AshitakaLax/SmartHome/Website/SmartHome/design.html

Documents Team info Course Website (http://www.eng.utah.edu/~cs4710)

- Home
- Meetings
- Design
- Contact

# Last Updated:

11/7/2012, 5:50pm

# Shortcuts

- Design
- Project Proposal
- Project Presentations
- Project Sections
- Schematics
- Board Layouts
- Bill of Materials

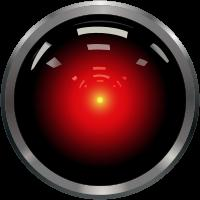
[picture p5: Website/SmartHome/images/Hal.JPG]
Hal Smart Home Name
 Hal the name of the Home computer. To get the Smart Home's attention you say "Hal."

# Design

The Smart Home Project is designed to provide automation to outlets, temperature, sprinklers and garage. As well as monitoring outlet power consumption, temperature, and room occupancy. These controls are to be accessable from a secure website, a secure mobile website, texting, or from voice recognition within the home. The implemenation of these features will provide greater home energy efficency and greater comfort.

Here is a PDF with everything(Schematics, layouts and BOM). Everything

# Project Proposal

Note: The current Project Proposal was created with only a portion of the above features in mind.

- Project Description
- Preliminary Project Proposal
- Final Project Proposal
- Final Project Document

# Project Presentations

- Initial Presentation
- Preliminary Presentation
- Final Project Proposal

# Project Sections

- Wi-Fi & Sprinkler System Design

# Schematics

- Schematics 28-Aug-2012

# Board Layout

- Layouts

# Bill of Materials

- All Boards by Value
- All Boards by Design Reference

Template design by Six Shooter Media (http://www.sixshootermedia.com)
Thank you for provide great resources to others
