AshitakaLax/SmartHome/Website/SmartHome/WifiDesign/Wifidesign.html

Documents Team info Course Website (http://www.eng.utah.edu/~cs4710)

- Home
- Meetings
- Design
- Contact

Wi-Fi Communication Design Details

# Last Updated:

11/04/2012, 10:48pm

# Shortcuts

- Design
- Project Proposal
- Project Presentations
- Schematics
- Board Layouts
- Bill of Materials

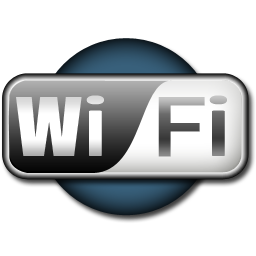
[picture p6: Website/SmartHome/images/wifi.png]
Hal Smart Home Name
 Wi-Fi communication between diferent portions of the project is described in more detail here. Main purpose is to meke possible communication between sensors and outlets/lights possible witout running a wire.

# Design

The Smart Home Project is designed to provide automation to outlets, temperature, sprinklers and garage. As well as monitoring outlet power consumption, temperature, and room occupancy. These controls are to be accessable from a secure website, a secure mobile website, texting, or from voice recognition within the home. The implemenation of these features will provide greater home energy efficency and greater comfort.

Main aspects of controling different automations throughout the house will be done via Wi-Fi. A authorized user will be able to remotely connect to a web page that is hosting all of the information about the house. The user will be able to request some information about specific room and have that information displayed on the webpage. It will also be possible to have a specific command issued to the server which will over Wi-Fi communication send the necessary instructions to controle some part of the house, that being opening the garage doors or turning on the lights. This feature limits the number of wires that have to be run throught the house and enables a centralized unit to store all of this information in one place.

Here is a PDF with everything(Schematics, layouts and BOM) for the Wi-Fi including Automated Sprinkler System. Everything

# Project Proposal

Note: The current Project Proposal was created with only a portion of the above features in mind.

- Project Description
- Preliminary Project Proposal
- Final Project Proposal

# Project Presentations

- Initial Presentation
- Preliminary Presentation
- Final Project Proposal

# Schematics

- Schematics 28-Aug-2012

# Board Layout

- Layouts

# Bill of Materials

- Wi-Fi & Sprikler System

Template design by Six Shooter Media (http://www.sixshootermedia.com)
Thank you for provide great resources to others
