AshitakaLax/SmartHome/EpicCube/hardware/Epic Cube Design/OldControllerBoxInfo/MotorController3.PcbDoc.htm

Altium Reporting Options

# File in Previous Format

Date | : | 5/30/2012
Time | : | 9:07:47 PM
Filename | : | X:\public_html\SmartHome\documents\Controller box\MotorController3.PcbDoc

Version | Warning

This file was generated by an earlier version of the software
