AshitakaLax/SmartHome/EpicCube/hardware/Epic Cube Design/TemplateAndImages/The_University_of_Utah_Th_461a8826e43fc.gif

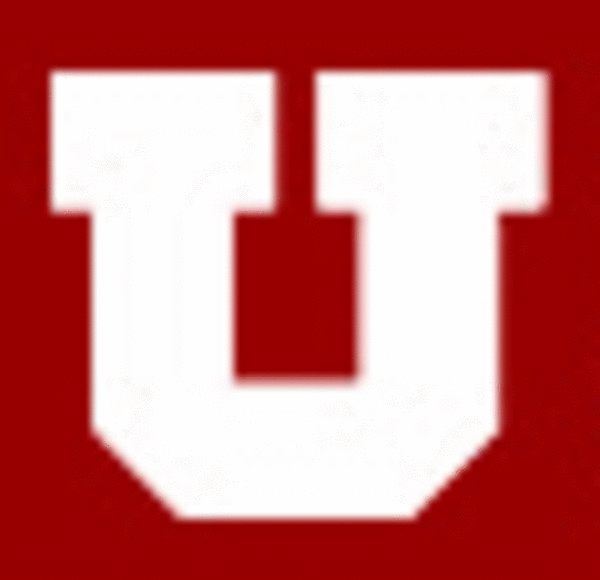
EpicCube/hardware/Epic Cube Design/TemplateAndImages/The_University_of_Utah_Th_461a8826e43fc.gif
