AshitakaLax/SmartHome/Powerstrip/powerstrip.bmp

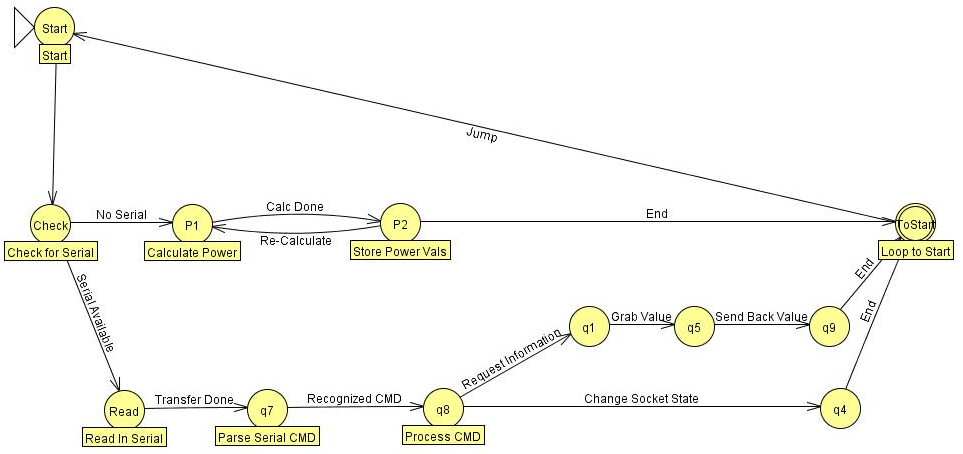
Powerstrip/powerstrip.bmp
