AshitakaLax/SmartHome/Website/SmartHome/images/Hal.png

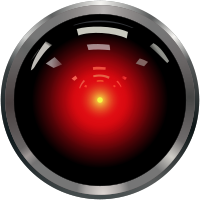
Website/SmartHome/images/Hal.png
