AshitakaLax/SmartHome/Website/SmartHome/images/onlineBio.jpg

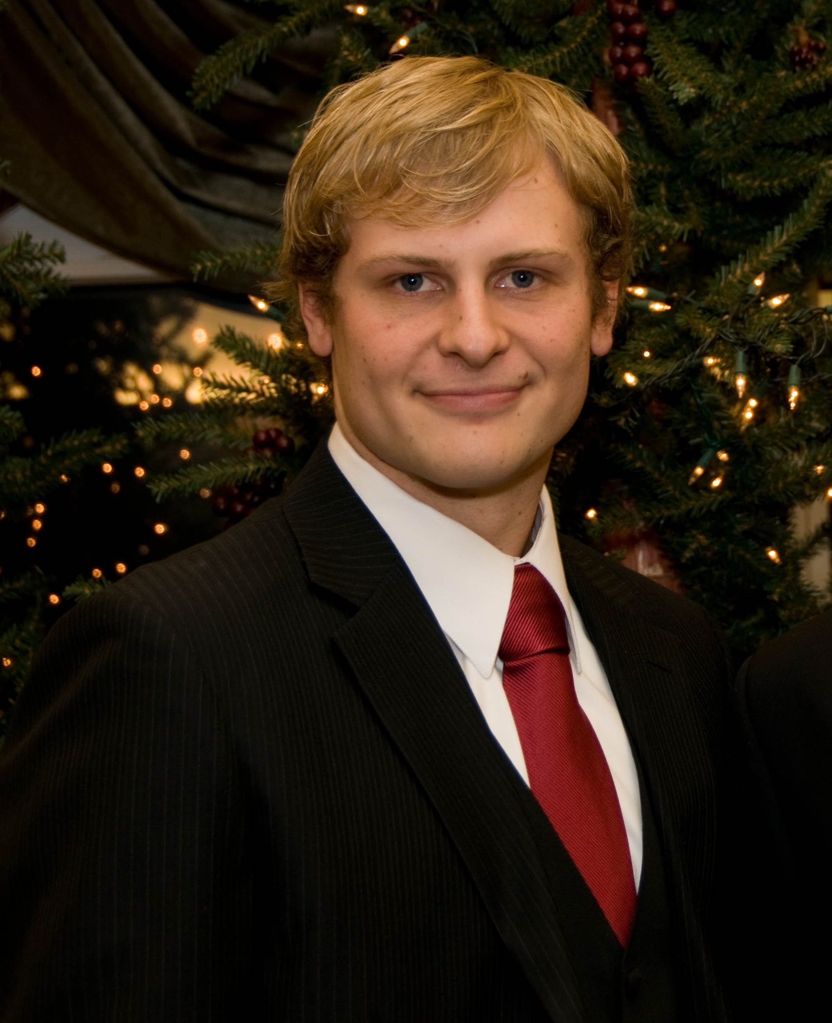
Website/SmartHome/images/onlineBio.jpg
