AshitakaLax/SmartHome/Website/SmartHome/documents/BOM/DesignBOM.PDF

Bill of Materials | Main Controller
Source Data From: | MainController.SchDoc
Project: | | PrintingProjectAllDocs.PrjPCB
Organization: | U of U Computer Engineering
Creation Date: 8/28/2012 | 1:56:56 PM
Print Date: | 28-Aug-12 | 1:57:05 PM
Footprint | Comment | LibRef | Designator | Description | Vendor | Quantity | Price | total Price
| | | C7, C8, C9 | | | 9 | 0.03 | $0.27
| | | D1, D2, D3, D4, D5, D6, D7 | | | 7 | 0.01 | $0.07
| | | | | | 5 | 0.48 | $2.40
| | | | | | 1 | 0.04 | $0.04
| | | P17, P18, P19 | | | 8 | 0.05 | $0.40
| | | | | | 3 | 0.02 | $0.06
| | | | | | 1 | 0.06 | $0.06
| | | | | | 1 | 0.07 | $0.07
| | | | | | 1 | 0.00 | $0.00
| | | | | | 1 | 0.06 | $0.06
| | | | | | 1 | 0.03 | $0.03
| | | | | | 2 | 0.09 | $0.18
| | | | | | 5 | 0.01 | $0.05
| | | | | | 5 | 0.01 | $0.05
| | | | | | 3 | 0.18 | $0.54
RAD-0.3 | Cap | Cap | C1, C2, C3, C4, C5, C6, | Capacitor | Taydaelectr
| | | | | onics
DO-41 | 1N4001 | 1N4001, Diode
| | 1N4001 | | 1.0 Ampere General Purpose
| | | | Rectifier, 1 Amp General
| | | | Purpose Rectifier | Taydaelectr
| | | | | onics
DSUB1.385- 2H9 | D Connector 9 | D Connector 9 | J1, J2, J3, J4, J5 | Receptacle Assembly, 9
| | | | Position, Right Angle | Taydaelectr
| | | | | onics
MainPowerC onnector | Header 4 | Header 4 | P1 | Header, 4-Pin | Taydaelectr
| | | | | onics
HDR1X5 | Header 5 | Header 5 | P2, P5, P8, P14, P16, | Header, 5-Pin | Taydaelectr
| | | | | onics
HDR1X2 | Header 2 | Header 2 | P3, P9, P12 | Header, 2-Pin | Taydaelectr
| | | | | onics
HDR1X6 | Header 6 | Header 6 | P4 | Header, 6-Pin | Taydaelectr
| | | | | onics
HDR1X7 | Header 7 | Header 7 | P6 | Header, 7-Pin | Taydaelectr
| | | | | onics
PIN1 | Spare | Plug | P7 | Plug | Taydaelectr
| | | | | onics
HDR1X6 | Garage_HVAC | Header 6 | P10 | Header, 6-Pin | Taydaelectr
| | | | | onics
HDR1X3 | Header 3 | Header 3 | P11 | Header, 3-Pin | Taydaelectr
| | | | | onics
HDR1X9 | TempSenseBoar
| d1 | Header 9 | P13, P15 | Header, 9-Pin | Taydaelectr
| | | | | onics
2N3904 | 2N3904 | 2N3904 | Q1, Q2, Q3, Q4, Q5 | NPN General Purpose
| | | | Amplifier | Taydaelectr
| | | | | onics
AXIAL-0.3 | Res1 | Res1 | R1, R2, R3, R4, R5 | Resistor | Taydaelectr
| | | | | onics
N014 | SN7416N | SN7416N | U1, U2, U5 | Hex Inverter Buffer / Driver
| | | | with High-Voltage Outputs | Taydaelectr
| | | | | onics
NT024D | SN74HC154NT | SN74HC154NT | U3 | 4-Line to 16-Line Decoder /
| | | | Demultiplexer
Digi-Key | 1 | 3.70 | $3.70
Teensy2.0++ | Teensy2.0++ | Teensy2.0++ | U4 | The teensy 2.0 from
| | | | www.PJRC.com | Taydaelectr
| | | | | onics
1 | 24.0 | $24.00
1 | 0.24 | $0.24
1 | 0.24 | $0.24
Approved Notes | 57 | | $32.46

ISOWATT220
AB
L7812CP | L7805CP | VR1 | Positive Voltage Regulator | Taydaelectr onics

ISOWATT220
AB
L7805CP | L7805CP | VR2 | Positive Voltage Regulator | Taydaelectr onics

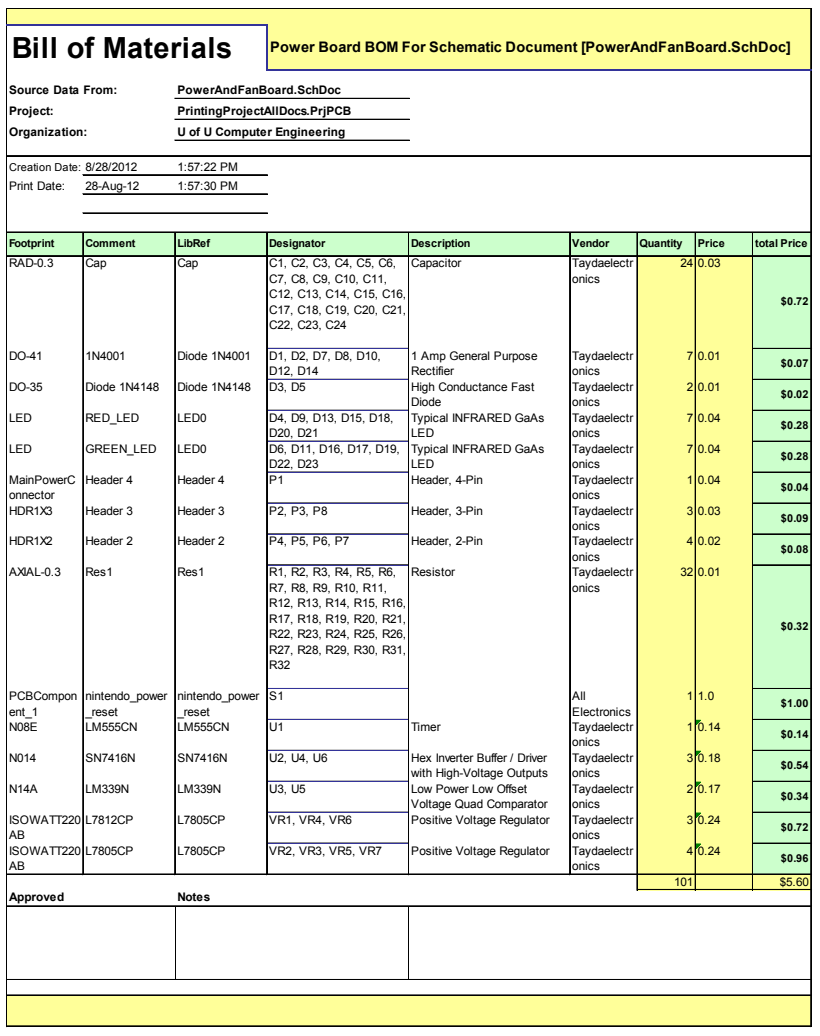
[picture p93: page 2]

Footprint | Comment | LibRef | Designator | Description | Vendor | Quantity | Price | total Price

with High-Voltage Outputs

Approved Notes | | | | | | 101 | | $5.60

Bill of Materials | HVAC & Garage Control
Source Data From: | HeatingAC_Garage.SchDoc
Project: | | PrintingProjectAllDocs.PrjPCB
Organization: | U of U Computer Engineering
Creation Date: 8/28/2012 | 1:57:51 PM
Print Date: | 28-Aug-12 | 1:58:01 PM
Footprint | Comment | LibRef | Designator | Description | Vendor | Quantity | Price | total Price
| | | | | | 2 | 0.03 | $0.06
| | | | | | 4 | 0.04 | $0.16
| | | D11 | | | 7 | 0.01 | $0.07
| | | | | | 1 | 0.48 | $0.48
| | | K7 | | | 7 | 0.64 | $4.48
| | | | | | 1 | 0.02 | $0.02
| | | | | | 1 | 0.03 | $0.03
| | | | | | 1 | 0.07 | $0.07
| | | Q7 | | | 7 | 0.01 | $0.07
| | | R7, R8, R9, R10, R11, R12, R13, R14, R15, R16, R17, R18, R19, R20, R21, R22, R23 | | | 23 | 0.01 | $0.23
| | | | | | 3 | 0.3 | $0.90
| | | | | | 1 | 0.18 | $0.18
Approved Notes | | | | | | 58 | | $6.75
RAD-0.3 | Cap | Cap | C1, C2 | Capacitor | Taydaelectr
| | | | | onics
LED-0 | LED_White | LED0 | D1, D2, D3, D4 | Typical INFRARED GaAs
| | | | LED | Taydaelectr
| | | | | onics
DO-41 | 1N4001 | 1N4001 | D5, D6, D7, D8, D9, D10, | 1.0 Ampere General Purpose
| | | | Rectifier | Taydaelectr
| | | | | onics
DSUB1.385- 2H9 | D Connector 9 | D Connector 9 | J1 | Receptacle Assembly, 9
| | | | Position, Right Angle | Taydaelectr
| | | | | onics
Relay SPDT | SPDT | SPDT | K1, K2, K3, K4, K5, K6, | | Taydaelectr
| | | | | onics
HDR1X2 | Header 2 | Header 2 | P1 | Header, 2-Pin | Taydaelectr
| | | | | onics
HDR1X3 | Header 3 | Header 3 | P2 | Header, 3-Pin | Taydaelectr
| | | | | onics
HDR1X7 | Header 7 | Header 7 | P3 | Header, 7-Pin | Taydaelectr
| | | | | onics
2N3904 | 2N3904 | 2N3904 | Q1, Q2, Q3, Q4, Q5, Q6, | NPN General Purpose
| | | | Amplifier | Taydaelectr
| | | | | onics
AXIAL-0.3 | Res1 | Res1 | R1, R2, R3, R4, R5, R6, | Resistor | Taydaelectr
| | | | | onics
DIP4 | OptoCoupler | OptoCoupler | U1, U3, U4 | Taydaelectr
| | | | onics
N014 | SN7416N | SN7416N | U2 | Hex Inverter Buffer / Driver
| | | | with High-Voltage Outputs Taydaelectr
| | | | onics

Bill of Materials | Bi-Polar Motor driver BOM For Schematic Document [MotorController.SchDoc]
Source Data From: | MotorController.SchDoc
Project: | | PrintingProjectAllDocs.PrjPCB
Organization: | U of U Computer Engineering
Creation Date: 8/28/2012 | 1:58:31 PM
Print Date: | 28-Aug-12 | 1:58:42 PM
Footprint | Comment | LibRef | Designator | Description | Vendor | Quantity | Price | total Price
| | | | | | 2 | 0.03 | $0.06
| | | D7, D8 | | | 8 | 0.03 | $0.24
| | | | | | 1 | 0.04 | $0.04
| | | | | | 1 | 0.01 | $0.01
| | | | | | 1 | 0.06 | $0.06
| | | | | | 1 | 0.04 | $0.04
| | | Q7, Q8, Q9, Q10 | | | 10 | 0.01 | $0.10
| | | R7, R8, R9, R10, R11, R12, R13, R14, R15, R16, R17, R18, R19, R20, R21, R22 | | | 22 | 0.01 | $0.22
| | | | | | 4 | 0.35 | $1.40
| | | | | | 4 | 0.26 | $1.04
| | | | | | 1 | 0.14 | $0.14
RAD-0.3 | Cap | Cap | C1, C2 | Capacitor | Taydaelectr
| | | | | onics
DO-201AD | Diode 1N5408 | Diode 1N5408 | D1, D2, D3, D4, D5, D6, | 3 Amp Medium Power Silicon
| | | | Rectifier Diode | Taydaelectr
| | | | | onics
LED-0 | LED0 | LED0 | D9 | Typical INFRARED GaAs
| | | | LED | Taydaelectr
| | | | | onics
DO-35 | Diode 1N4148 | Diode 1N4148 | D10 | High Conductance Fast
| | | | Diode | Taydaelectr
| | | | | onics
HDR1X6 | Header 6 | Header 6 | P1 | Header, 6-Pin | Taydaelectr
| | | | | onics
HDR1X4 | Header 4 | Header 4 | P2 | Header, 4-Pin | Taydaelectr
| | | | | onics
2N3904 | 2N3904 | 2N3904 | Q1, Q2, Q3, Q4, Q5, Q6, | NPN General Purpose
| | | | Amplifier | Taydaelectr
| | | | | onics
AXIAL-0.3 | Res1 | Res1 | R1, R2, R3, R4, R5, R6, | Resistor | Taydaelectr
| | | | | onics
TO-220 | TIP126 | TIP126 | U1, U2, U3, U4 | TIP126 -PNP | Taydaelectr
| | | | | onics
TO-220 | TIP120 | TIP120 | U5, U6, U7, U8 | NPN 60V -5A TO-220 | Taydaelectr
| | | | | onics
N08E | LM555CN | LM555CN | U9 | Timer | Taydaelectr
| | | | | onics
648-06 | MC74HC194N | MC74HC194N | U10 | 4-Bit Bidirectional Universal
| | | | Shift Register | Digi-Key | 1 | 0.68 | $0.68
NE016 | SN754410NE | SN754410NE | U11 | Quadruple Half-H Driver | U of U | 1 | 0.00 | $0.00
| | | | | | 57 | | $4.03
Approved | | Notes

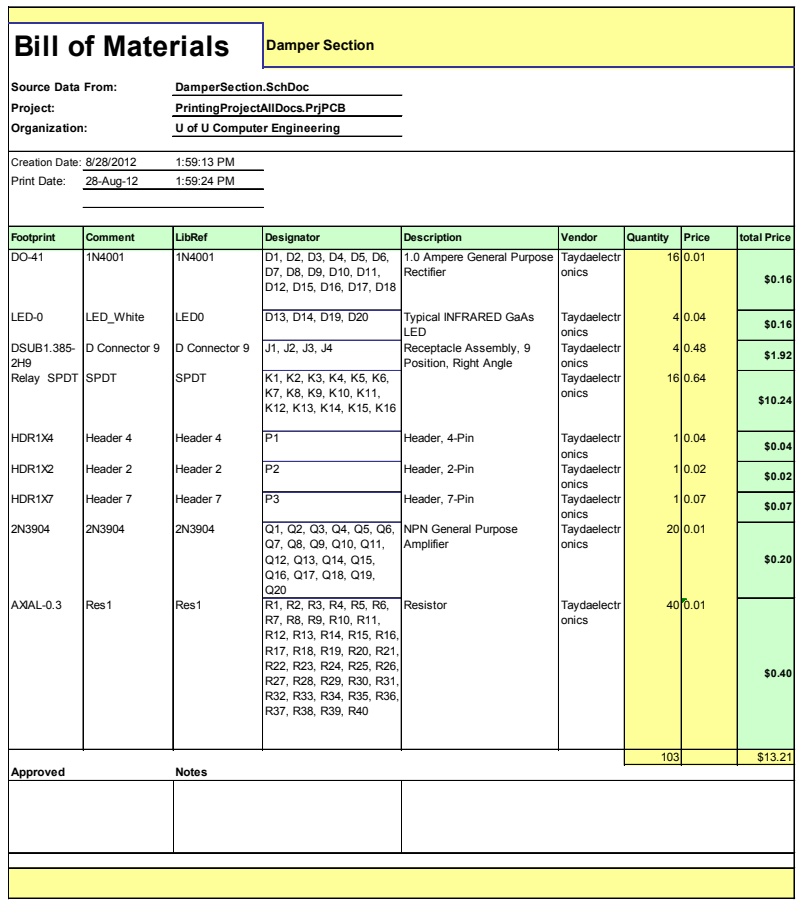
[picture p94: page 5]

Footprint | Comment | LibRef | Designator | Description | Vendor | Quantity | Price | total Price

Approved Notes | | | | | | 103 | | $13.21

Bill of Materials | Sprinkler Control BOM For Schematic Document [SprinklerBoard.SchDoc]
Source Data From: | SprinklerBoard.SchDoc
Project: | | PrintingProjectAllDocs.PrjPCB
Organization: | U of U Computer Engineering
Creation Date: 8/28/2012 | 2:00:07 PM
Print Date: | 28-Aug-12 | 2:00:17 PM
Footprint | Comment | LibRef | Designator | Description | Vendor | Quantity | Price | total Price
| | | | | | 6 | 0.01 | $0.06
| | | D12 | | | 6 | 0.04 | $0.24
| | | | | | 1 | 0.48 | $0.48
| | | | | | 6 | 0.64 | $3.84
| | | | | | 1 | 0.07 | $0.07
| | | | | | 6 | 0.01 | $0.06
| | | R7, R8, R9, R10, R11, R12, R13, R14 | | | 14 | 0.01 | $0.14
| | | | | | 1 | 0.18 | $0.18
| | | | | | 1 | 0.25 | $0.25
Approved Notes | | | | | | 42 | | $5.32
DO-41 | 1N4001 | 1N4001 | D1, D2, D3, D4, D5, D6 | 1.0 Ampere General Purpose
| | | | Rectifier | Taydaelectr
| | | | | onics
LED-0 | LED_White | LED0 | D7, D8, D9, D10, D11, | Typical INFRARED GaAs
| | | | LED | Taydaelectr
| | | | | onics
DSUB1.385- 2H9 | D Connector 9 | D Connector 9 | J1 | Receptacle Assembly, 9
| | | | Position, Right Angle | Taydaelectr
| | | | | onics
Relay SPDT | SPDT | SPDT | K1, K2, K3, K4, K5, K6 | | Taydaelectr
| | | | | onics
HDR1X7 | Header 7 | Header 7 | P1 | Header, 7-Pin | Taydaelectr
| | | | | onics
2N3904 | 2N3904 | 2N3904 | Q1, Q2, Q3, Q4, Q5, Q6 | NPN General Purpose
| | | | Amplifier | Taydaelectr
| | | | | onics
AXIAL-0.3 | Res1 | Res1 | R1, R2, R3, R4, R5, R6, | Resistor | Taydaelectr
| | | | | onics
N014 | SN7416N | SN7416N | U1 | Hex Inverter Buffer / Driver
| | | | with High-Voltage Outputs | Taydaelectr
| | | | | onics
DIP16 | 74AC138B | 74AC138B | U2 | 3-to-8 Line Decoder Inverting | Taydaelectr
| | | | | onics

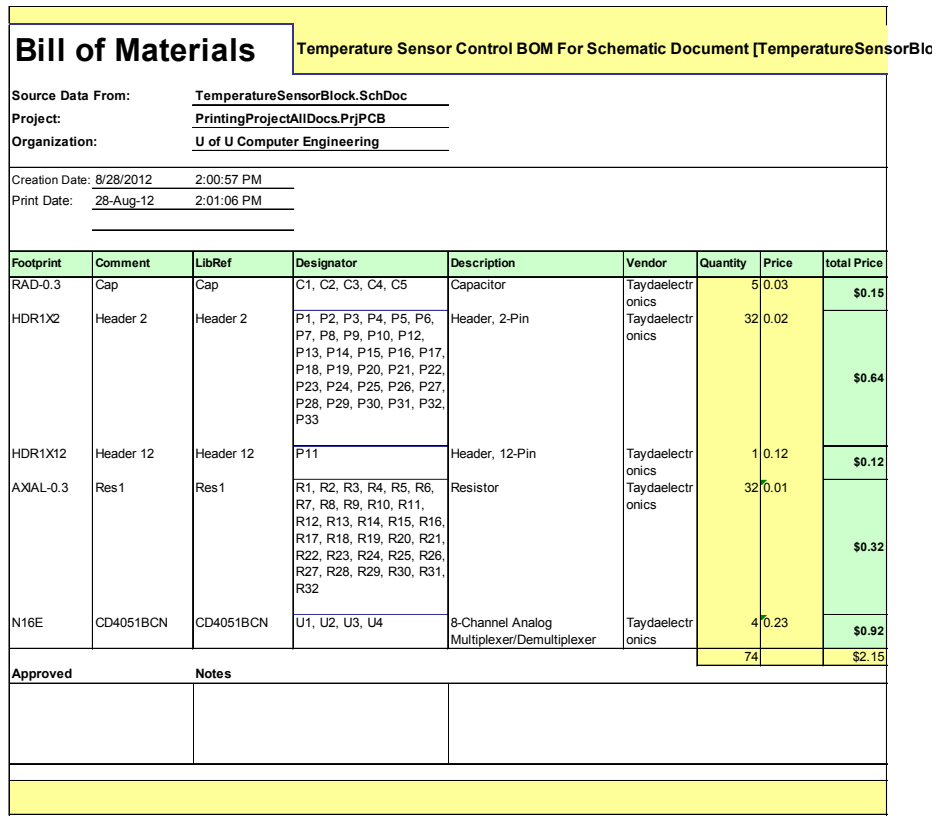
[picture p95: page 7]

Footprint | Comment | LibRef | Designator | Description | Vendor | Quantity | Price | total Price

Approved Notes | | | | | | 74 | | $2.15

Bill of Materials | Wireless Communication Controller BOM For Schematic Document [WirelessCommunications.SchDoc]
Source Data From: | WirelessCommunications.SchDoc
Project: | | PrintingProjectAllDocs.PrjPCB
Organization: | U of U Computer Engineering
Creation Date: 8/28/2012 | 2:01:47 PM
Print Date: | 28-Aug-12 | 2:02:00 PM
Footprint | Comment | LibRef | Designator | Description | Vendor | Quantity | Price | total Price
| | | | | | 2 | 0.03 | $0.06
| | | | | | 1 | 0.05 | $0.05
| | | | | | 4 | 0.02 | $0.08
| | | | | | 3 | 0.10 | $0.30
| | | | | | 1 | 0.07 | $0.07
| | | | | | 1 | 0.01 | $0.01
RAD-0.3 | Cap | Cap | C1, C2 | Capacitor | Taydaelectr
| | | | | onics
HDR1X5 | Header 5 | Header 5 | P1 | Header, 5-Pin | Taydaelectr
| | | | | onics
HDR1X2 | Header 2 | Header 2 | P2, P7, P8, P9 | Header, 2-Pin | Taydaelectr
| | | | | onics
HDR1X10 | Header 10 | Header 10 | P3, P4, P5 | Header, 10-Pin | Taydaelectr
| | | | | onics
HDR1X7 | Header 7 | Header 7 | P6 | Header, 7-Pin | Taydaelectr
| | | | | onics
AXIAL-0.3 | Res1 | Res1 | R1 | Resistor | Taydaelectr
| | | | | onics
RFM12- transceiver | RFM12
| transceiver | RFM12
| | transceiver | T1 | www.futurlec.com 433 MHZ
| | | | transceiver
futurlec | 1 | 7.90 | $7.90
Teensy2.0 | Teensy | Teensy2.0 | U1 | The teensy 2.0 from
| | | | www.PJRC.com, chang clock
| | | | to 8MHz
PJRC | 1 | 16.00
| | $16.00
Approved Notes | 14 | | $24.47

Bill of Materials | Microphone Mixer
Source Data From: | MicMixer.SchDoc
Project: | | PrintingProjectAllDocs.PrjPCB
Organization: | U of U Computer Engineering
Creation Date: 8/28/2012 | 2:02:45 PM
Print Date: | 28-Aug-12 | 2:02:58 PM
Footprint | Comment | LibRef | Designator | Description | Vendor | Quantity | Price | total Price
| | | C7, C8, C9, C10 | | | 10 | 0.03 | $0.30
| | | MK5, MK6, MK7, MK8, MK9, MK10, MK11, MK12, MK13, MK14, MK15, MK16 | | | 16 | 0.25 | $4.00
| | | | | | 1 | 0.09 | $0.09
| | | P8, P9 | | | 8 | 0.02 | $0.16
| | | | | | 2 | 0.03 | $0.06
| | | | | | 2 | 0.01 | $0.02
| | | | | | 2 | 0.01 | $0.02
| | | R7, R8, R9, R10, R11, R12, R13, R14 | | | 14 | 0.01 | $0.14
| | | | | | 4 | 0.23 | $0.92
Approved Notes | | | | | | 59 | | $5.71
RAD-0.3 | Cap | Cap | C1, C2, C3, C4, C5, C6,
Capacitor | Taydaelectr
onics
PIN2 | Mic1 | Mic1 | MK1, MK2, MK3, MK4,
Microphone | Taydaelectr
onics
HDR1X9 | Header 9 | Header 9 | P1 | Header, 9-Pin | Taydaelectr
| | | | | onics
HDR1X2 | Header 2 | Header 2 | P2, P3, P4, P5, P6, P7, | Header, 2-Pin | Taydaelectr
| | | | | onics
HDR1X3 | Header 3 | Header 3 | P10, P11 | Header, 3-Pin | Taydaelectr
| | | | | onics
2N3904 | BC548B | 2N3904 | Q1, Q2 | NPN General Purpose
| | | | Amplifier | Taydaelectr
| | | | | onics
2N3904 | 2N3904 | 2N3904 | Q3, Q4 | NPN General Purpose
| | | | Amplifier | Taydaelectr
| | | | | onics
AXIAL-0.3 | Res1 | Res1 | R1, R2, R3, R4, R5, R6, | Resistor | Taydaelectr
| | | | | onics
N16E | CD4051BCN | CD4051BCN | U1, U2, U3, U4 | 8-Channel Analog
| | | | Multiplexer/Demultiplexer | Taydaelectr
| | | | | onics

Bill of Materials | Speaker Mixer
Source Data From: | SpeakerMixer.SchDoc
Project: | | PrintingProjectAllDocs.PrjPCB
Organization: | U of U Computer Engineering
Creation Date: 8/28/2012 | 2:03:49 PM
Print Date: | 28-Aug-12 | 2:04:01 PM
Footprint | Comment | LibRef | Designator | Description | Vendor | Quantity | Price | total Price
LED-0 HDR1X8 HDR1X3 2N3904 AXIAL-0.3 N16E | LED_White Header 8 Header 3 2N3904 Res1 CD4051BCN | LED0 Header 8 Header 3 2N3904 Res1 CD4051BCN | D1, D2, D3, D4 | Typical INFRARED GaAs LED Header, 8-Pin Header, 3-Pin NPN General Purpose Amplifier Resistor 8-Channel Analog Multiplexer/Demultiplexer | Taydaelectr onics Taydaelectr onics Taydaelectr onics Taydaelectr onics Taydaelectr onics Taydaelectr onics | 4 | 0.04 | $0.16
| | | P1 | | | 1 | 0.08 | $0.08
| | | P2, P3, P4, P5, P6, P7, P8, P9, P10 | | | 9 | 0.03 | $0.27
| | | Q1, Q2, Q3, Q4 | | | 4 | 0.01 | $0.04
| | | R1, R2, R3, R4, R5, R6, R7, R8 | | | 8 | 0.01 | $0.08
| | | U1, U2 | | | 2 | 0.23 | $0.46
Approved Notes | | | | | | 28 | | $1.09
