AshitakaLax/SmartHome/docs/poster.pdf

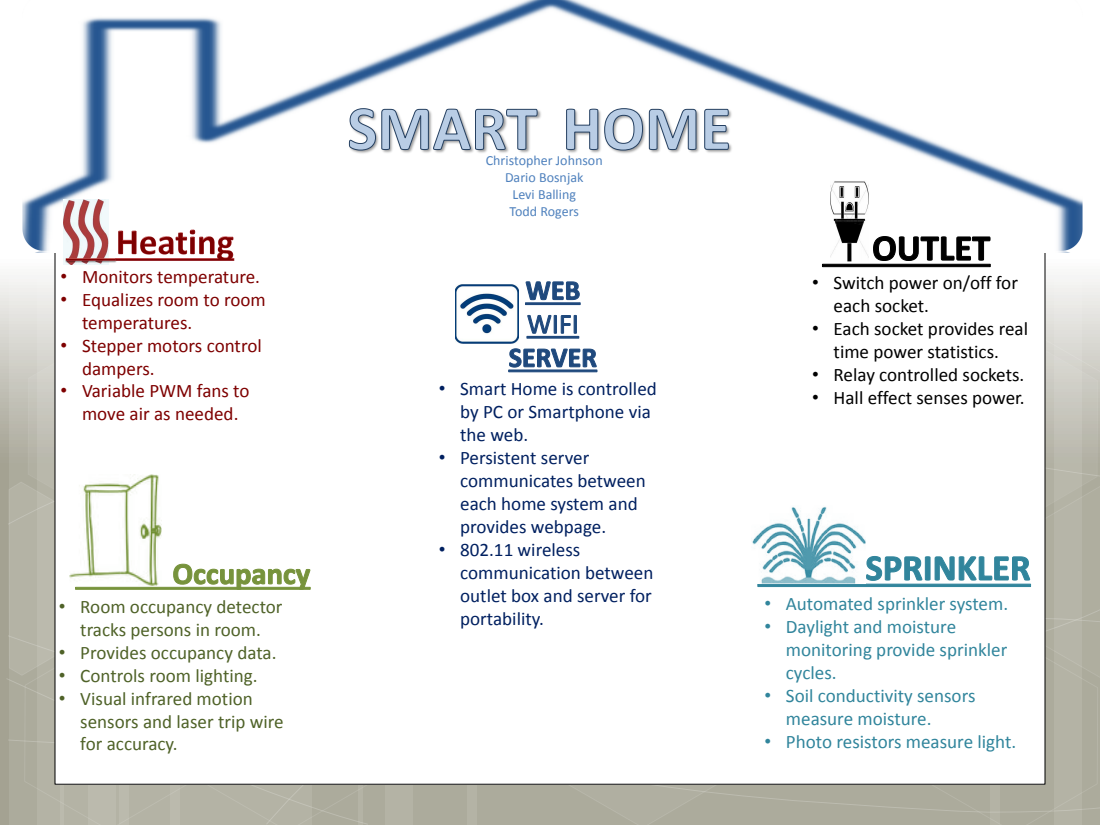
[picture p103: page 1]
Christopher Johnson Dario Bosnjak Levi Balling Todd Rogers

• Monitors temperature. • Equalizes room to room

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

temperatures.
• Stepper motors control
dampers.
• Variable PWM fans to
move air as needed.

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

• Automated sprinkler system. • Daylight and moisture

• Room occupancy detector
tracks persons in room.
• Provides occupancy data. • Controls room lighting. • Visual infrared motion

monitoring provide sprinkler
cycles.
• Soil conductivity sensors
measure moisture.
• Photo resistors measure light.

sensors and laser trip wire
for accuracy.
