AshitakaLax/SmartHome/EpicCube/hardware/Epic Cube Design/Workspace/Printouts/EpicCubeDiagram.pdf

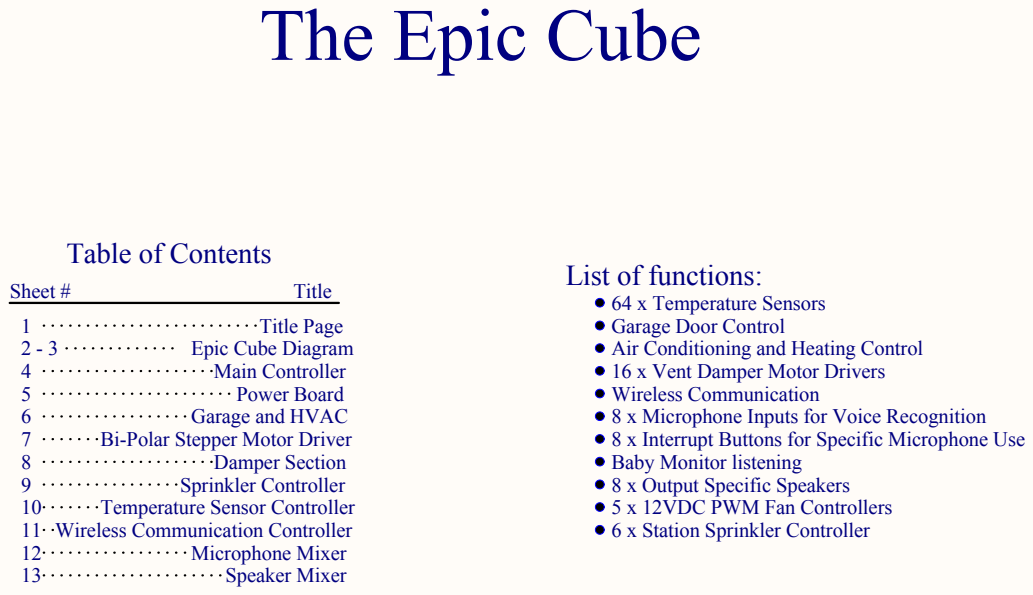
[picture p105: page 1]

List of functions: 64 x Temperature Sensors

Garage Door Control
Air Conditioning and Heating Control
16 x Vent Damper Motor Drivers
Wireless Communication
8 x Microphone Inputs for Voice Recognition
8 x Interrupt Buttons for Specific Microphone Use
Baby Monitor listening
8 x Output Specific Speakers
5 x 12VDC PWM Fan Controllers

Bi-Polar Stepper Motor Driver

U of U Computer Engineering
50 S. Central Campus Dr.
Rm. 3280 MEB
Salt Lake City, UT

Time: 10:41:53 AM | File: TheEpicCube.SchDoc
Sheet of | Website: www.eng.utah.edu/~lballing/SmartHome

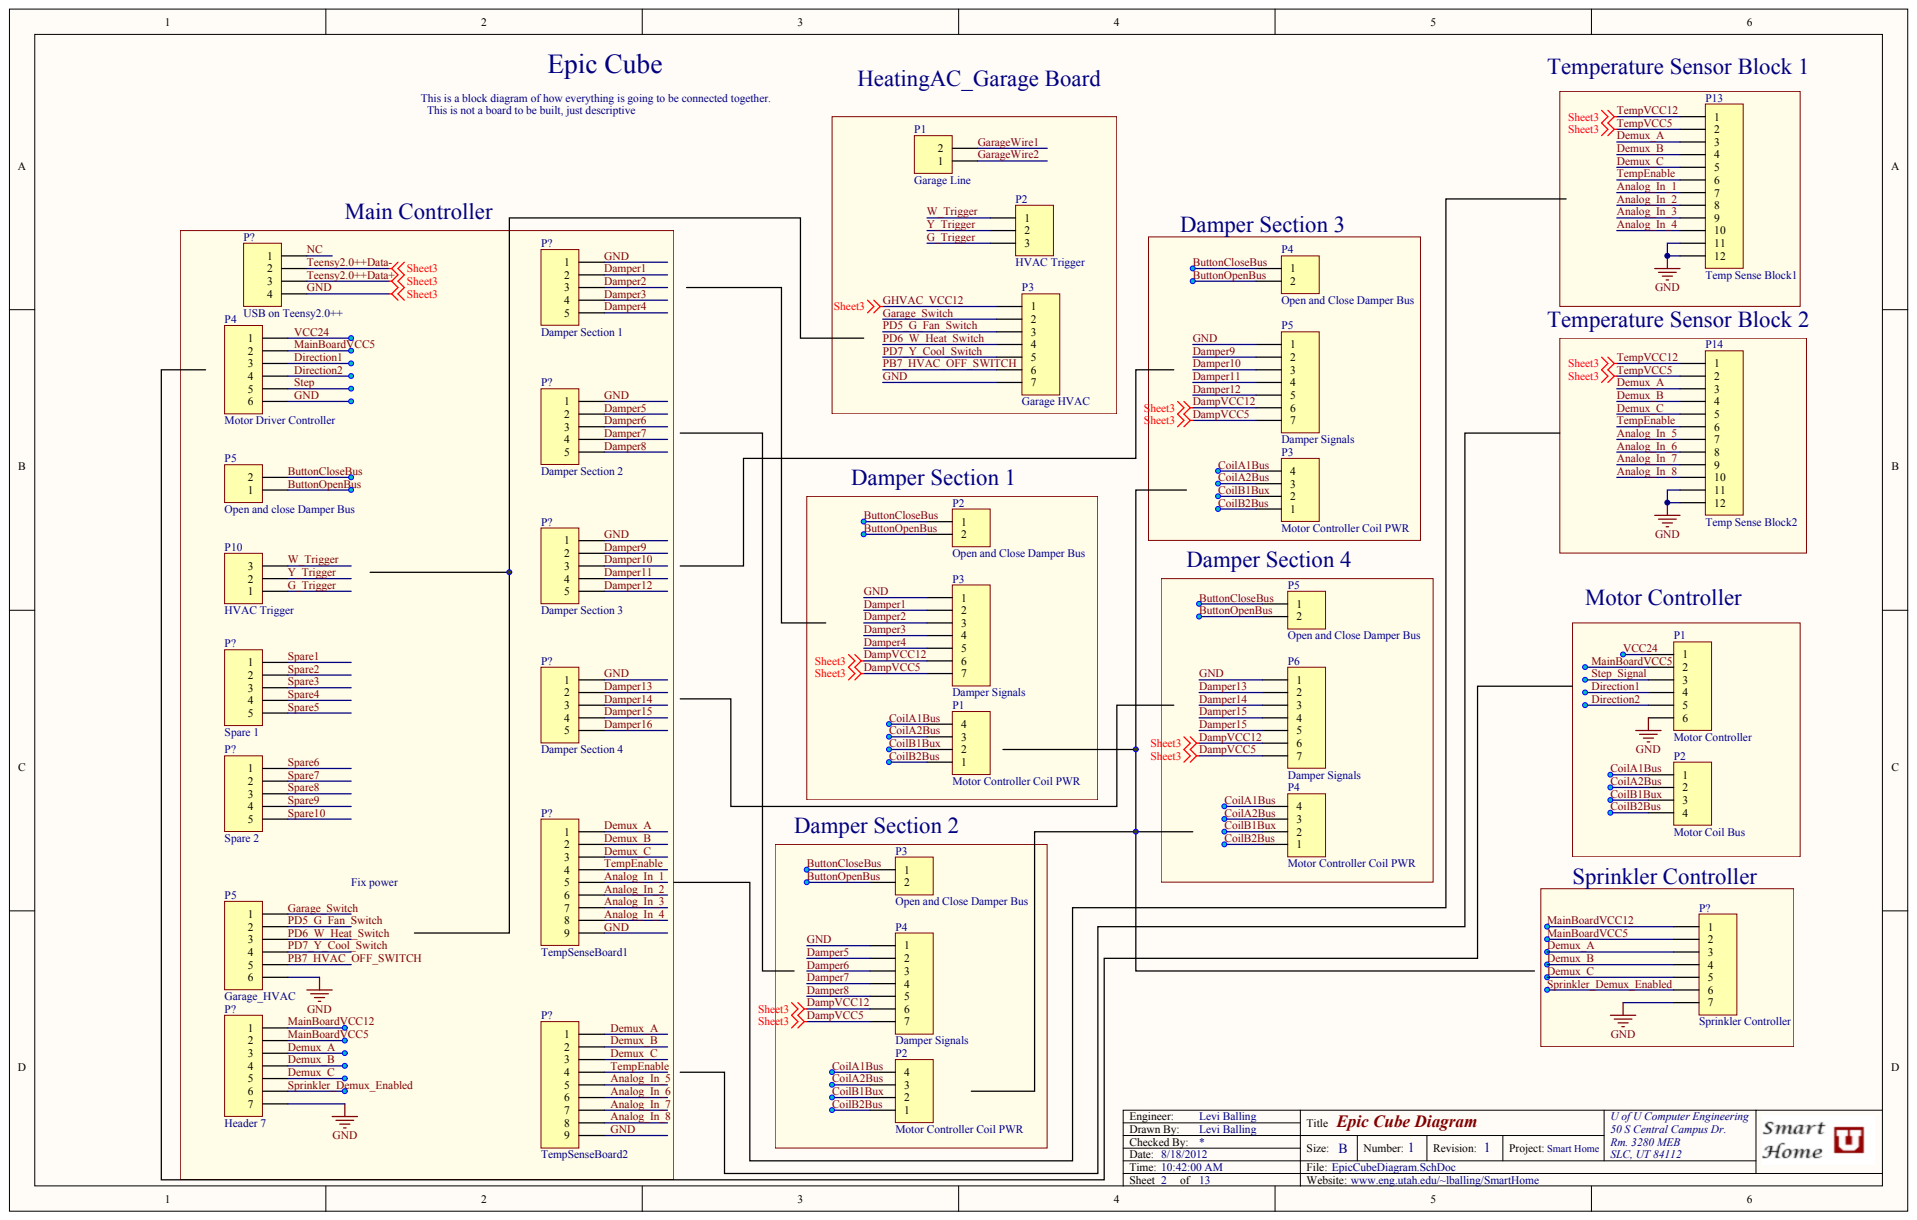
[picture p106: page 2]

This is a block diagram of how everything is going to be connected together.
This is not a board to be built, just descriptive
Damper Section 2 12345

Open and Close Damper Bus

Motor Controller Coil PWR 1234567

Open and close Damper Bus 123

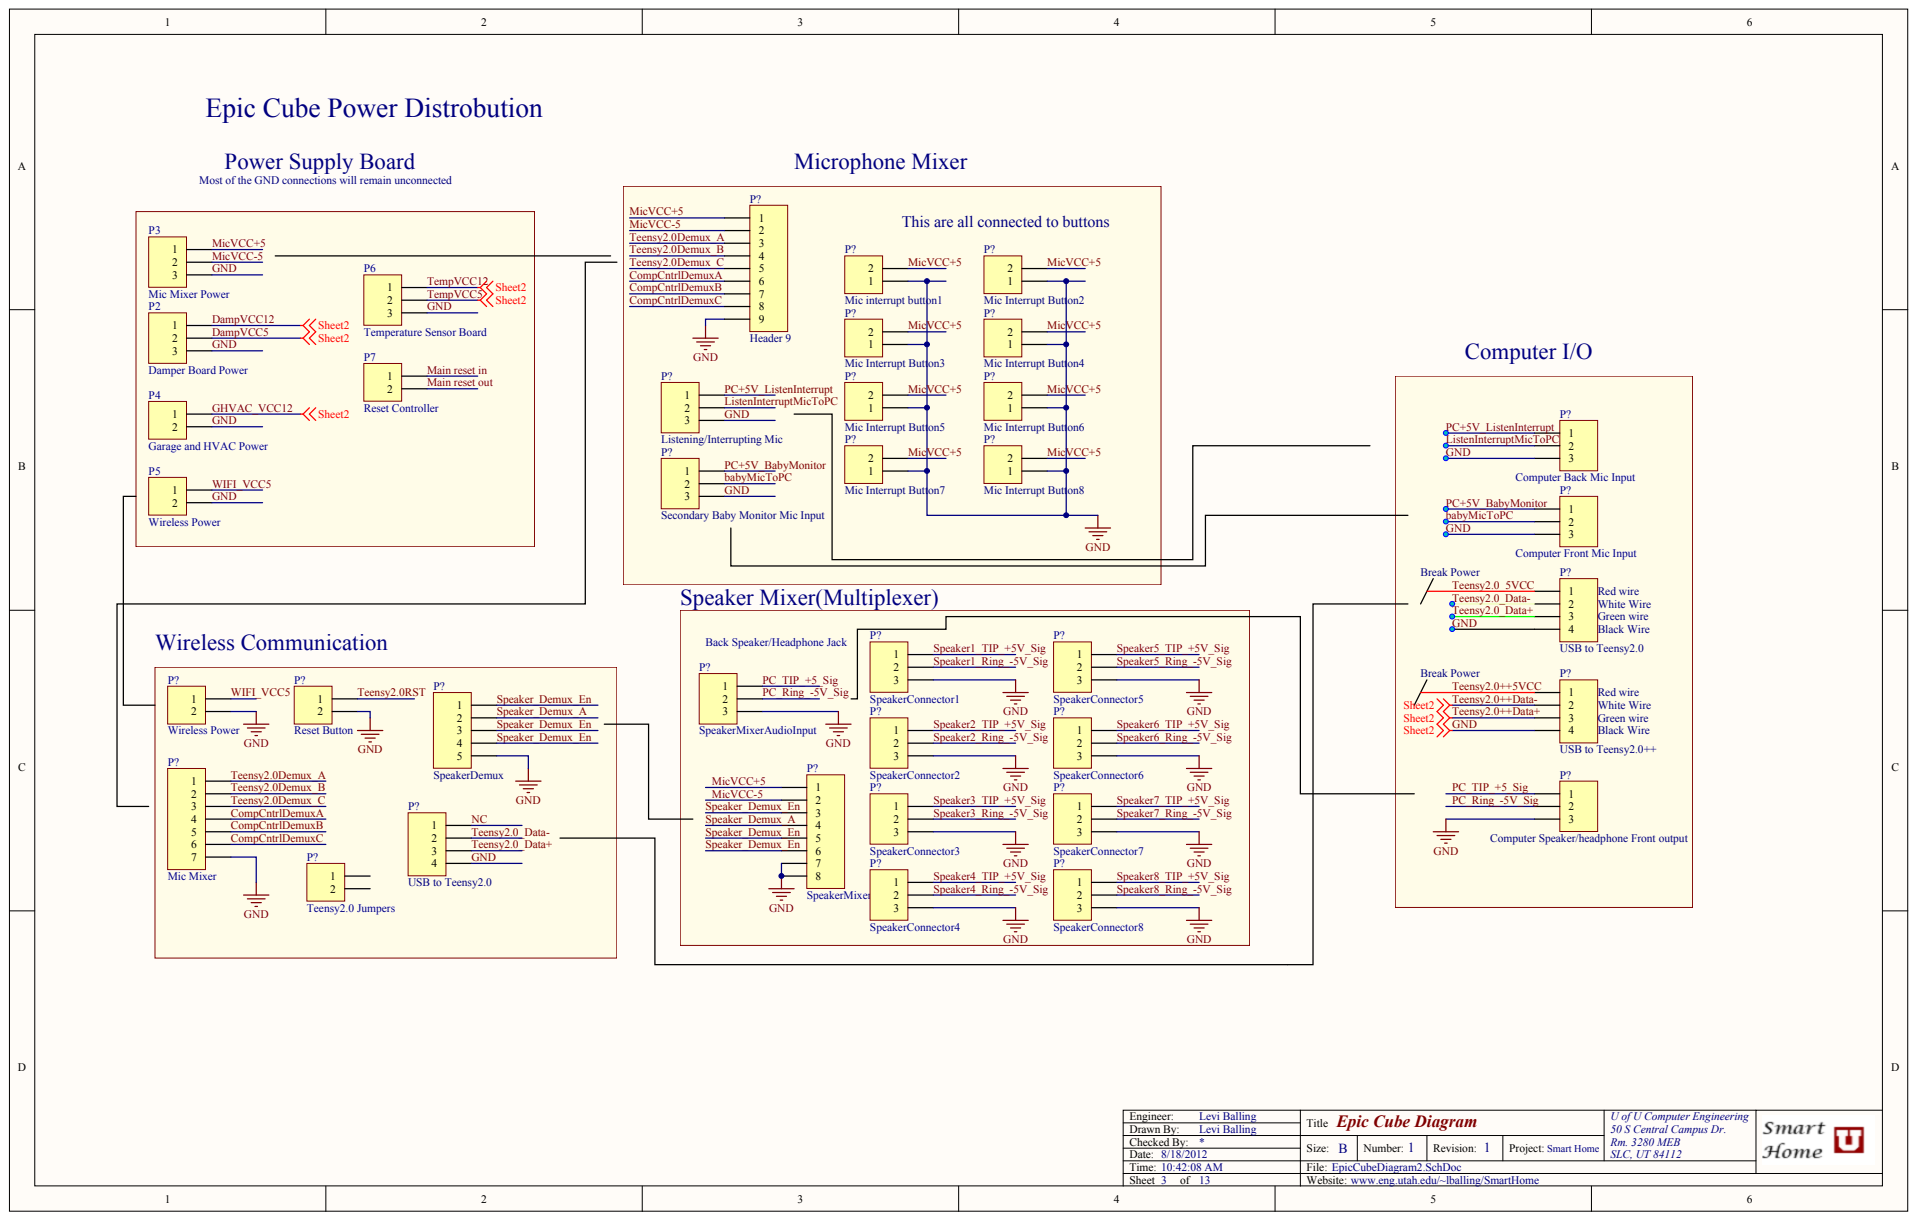
[picture p107: page 3]

Epic Cube Power Distrobution

Power Supply Board Most of the GND connections will remain unconnected

This are all connected to buttons

Computer Front Mic Input 123

Garage and HVAC Power 12

Computer Back Mic Input

Secondary Baby Monitor Mic Input

Back Speaker/Headphone Jack

Computer Speaker/headphone Front output
