AshitakaLax/SmartHome/EpicCube/hardware/Epic Cube Design/Workspace/Printouts/SpeakerMixer.pdf

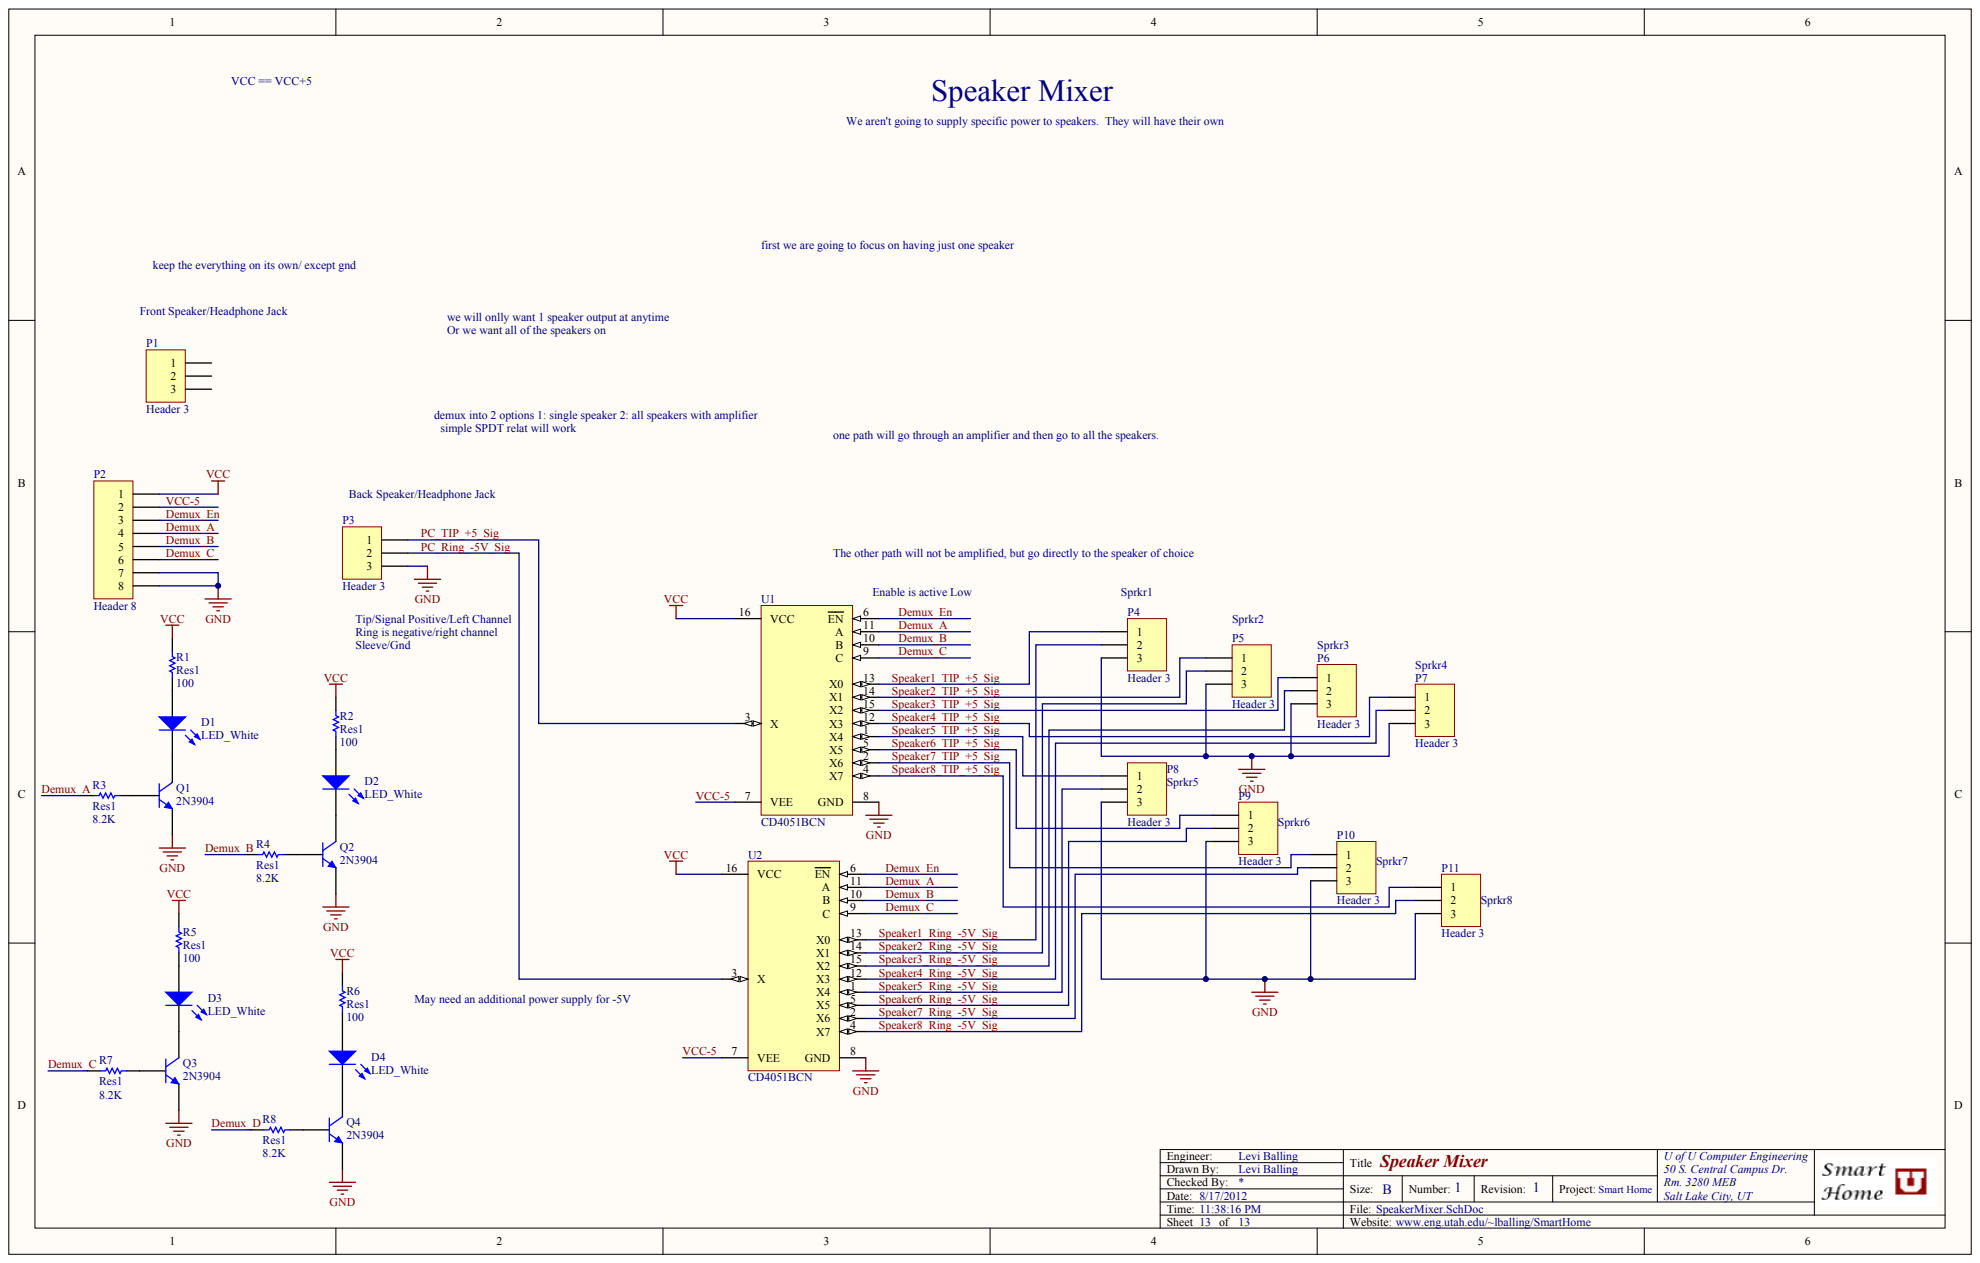
[picture p112: page 1]

We aren't going to supply specific power to speakers. They will have their own

first we are going to focus on having just one speaker

keep the everything on its own/ except gnd

Front Speaker/Headphone Jack

we will onlly want 1 speaker output at anytime
Or we want all of the speakers on

demux into 2 options 1: single speaker 2: all speakers with amplifier

Back Speaker/Headphone Jack

The other path will not be amplified, but go directly to the speaker of choice

Enable is active Low

Tip/Signal Positive/Left Channel
Ring is negative/right channel
Sleeve/Gnd

Speaker1_TIP_+5_Sig | Header 3

Speaker3_TIP_+5_Sig | | Header 3
Speaker4_TIP_+5_Sig | | | Header 3

VCC | U2 | | 1 Speaker5_TIP_+5_Sig

5 | Speaker6_TIP_+5_Sig
2 | Speaker7_TIP_+5_Sig

8 Speaker1_Ring_-5V_Sig

123 | Sprkr6 P10

Speaker3_Ring_-5V_Sig
Speaker4_Ring_-5V_Sig

May need an additional power supply for -5V

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

Time: 11:38:16 PM | File: SpeakerMixer.SchDoc
Sheet 13 of 13 | Website: www.eng.utah.edu/~lballing/SmartHome

Bill of Materials | Speaker Mixer
Source Data From: | SpeakerMixer.PrjPCB
Project: | | SpeakerMixer.PrjPCB
Variant: | | None
Creation Date: 8/17/2012 | 11:38:20 PM
Print Date: | 17-Aug-12 | 11:38:22 PM
Footprint | Comment | LibRef | Designator | Description | Quantity
LED-0 HDR1X3 HDR1X8 2N3904 AXIAL-0.3 N16E | LED_White Header 3 Header 8 2N3904 Res1 CD4051BCN | LED0 Header 3 Header 8 2N3904 Res1 CD4051BCN | D1, D2, D3, D4 | Typical INFRARED GaAs LED Header, 3-Pin Header, 8-Pin NPN General Purpose Amplifier Resistor 8-Channel Analog Multiplexer/Demultiplexer | 4
| | | P1, P3, P4, P5, P6, P7, P8, P9, P10, P11 | | 10
| | | P2 | | 1
| | | Q1, Q2, Q3, Q4 | | 4
| | | R1, R2, R3, R4, R5, R6, R7, R8 | | 8
| | | U1, U2 | | 2
Approved Notes | | | | | 29
