AshitakaLax/SmartHome/EpicCube/hardware/Epic Cube Design/Workspace/Printouts/SprinklerBoard.pdf

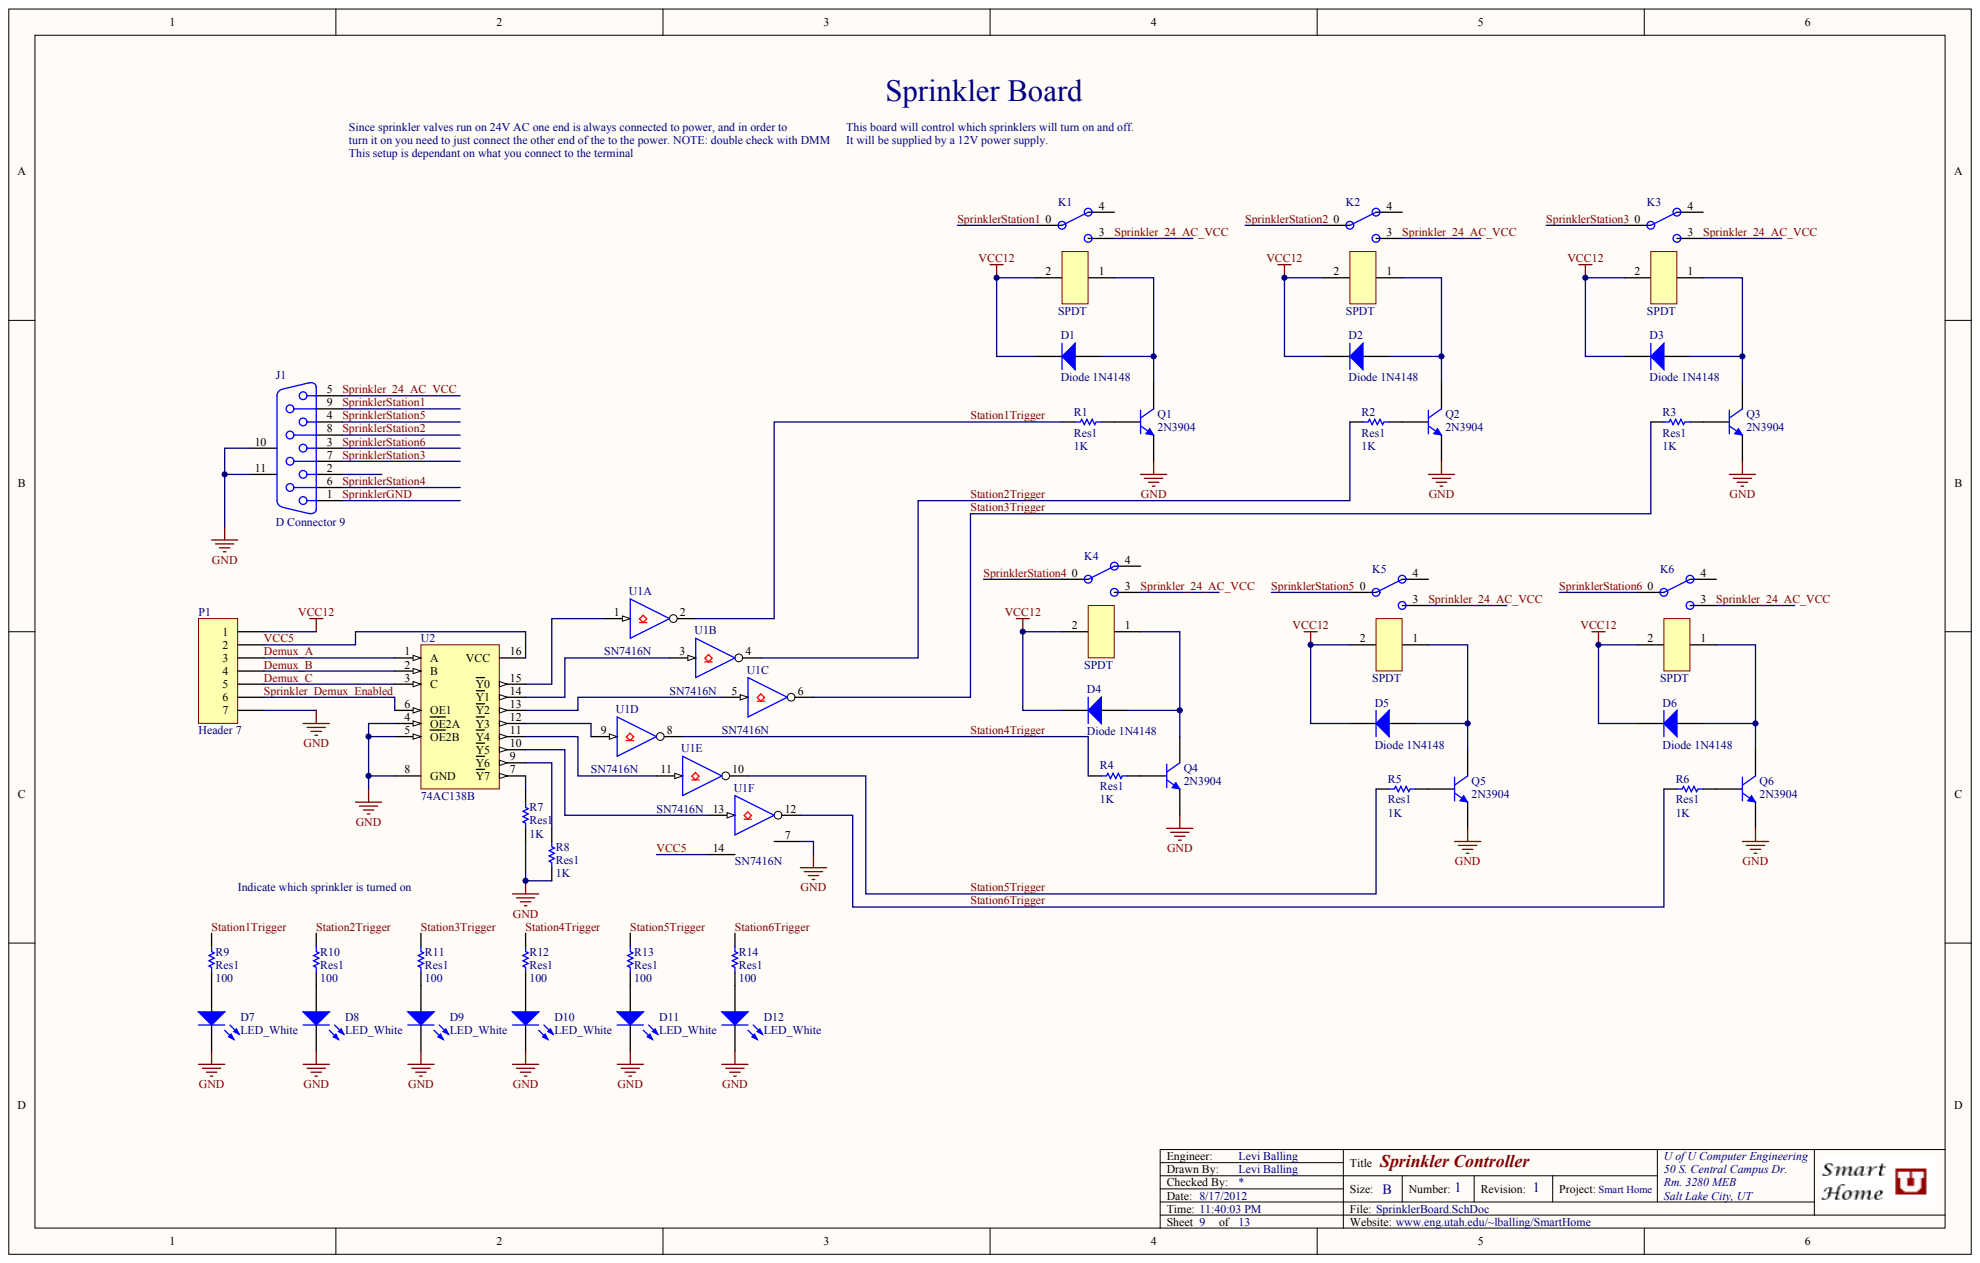
[picture p113: page 1]

Sprinkler Board This board will control which sprinklers will turn on and off.

Since sprinkler valves run on 24V AC one end is always connected to power, and in order to
turn it on you need to just connect the other end of the to the power. NOTE: double check with DMM
This setup is dependant on what you connect to the terminal

It will be supplied by a 12V power supply.

Indicate which sprinkler is turned on

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

Time: 11:40:03 PM | File: SprinklerBoard.SchDoc
Sheet 9 of 13 | Website: www.eng.utah.edu/~lballing/SmartHome

Bill of Materials | Sprinkler Controller
Source Data From: | SprinklerBoard.PrjPCB
Project: | | SprinklerBoard.PrjPCB
Variant: | | None
Creation Date: 8/17/2012 | 11:40:07 PM
Print Date: | 17-Aug-12 | 11:40:10 PM
Footprint | Comment | LibRef | Designator | Description | Quantity
DO-35 LED-0 DSUB1.385-2H9 Relay SPDT HDR1X7 2N3904 AXIAL-0.3 N014 DIP16 | Diode 1N4148 LED_White D Connector 9 SPDT Header 7 2N3904 Res1 SN7416N 74AC138B | Diode 1N4148 LED0 D Connector 9 SPDT Header 7 2N3904 Res1 SN7416N 74AC138B | D1, D2, D3, D4, D5, D6 | High Conductance Fast Diode Typical INFRARED GaAs LED Receptacle Assembly, 9 Position, Right Angle Header, 7-Pin NPN General Purpose Amplifier Resistor Hex Inverter Buffer / Driver with High-Voltage Outputs 3-to-8 Line Decoder Inverting | 6
| | | D7, D8, D9, D10, D11, D12 | | 6
| | | J1 | | 1
| | | K1, K2, K3, K4, K5, K6 | | 6
| | | P1 | | 1
| | | Q1, Q2, Q3, Q4, Q5, Q6 | | 6
| | | R1, R2, R3, R4, R5, R6, R7, R8, R9, R10, R11, R12, R13, R14 | | 14
| | | U1 | | 1
| | | U2 | | 1
Approved Notes | | | | | 42
