AshitakaLax/SmartHome/EpicCube/hardware/Epic Cube Design/Workspace/Printouts/TemperatureSensorBlock.pdf

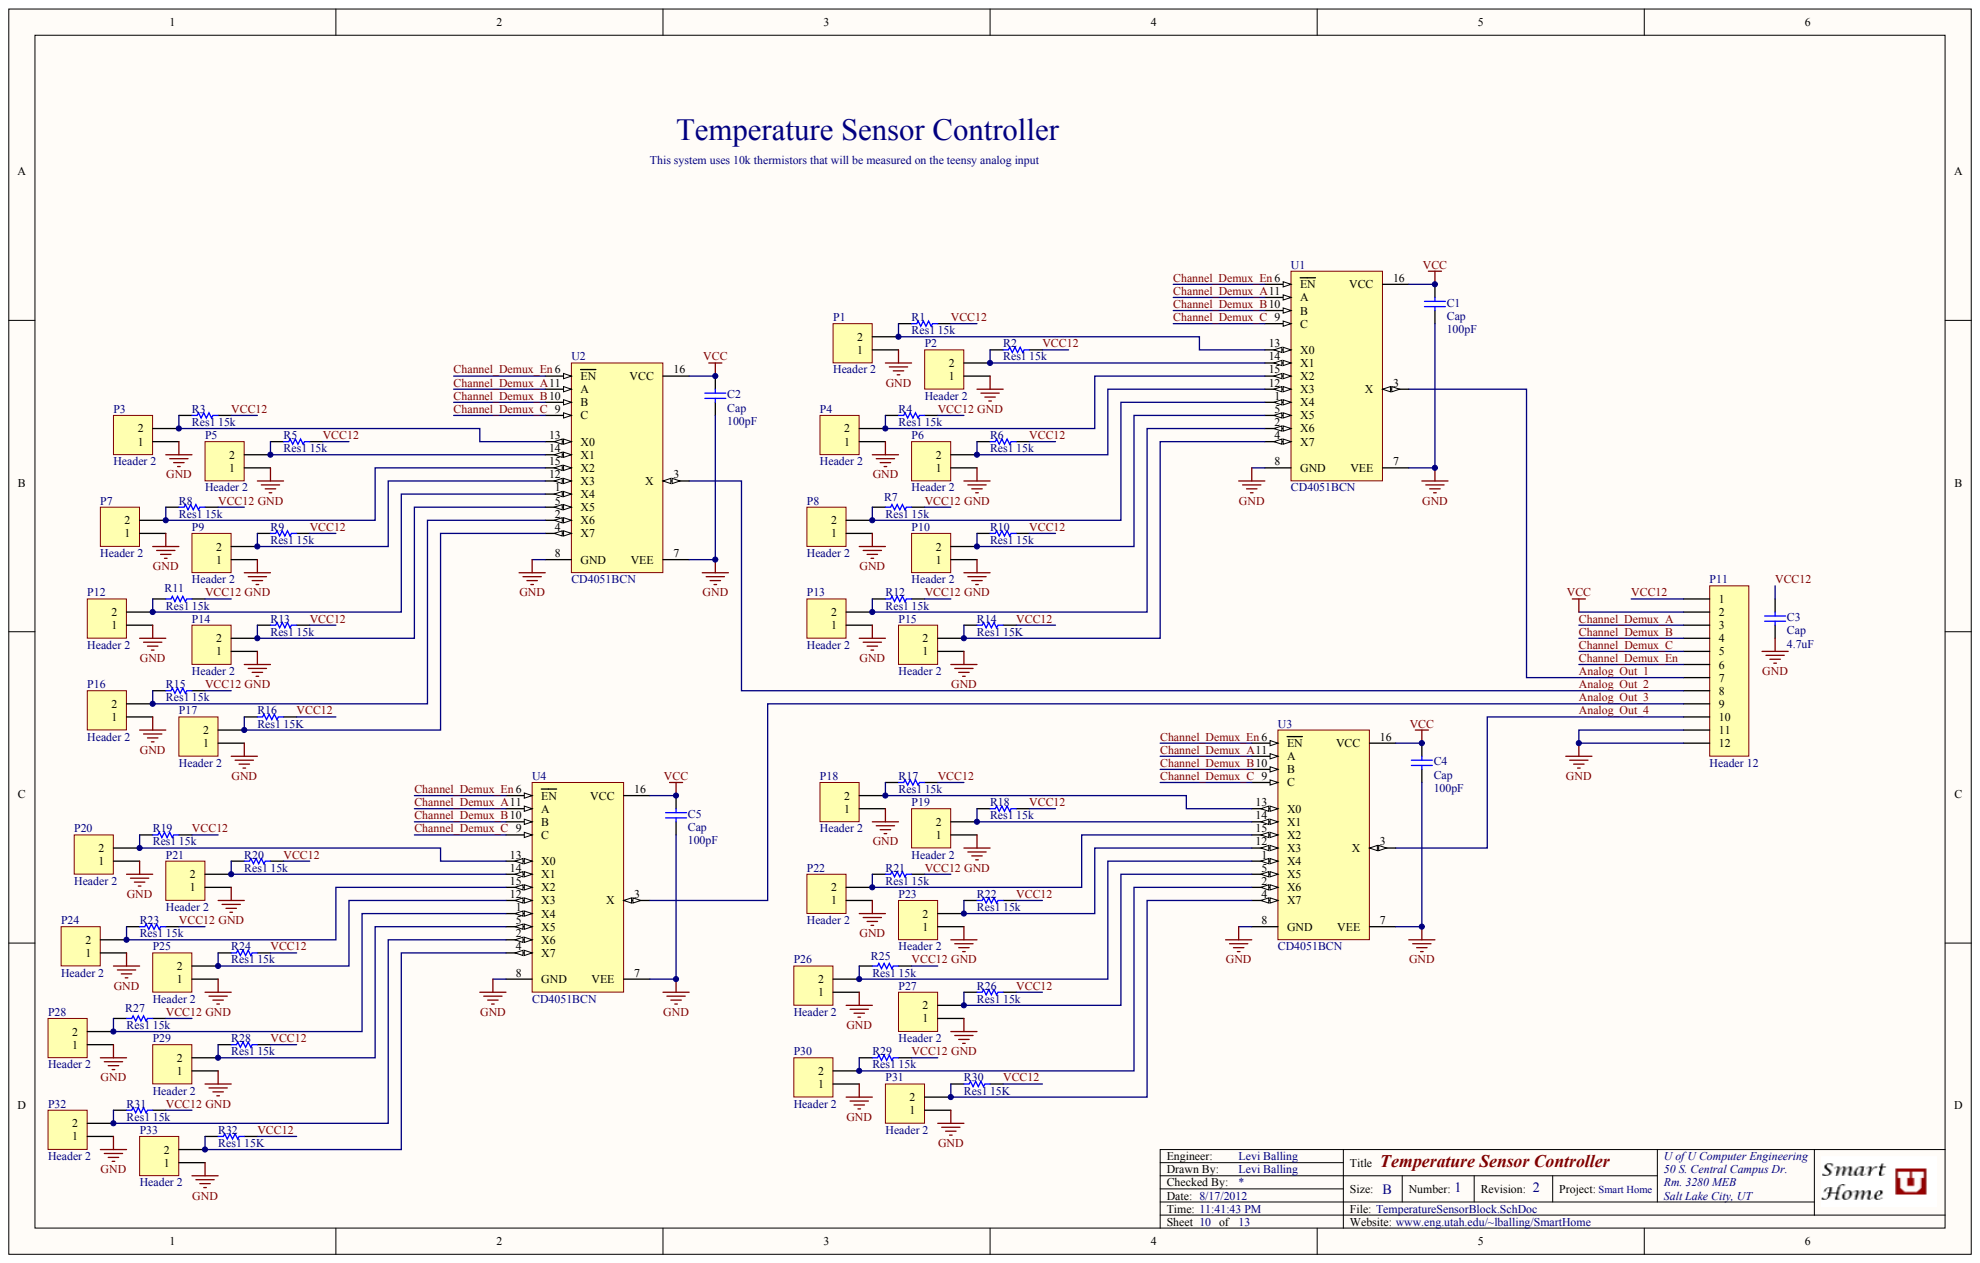
[picture p114: page 1]

Temperature Sensor Controller This system uses 10k thermistors that will be measured on the teensy analog input

P2 R2 VCC12
12 | Res1 15k | X2 15 X1 14

P23 | R22 VCC12 | 4

U of U Computer Engineering
50 S. Central Campus Dr.
Rm. 3280 MEB
Salt Lake City, UT

Time: 11:41:43 PM | File: TemperatureSensorBlock.SchDoc
Sheet 10 of 13 | Website: www.eng.utah.edu/~lballing/SmartHome

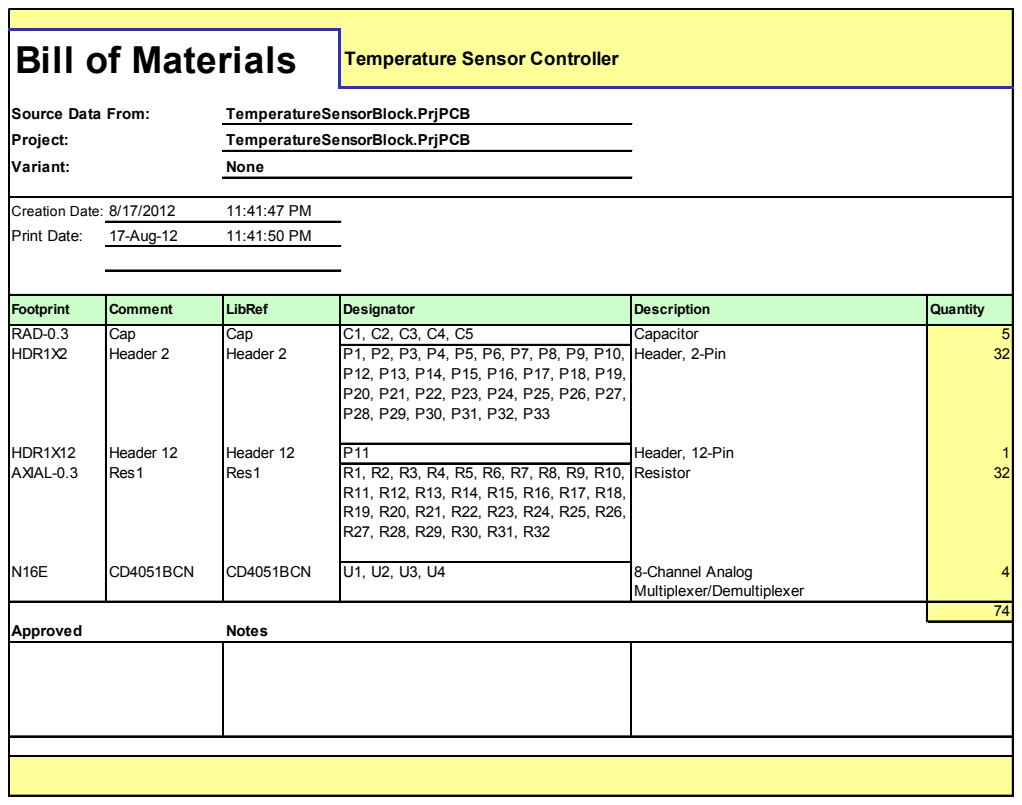
[picture p115: page 2]
