AshitakaLax/SmartHome/EpicCube/hardware/Epic Cube Design/Workspace/Printouts/WirelessCommunications.pdf

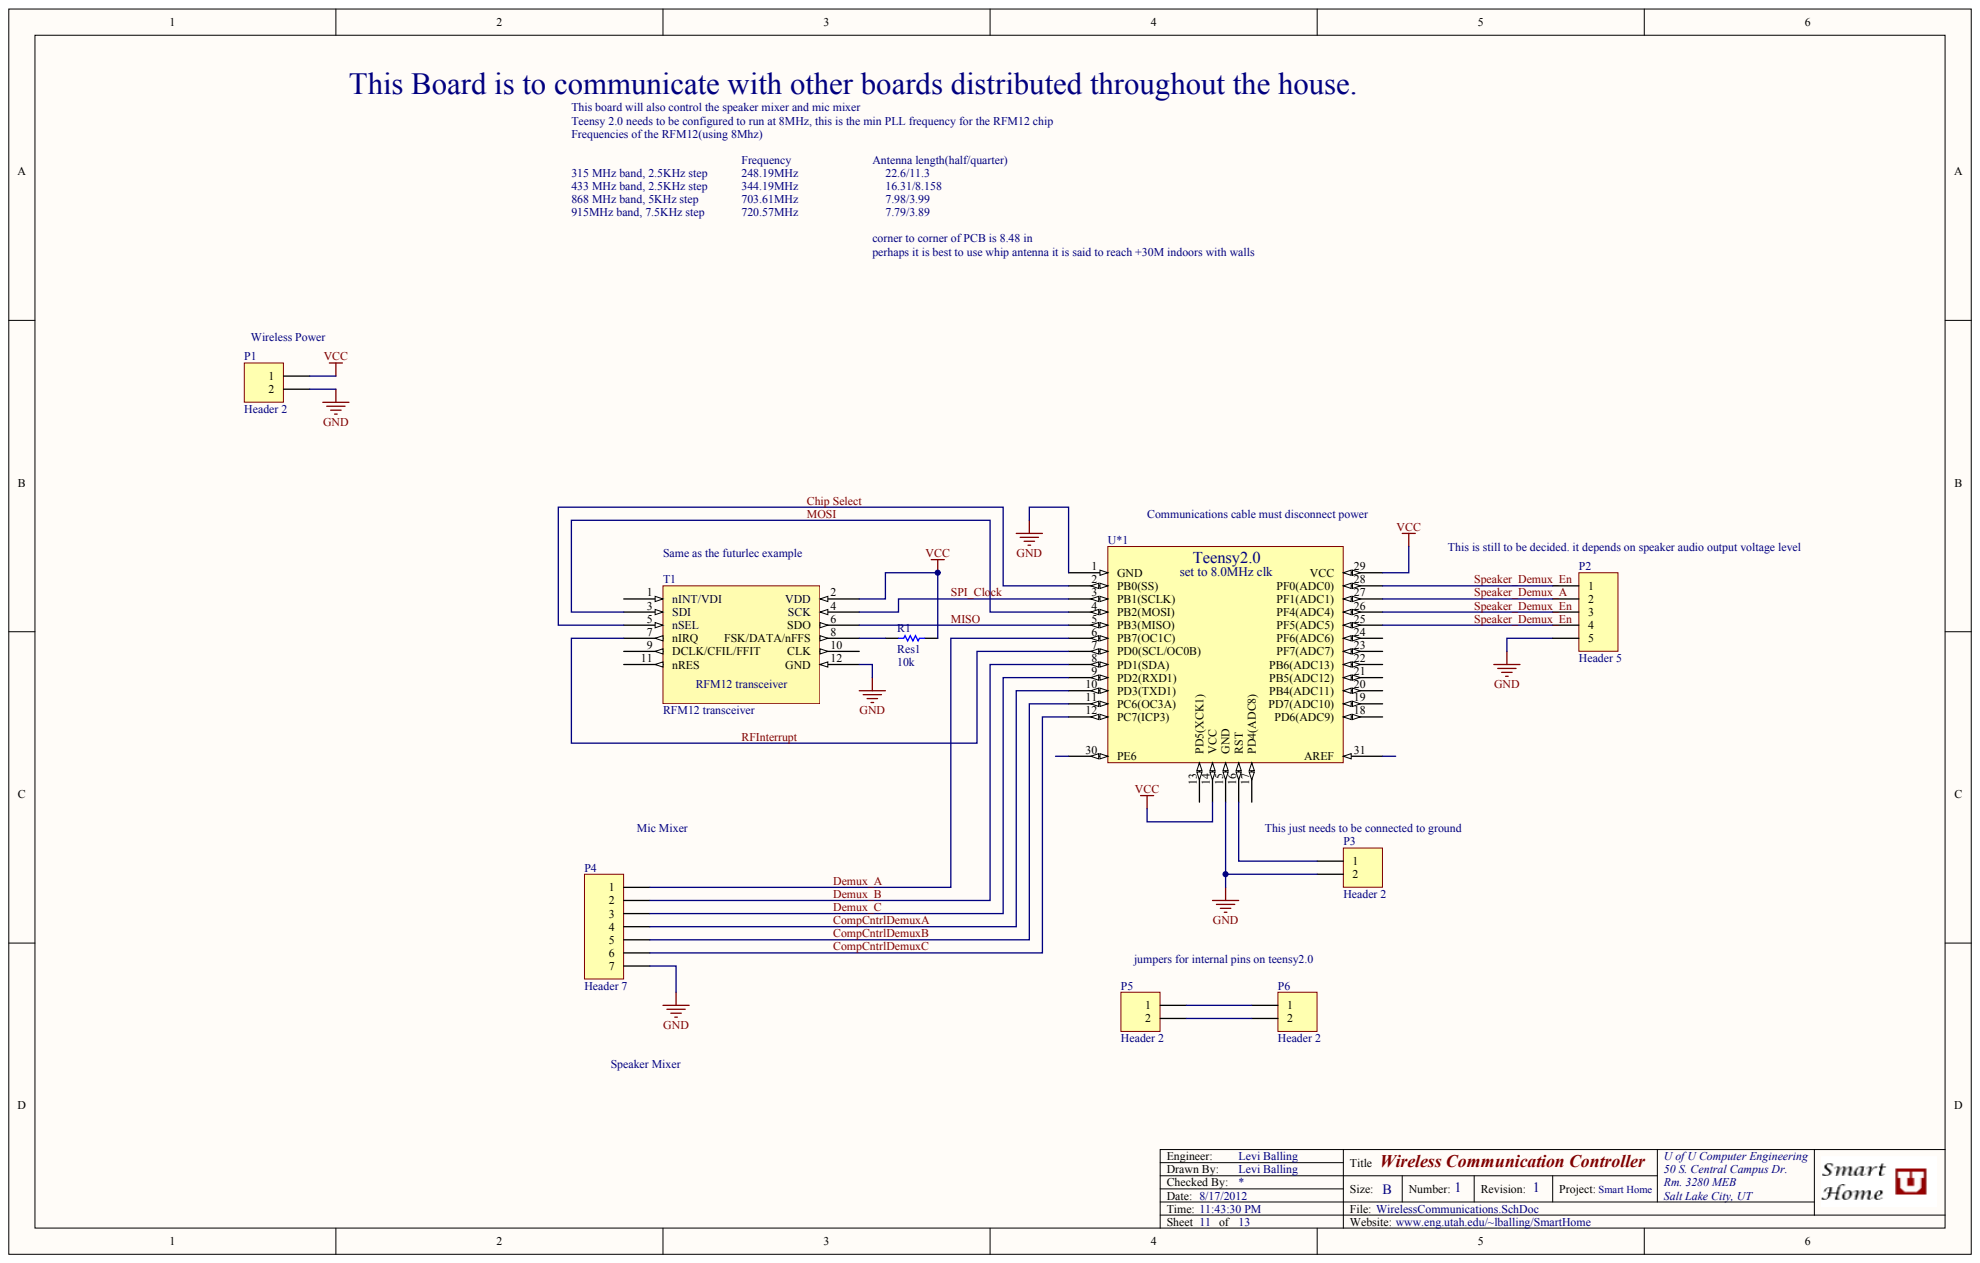
[picture p116: page 1]

This Board is to communicate with other boards distributed throughout the house. Teensy 2.0 needs to be configured to run at 8MHz, this is the min PLL frequency for the RFM12 chip

This board will also control the speaker mixer and mic mixer

Frequencies of the RFM12(using 8Mhz)

corner to corner of PCB is 8.48 in
perhaps it is best to use whip antenna it is said to reach +30M indoors with walls

Communications cable must disconnect power

This is still to be decided. it depends on speaker audio output voltage level

Same as the futurlec example

PD1(SDA) 8
PD2(RXD1) 9

RFM12 transceiver | | PD3(TXD1) 10

RFM12 transceiver GND | | | | PC7(ICP3) 12

This just needs to be connected to ground

Demux_B
Demux_C
CompCntrlDemuxA
CompCntrlDemuxB
CompCntrlDemuxC

jumpers for internal pins on teensy2.0

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

Time: 11:43:30 PM | File: WirelessCommunications.SchDoc
Sheet 11 of 13 | Website: www.eng.utah.edu/~lballing/SmartHome

Bill of Materials | Wireless Communication Controller
Source Data From: | WirelessCommunications.PrjPcb
Project: | | WirelessCommunications.PrjPcb
Variant: | | None
Creation Date: 8/17/2012 | 11:43:33 PM
Print Date: | 17-Aug-12 | 11:43:36 PM
Footprint | Comment | LibRef | Designator | Description | Quantity
HDR1X2 HDR1X5 HDR1X7 AXIAL-0.3 RFM12-transceiver Teensy2.0 | Header 2 Header 5 Header 7 Res1 RFM12 transceiver Teensy | Header 2 Header 5 Header 7 Res1 RFM12 transceiver Teensy2.0 | P1, P3, P5, P6 | Header, 2-Pin Header, 5-Pin Header, 7-Pin Resistor www.futurlec.com 433 MHZ transceiver The teensy 2.0 from www.PJRC.com, chang clock to 8MHz | 4
| | | P2 | | 1
| | | P4 | | 1
| | | R1 | | 1
| | | T1 | | 1
| | | U*1 | | 1
Approved Notes | | | | | 9
