AshitakaLax/SmartHome/Website/SmartHome/documents/EpicCubeSchem.PDF

List of functions: 64 x Temperature Sensors

Garage Door Control
Air Conditioning and Heating Control
16 x Vent Damper Motor Drivers
Wireless Communication
8 x Microphone Inputs for Voice Recognition
8 x Interrupt Buttons for Specific Microphone Use
Baby Monitor listening
8 x Output Specific Speakers
5 x 12VDC PWM Fan Controllers

Bi-Polar Stepper Motor Driver

U of U Computer Engineering
50 S. Central Campus Dr.
Rm. 3280 MEB
Salt Lake City, UT

Time: 1:38:47 PM | File: TheEpicCube.SchDoc
Sheet of | Website: www.eng.utah.edu/~lballing/SmartHome

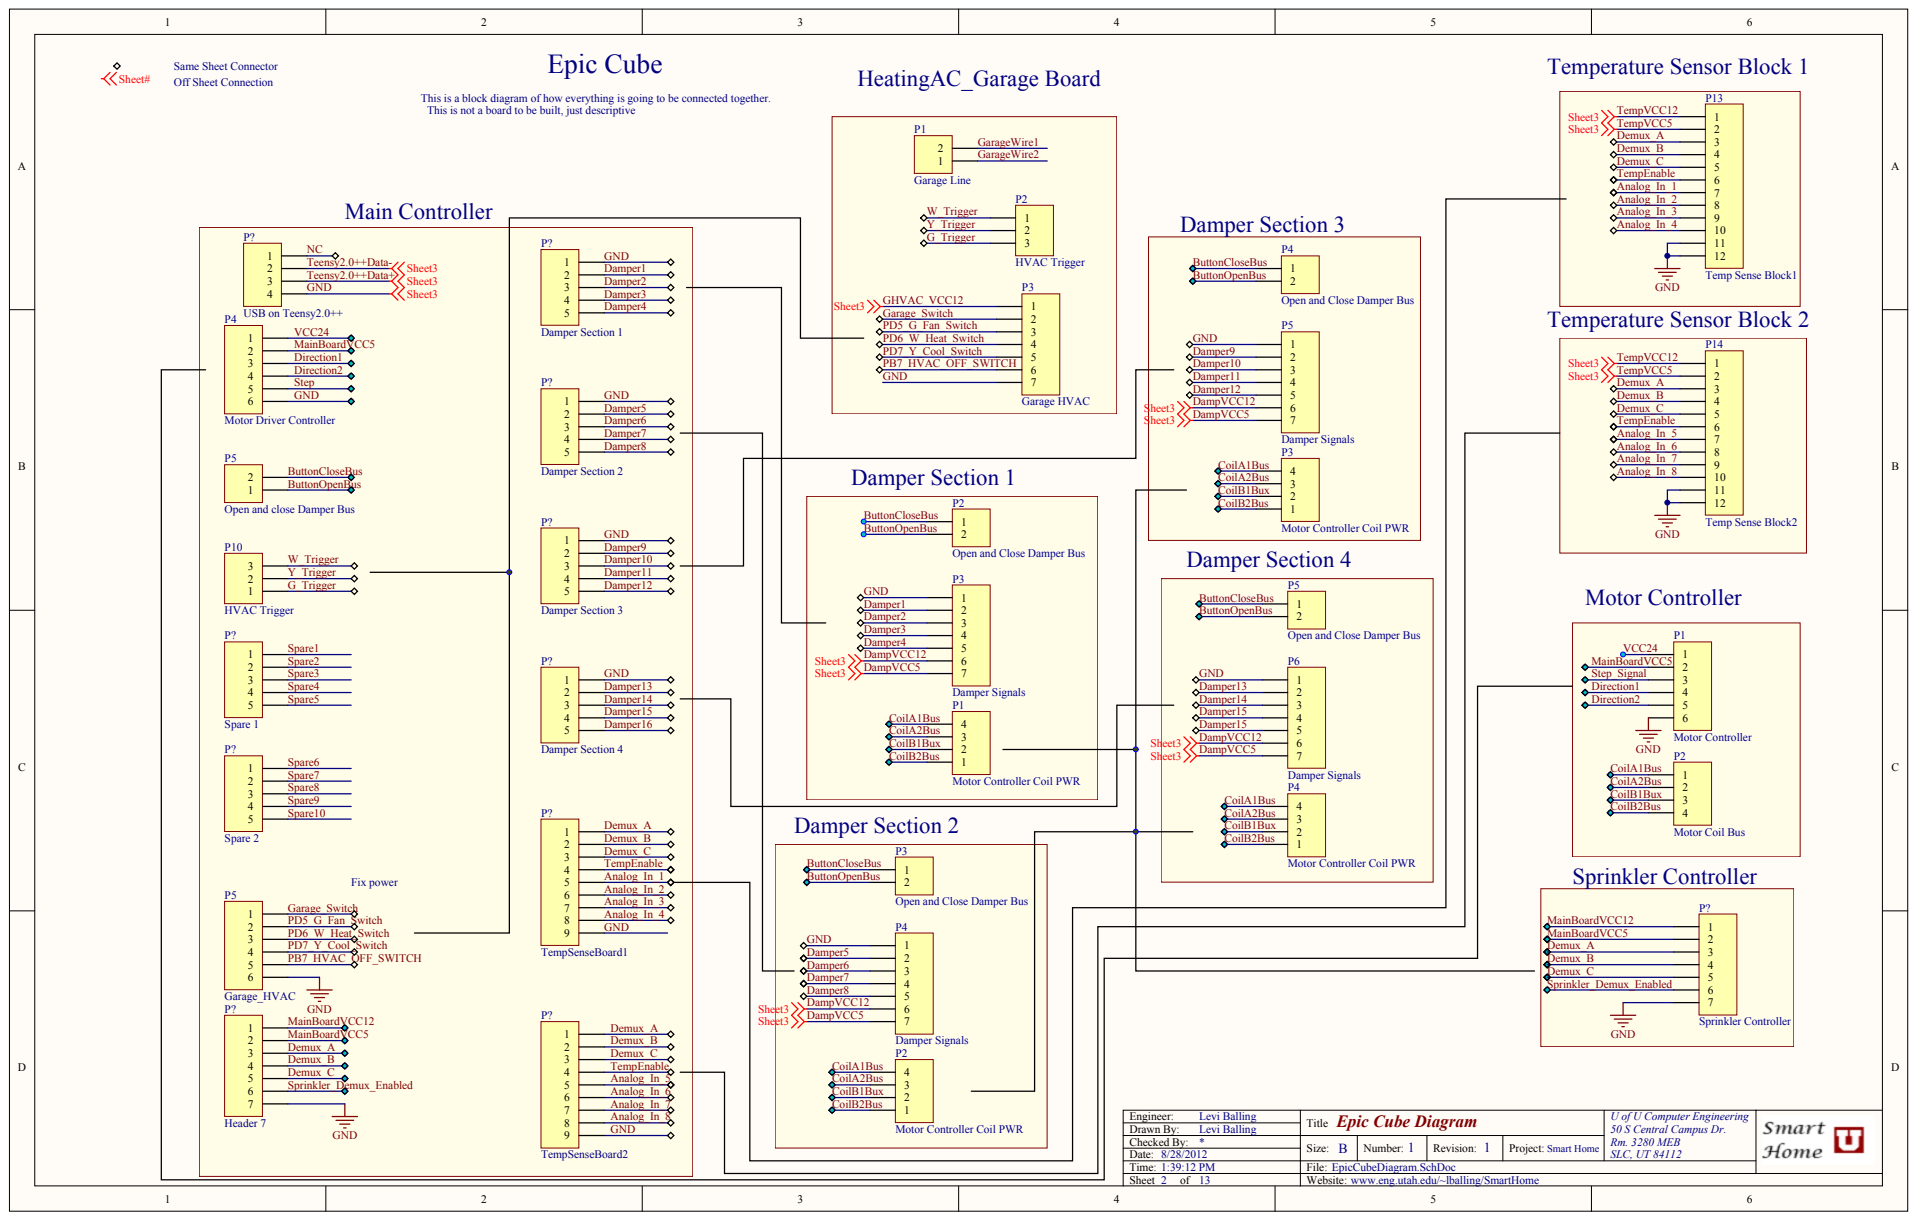
[picture p117: page 2]

This is a block diagram of how everything is going to be connected together.
This is not a board to be built, just descriptive
Damper Section 2 12345

Open and Close Damper Bus

Motor Controller Coil PWR 1234567

Open and close Damper Bus 123

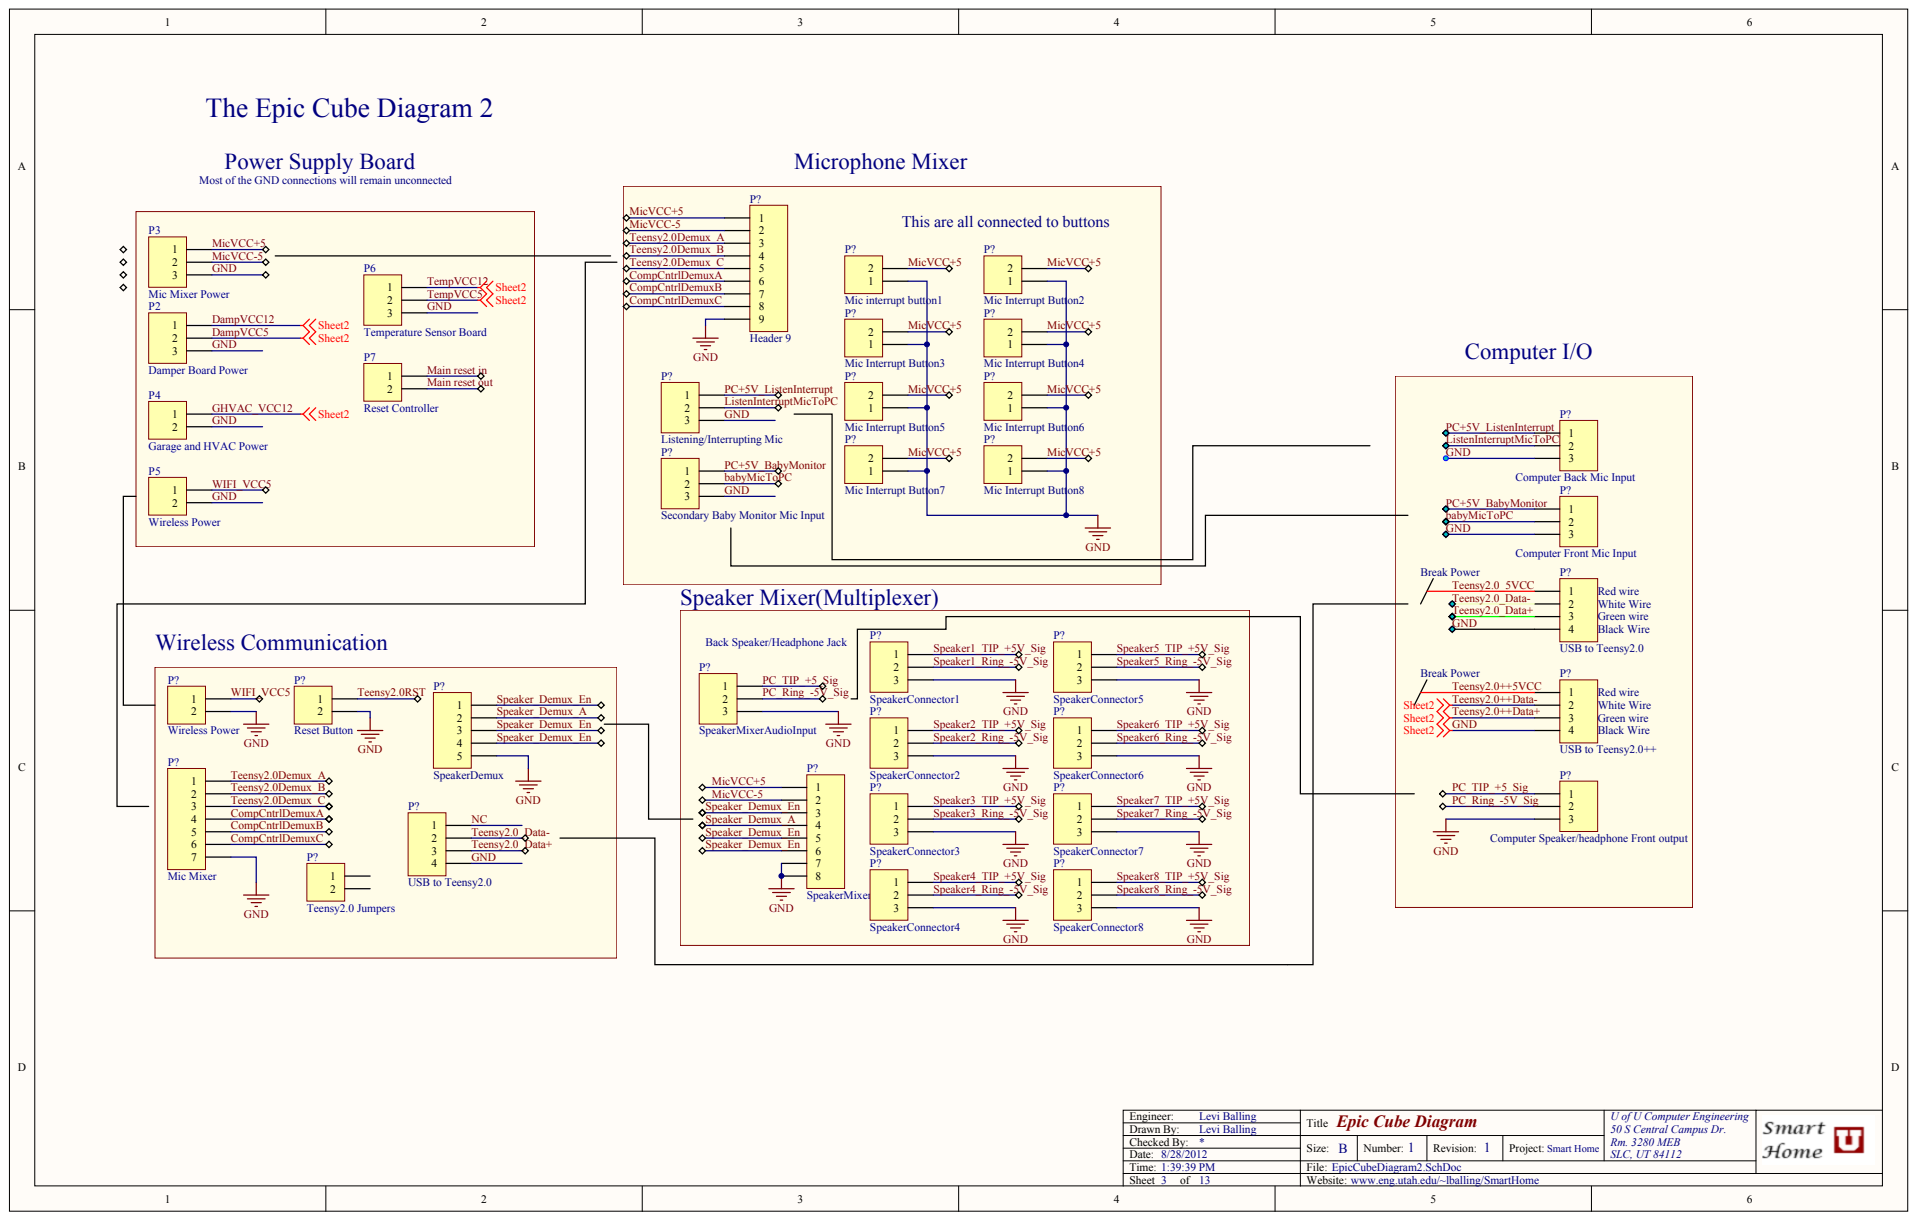
[picture p118: page 3]

The Epic Cube Diagram 2

Power Supply Board Most of the GND connections will remain unconnected

This are all connected to buttons

Computer Front Mic Input 123

Garage and HVAC Power 12

Computer Back Mic Input

Secondary Baby Monitor Mic Input

Back Speaker/Headphone Jack

Computer Speaker/headphone Front output

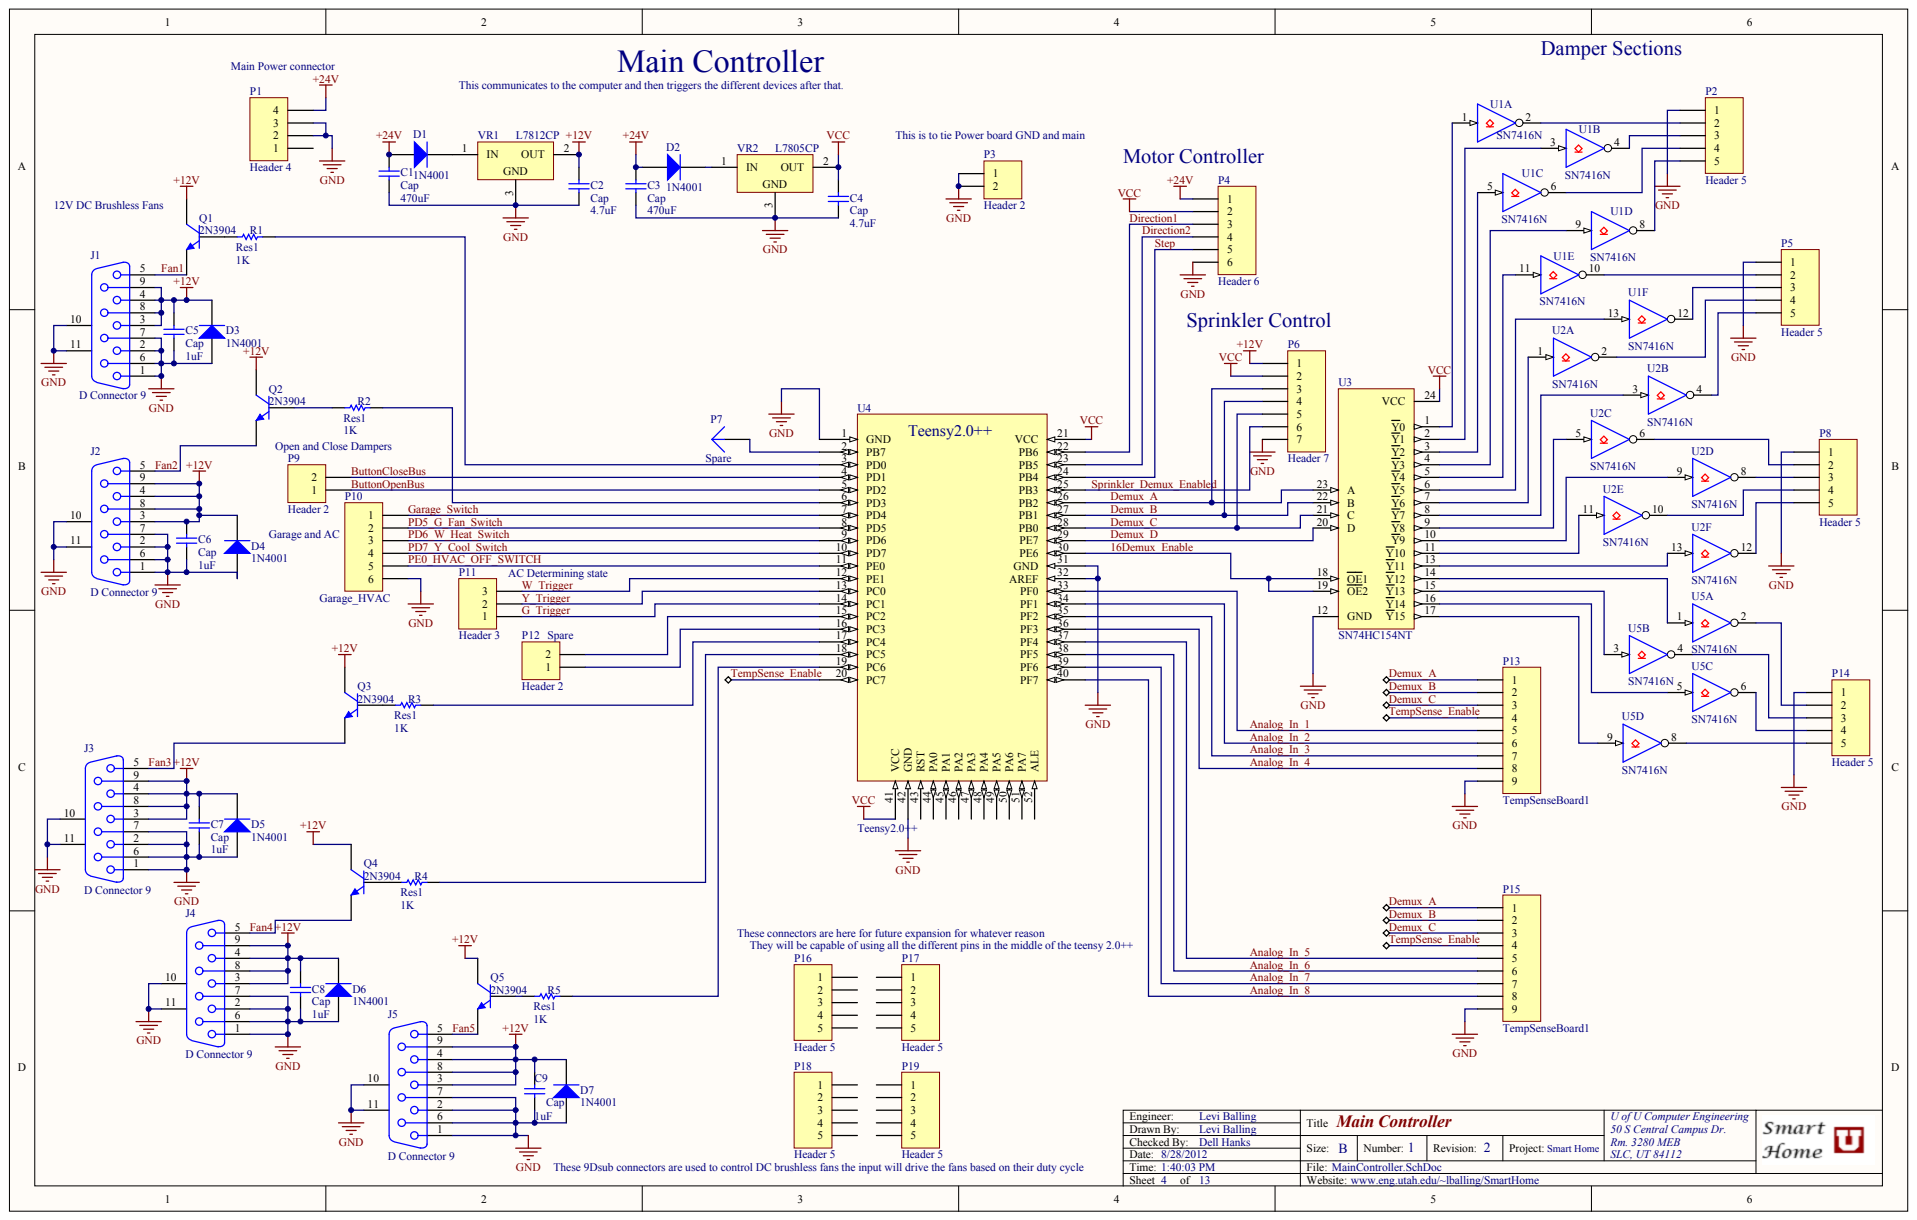
[picture p119: page 4]

Main Controller This communicates to the computer and then triggers the different devices after that.

This is to tie Power board GND and main

GND

Direction2

These connectors are here for future expansion for whatever reason
They will be capable of using all the different pins in the middle of the teensy 2.0++

These 9Dsub connectors are used to control DC brushless fans the input will drive the fans based on their duty cycle

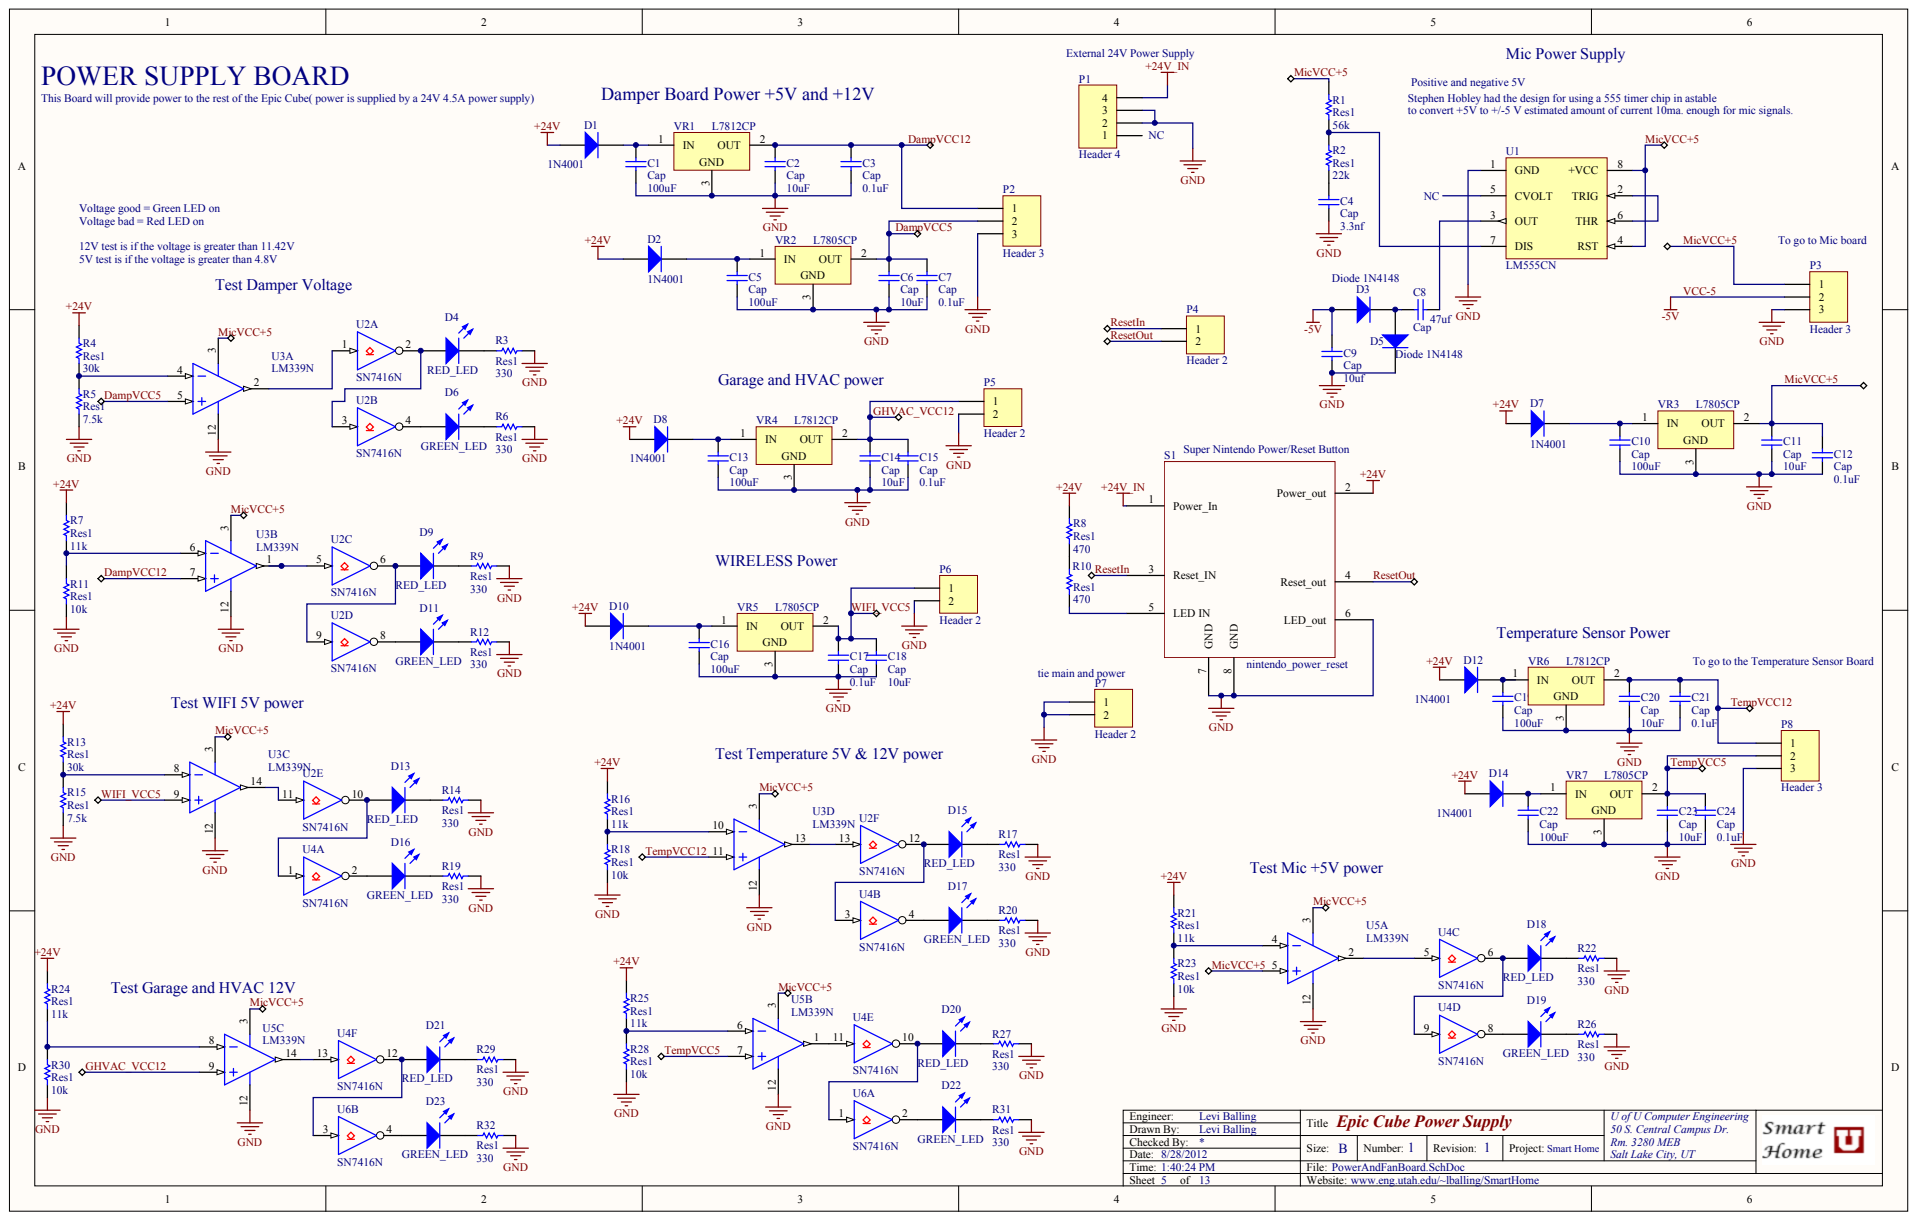
[picture p120: page 5]

Positive and negative 5V
Stephen Hobley had the design for using a 555 timer chip in astable
to convert +5V to +/-5 V estimated amount of current 10ma. enough for mic signals.

This Board will provide power to the rest of the Epic Cube( power is supplied by a 24V 4.5A power supply)

Damper Board Power +5V and +12V

Voltage good = Green LED on
Voltage bad = Red LED on

12V test is if the voltage is greater than 11.42V
5V test is if the voltage is greater than 4.8V

To go to Mic board

Garage and HVAC power

Super Nintendo Power/Reset Button

tie main and power

To go to the Temperature Sensor Board

Test Garage and HVAC 12V

Epic Cube Power Supply
Title

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

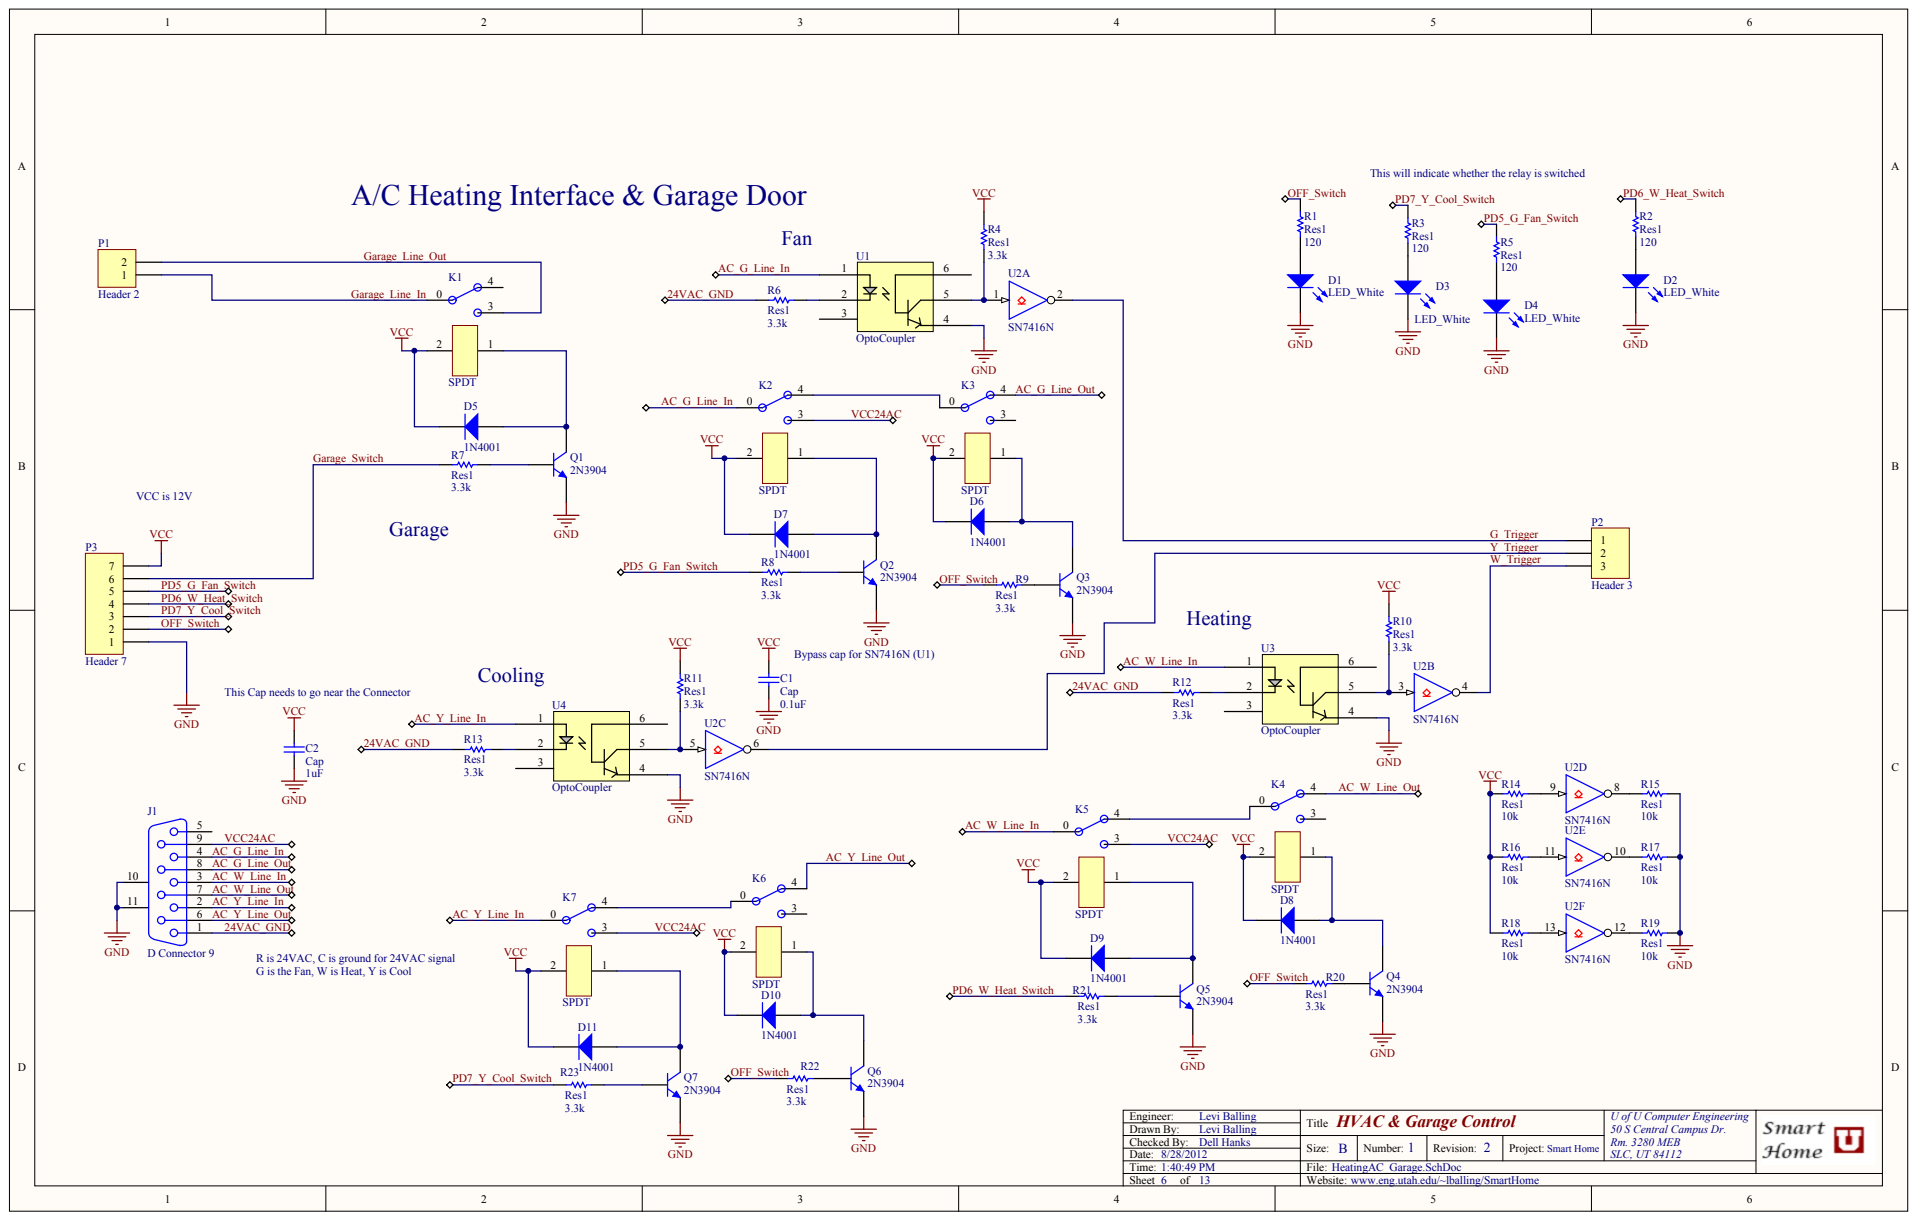
[picture p121: page 6]

A/C Heating Interface & Garage Door

This will indicate whether the relay is switched

This Cap needs to go near the Connector

R is 24VAC, C is ground for 24VAC signal
G is the Fan, W is Heat, Y is Cool

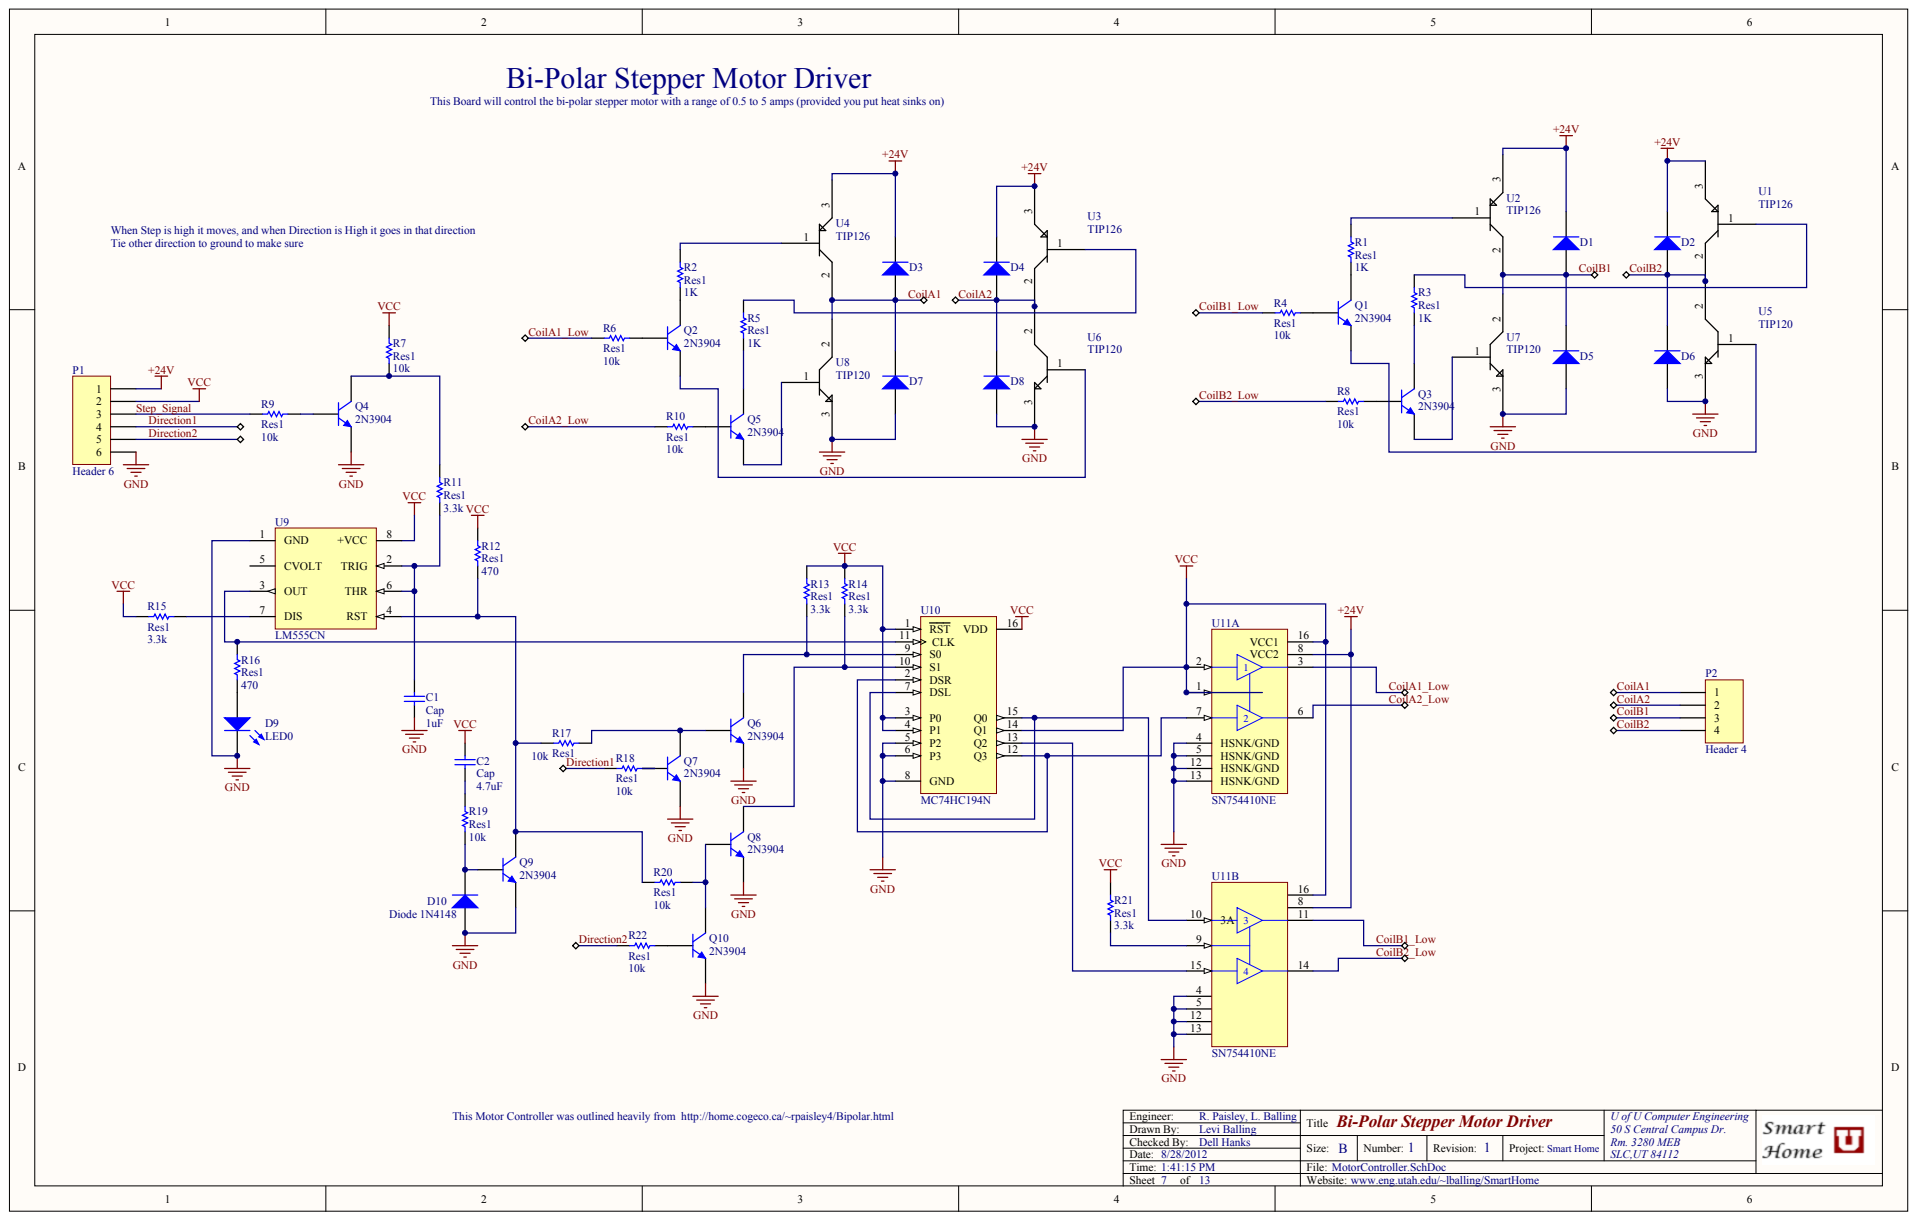
[picture p122: page 7]

Bi-Polar Stepper Motor Driver This Board will control the bi-polar stepper motor with a range of 0.5 to 5 amps (provided you put heat sinks on)

When Step is high it moves, and when Direction is High it goes in that direction
Tie other direction to ground to make sure

HSNK/GND 12

This Motor Controller was outlined heavily from http://home.cogeco.ca/~rpaisley4/Bipolar.html

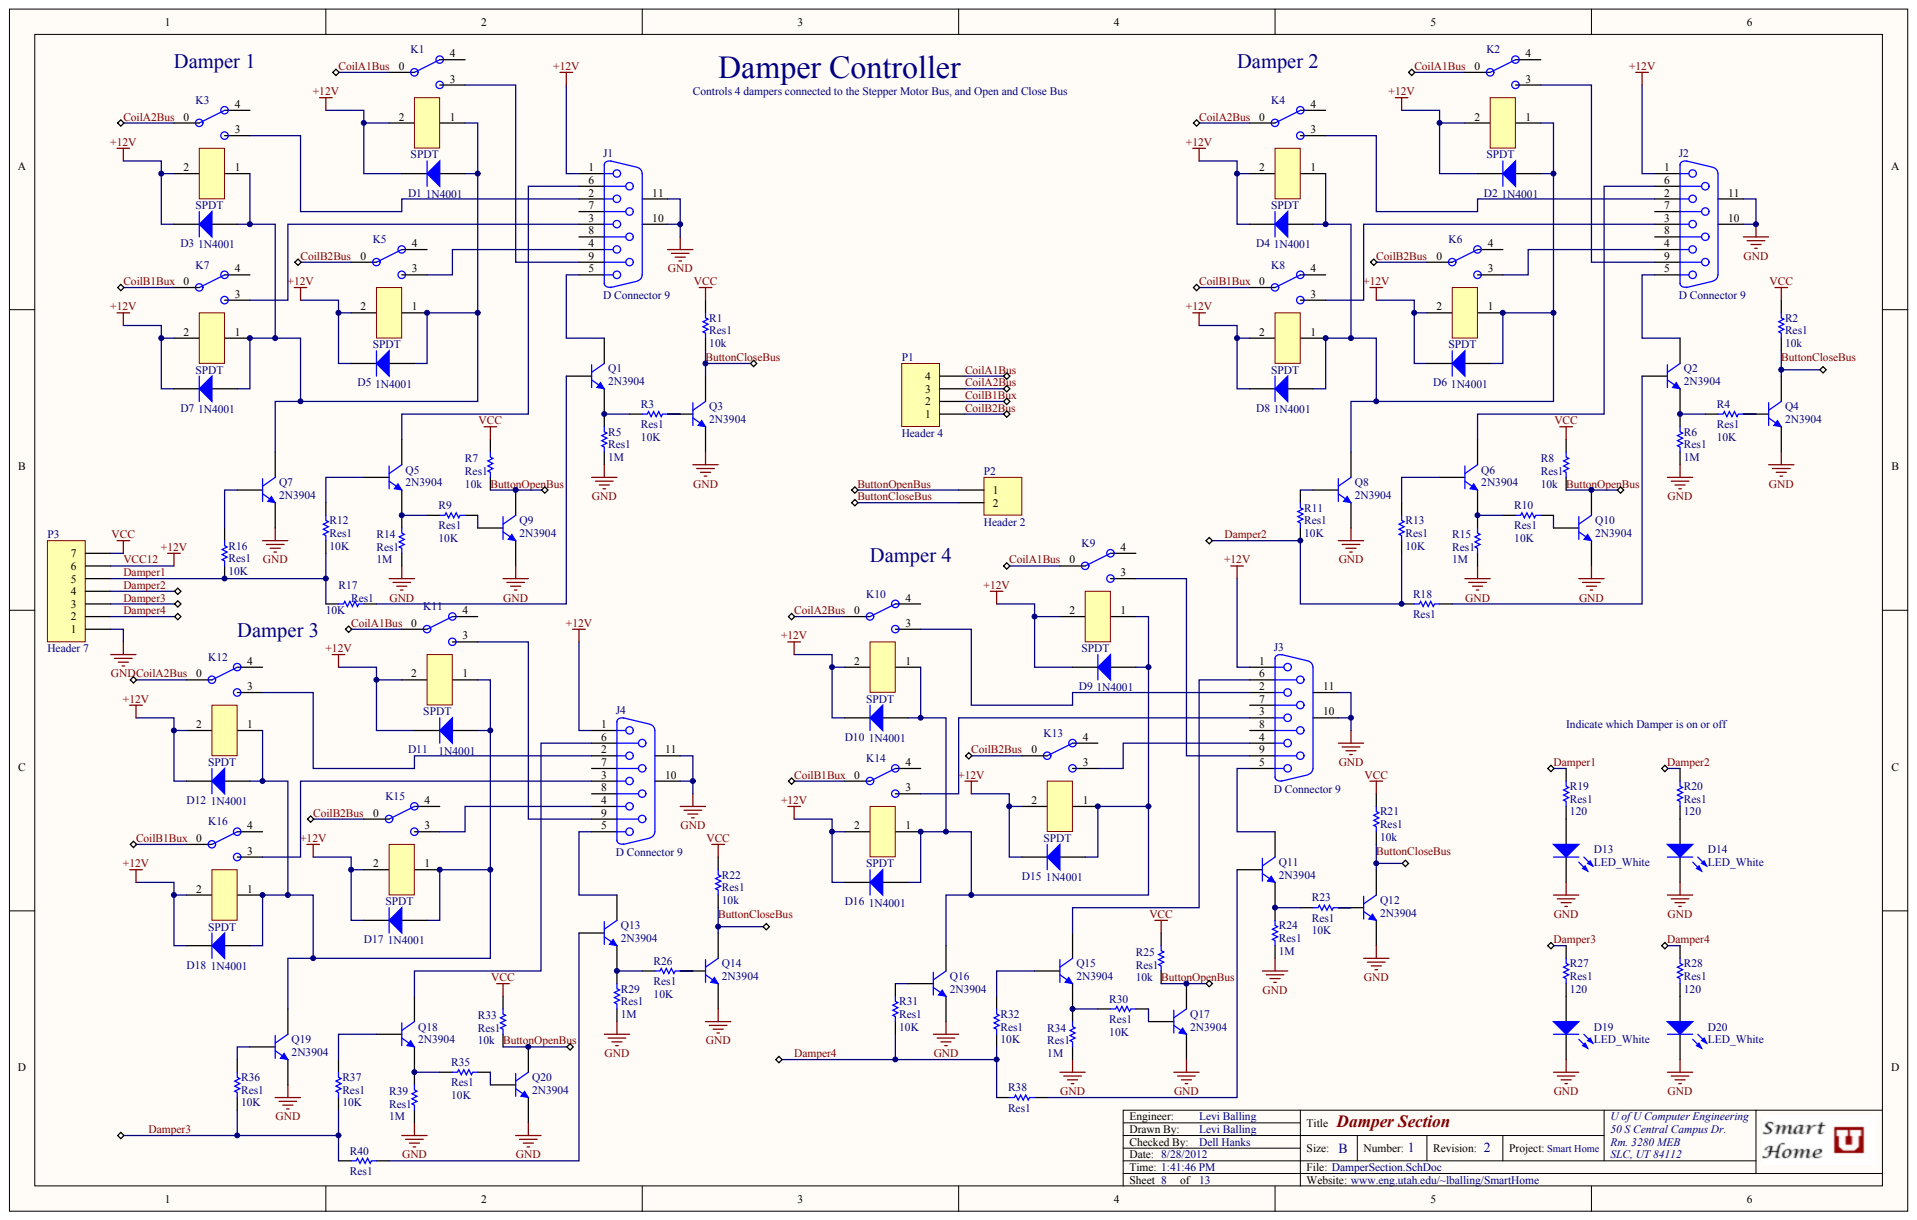
[picture p123: page 8]

Damper Controller Controls 4 dampers connected to the Stepper Motor Bus, and Open and Close Bus

Indicate which Damper is on or off

VCC

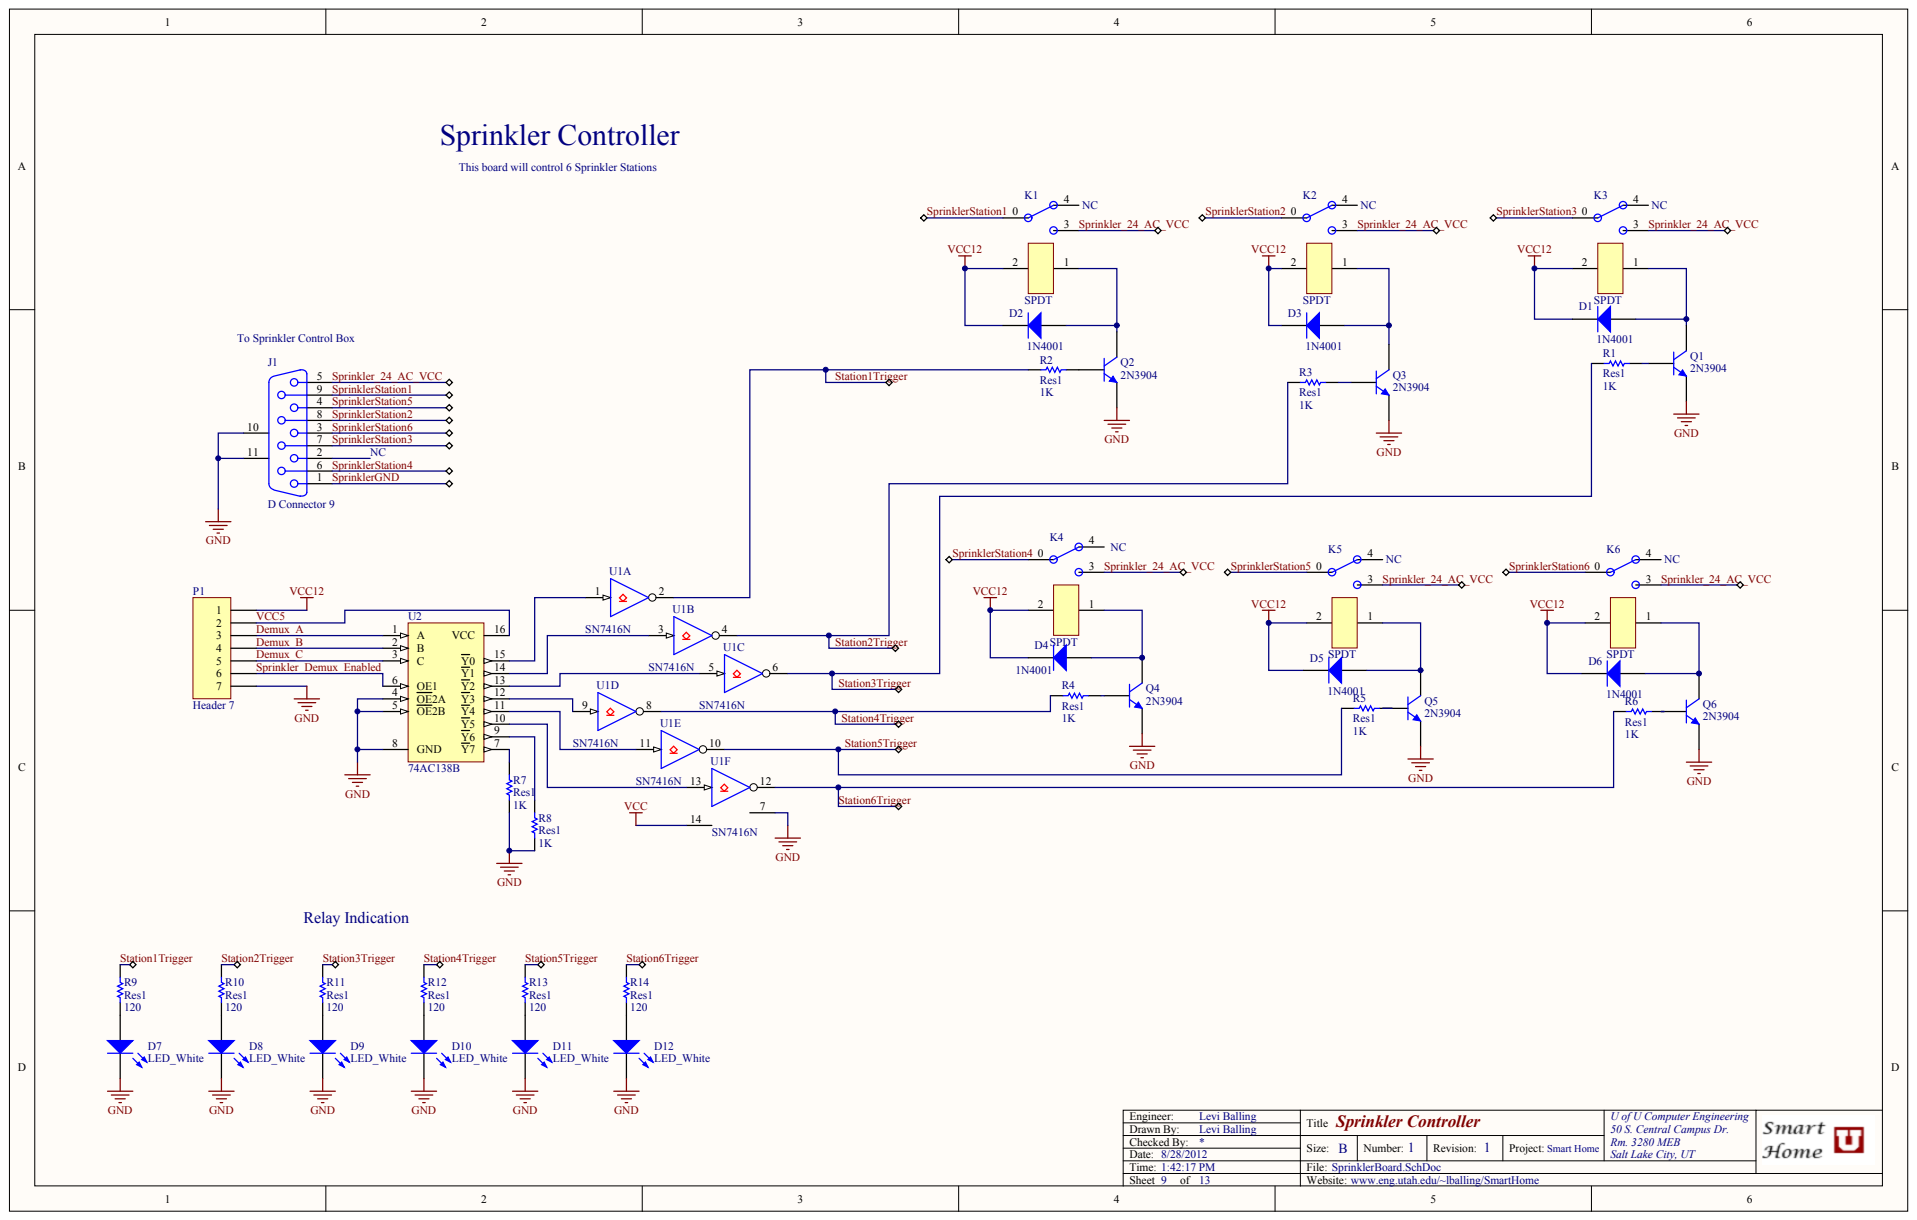
[picture p124: page 9]

This board will control 6 Sprinkler Stations

To Sprinkler Control Box

Station1Trigger | | Res1 | 2N3904

SprinklerStation4 | K4 4 0 | K5 4

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

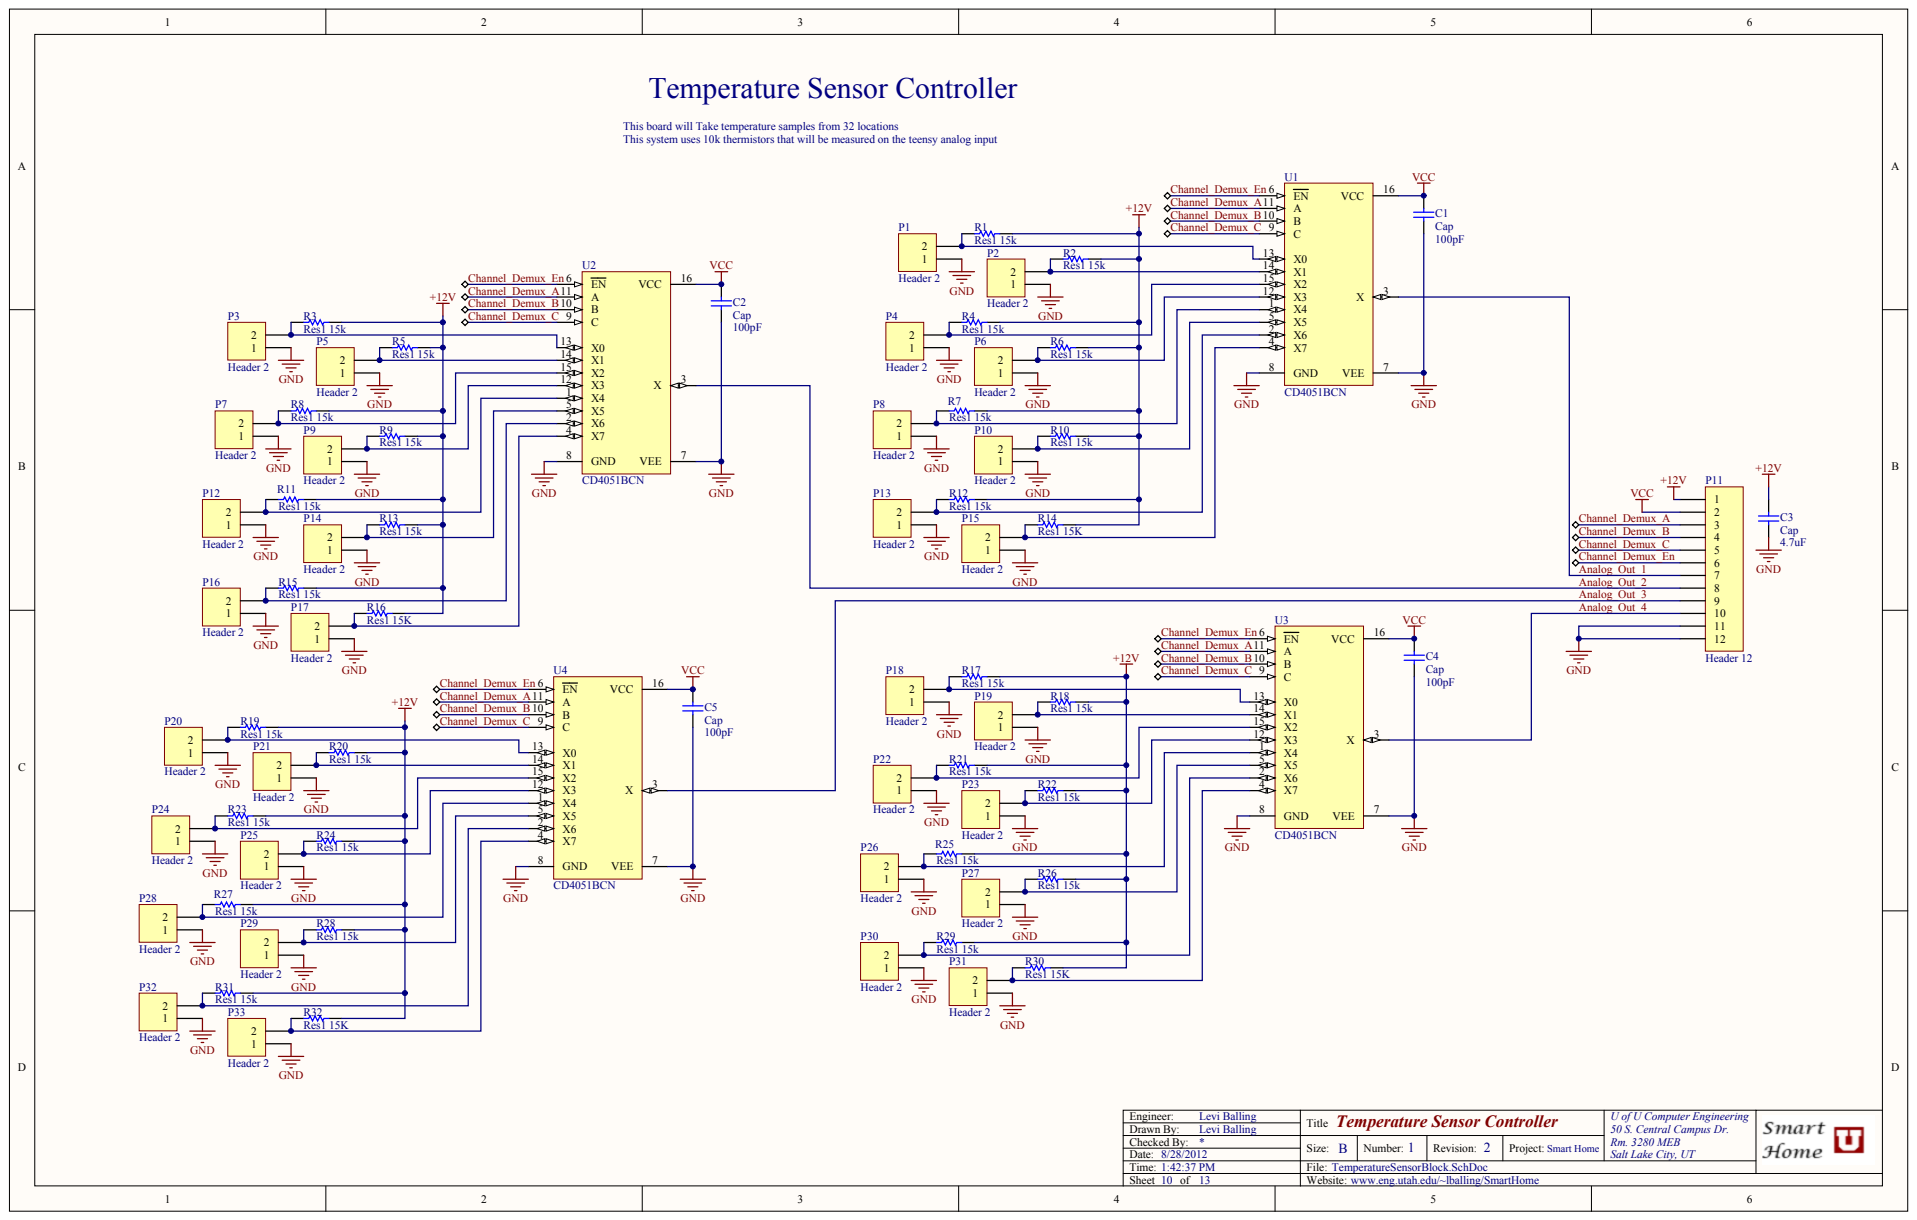
[picture p125: page 10]

This board will Take temperature samples from 32 locations
This system uses 10k thermistors that will be measured on the teensy analog input

P2 R2
12 | Res1 15k

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

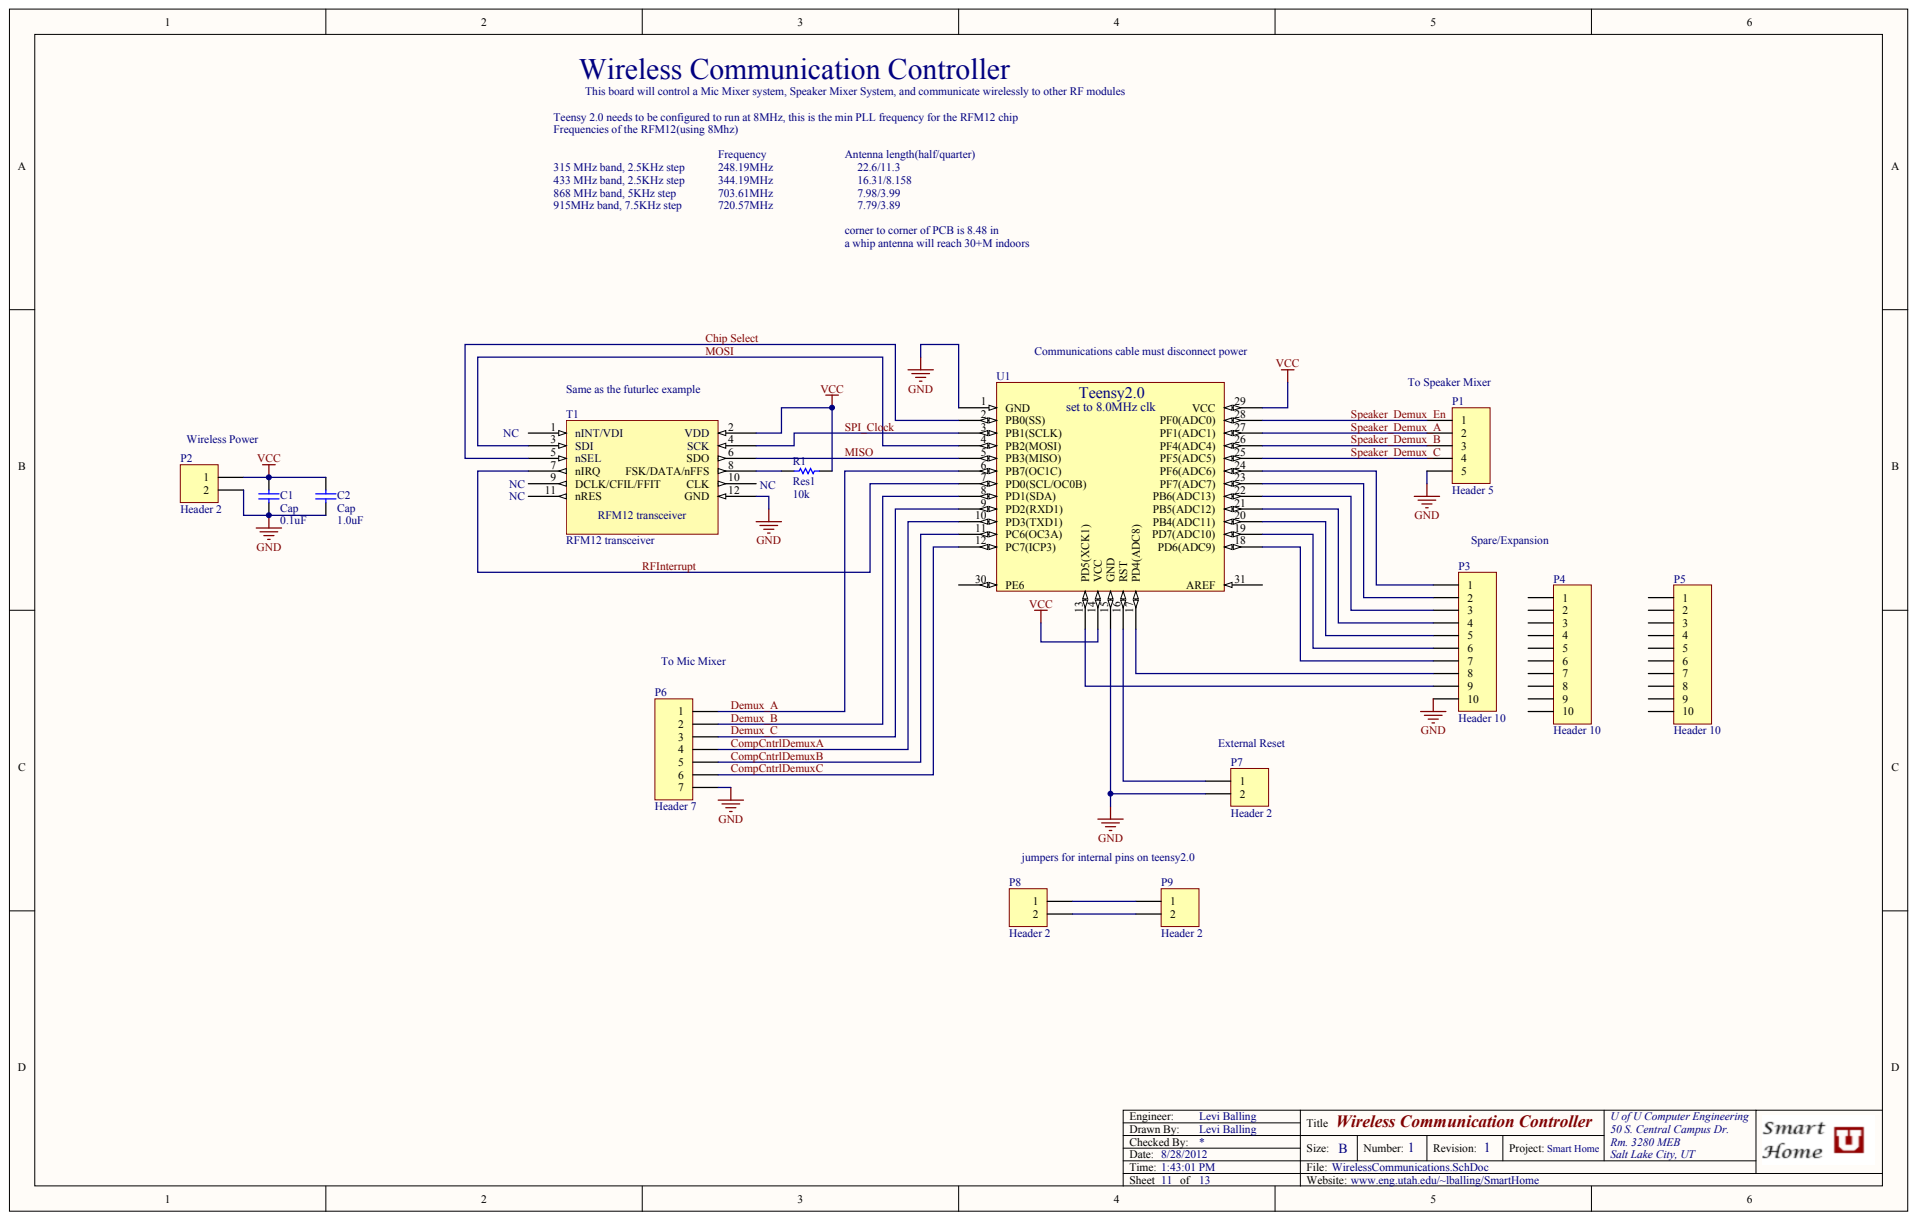
[picture p126: page 11]

This board will control a Mic Mixer system, Speaker Mixer System, and communicate wirelessly to other RF modules

Teensy 2.0 needs to be configured to run at 8MHz, this is the min PLL frequency for the RFM12 chip
Frequencies of the RFM12(using 8Mhz)

corner to corner of PCB is 8.48 in
a whip antenna will reach 30+M indoors

Communications cable must disconnect power

Same as the futurlec example

4 | | 4 | Speaker_Demux_B
6 | MISO 5 | | Speaker_Demux_C

PD3(TXD1) 10

Demux_B
Demux_C
CompCntrlDemuxA
CompCntrlDemuxB

jumpers for internal pins on teensy2.0

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

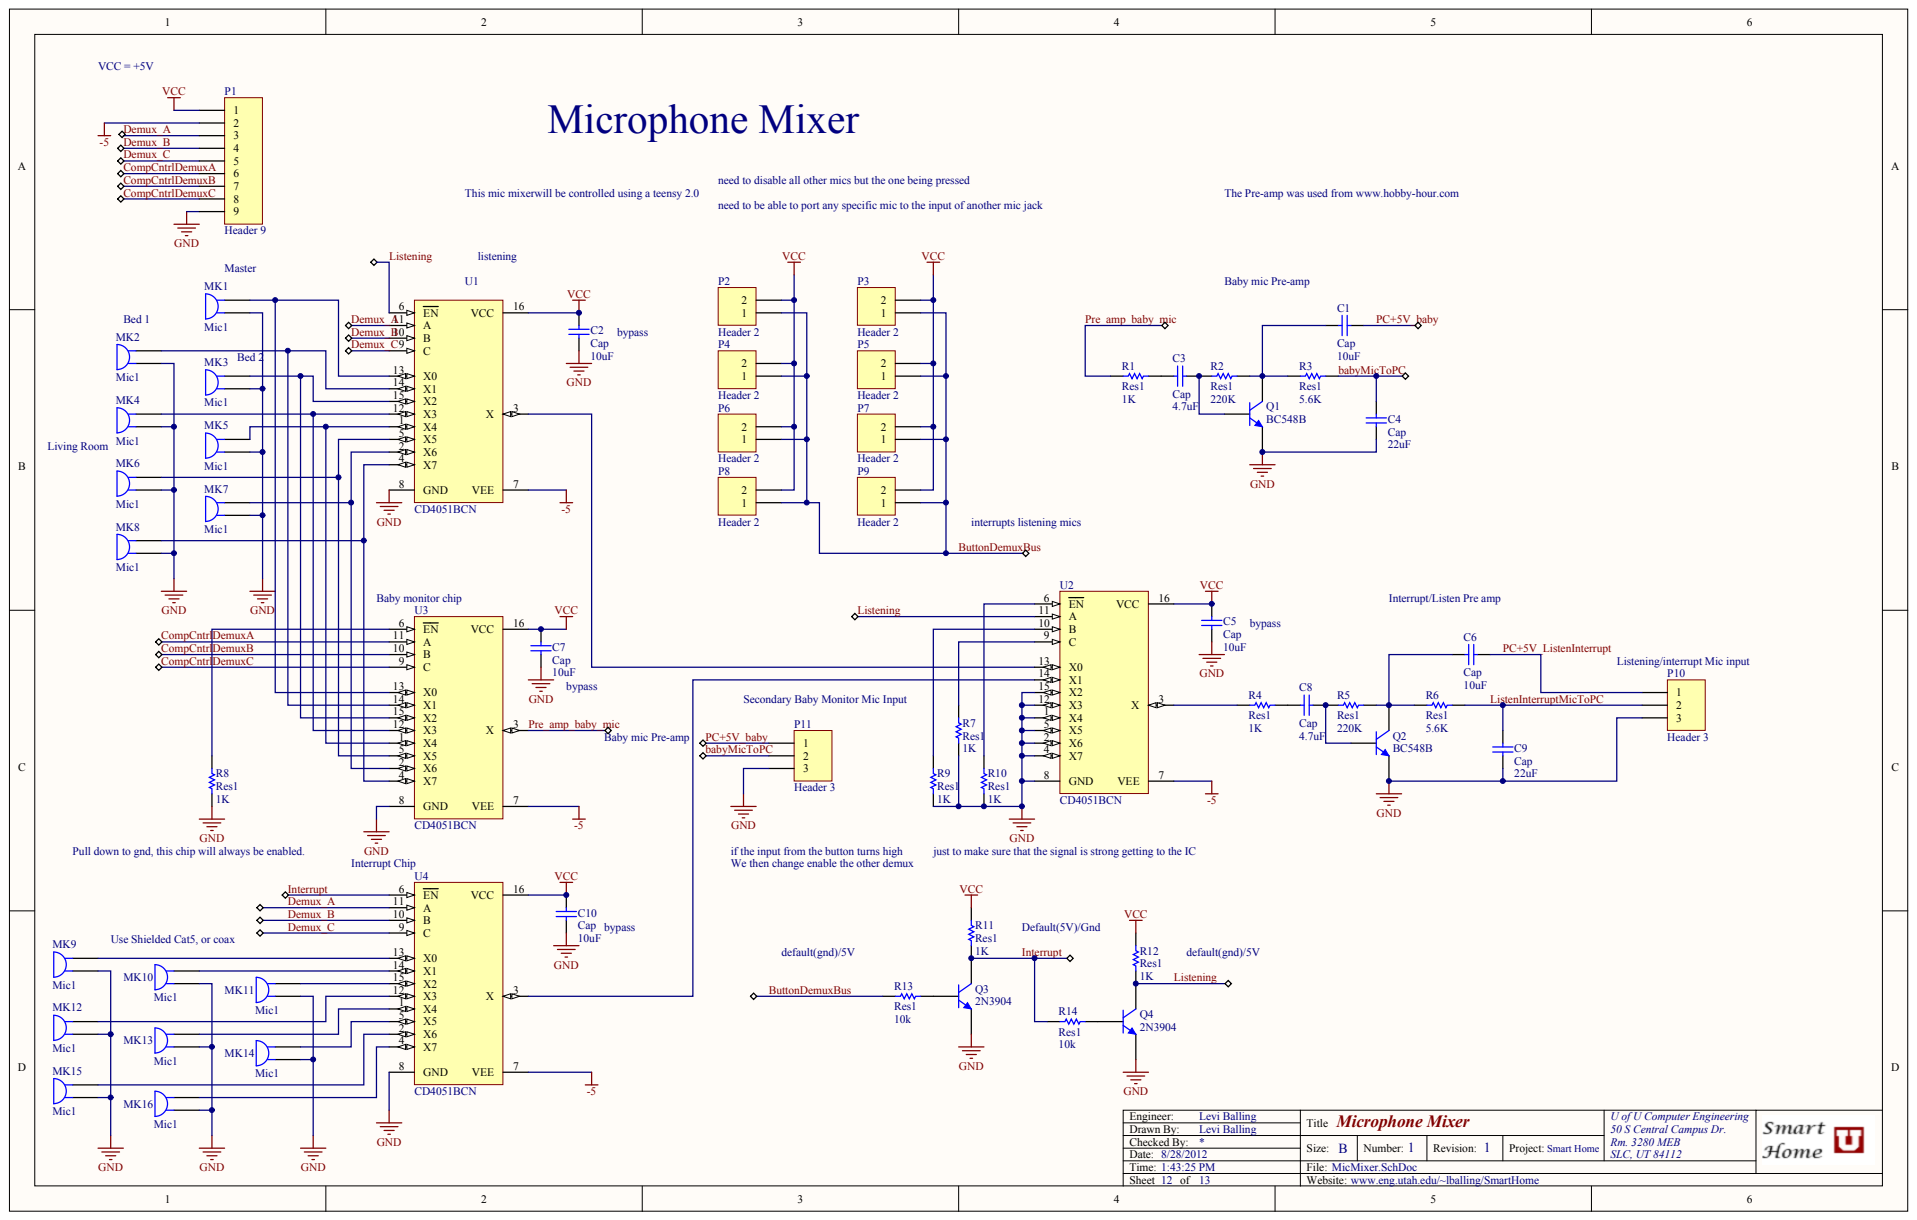
[picture p127: page 12]

This mic mixerwill be controlled using a teensy 2.0

need to disable all other mics but the one being pressed

The Pre-amp was used from www.hobby-hour.com

need to be able to port any specific mic to the input of another mic jack

Baby mic Pre-amp

X7 4 | | Header 2 P8 | | Header 2 P9

Interrupt/Listen Pre amp

Listening/interrupt Mic input

Secondary Baby Monitor Mic Input

Pull down to gnd, this chip will always be enabled.

if the input from the button turns high
We then change enable the other demux

just to make sure that the signal is strong getting to the IC

Use Shielded Cat5, or coax

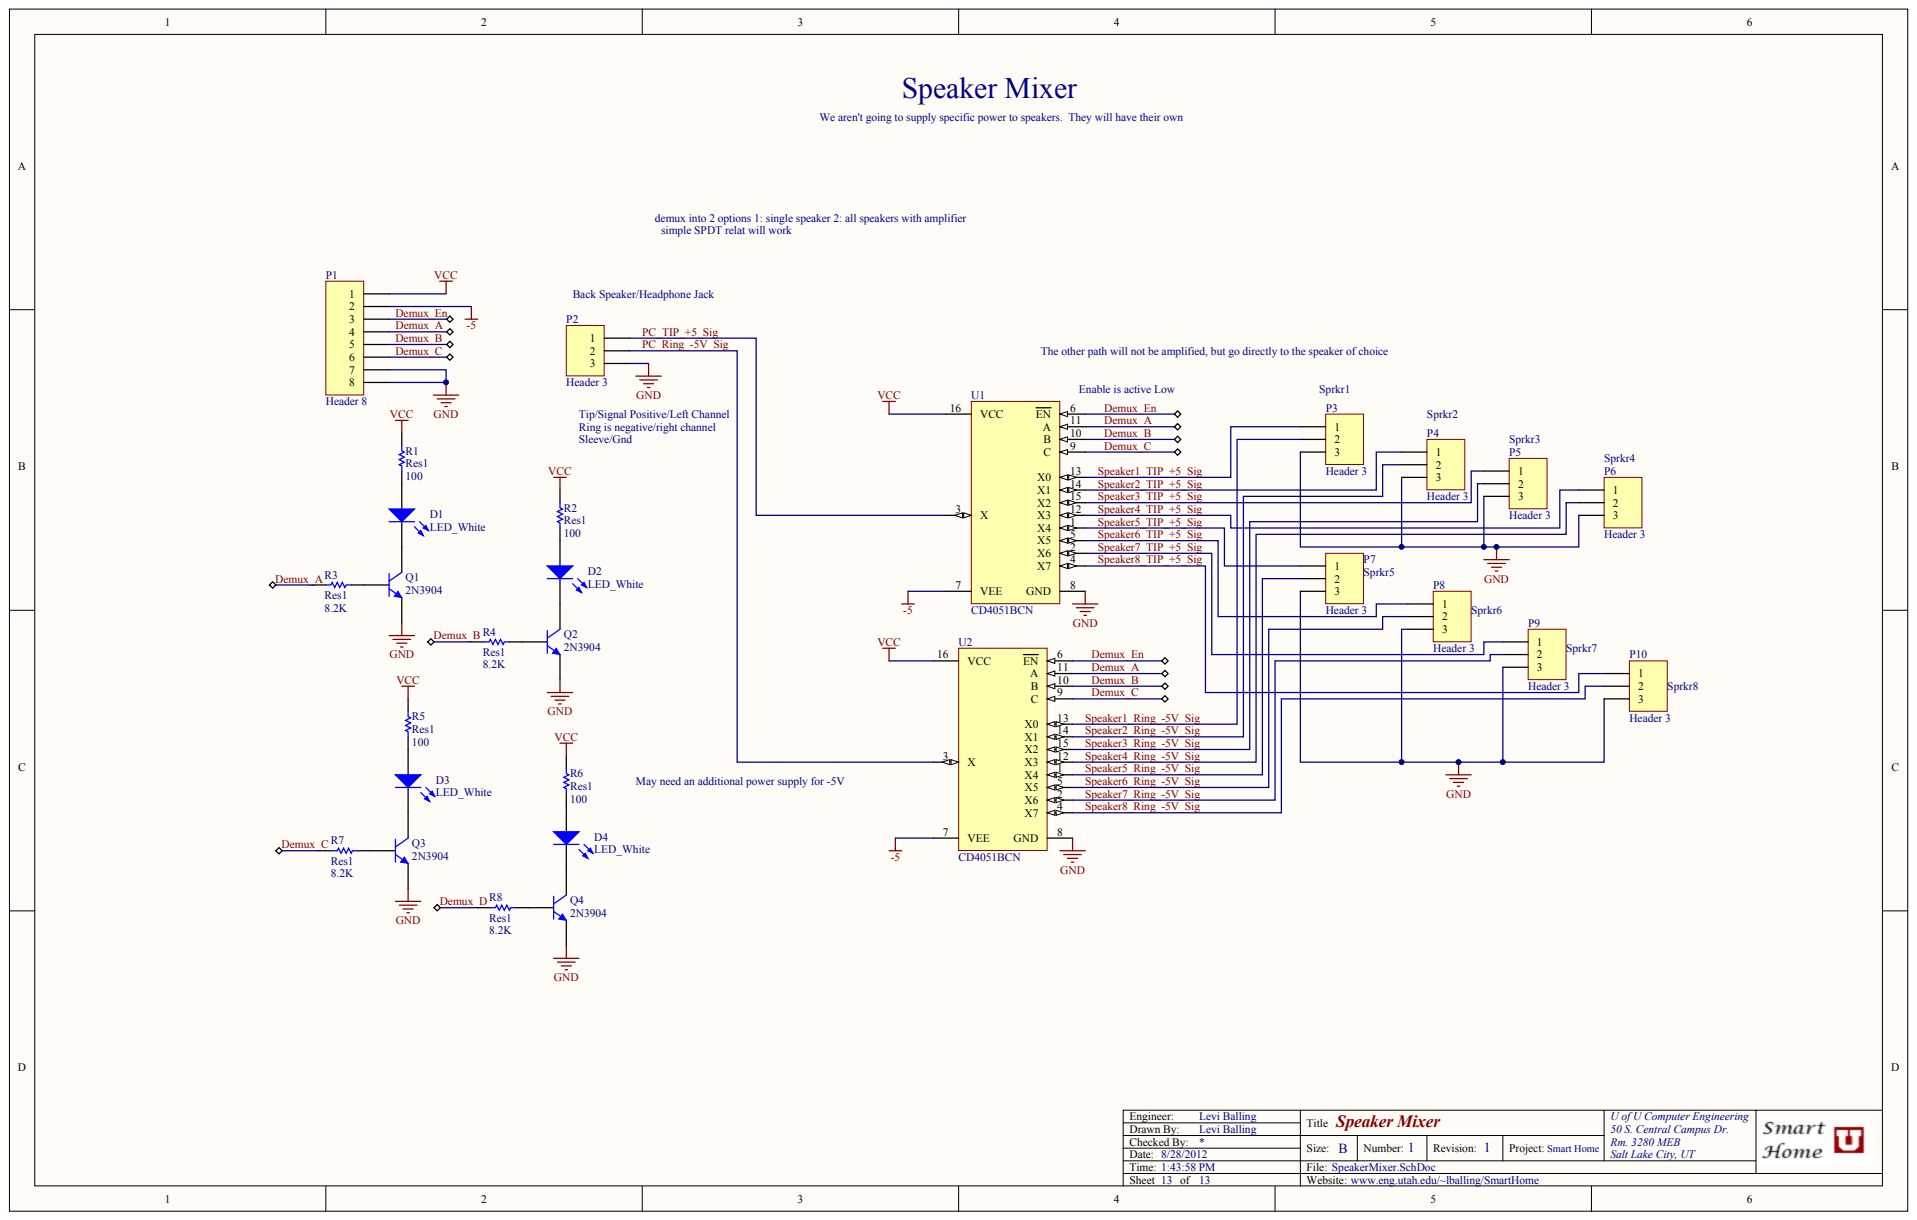
[picture p128: page 13]

We aren't going to supply specific power to speakers. They will have their own

demux into 2 options 1: single speaker 2: all speakers with amplifier
simple SPDT relat will work

Back Speaker/Headphone Jack

Demux_A Demux_B | 123 | PC_Ring_-5V_Sig

Demux_C | VCC

The other path will not be amplified, but go directly to the speaker of choice

Enable is active Low

Tip/Signal Positive/Left Channel
Ring is negative/right channel
Sleeve/Gnd

Speaker3_TIP_+5_Sig | Header 3
Speaker4_TIP_+5_Sig | | Header 3

VCC | | 1 Speaker5_TIP_+5_Sig

5 Speaker6_TIP_+5_Sig
2 Speaker7_TIP_+5_Sig

May need an additional power supply for -5V

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
