AshitakaLax/SmartHome/Website/SmartHome/documents/Holes/PrintingProject.PDF

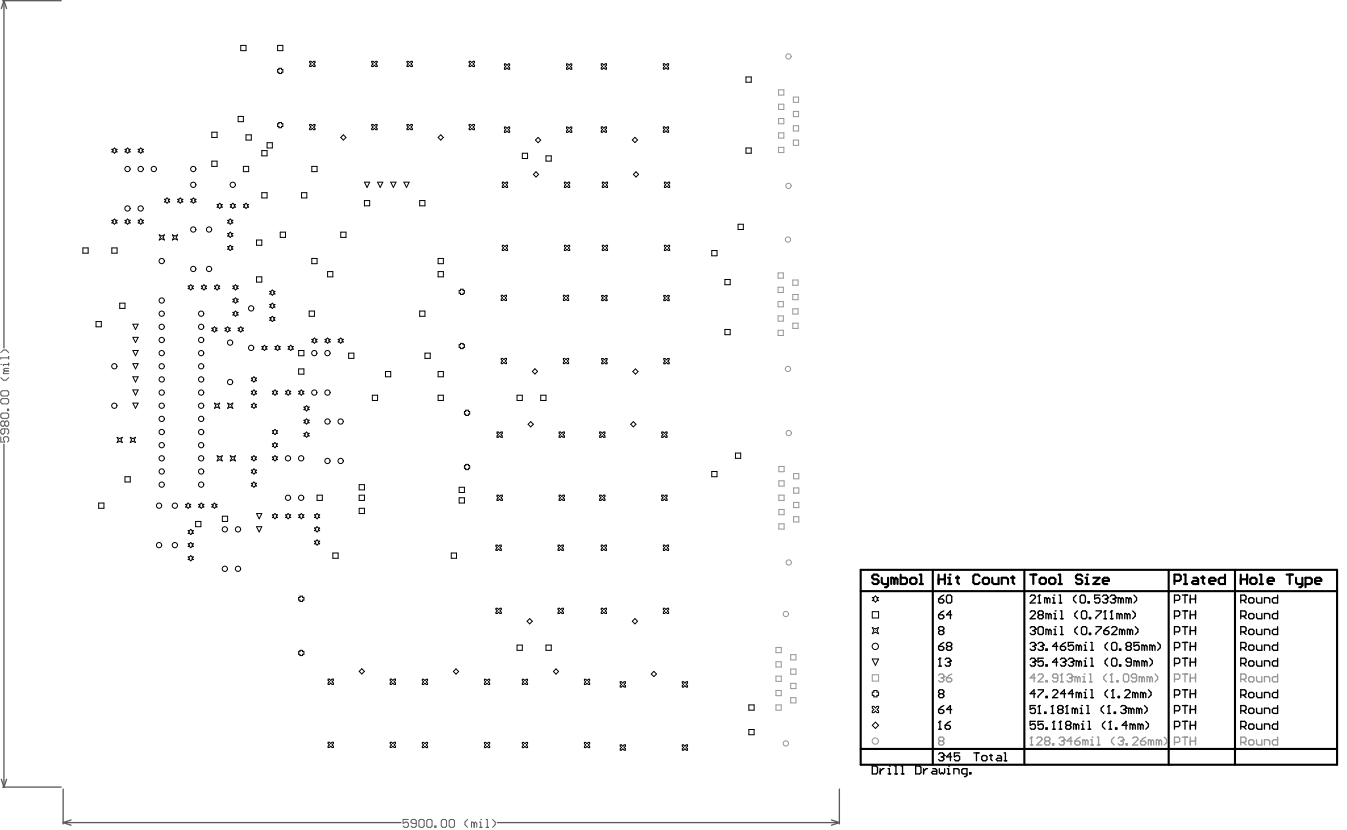
[picture p129: page 1]

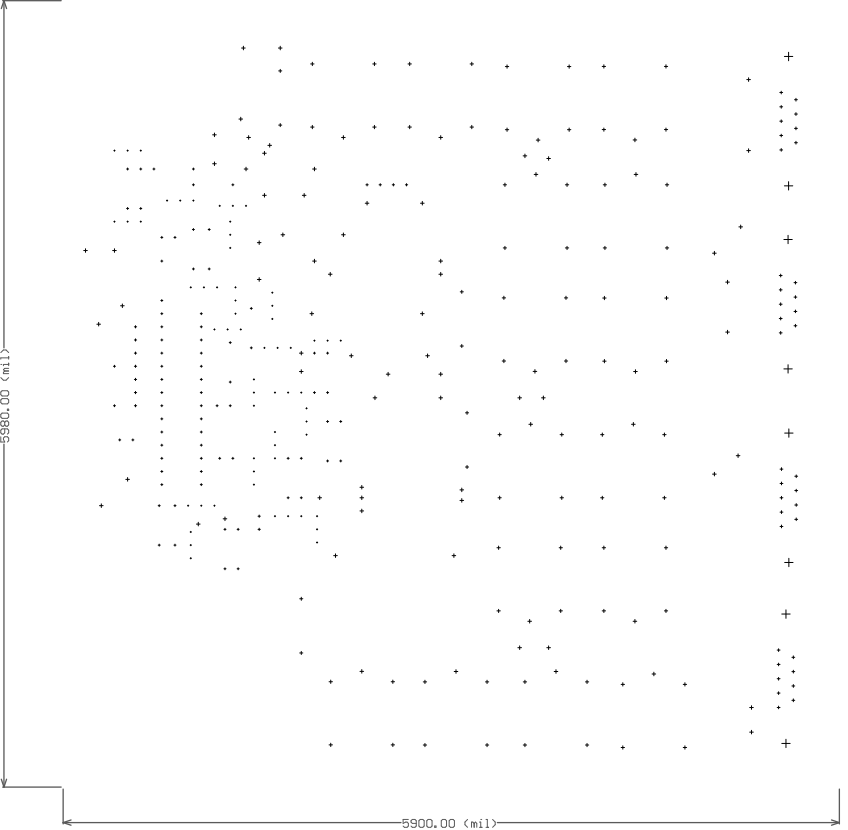
[picture p130: page 2]

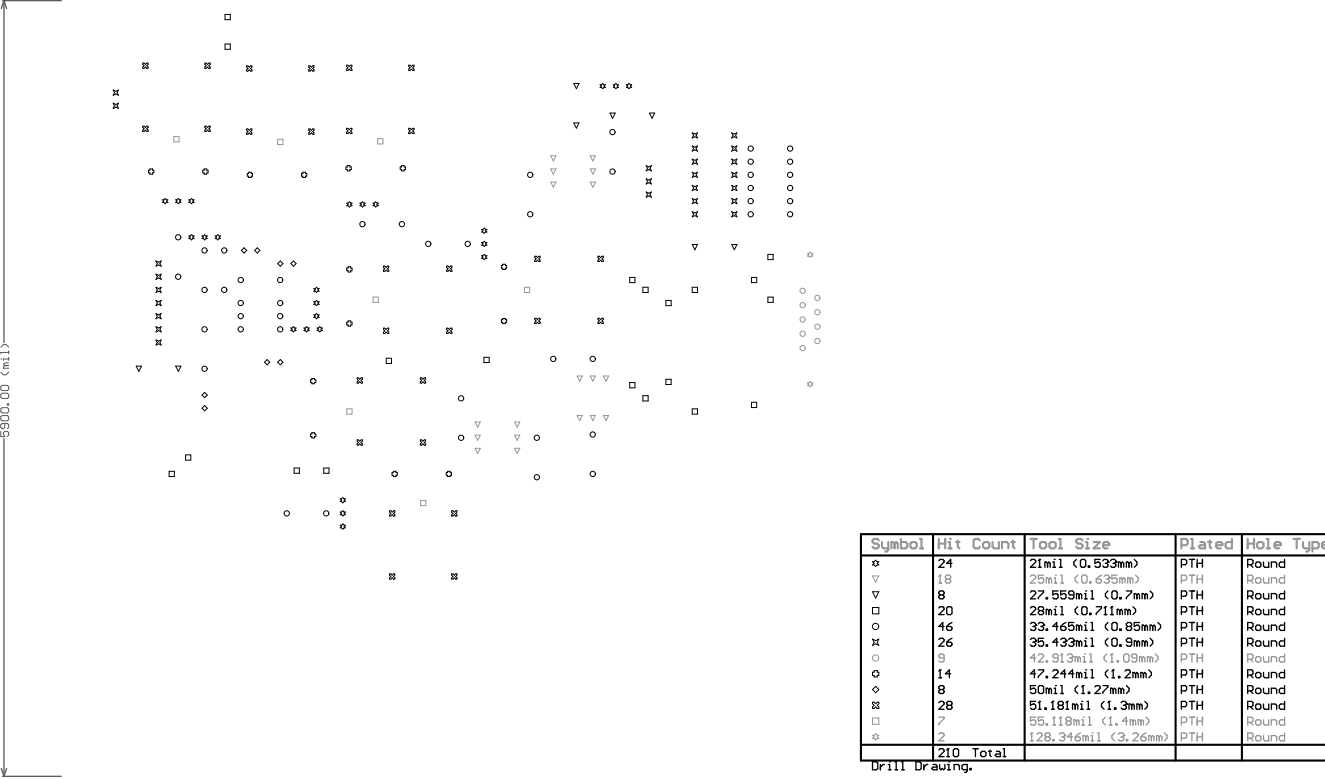
[picture p131: page 3]

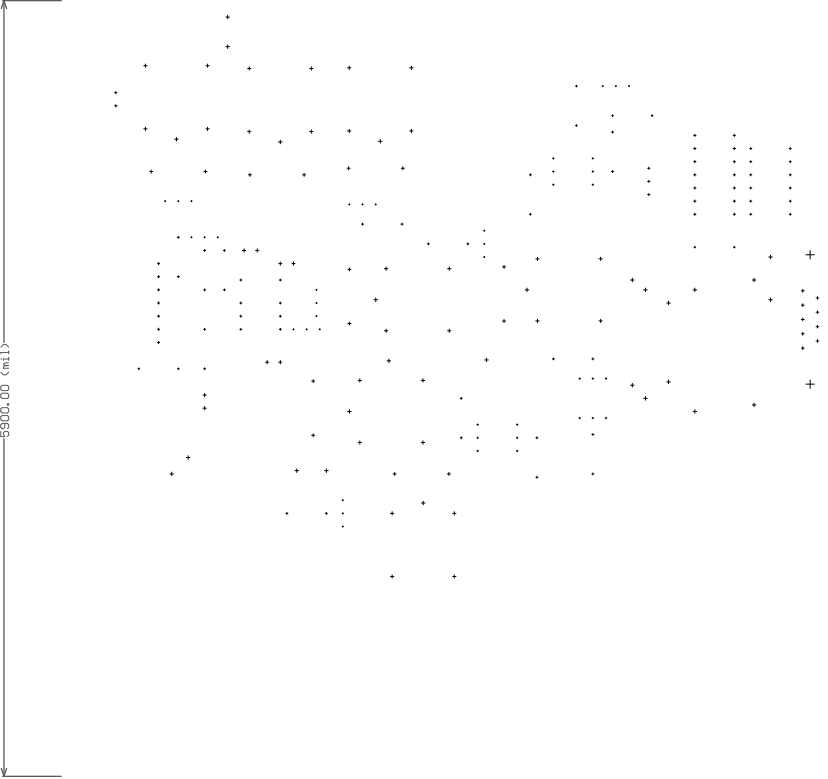
[picture p132: page 4]

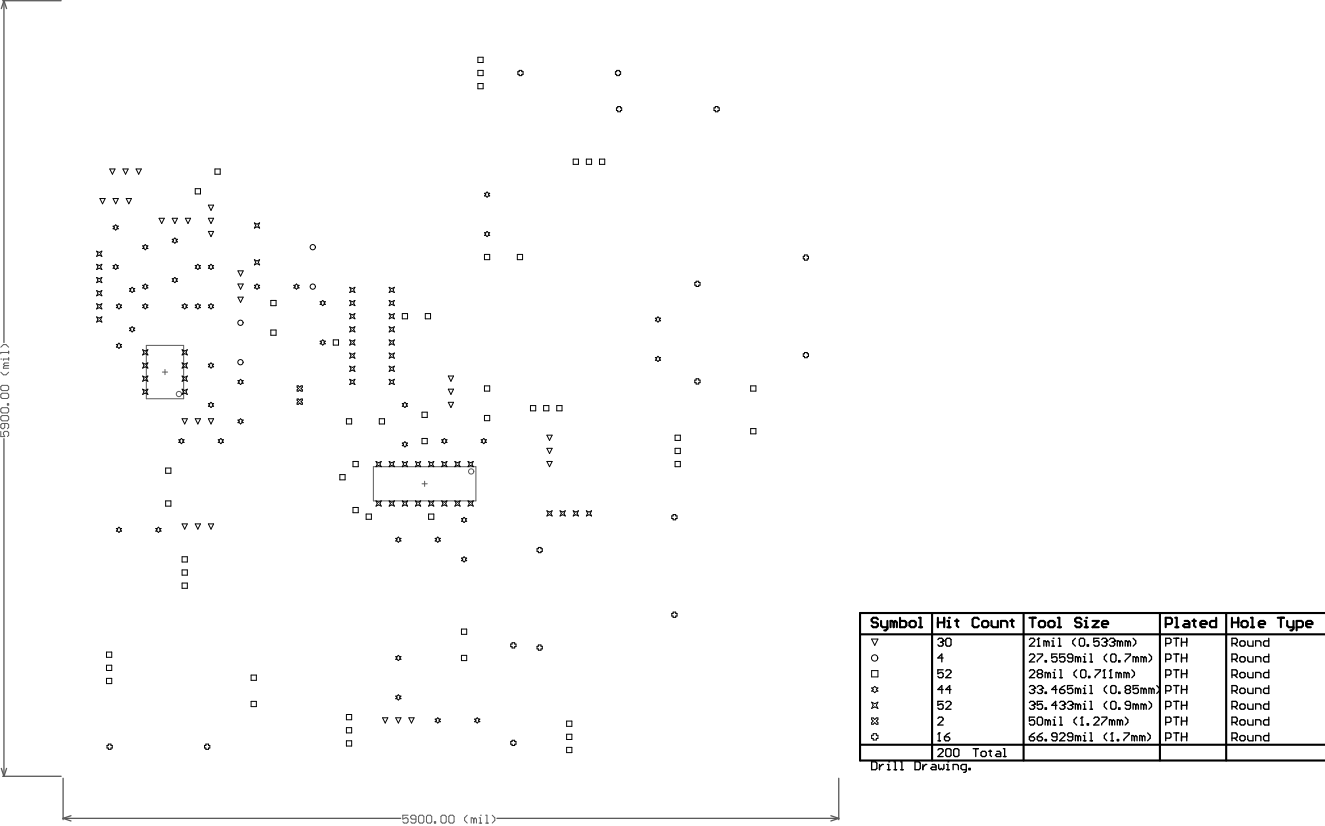
[picture p133: page 5]

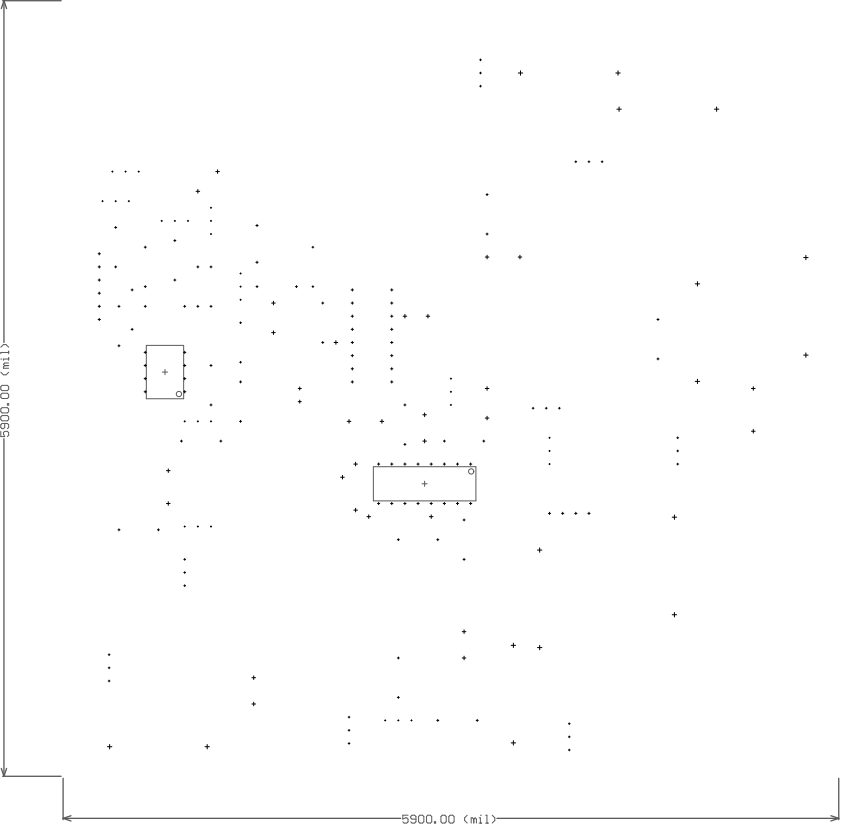
[picture p134: page 6]

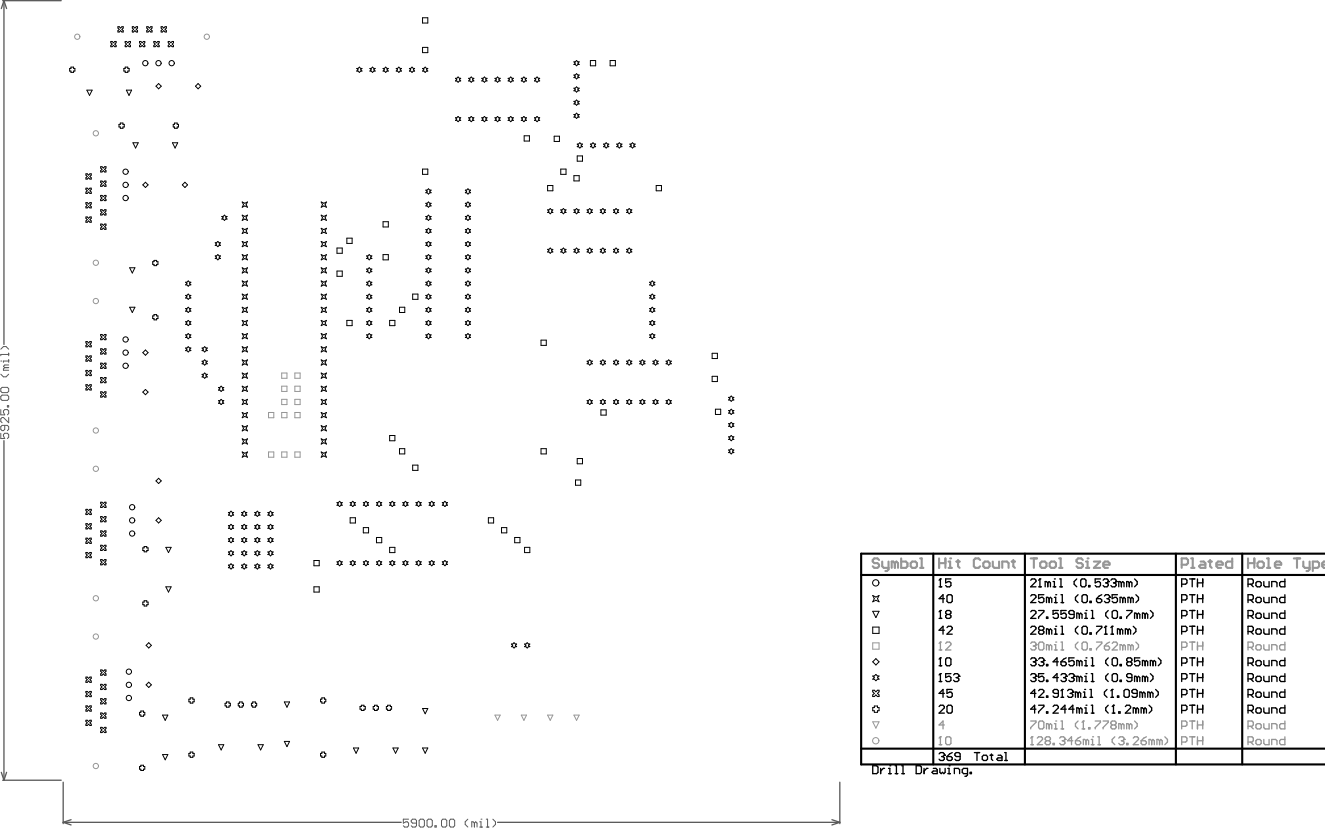
[picture p135: page 7]

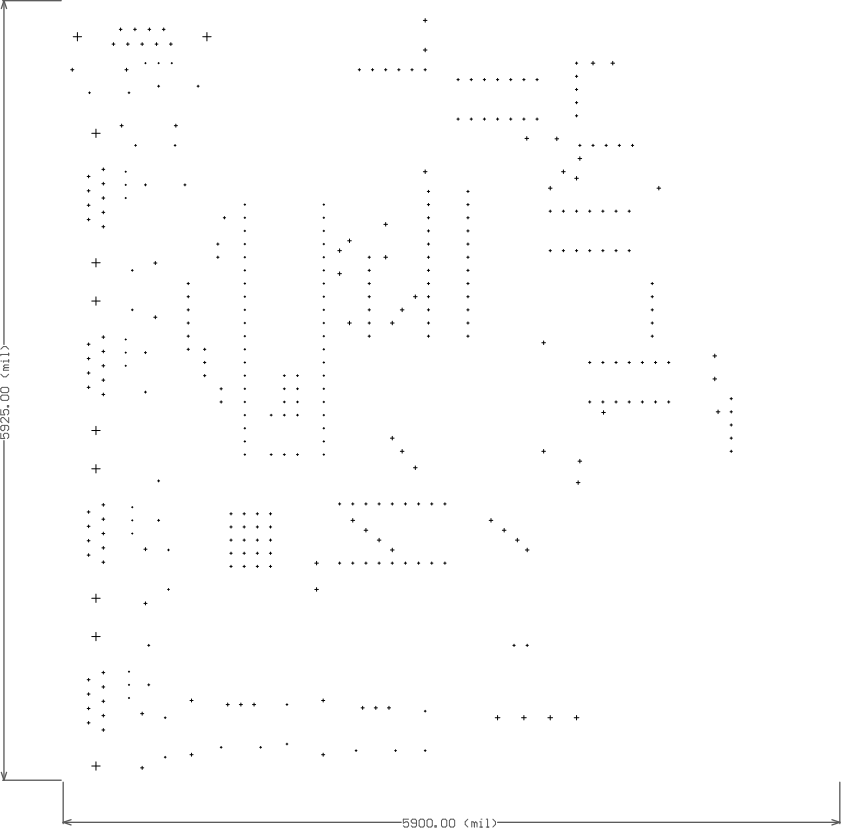
[picture p136: page 8]

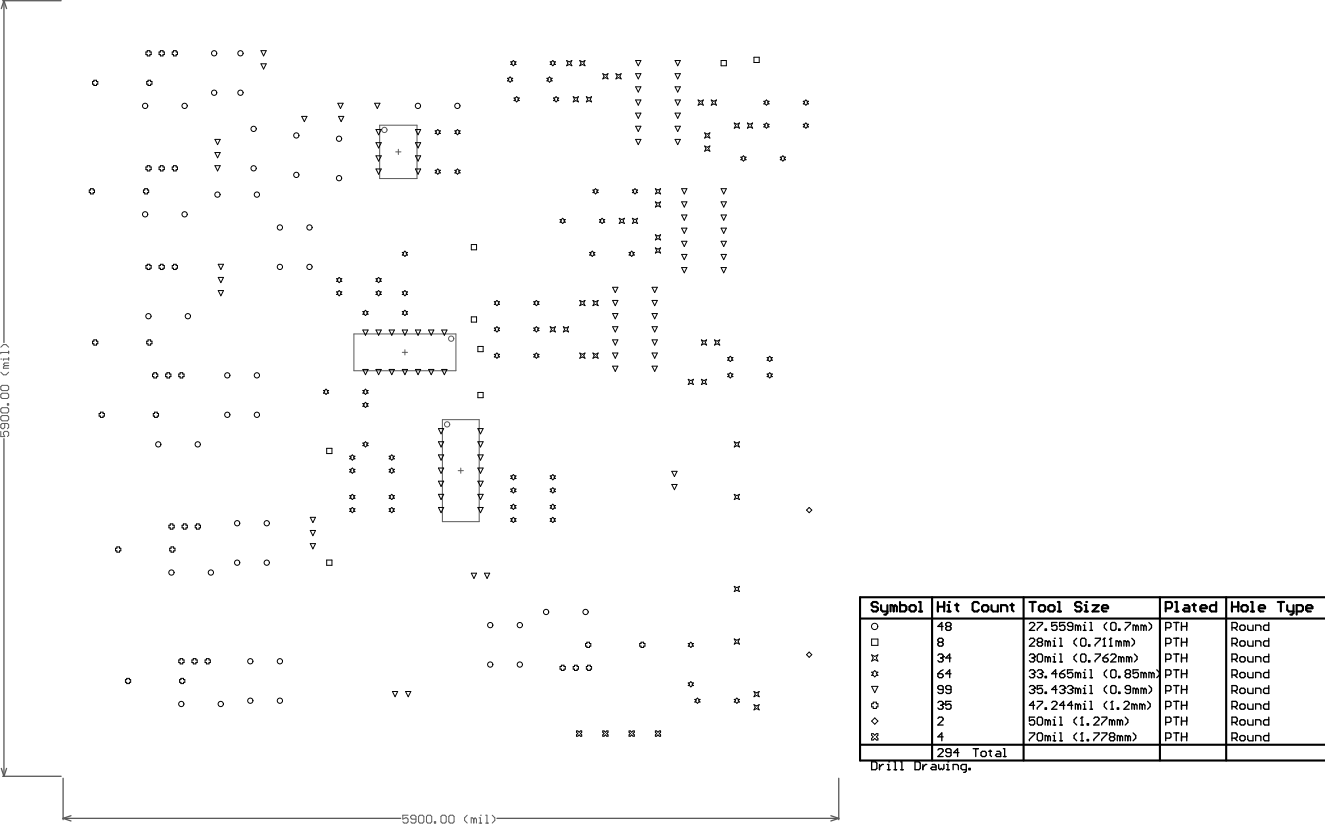
[picture p137: page 9]

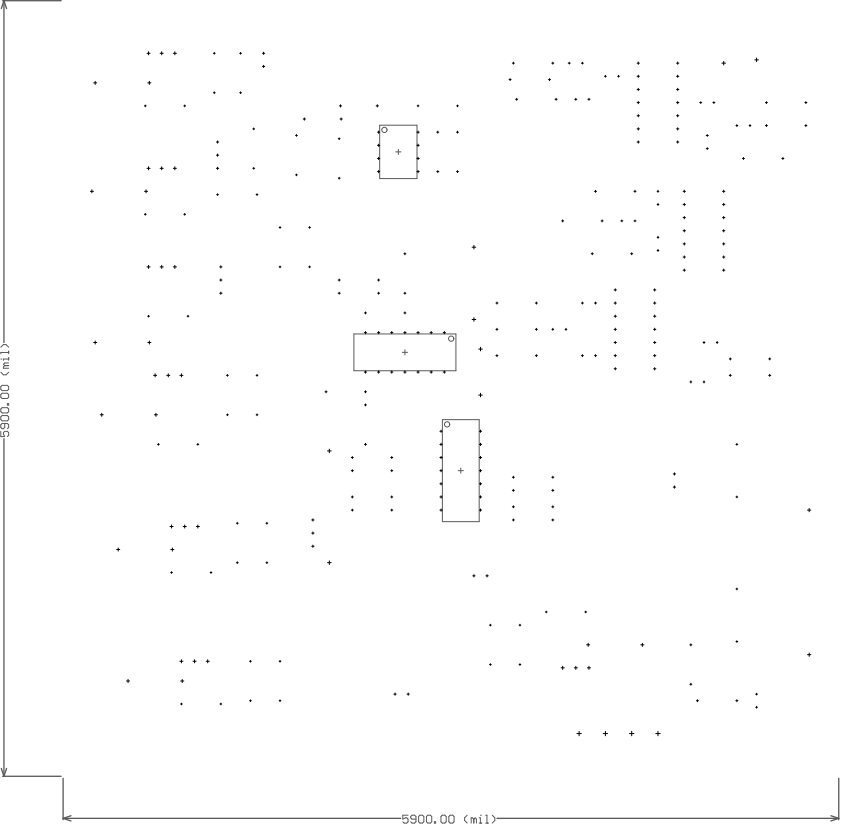
[picture p138: page 10]

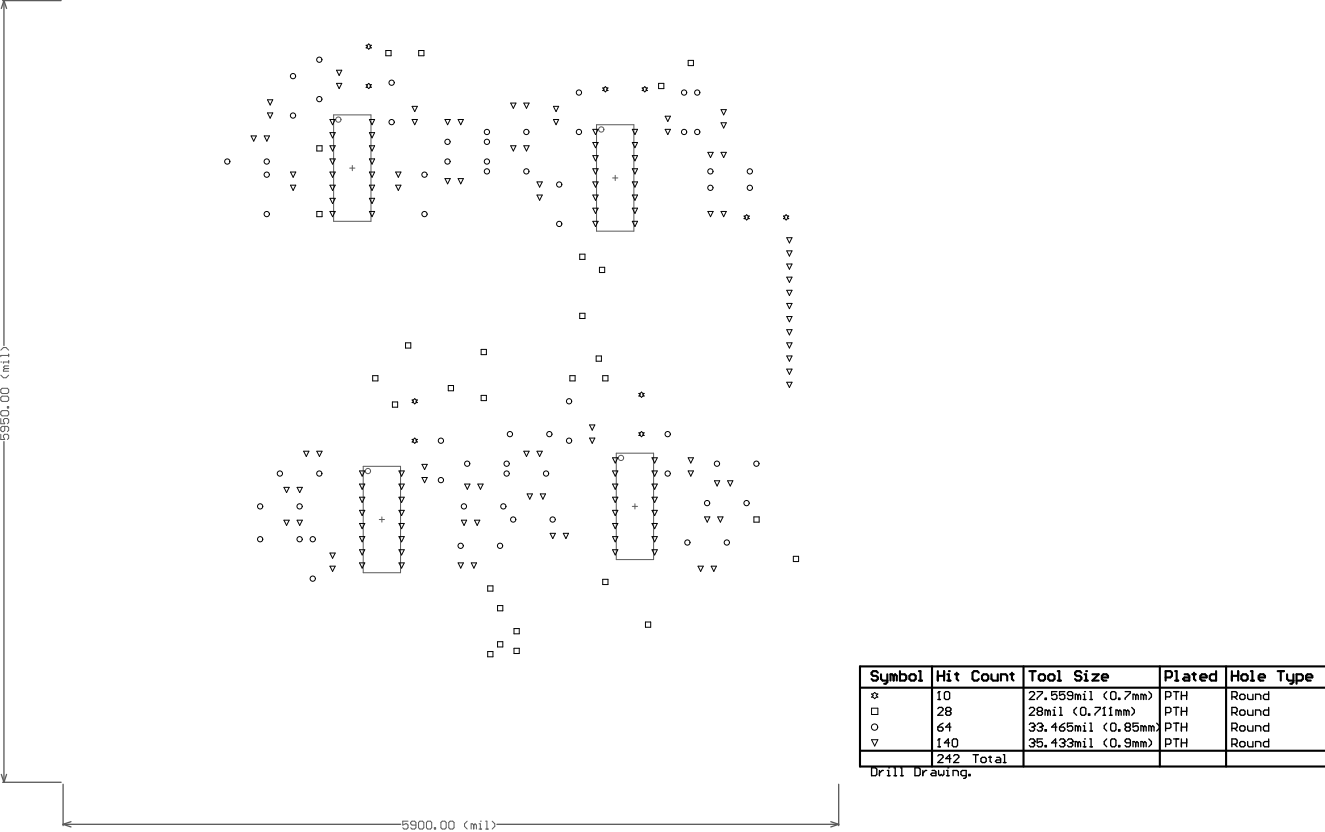
[picture p139: page 11]

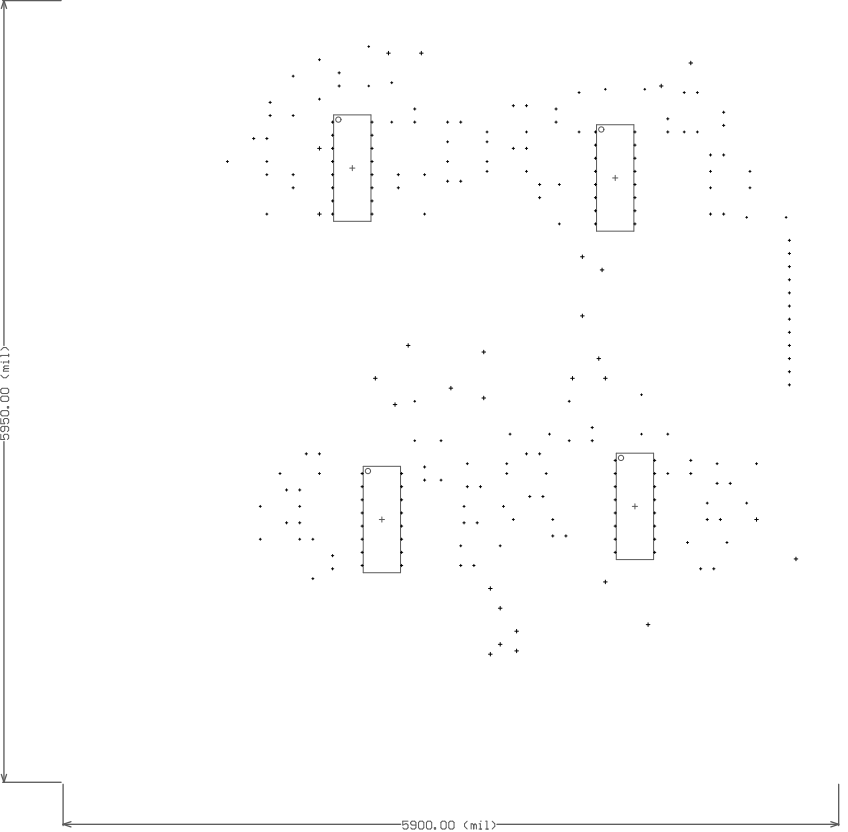
[picture p140: page 12]

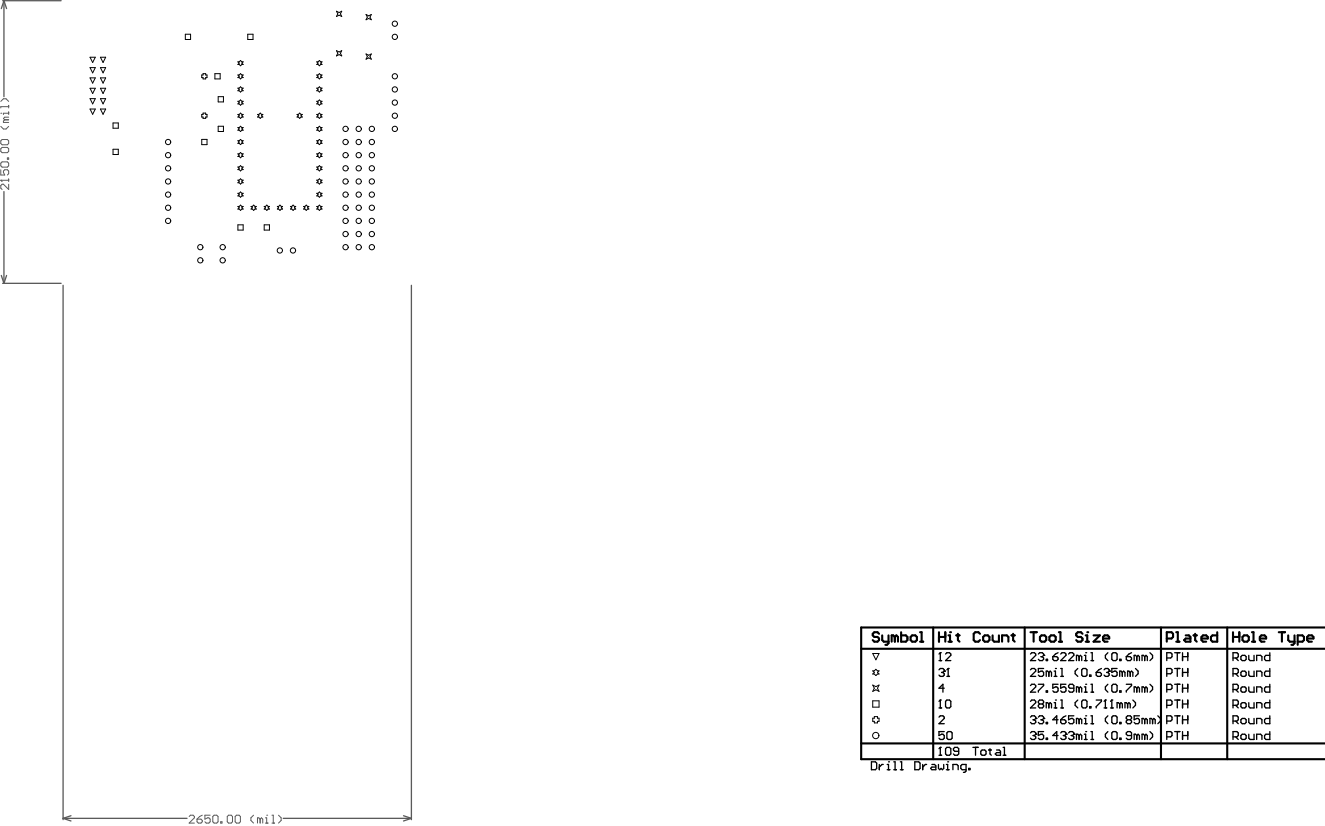
[picture p141: page 13]

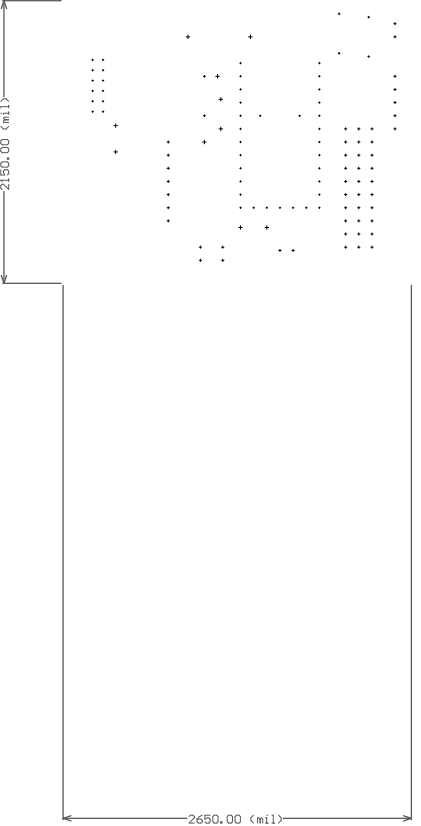
[picture p142: page 14]

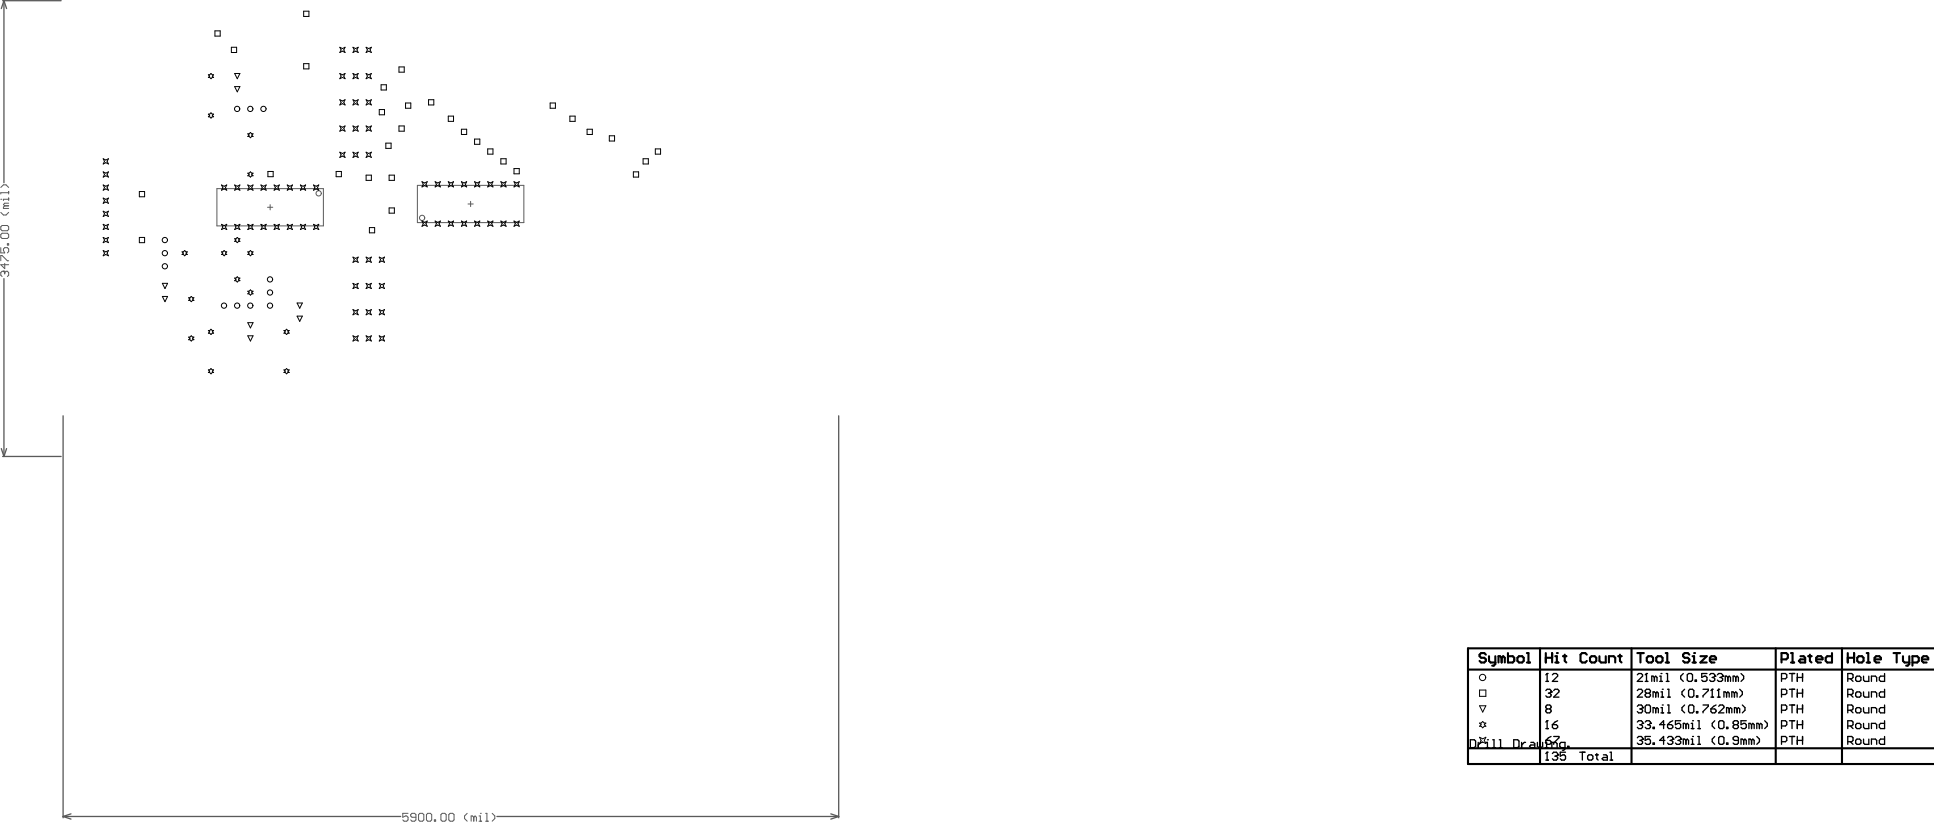
[picture p143: page 15]

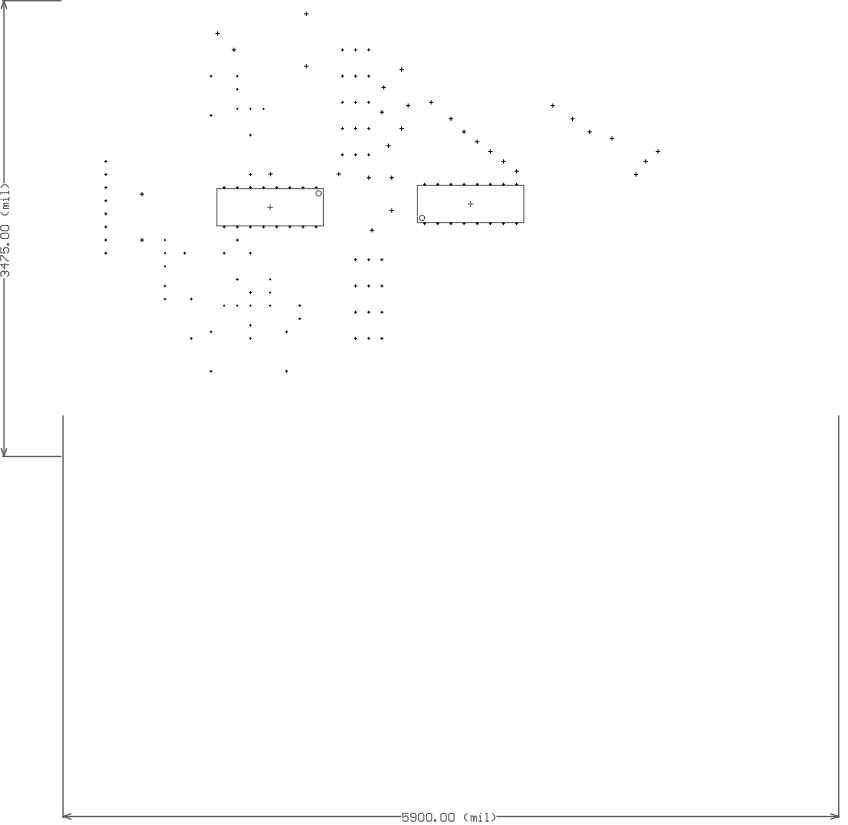
[picture p144: page 16]

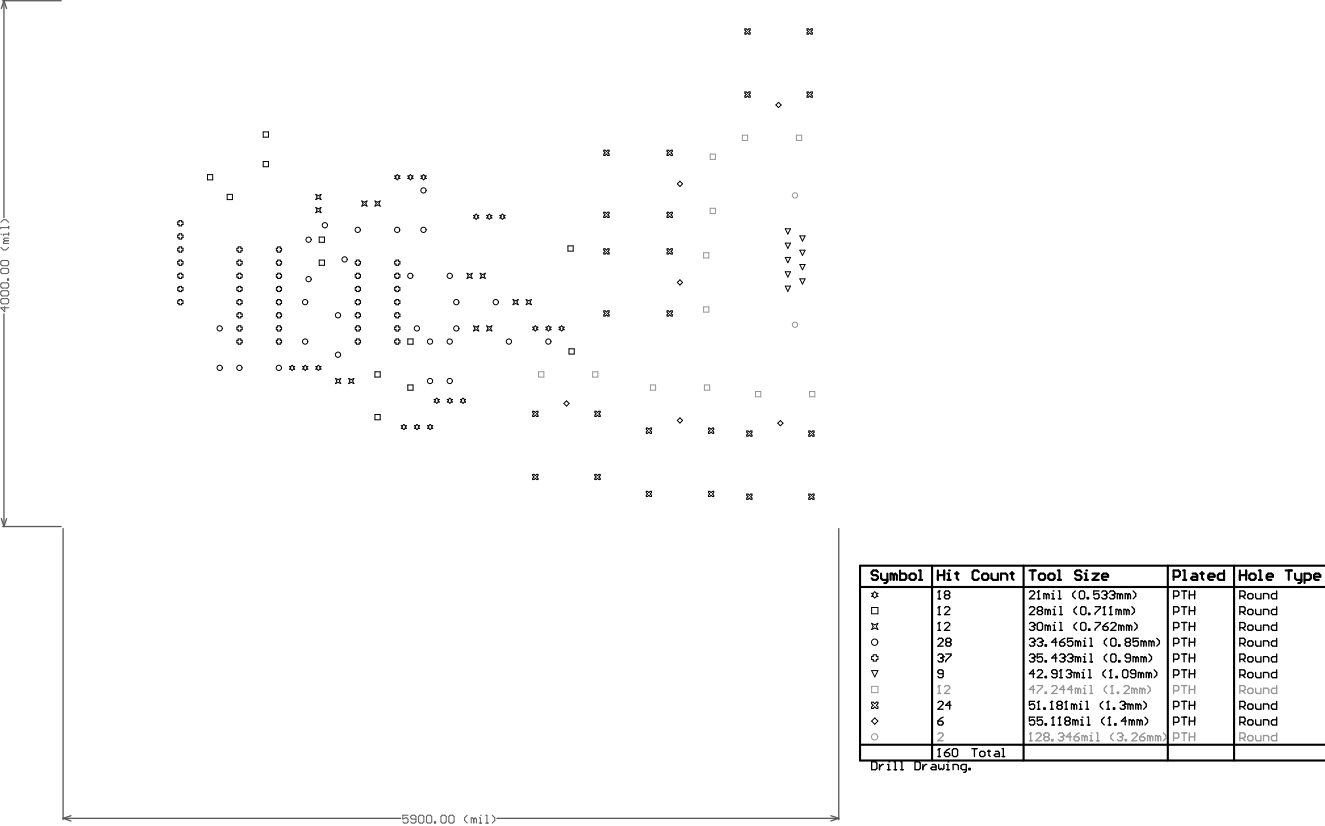
[picture p145: page 17]

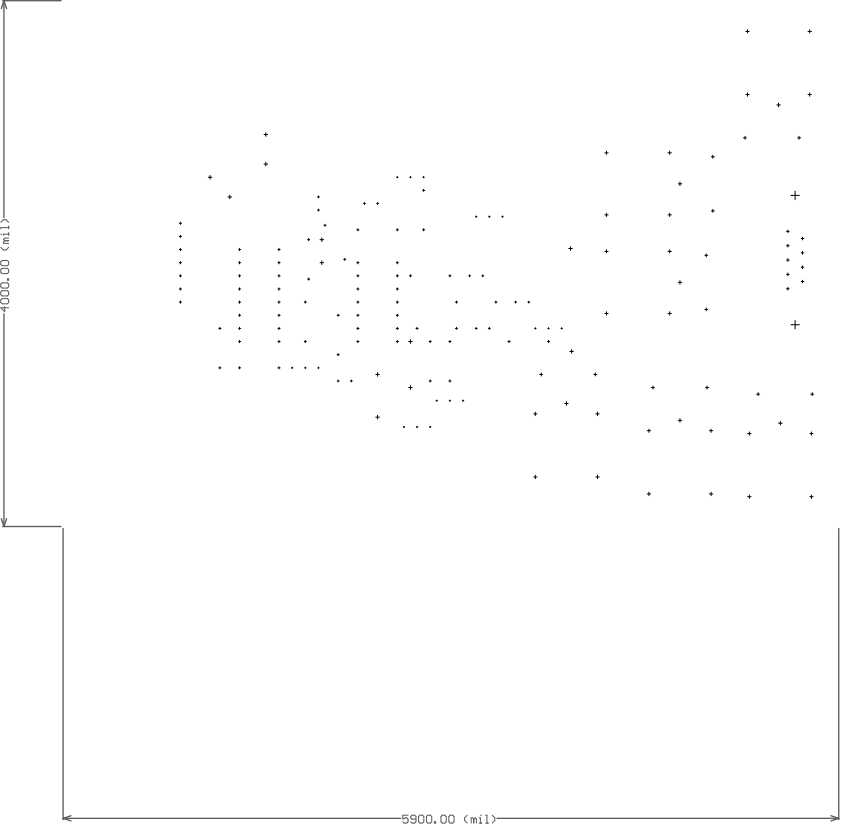
[picture p146: page 18]
