AshitakaLax/SmartHome/EpicCube/hardware/Epic Cube Design/Workspace/PCBs/PowerBoard.pdf

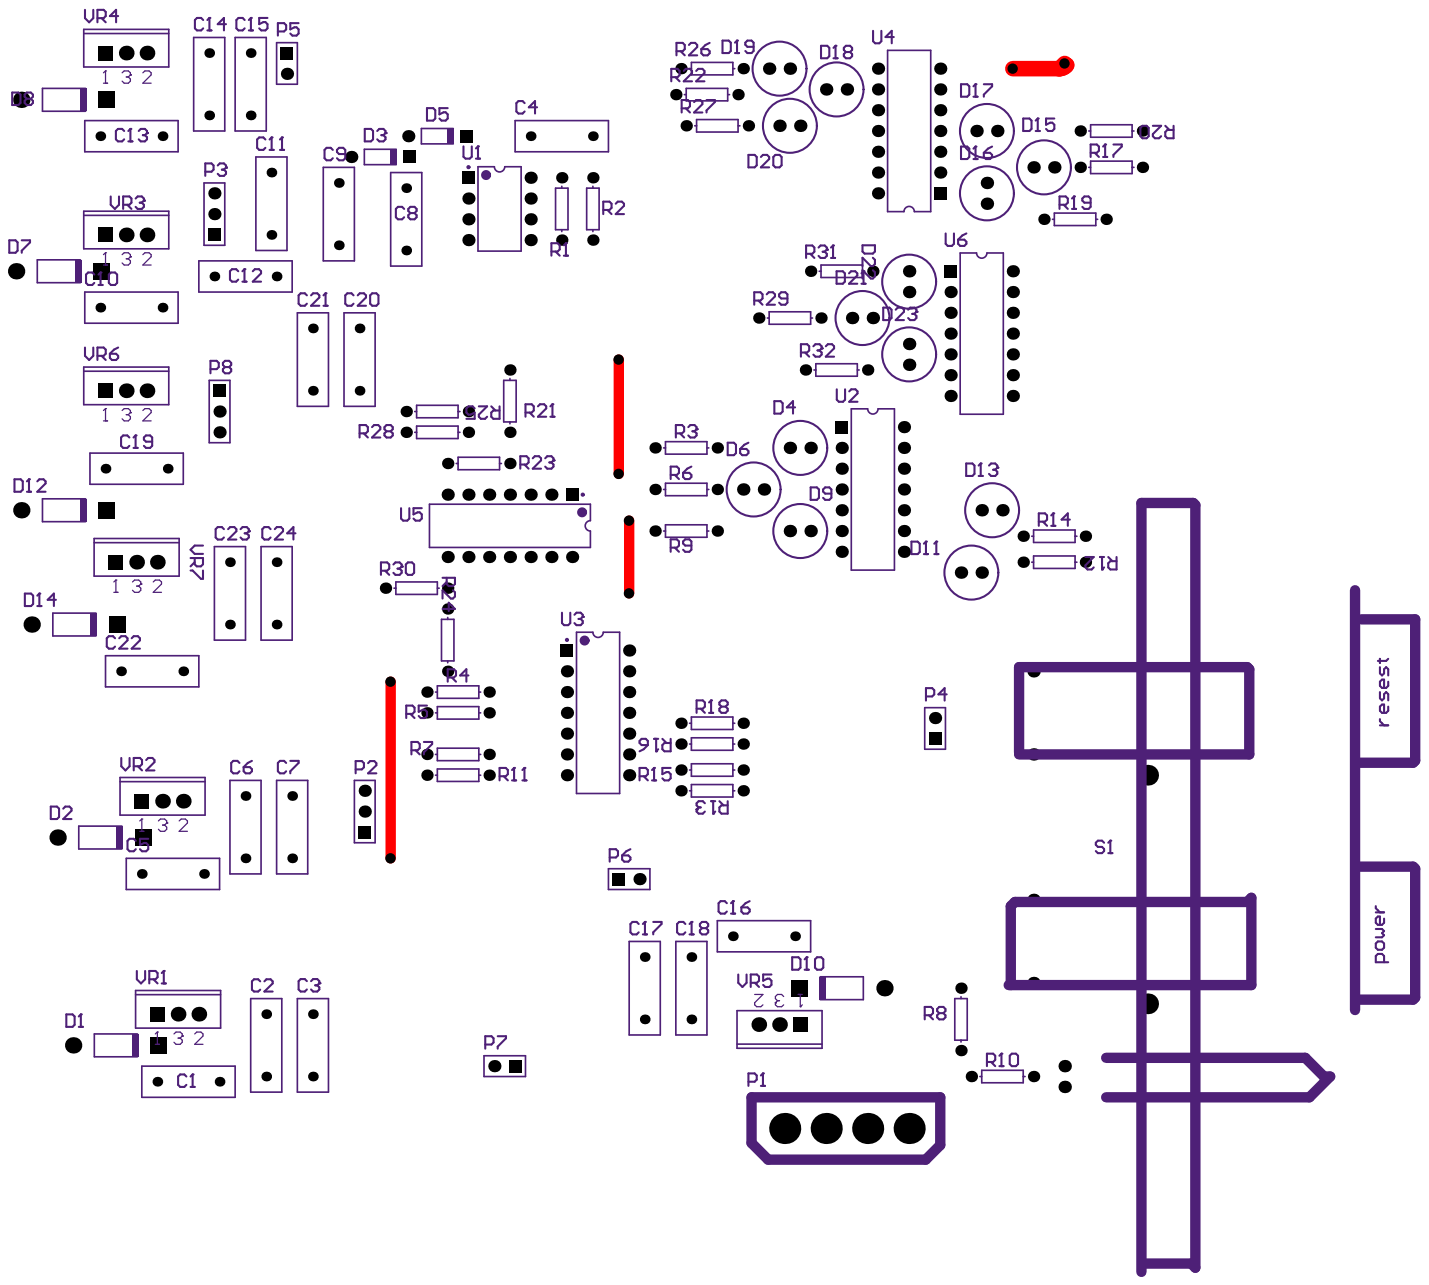
[picture p147: page 1]
