AshitakaLax/SmartHome/EpicCube/hardware/Epic Cube Design/OldControllerBoxInfo/DamperSection.pdf

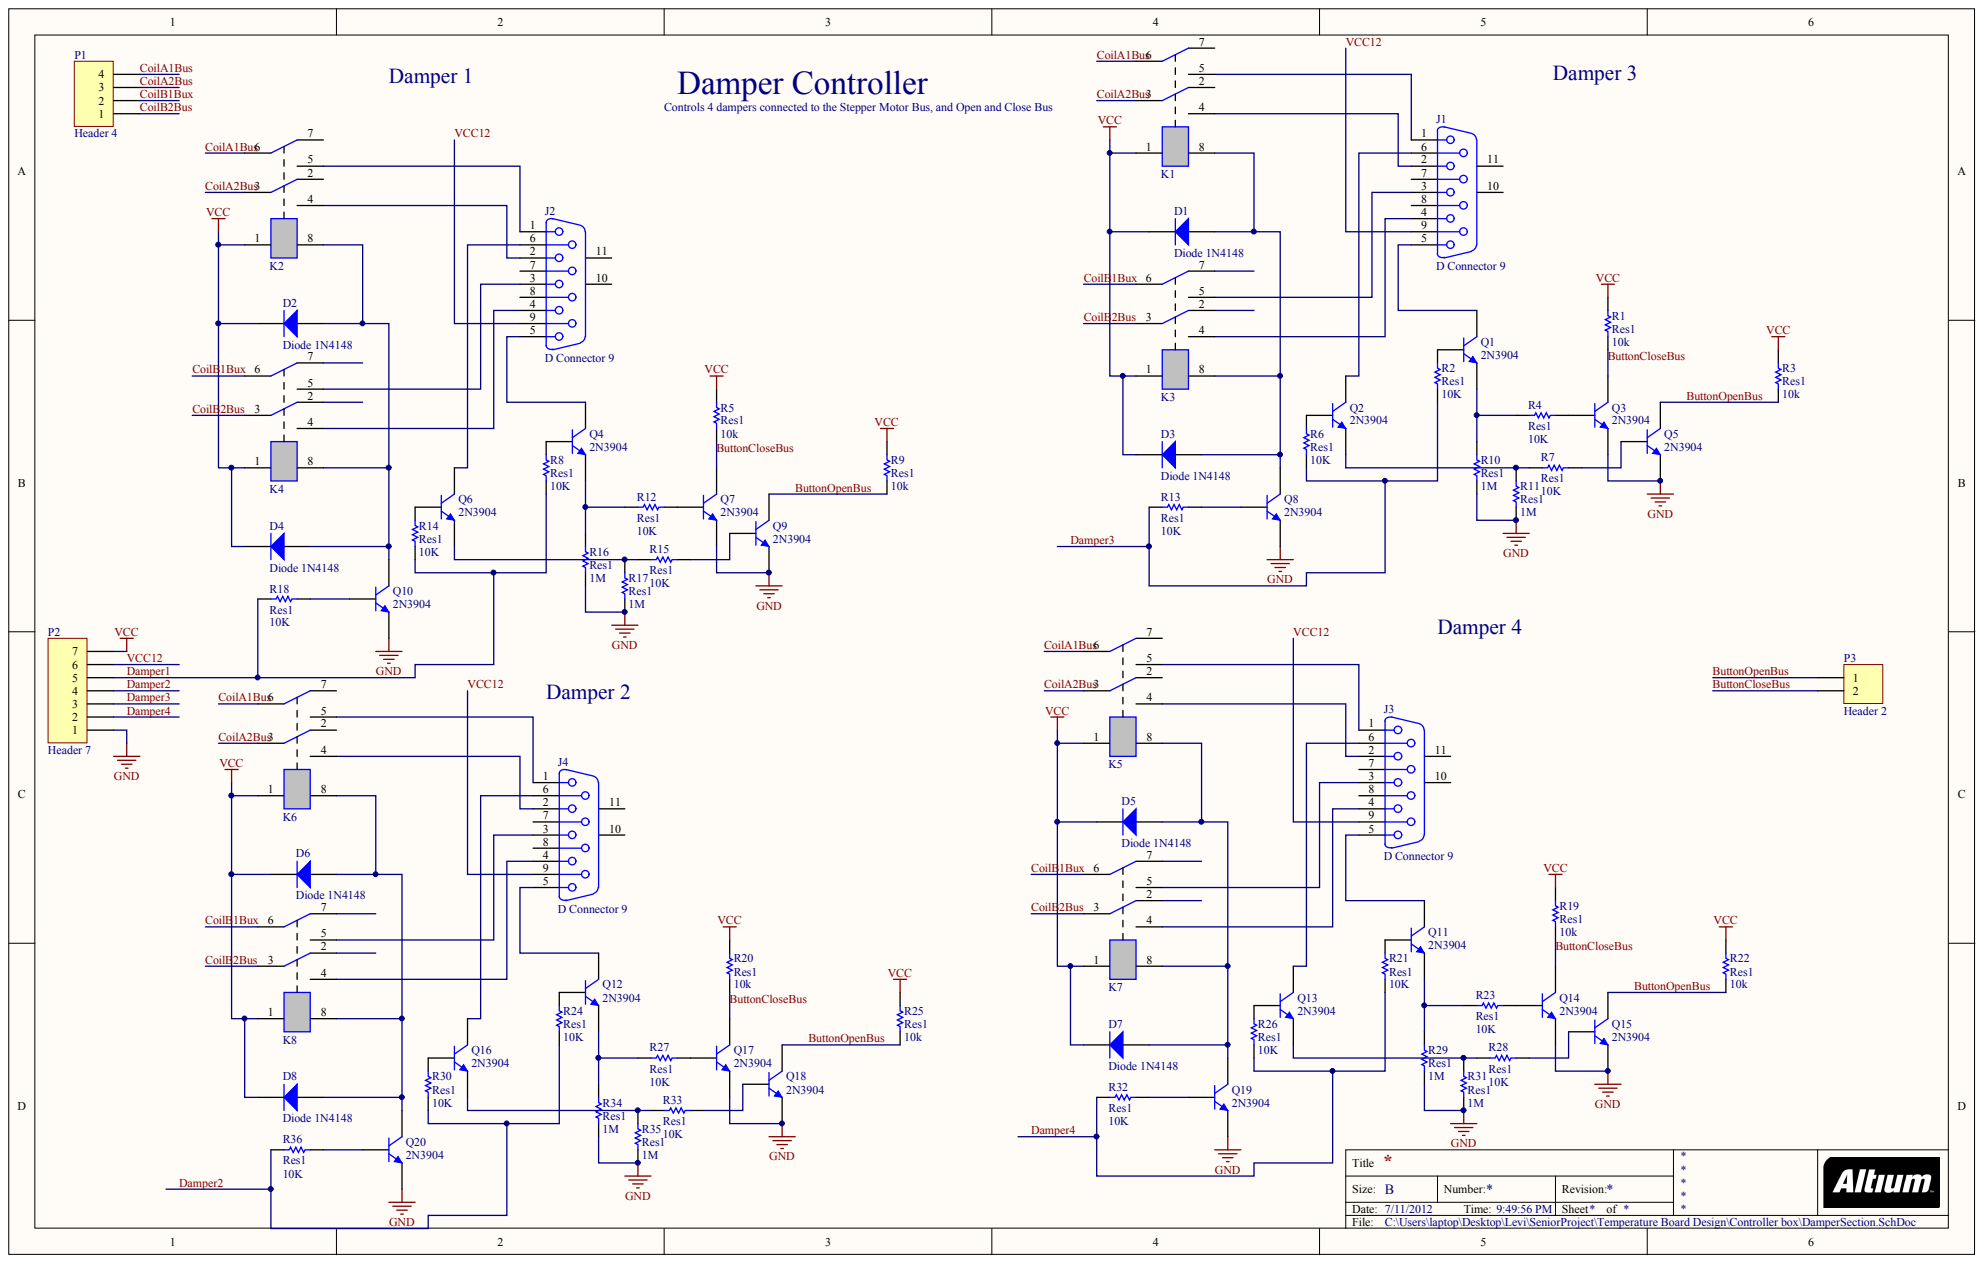
[picture p148: page 1]

Damper Controller Controls 4 dampers connected to the Stepper Motor Bus, and Open and Close Bus

* Title | * * * * *

Size: B | Number: * | Revision: *

Date: 7/11/2012 Time: 9:49:56 PM | | Sheet * of *
File: C:\Users\laptop\Desktop\Levi\SeniorProject\Temperature Board Design\Controller box\DamperSection.SchDoc
