AshitakaLax/SmartHome/EpicCube/hardware/Epic Cube Design/OldControllerBoxInfo/MainController.pdf

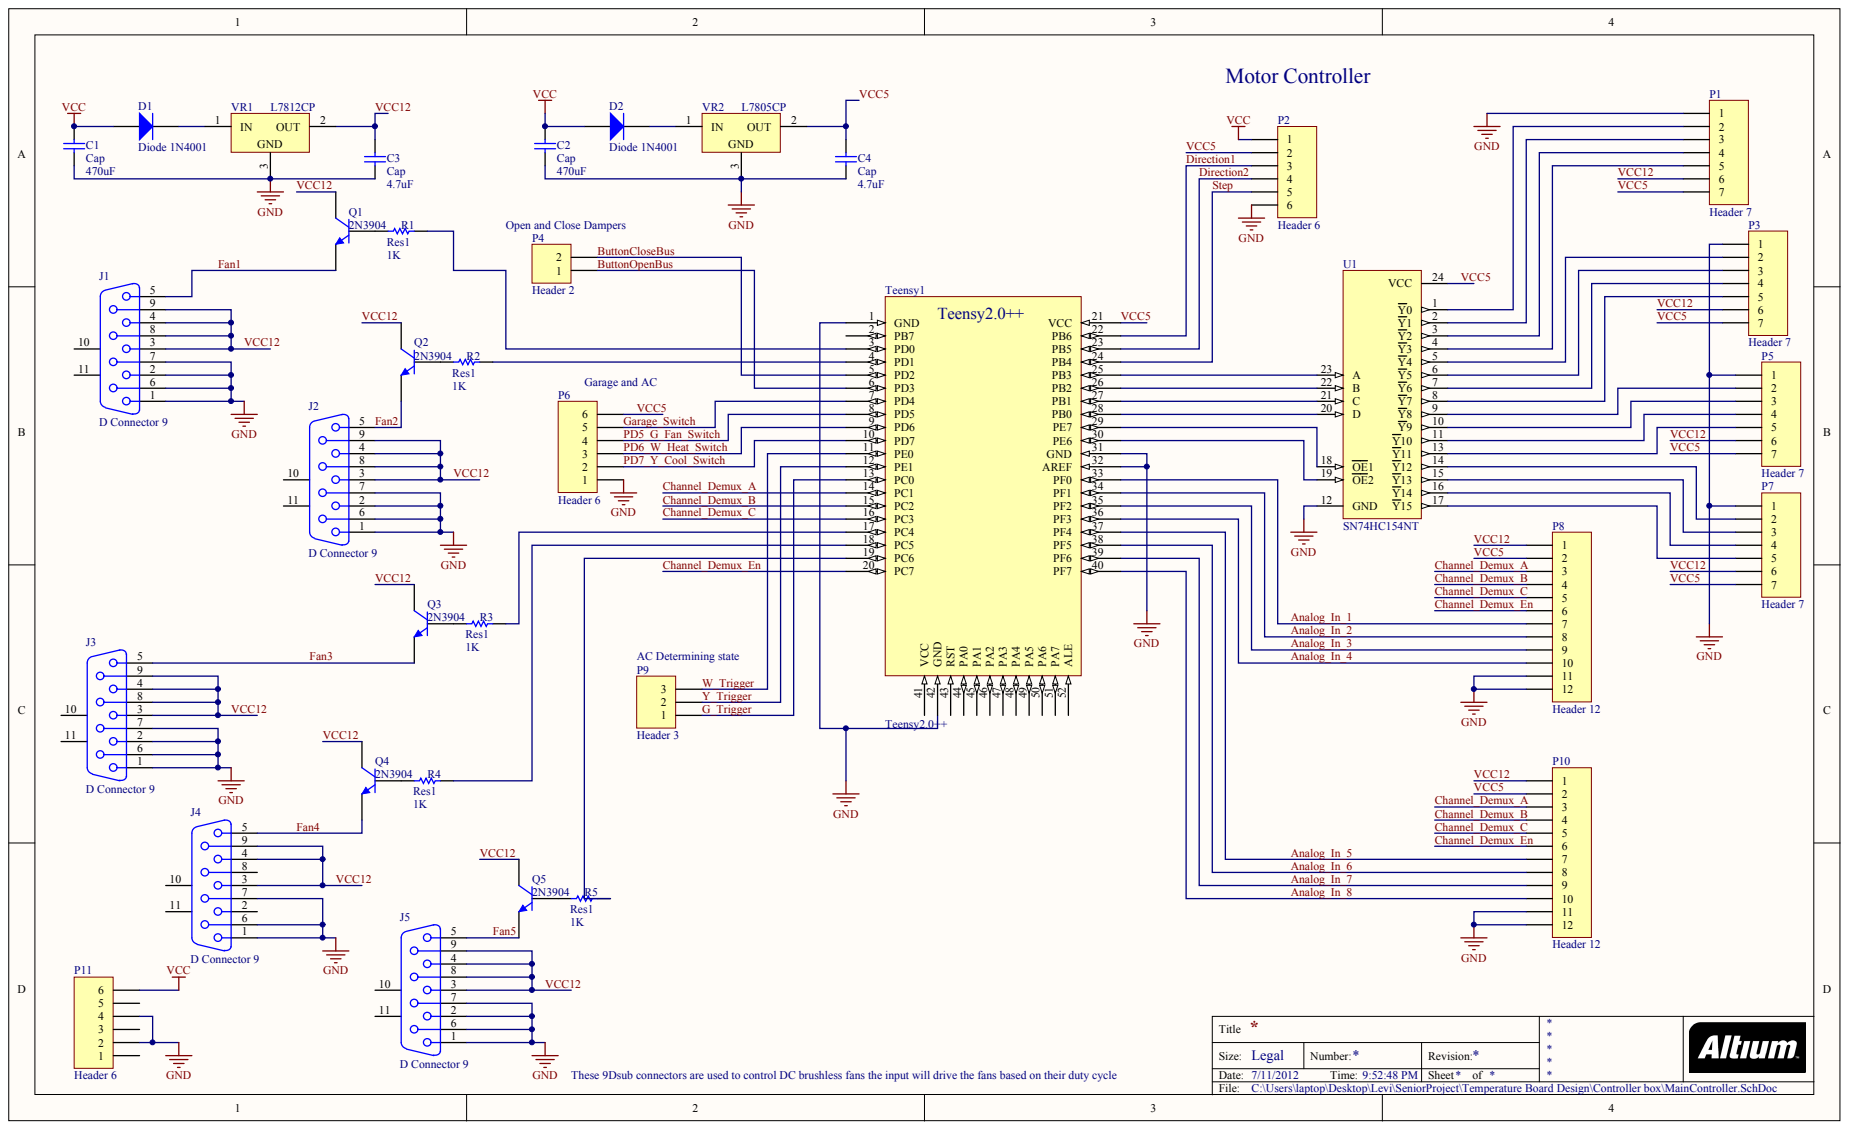
[picture p149: page 1]

Channel_Demux_B Channel_Demux_C Channel_Demux_E Analog_In_1 | n

GND Analog_In_3

Analog_In_2

Analog_In_4

Analog_In_6
Analog_In_7

Title * | **** *

Size: Legal | Number: * | Revision: *

These 9Dsub connectors are used to control DC brushles

s fans the input will drive the fans based on their duty cycle

Date:
C:\Users\laptop\Desktop\Levi\SeniorProject\Temperature Board Design\Controller box\MainController.SchDoc
File:
