AshitakaLax/SmartHome/EpicCube/hardware/Epic Cube Design/OldControllerBoxInfo/MotorController.pdf

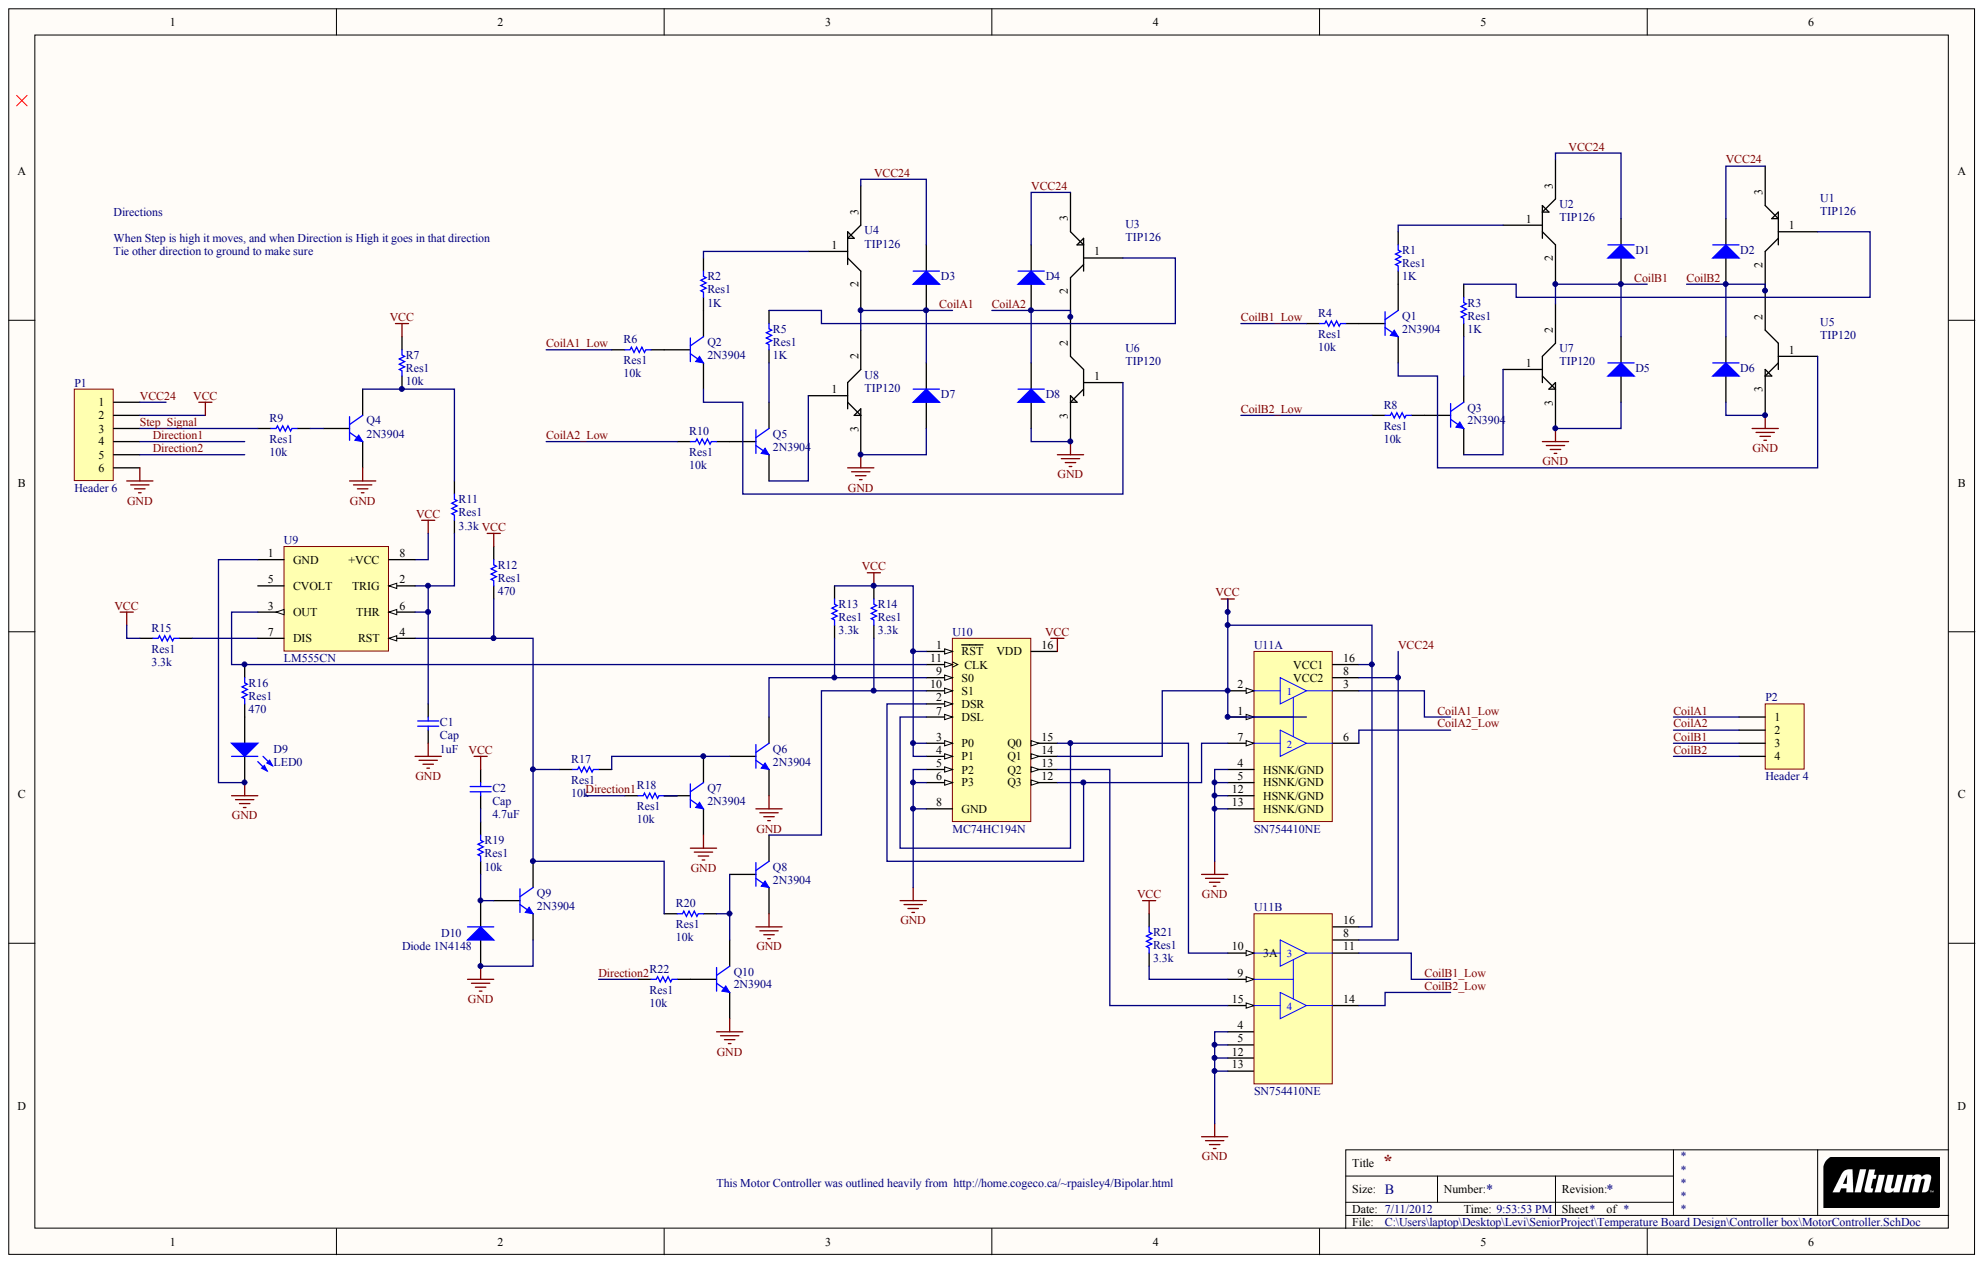
[picture p150: page 1]

8 | VCC GN R21 Res1

HSN K/ HSN K/ HSN K/ | Coi

Coi

B This Motor Controller was outlined heavily from http://home.cogeco.ca/~rpaisley4/Bipolar.html

Size: | Number: * | Revision: *

Date: 7/11/2012 Ti me: 9:53:53 PM | | Sheet * of *
Fi le: C: \Users\ laptop\ Desktop\Levi \SeniorProject\Temperature Board Design\Control ler box\MotorControl | ler.SchDoc
