AshitakaLax/SmartHome/EpicCube/hardware/Epic Cube Design/OldControllerBoxInfo/MotorControllerBox.pdf

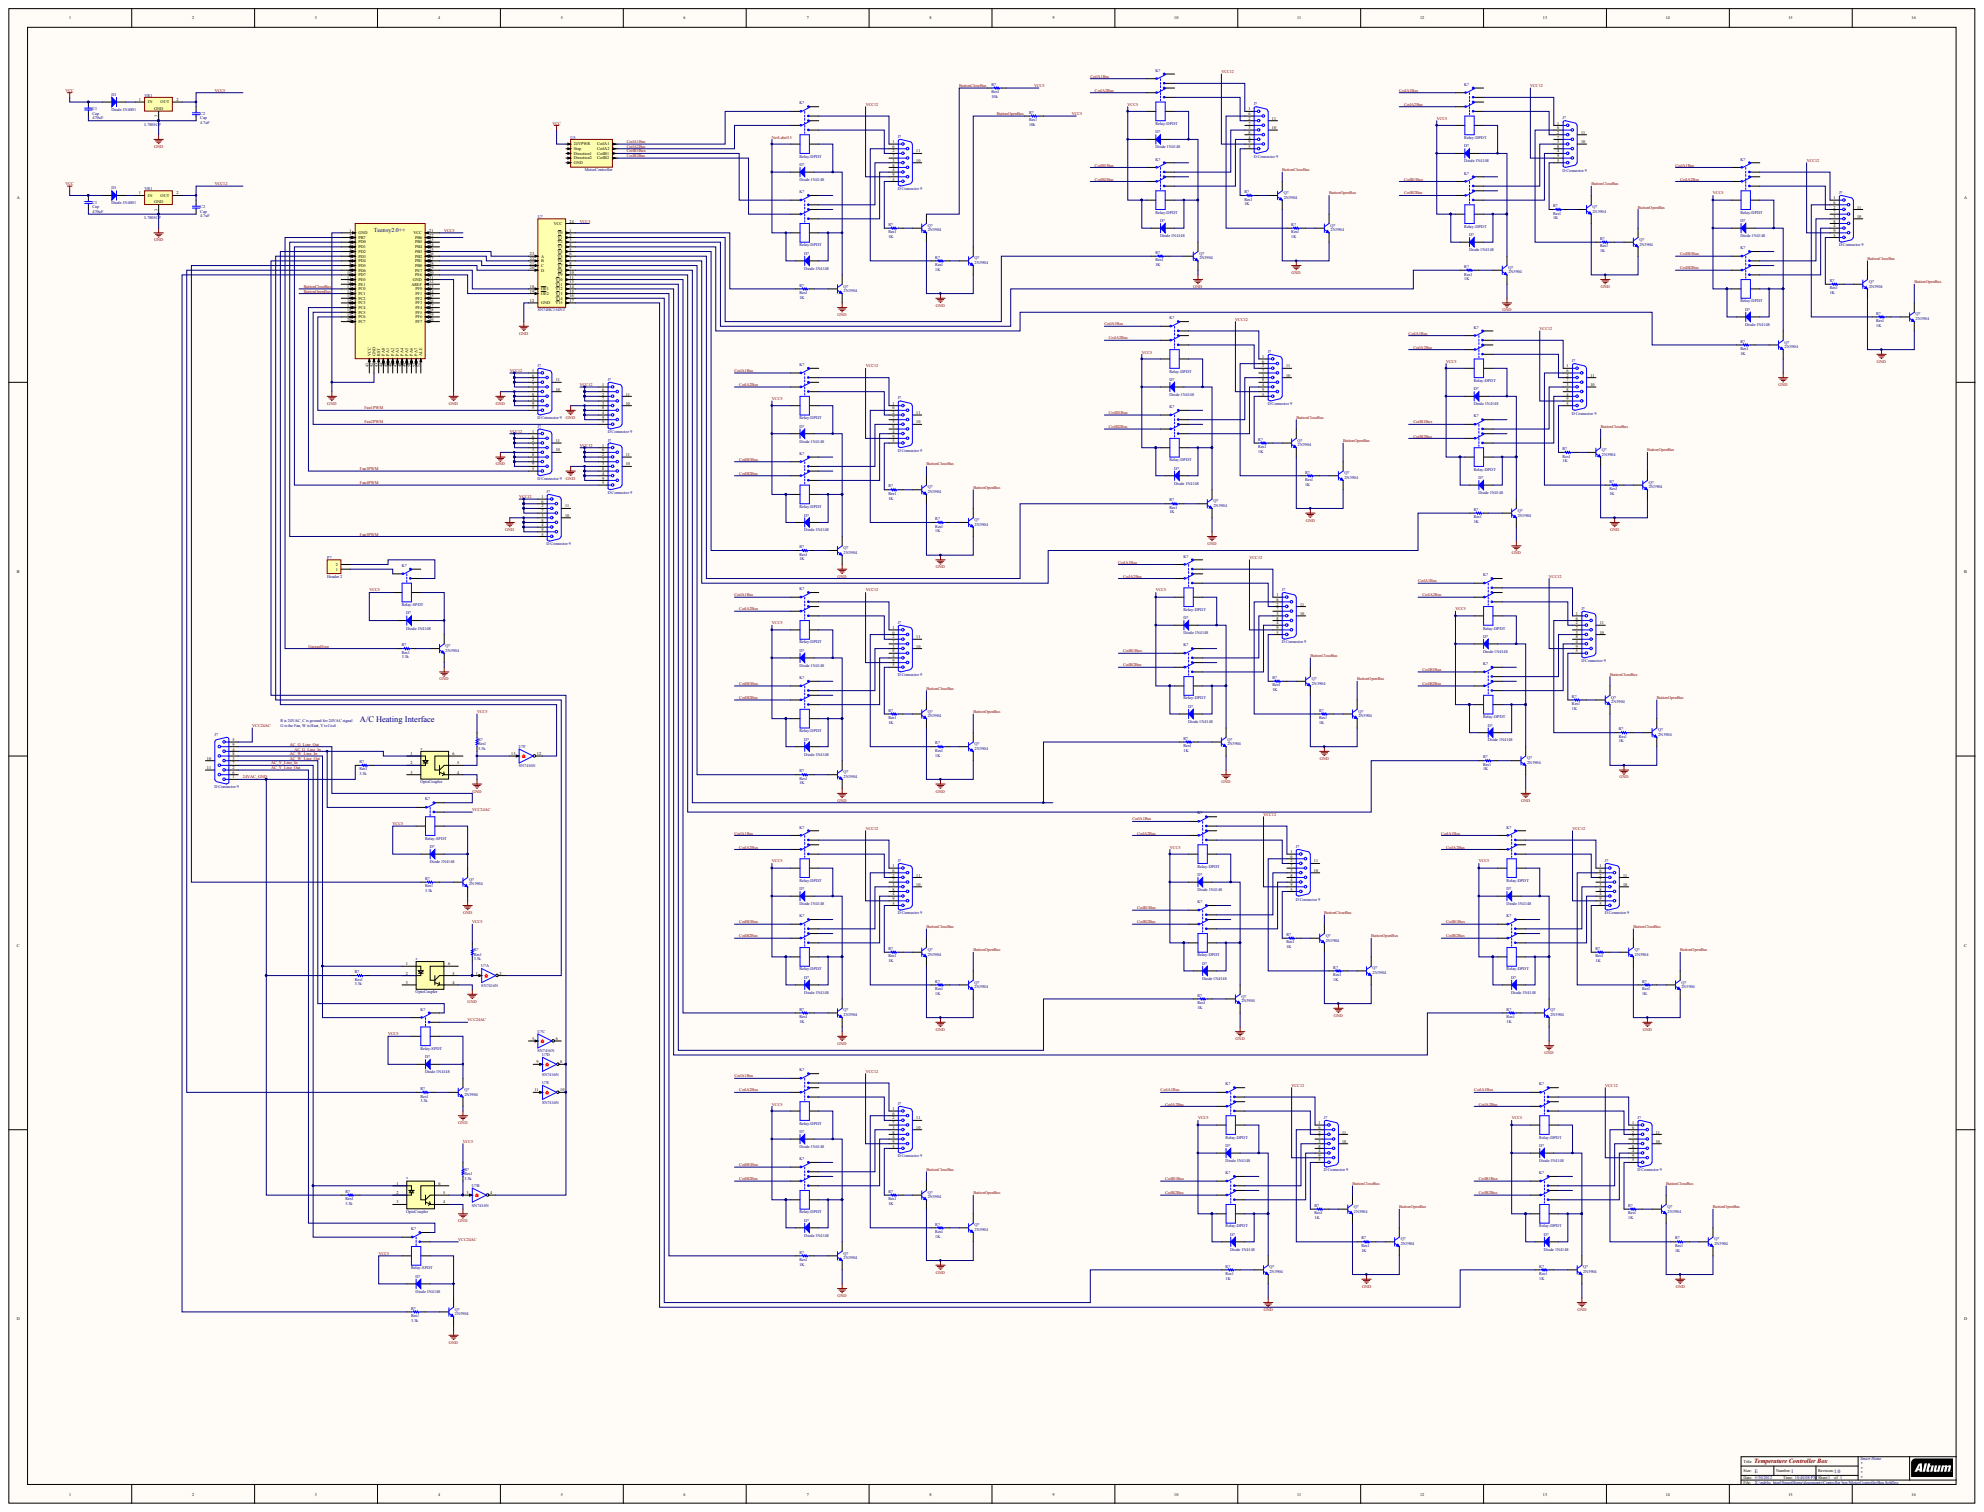
[picture p151: page 1]

Res1 | Q?

D Connector 9 K?

Title Temperature Controller Box | Smart Home * * * *

Size: E Number: 1 | Revision: 1.0

File: Date: X:\public_html\SmartHome\documents\Controller box\MotorControllerBox.SchDoc 5/30/2012 Time: 10:40:08 PM | Sheet 1 of 1
