AshitakaLax/SmartHome/EpicCube/hardware/Epic Cube Design/OldControllerBoxInfo/overallViewSchDoc.pdf

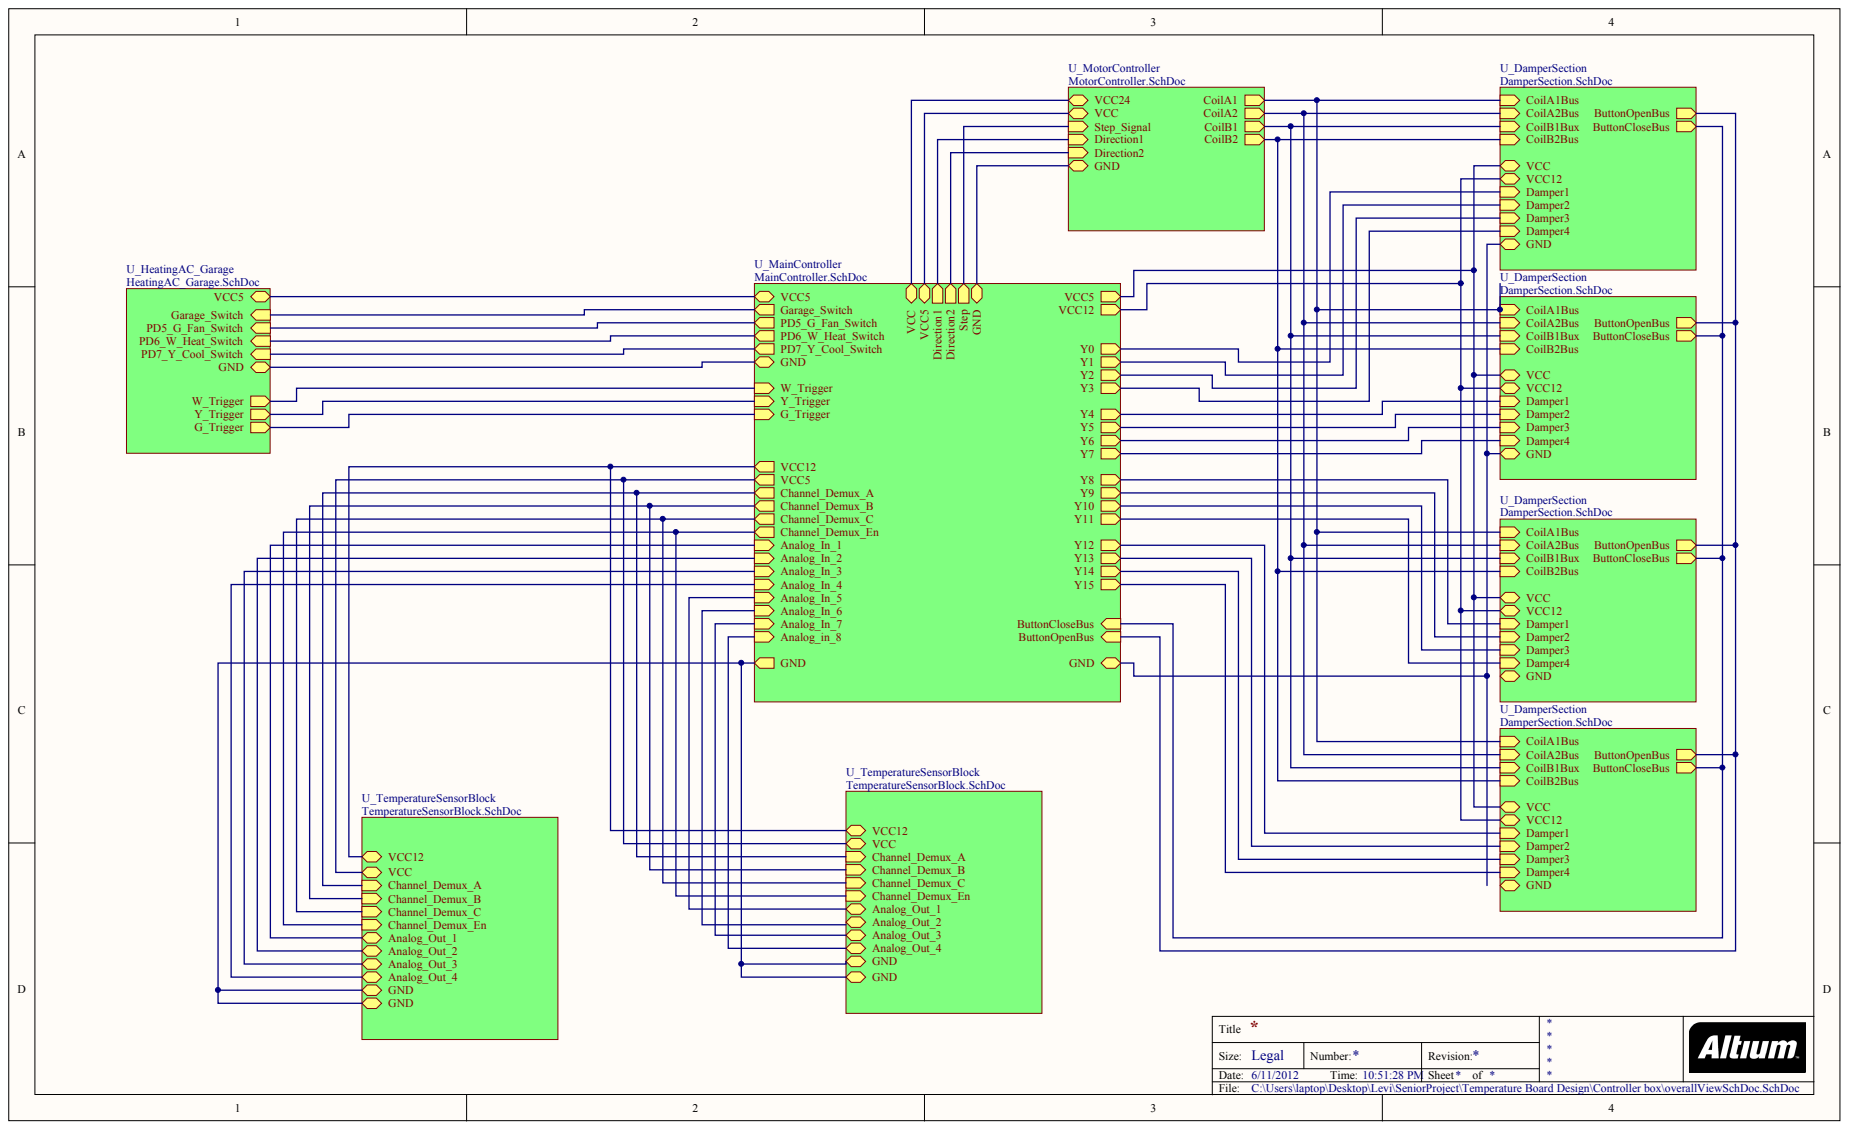
[picture p152: page 1]

VCC5
Channel_Demux_A Channel_Demux_B

U_DamperSection DamperSection.SchDoc

Channel_Demux_C
Channel_Demux_En Analog_In_1 Analog_In_2 Analog_In_3 Analog_In_4

CoilA1Bus CoilA2Bus ButtonOpenBus CoilB1Bux ButtonCloseBus CoilB2Bus VCC VCC12 Damper1

Analog_In_5 Analog_In_6

Analog_In_7

Analog_Out_1 Analog_Out_2

Analog_Out_3
Analog_Out_4 GND

Title * | * * * * *

Size: Legal | Number: * | Revision: *
Date: 6/11/2012 Time: 10:51:28 PM | | Sheet * of *
File: C:\Users\laptop\Desktop\Levi\SeniorProject\Temperature Board Design\Controller box\overallViewSchDoc.SchDoc
