AshitakaLax/SmartHome/EpicCube/hardware/Epic Cube Design/OldControllerBoxInfo/TemperatureSensorBlock.pdf

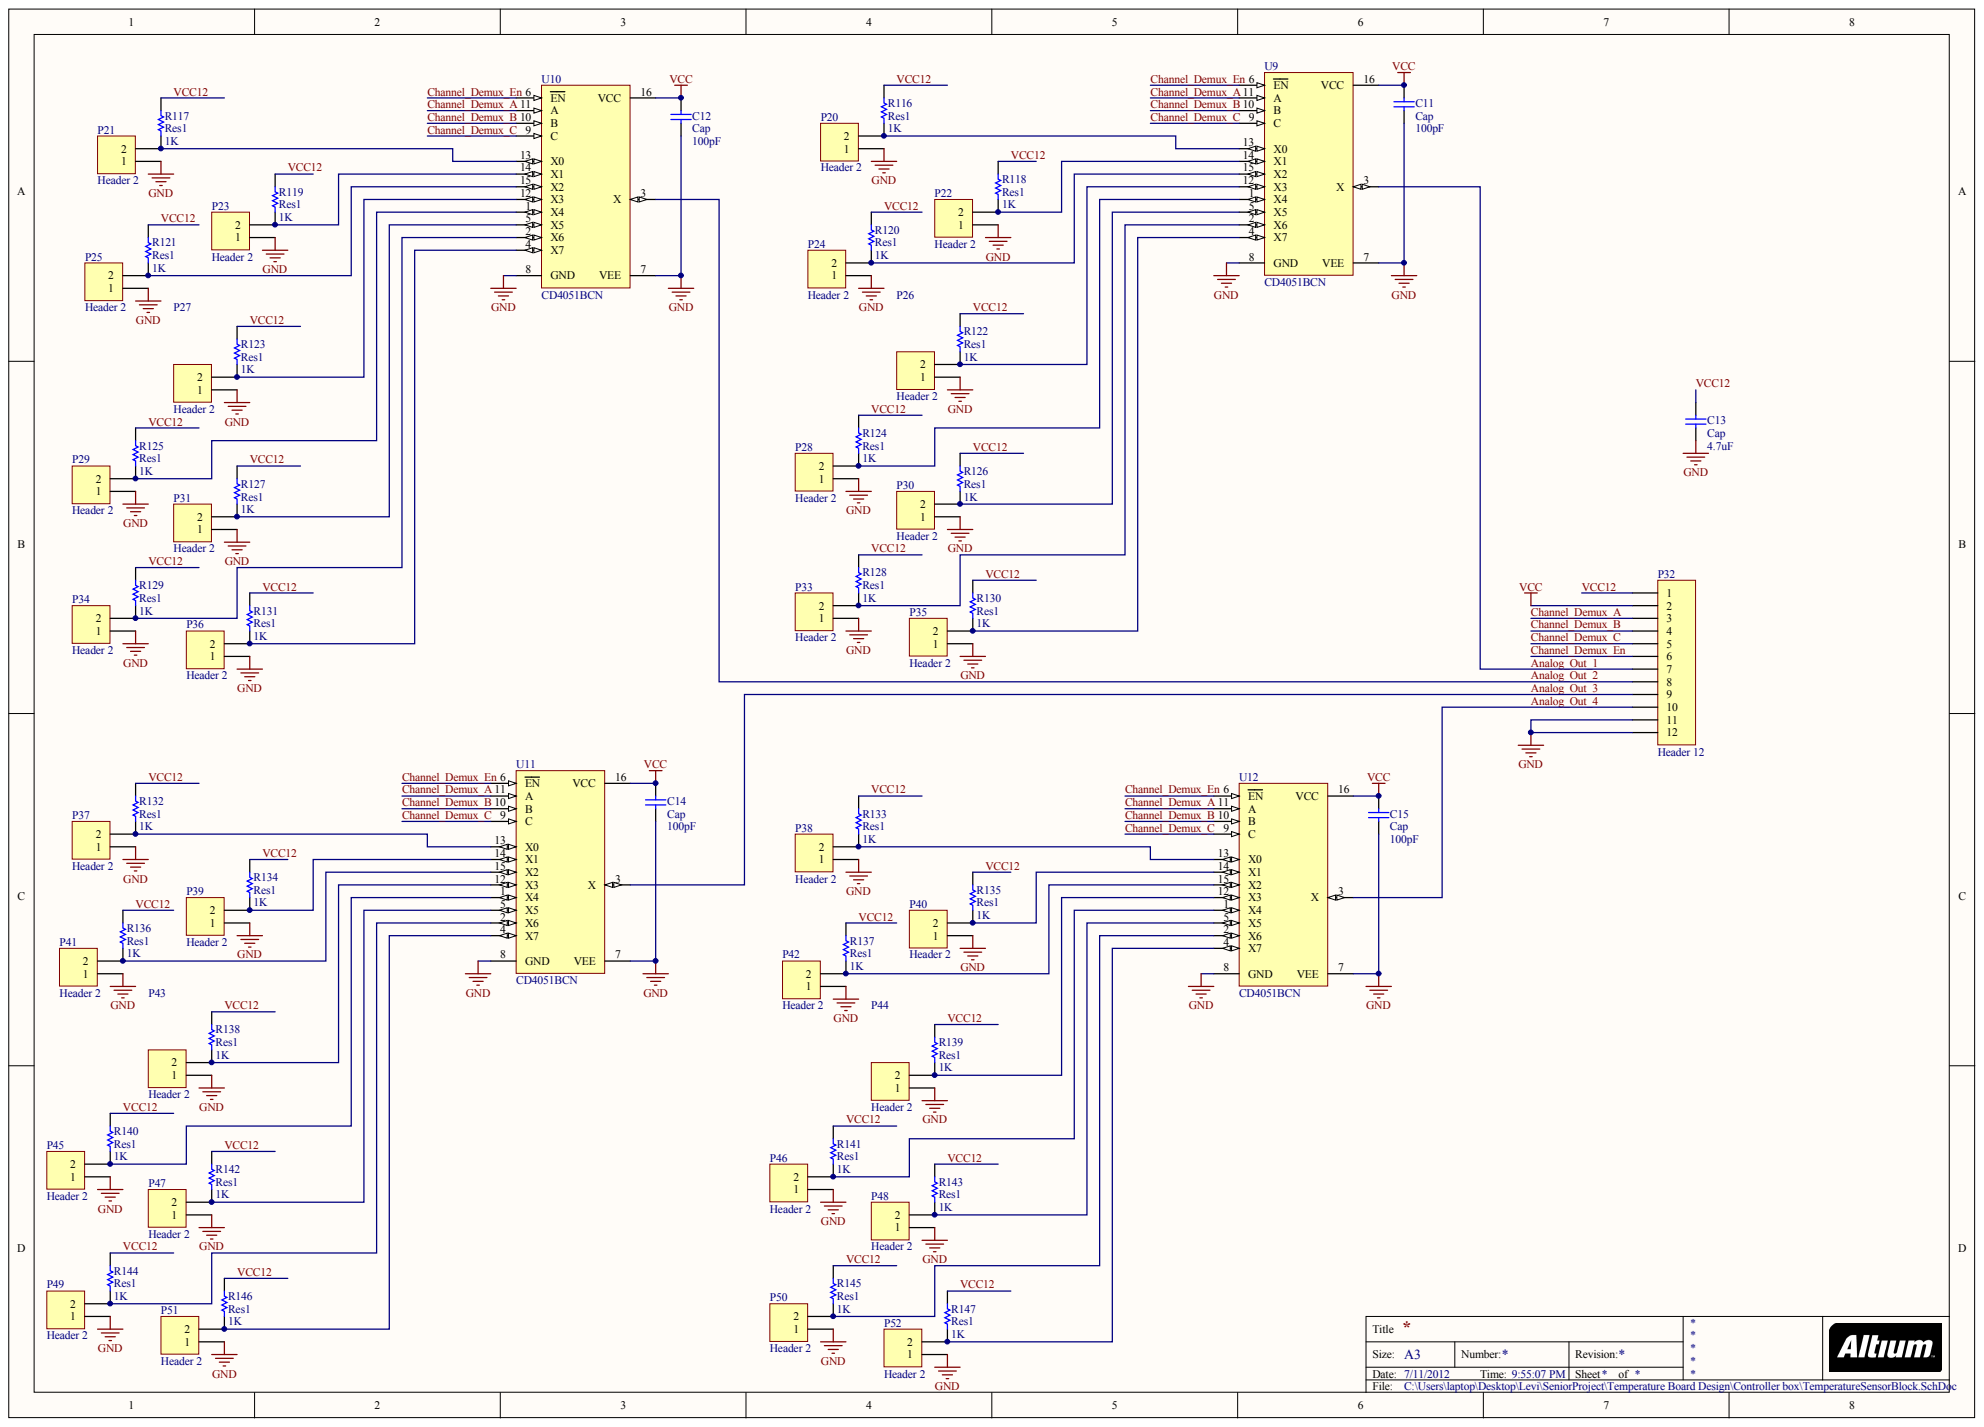
[picture p153: page 1]

Analog_Out_4

VCC C15

C:\Users\laptop\Desktop\Levi\SeniorProject\Temperature Board Design\Controller box\TemperatureSensorBlock.SchDoc
