AshitakaLax/SmartHome/EpicCube/hardware/Epic Cube Design/OldControllerBoxInfo/DamperSectionPCB.pdf

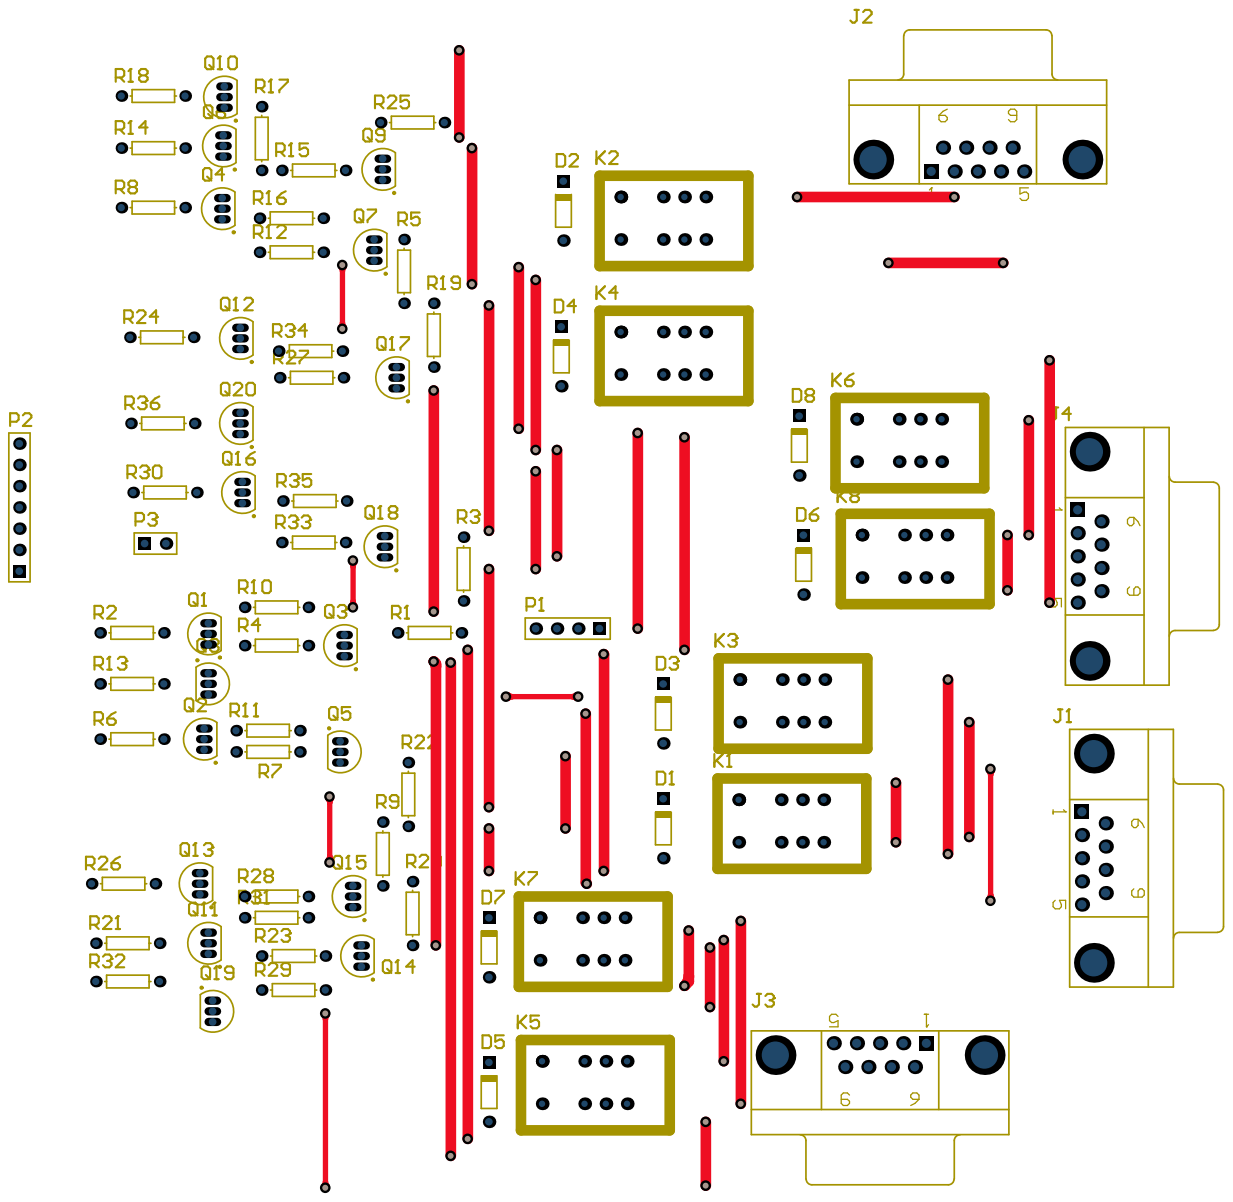
[picture p154: page 1]

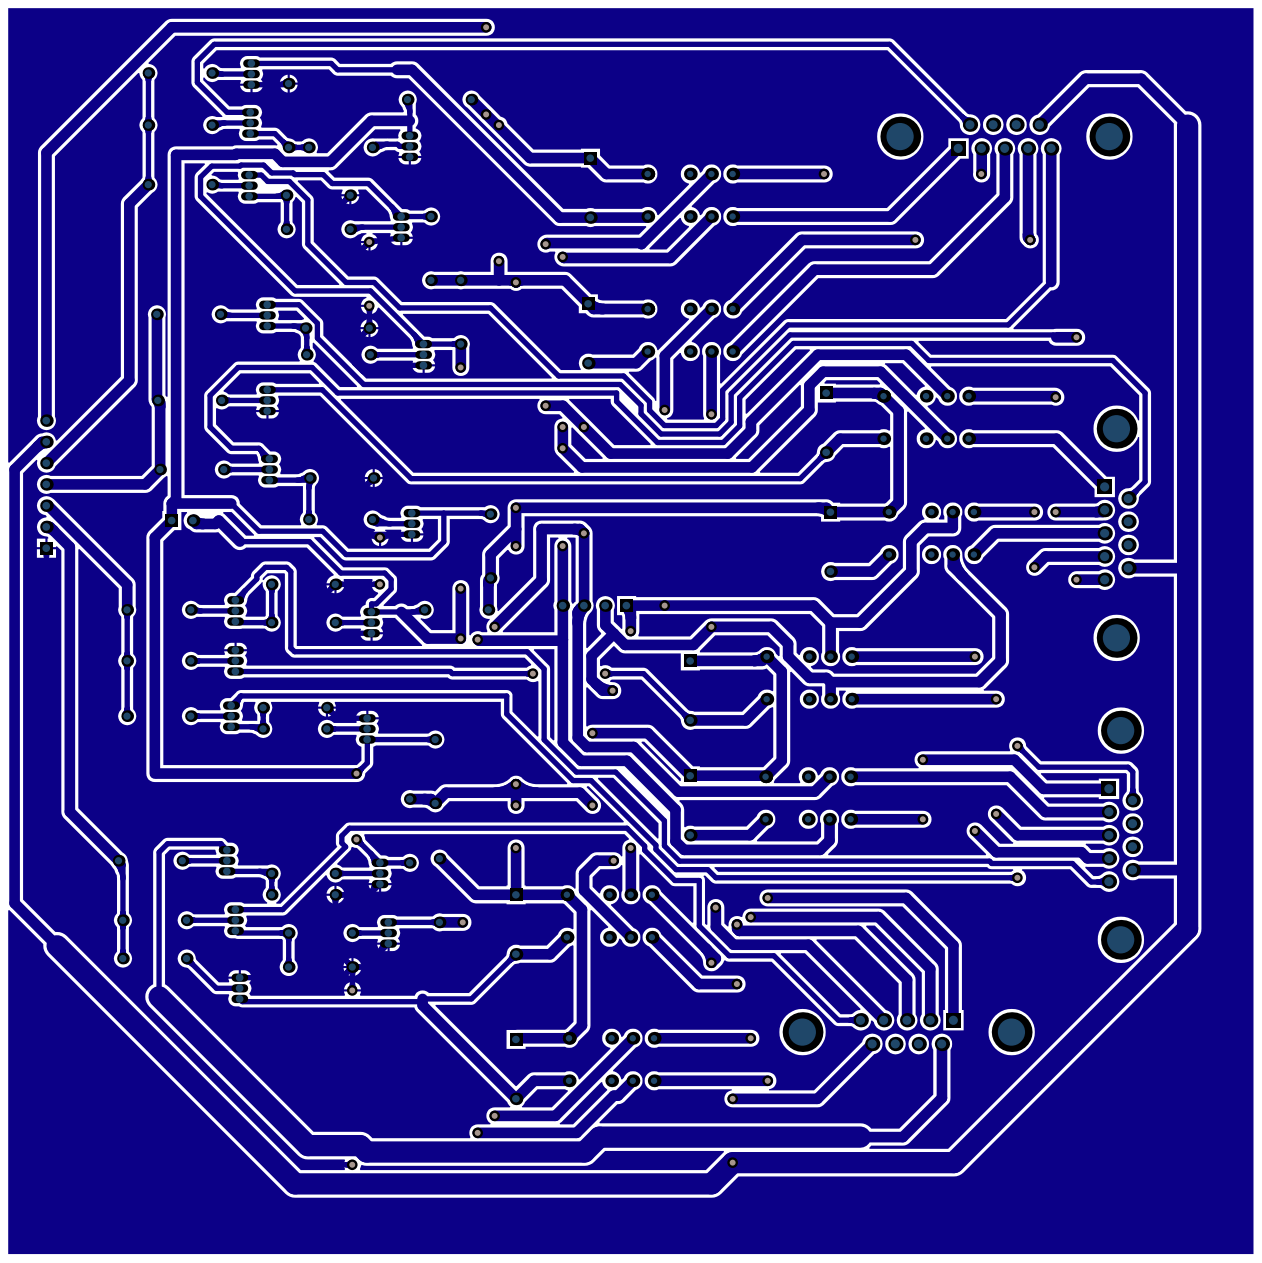
[picture p155: page 2]
