AshitakaLax/SmartHome/EpicCube/hardware/Epic Cube Design/OldControllerBoxInfo/DamperSectionProject.pdf

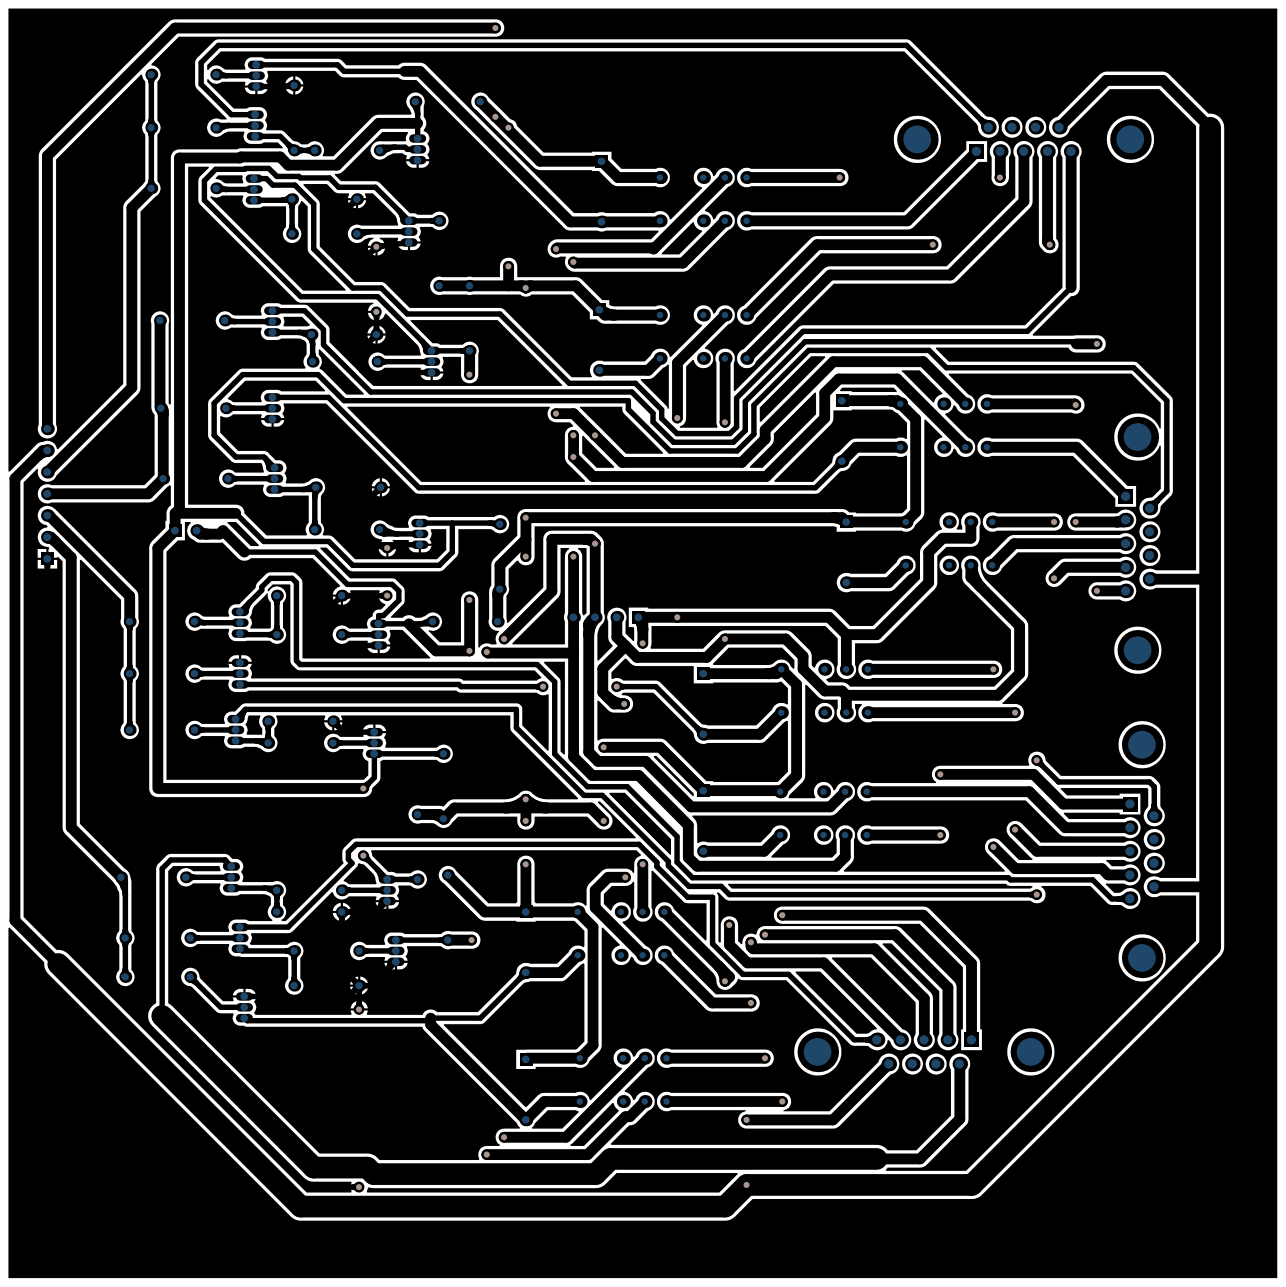
[picture p156: page 1]
