AshitakaLax/SmartHome/EpicCube/hardware/Epic Cube Design/OldControllerBoxInfo/HeatingAC_Garage.pdf

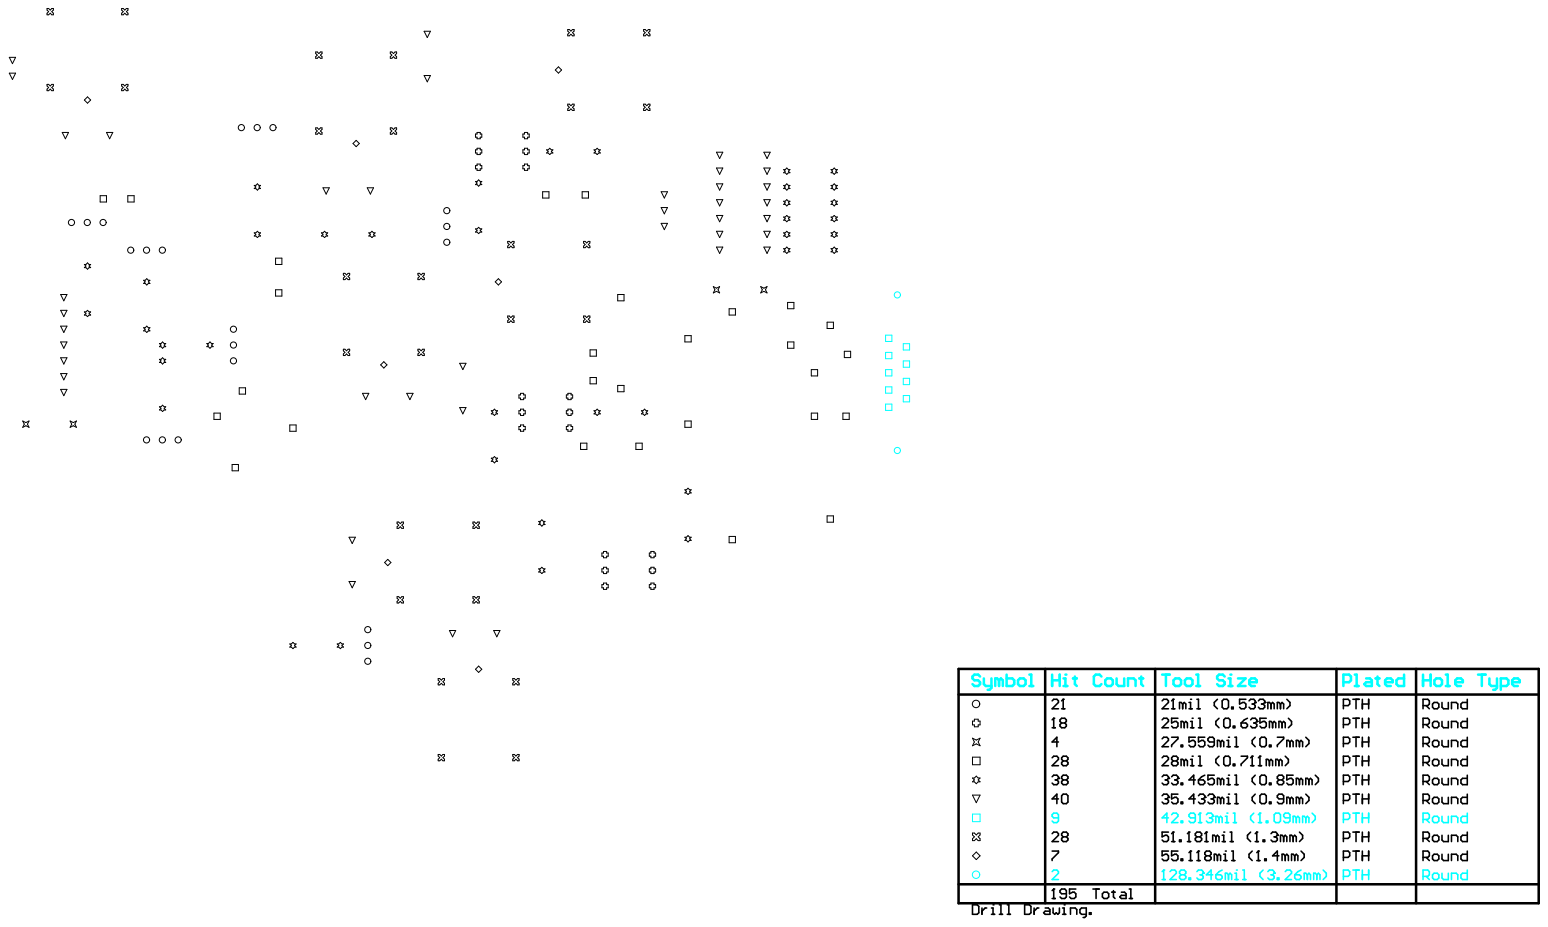
[picture p157: page 1]

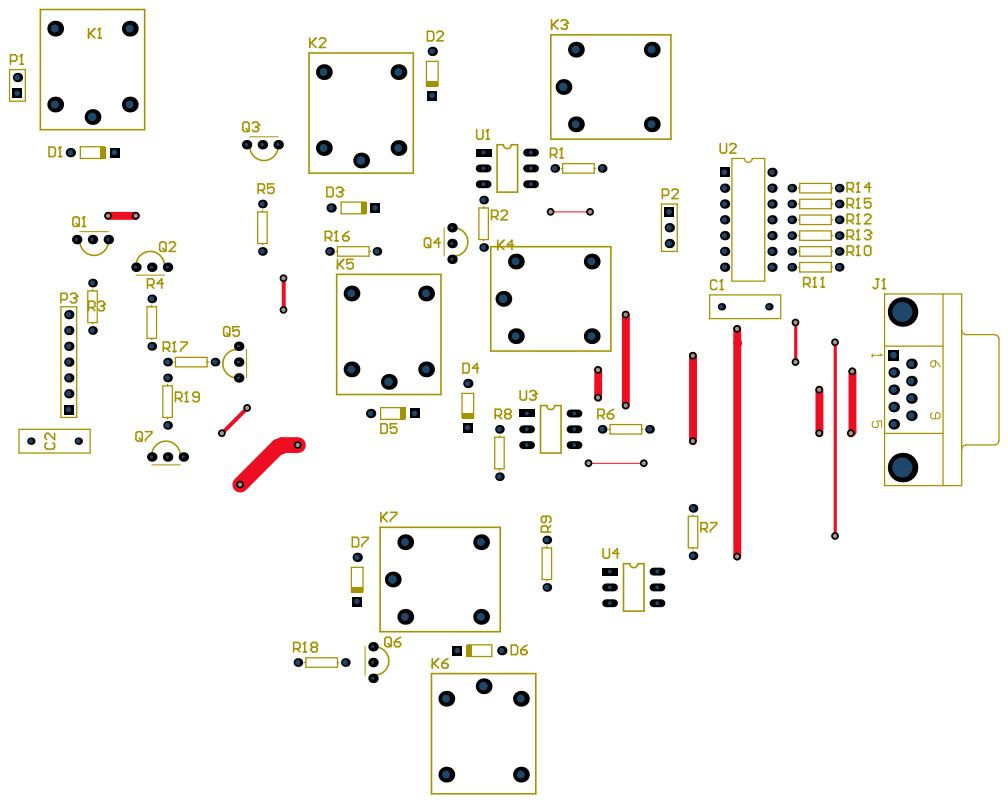
[picture p158: page 2]

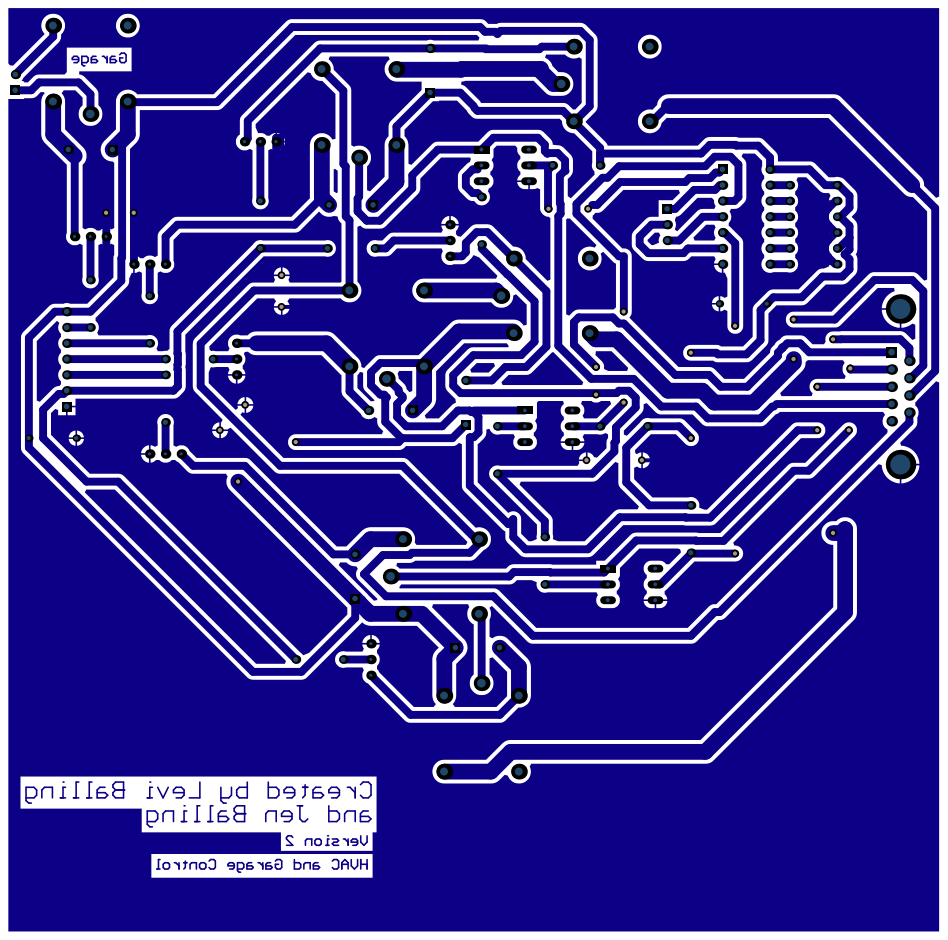
[picture p159: page 3]
