AshitakaLax/SmartHome/EpicCube/hardware/Epic Cube Design/OldControllerBoxInfo/HeatingAC_GarageParts&holes.pdf

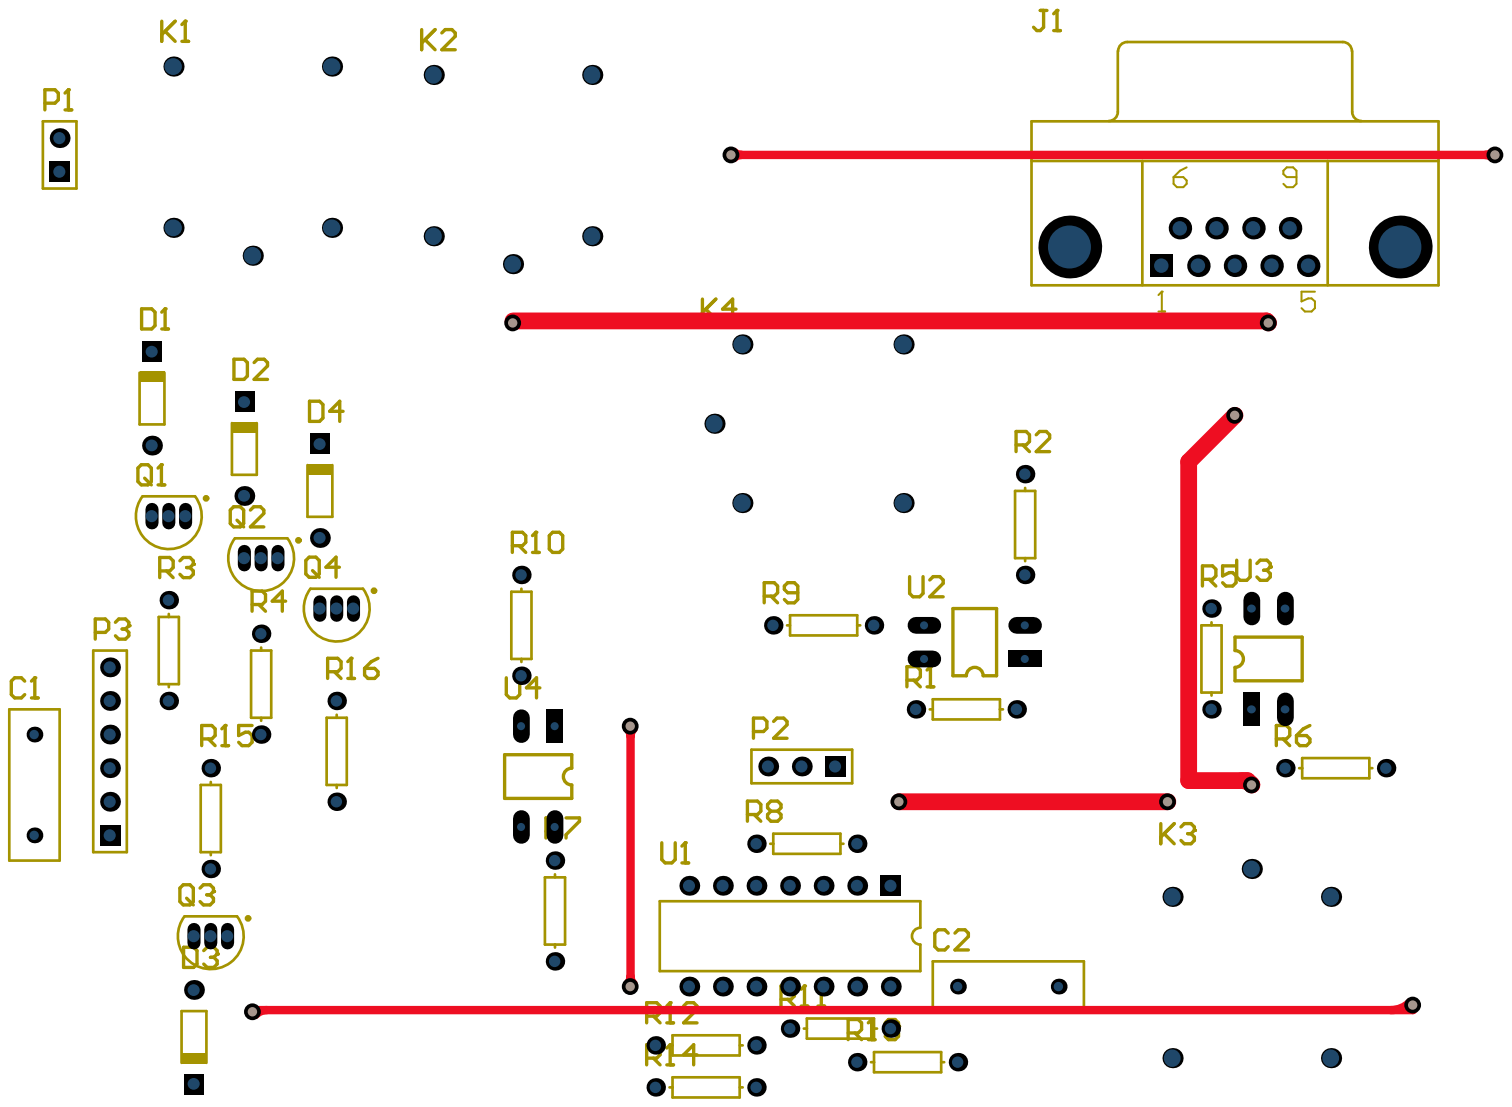
[picture p160: page 1]

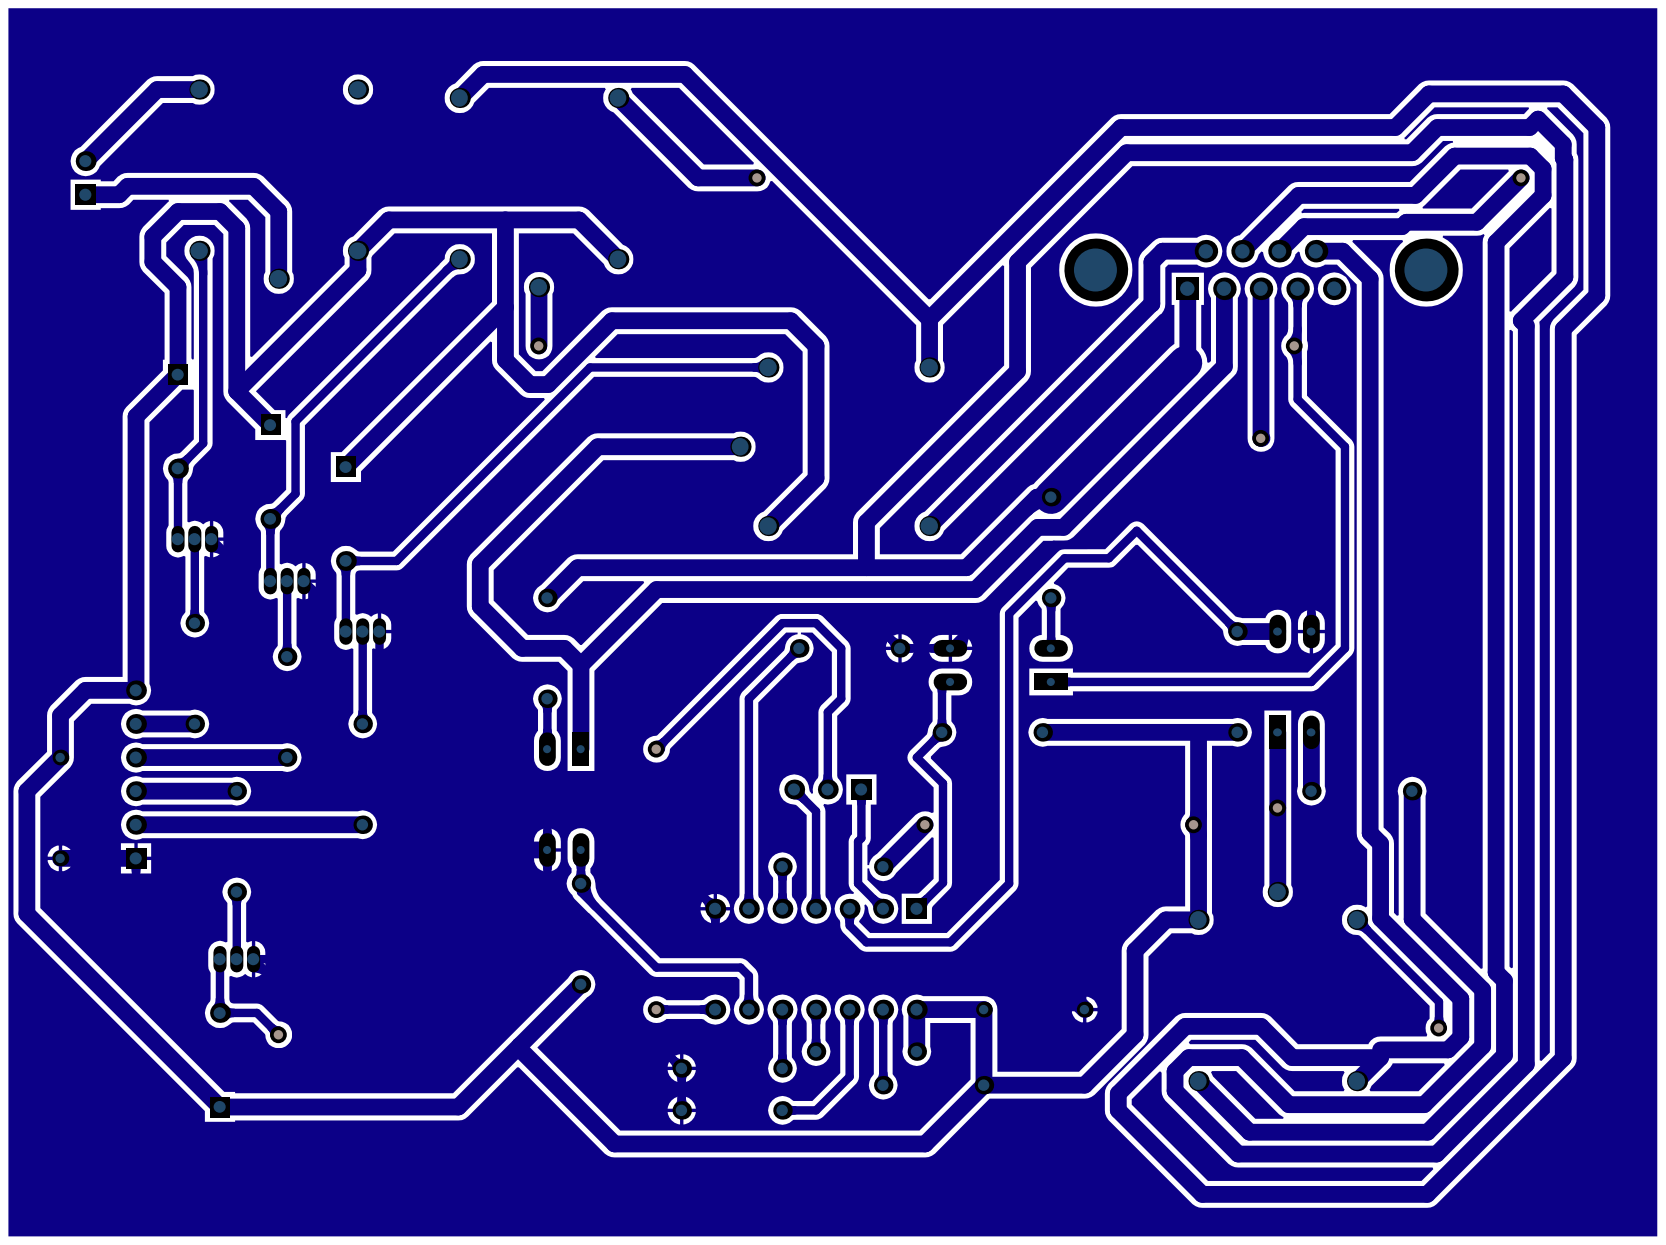
[picture p161: page 2]
