AshitakaLax/SmartHome/EpicCube/hardware/Epic Cube Design/OldControllerBoxInfo/HeatingAC_GarageProject.pdf

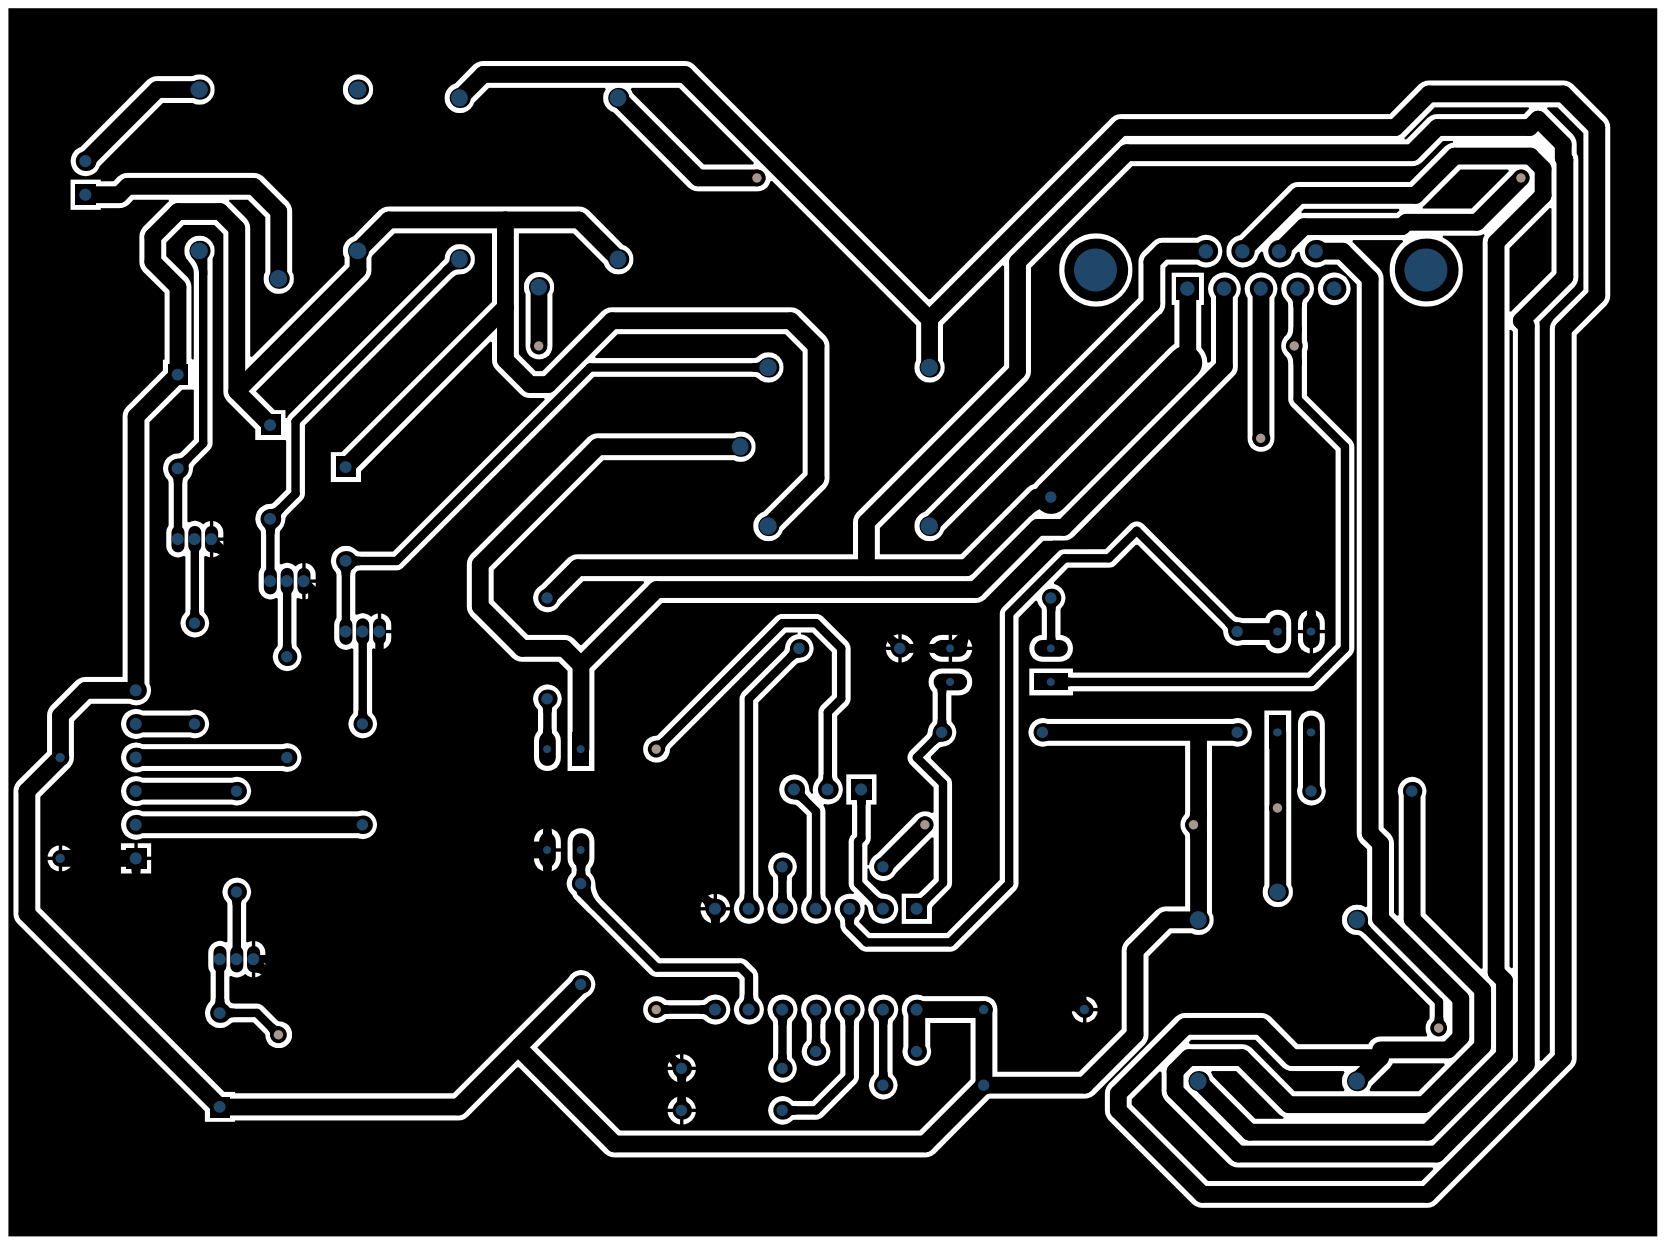
[picture p162: page 1]
