AshitakaLax/SmartHome/EpicCube/hardware/Epic Cube Design/OldControllerBoxInfo/HighPowerMotorController.pdf

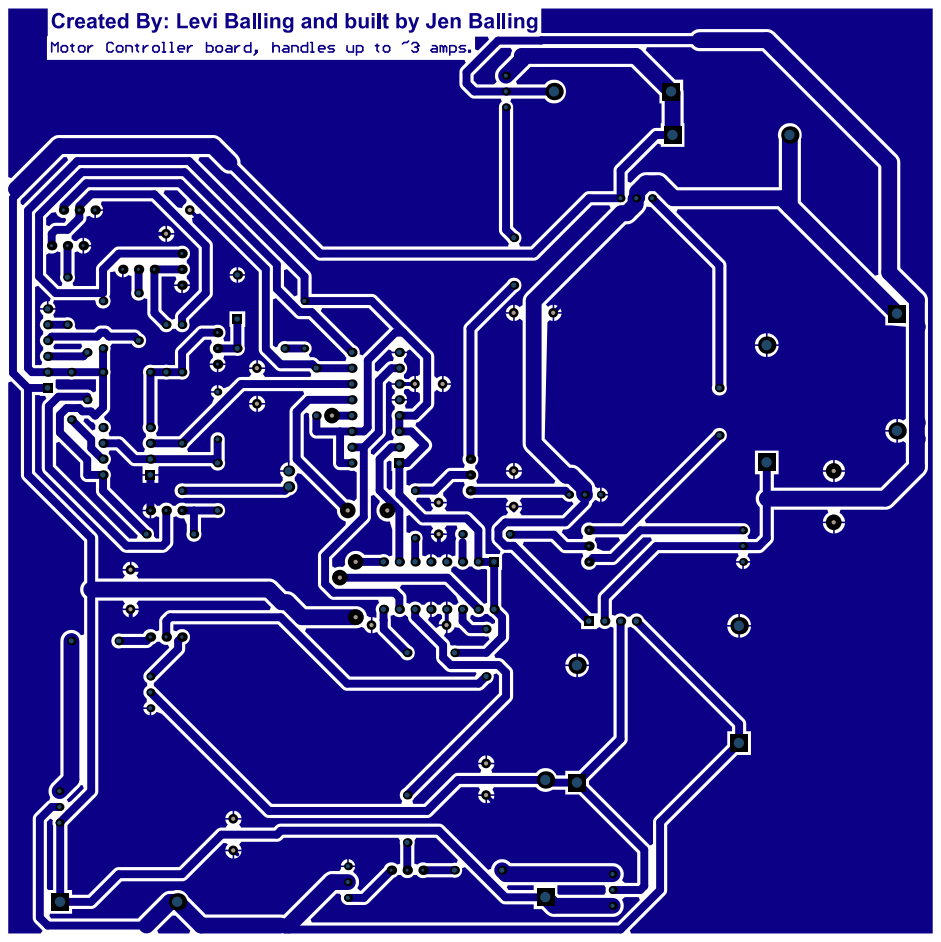
[picture p163: page 1]

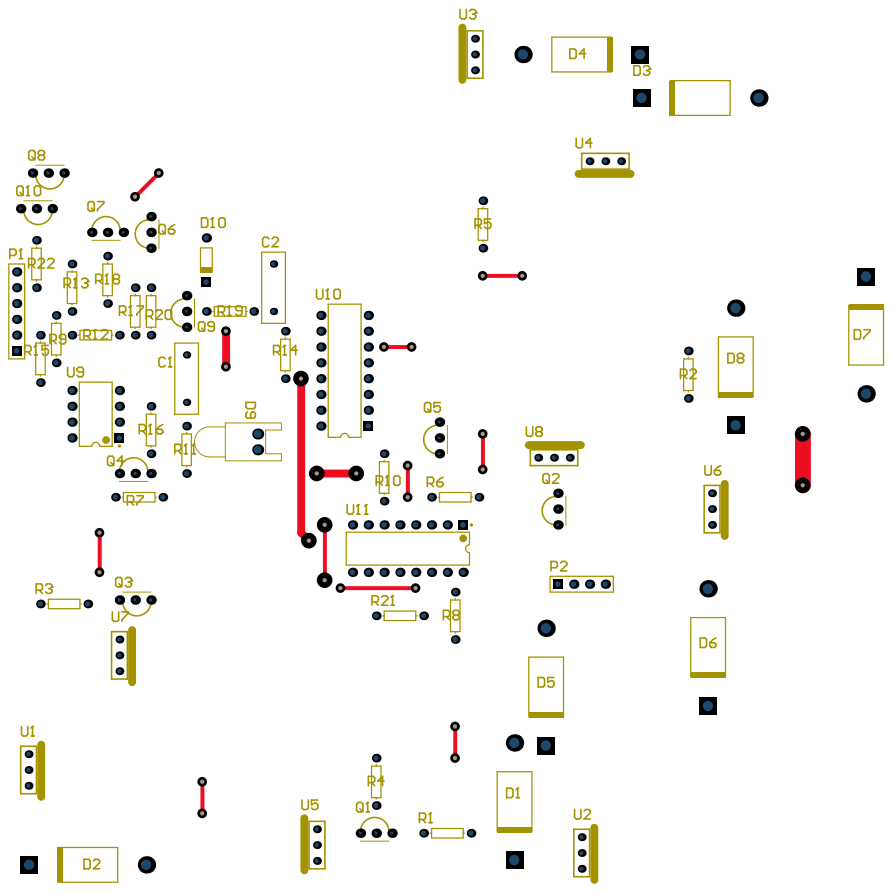
[picture p164: page 2]

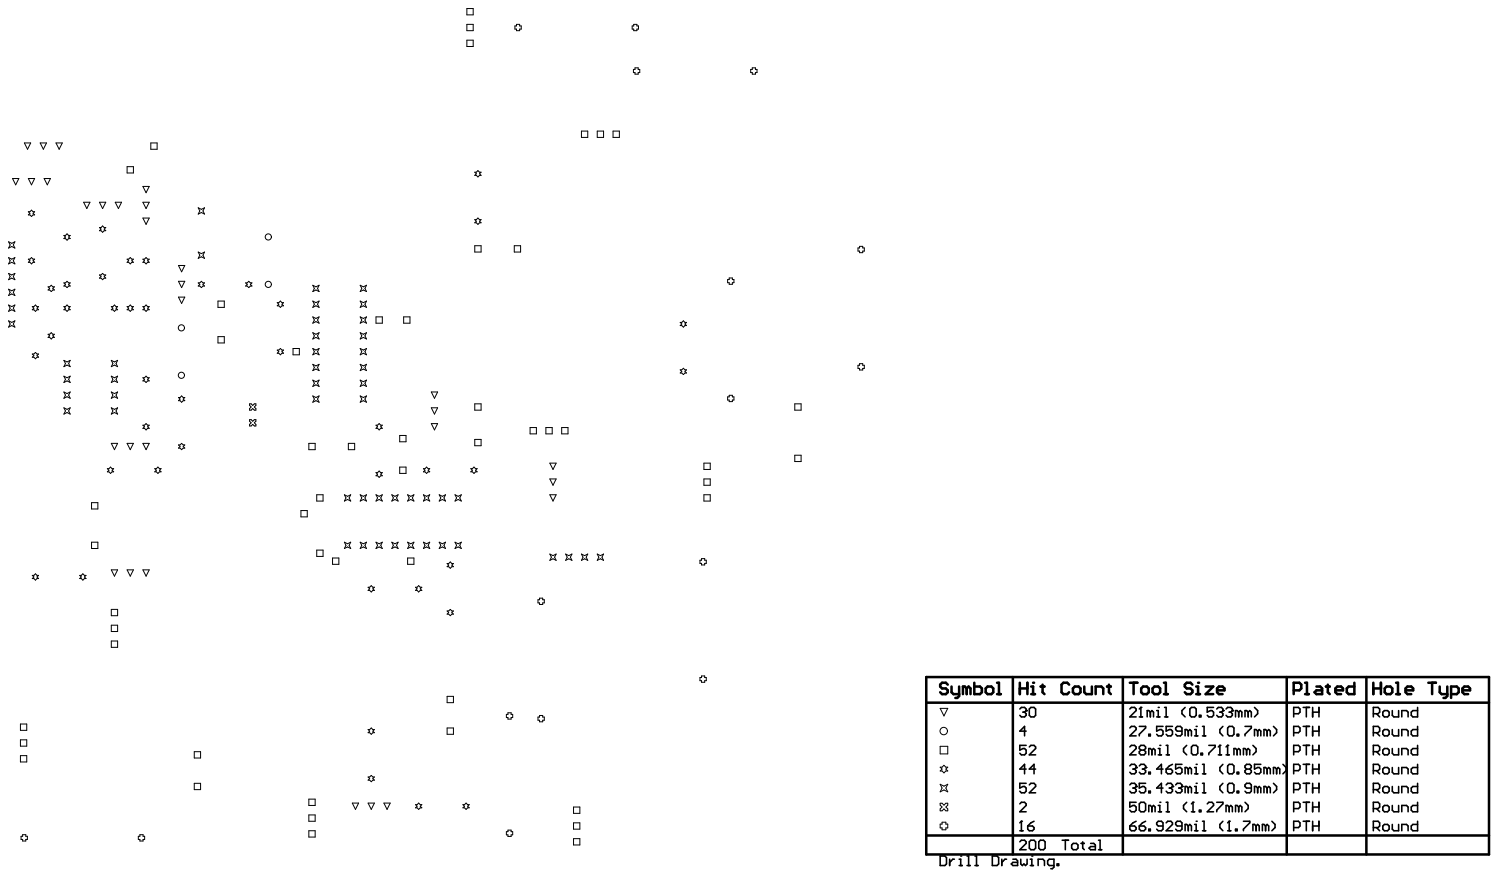
[picture p165: page 3]

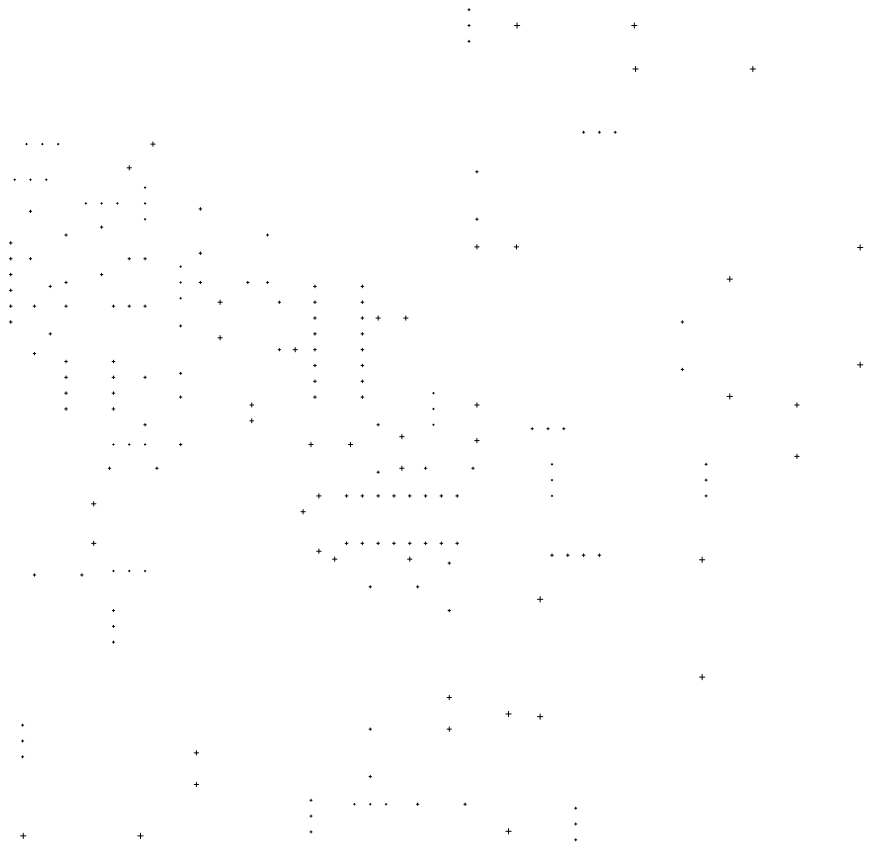
[picture p166: page 4]
