AshitakaLax/SmartHome/EpicCube/hardware/Epic Cube Design/OldControllerBoxInfo/HighPowerMotorControllerHoles&Parts.pdf

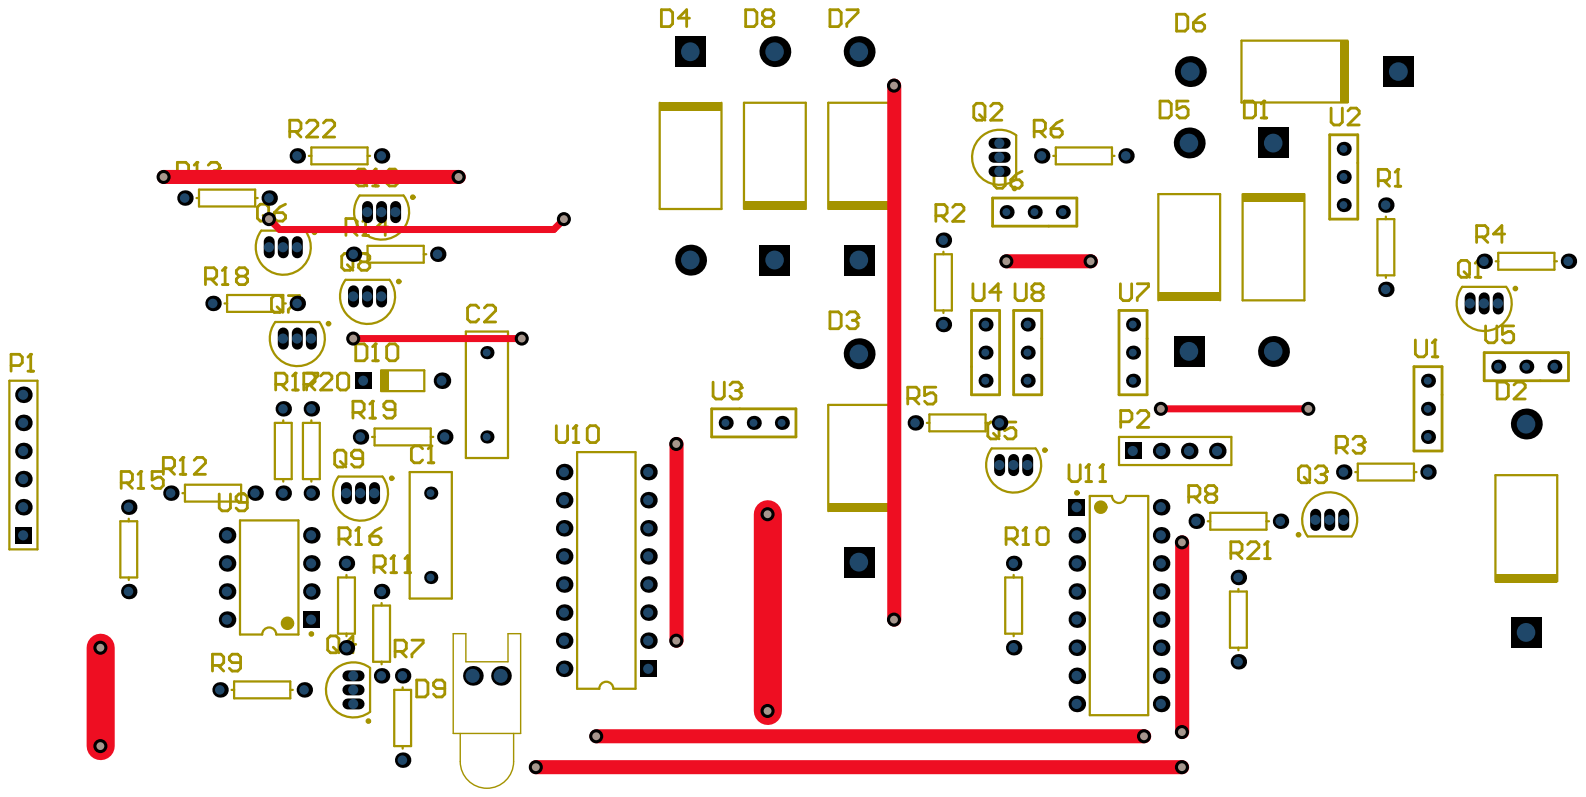
[picture p167: page 1]

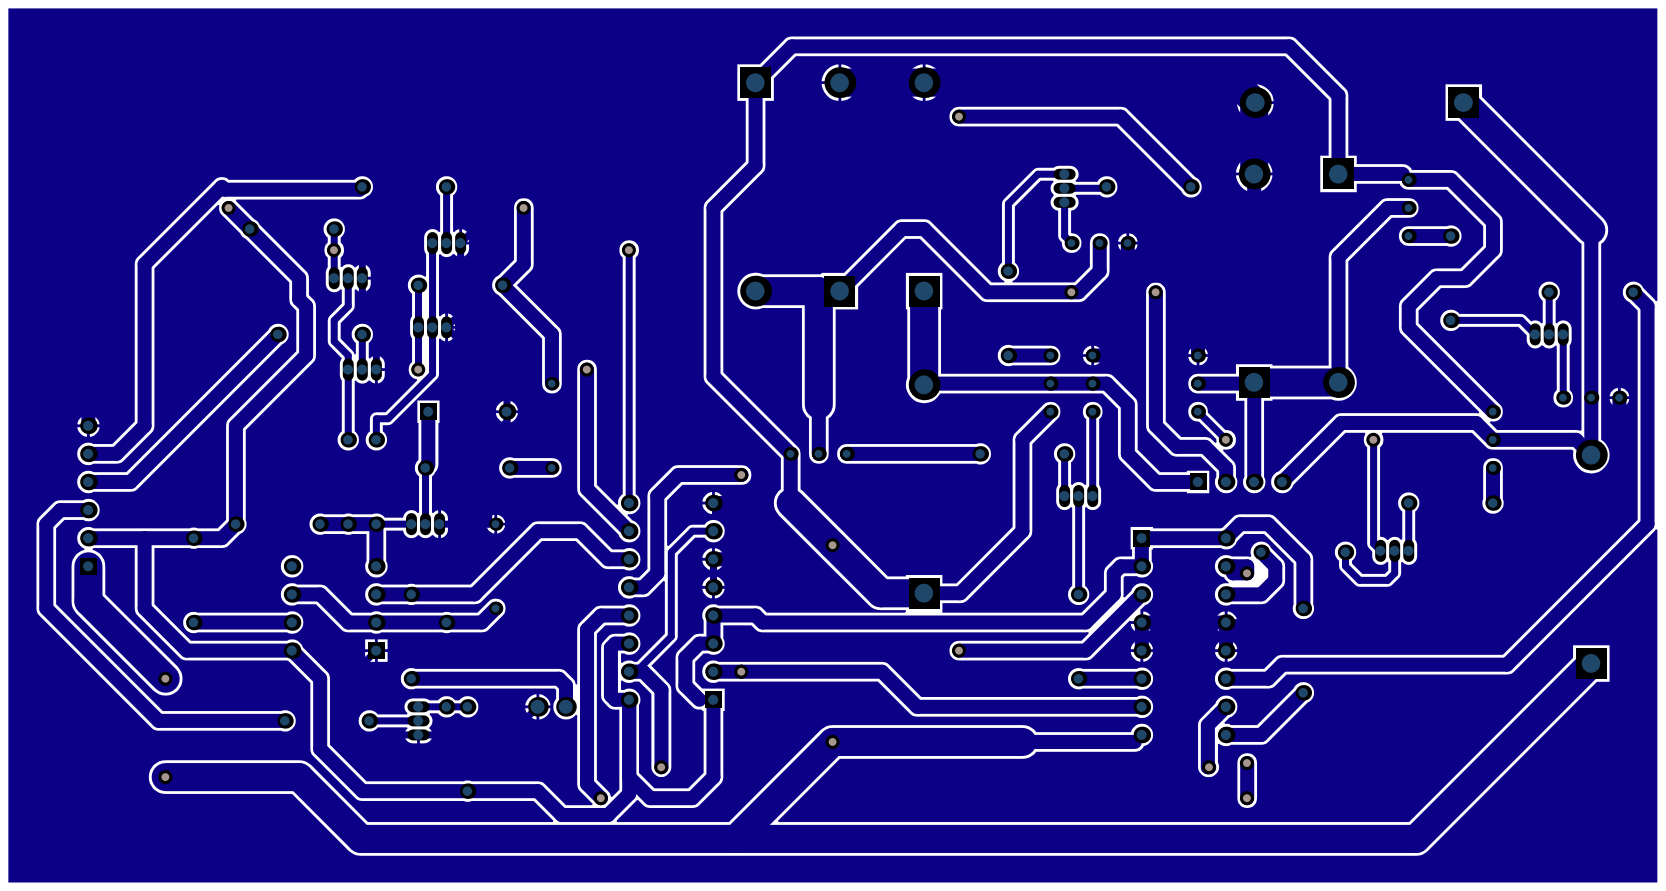
[picture p168: page 2]
