AshitakaLax/SmartHome/EpicCube/hardware/Epic Cube Design/OldControllerBoxInfo/MainControllerPCBHoles&Pars.pdf

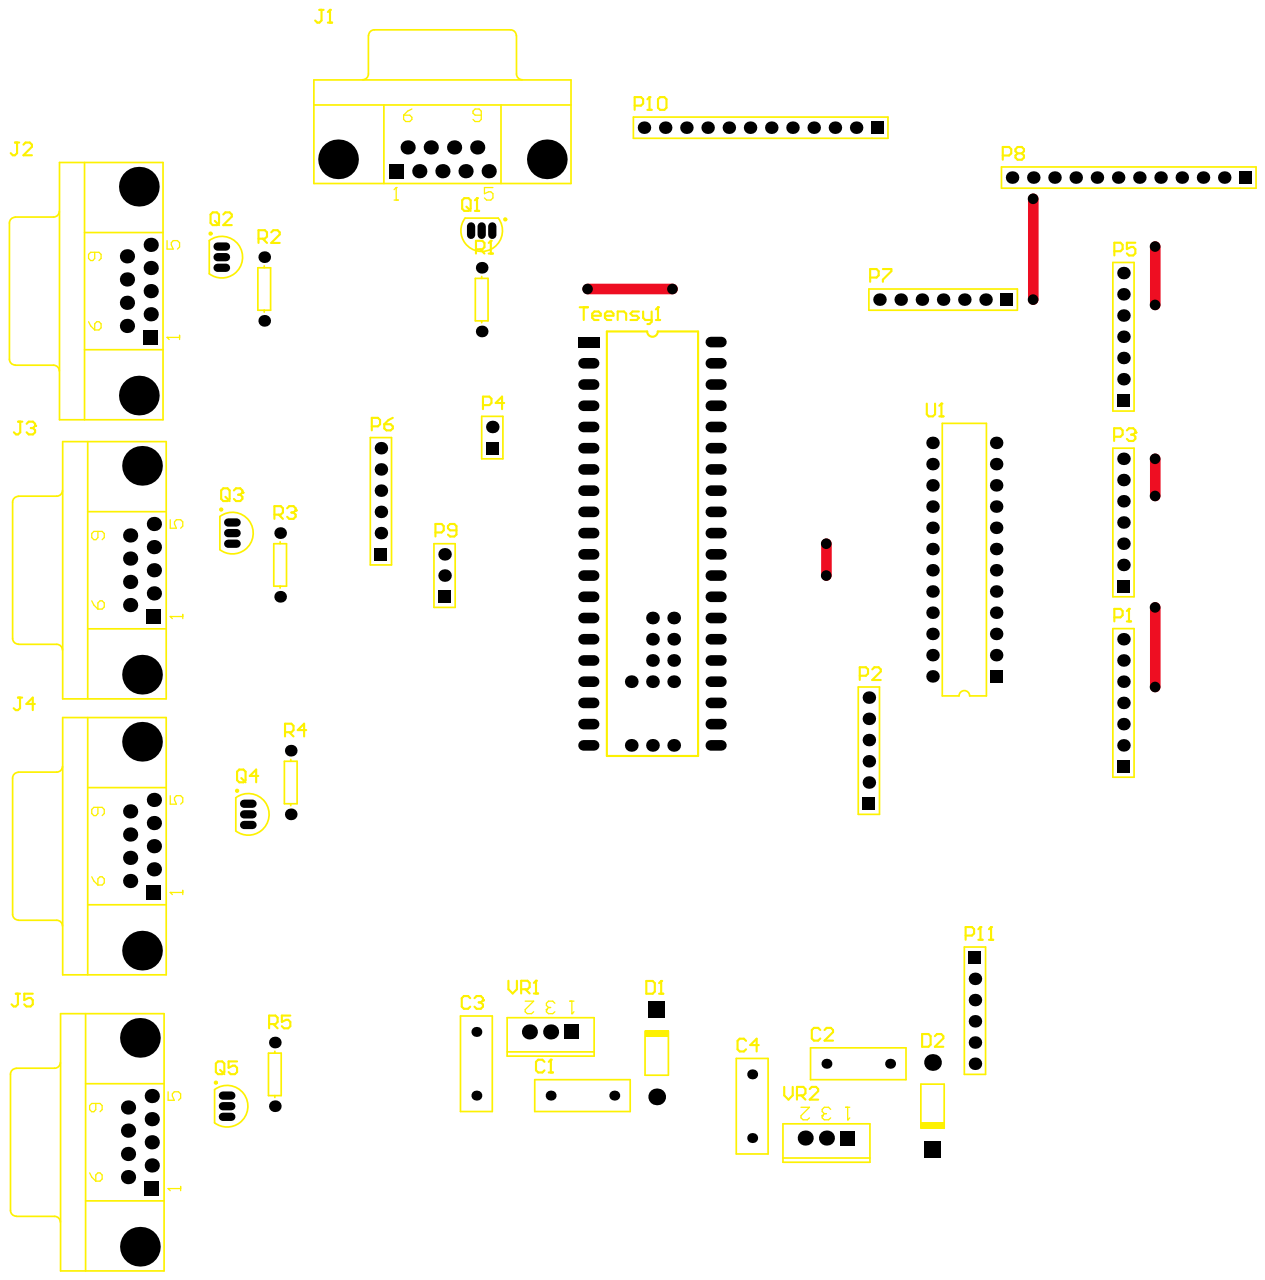
[picture p169: page 1]

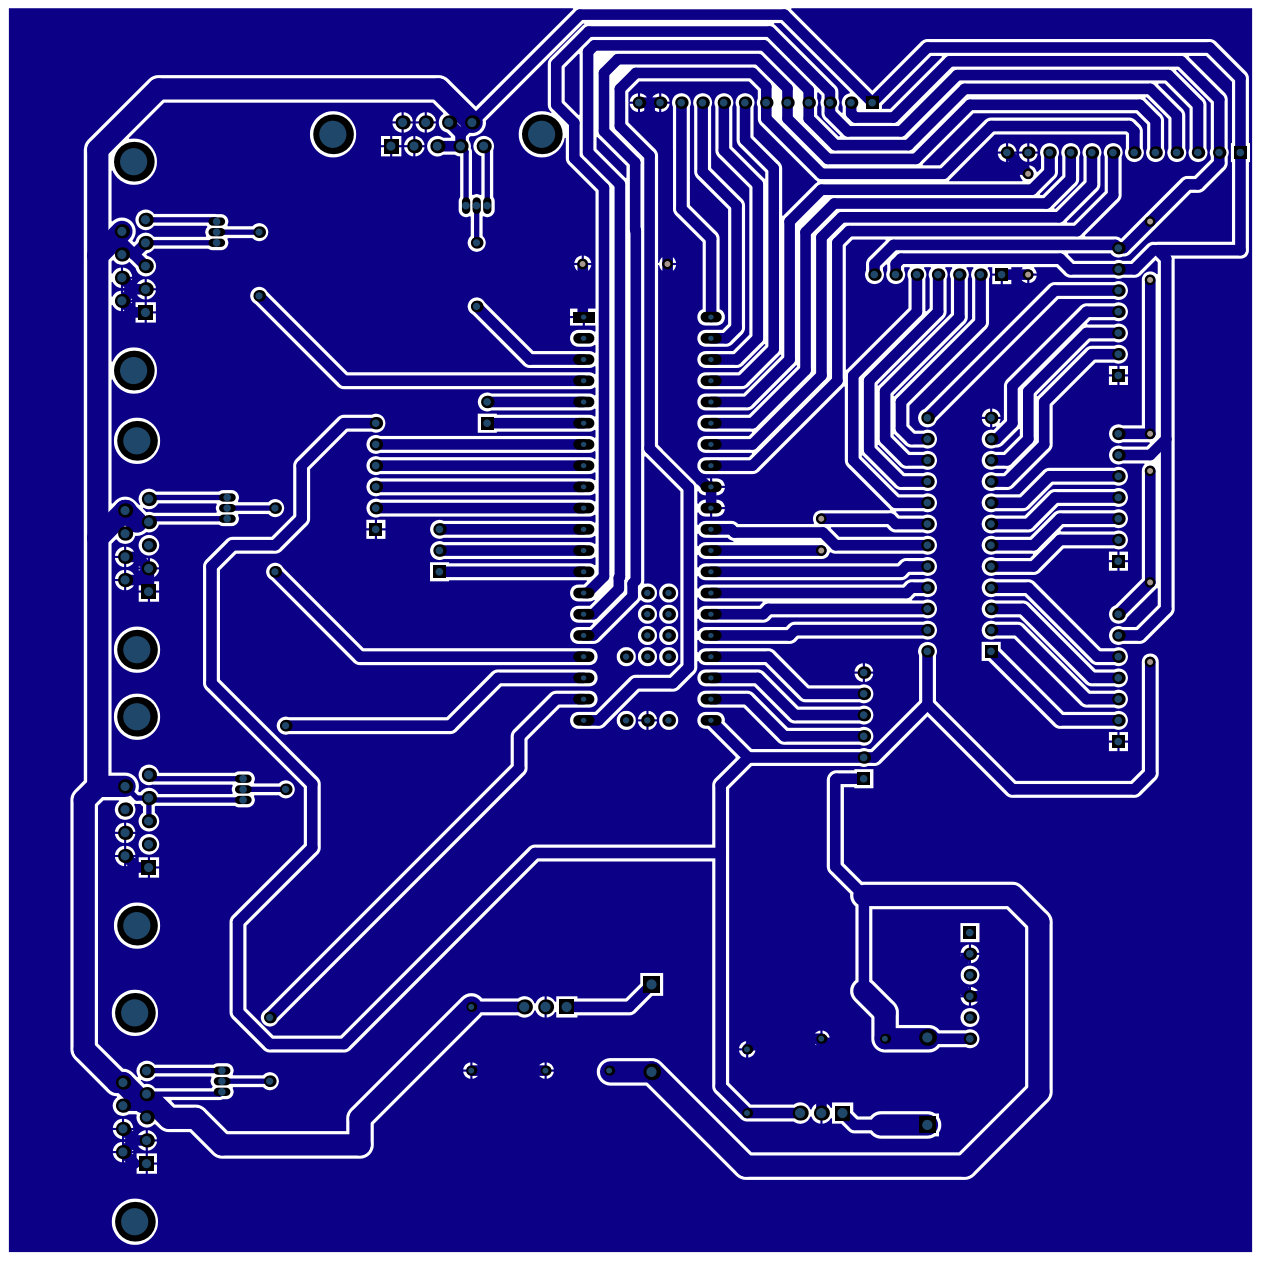
[picture p170: page 2]
