AshitakaLax/SmartHome/EpicCube/hardware/Epic Cube Design/OldControllerBoxInfo/MainControllerProject.pdf

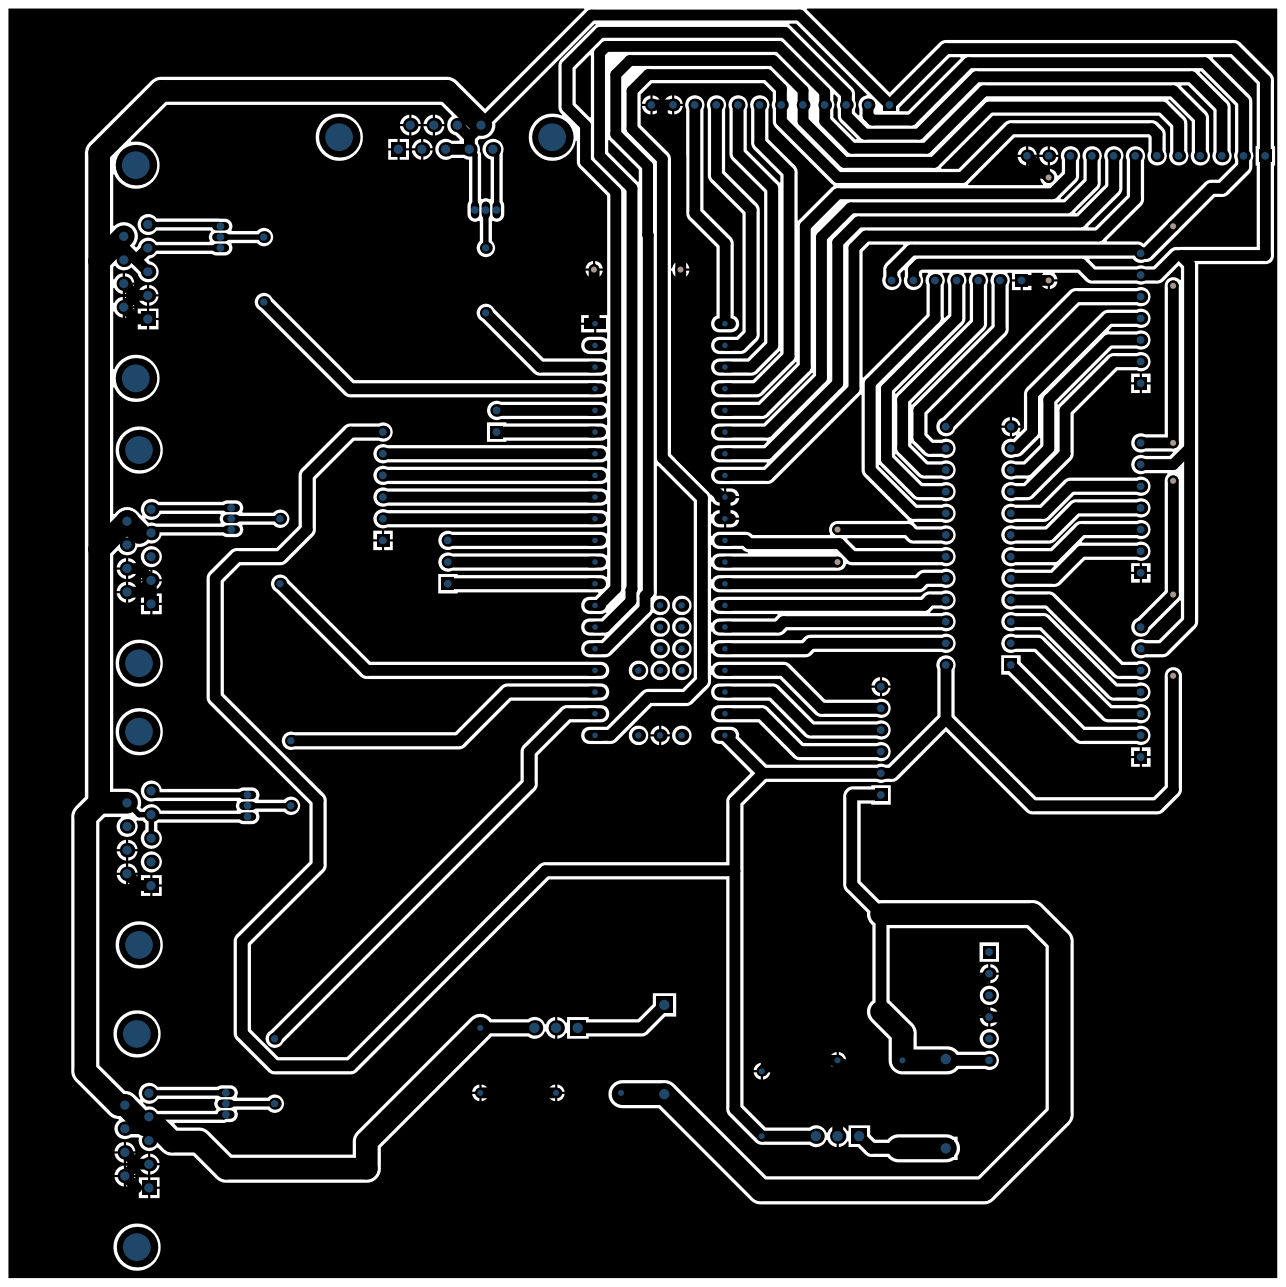
[picture p171: page 1]
