AshitakaLax/SmartHome/EpicCube/hardware/Epic Cube Design/OldControllerBoxInfo/MotorController3.pdf

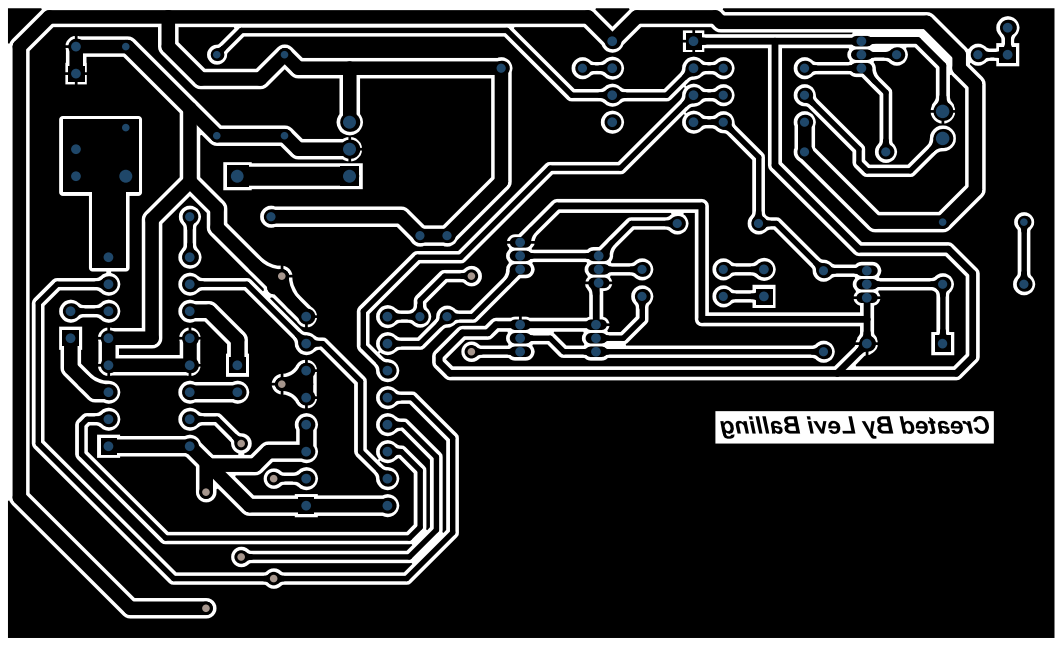
[picture p172: page 1]

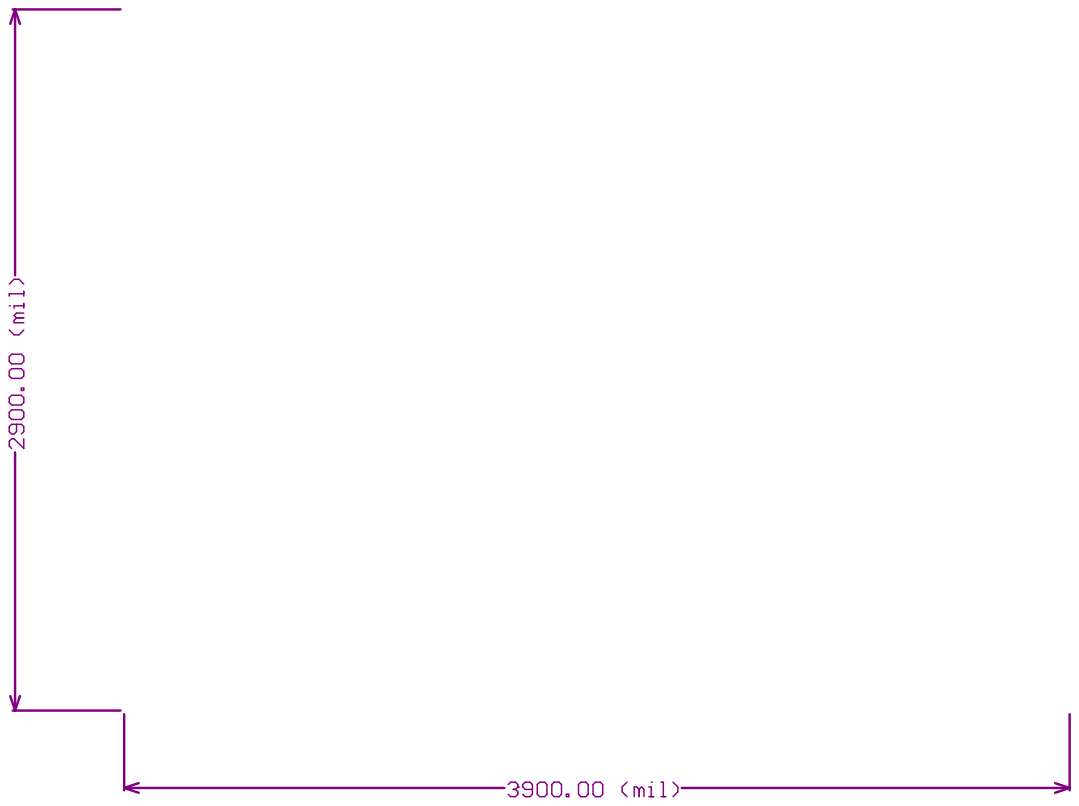
[picture p173: page 2]

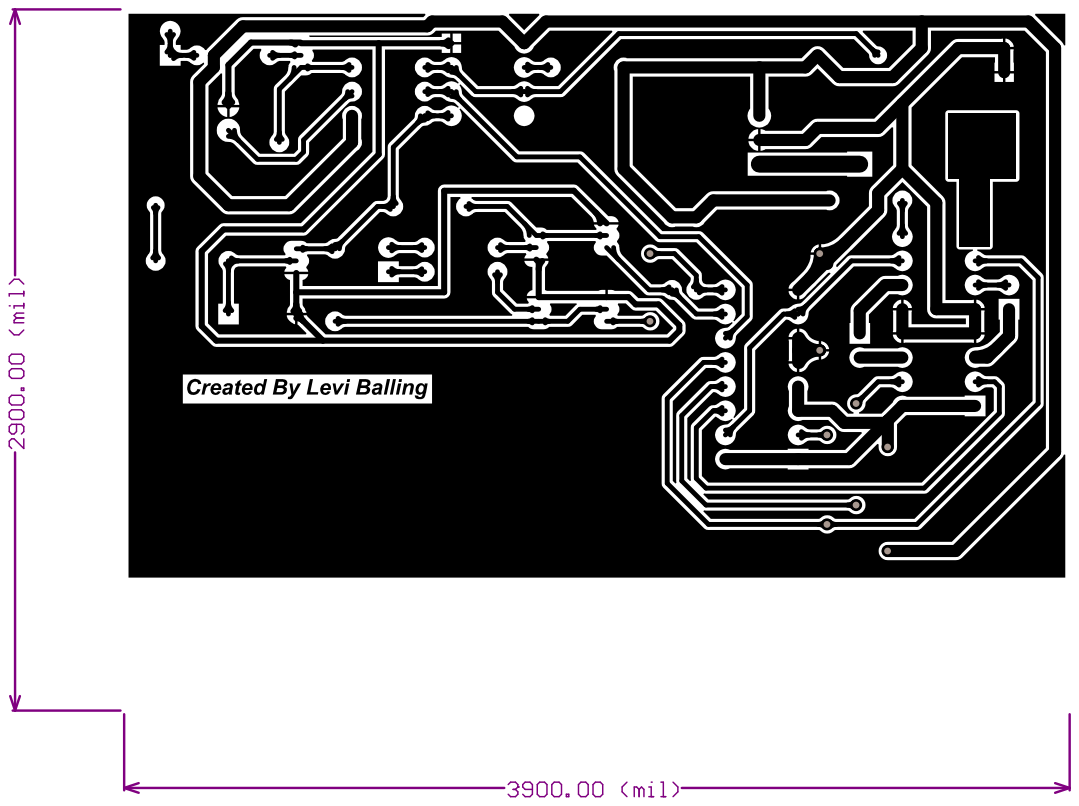
[picture p174: page 3]

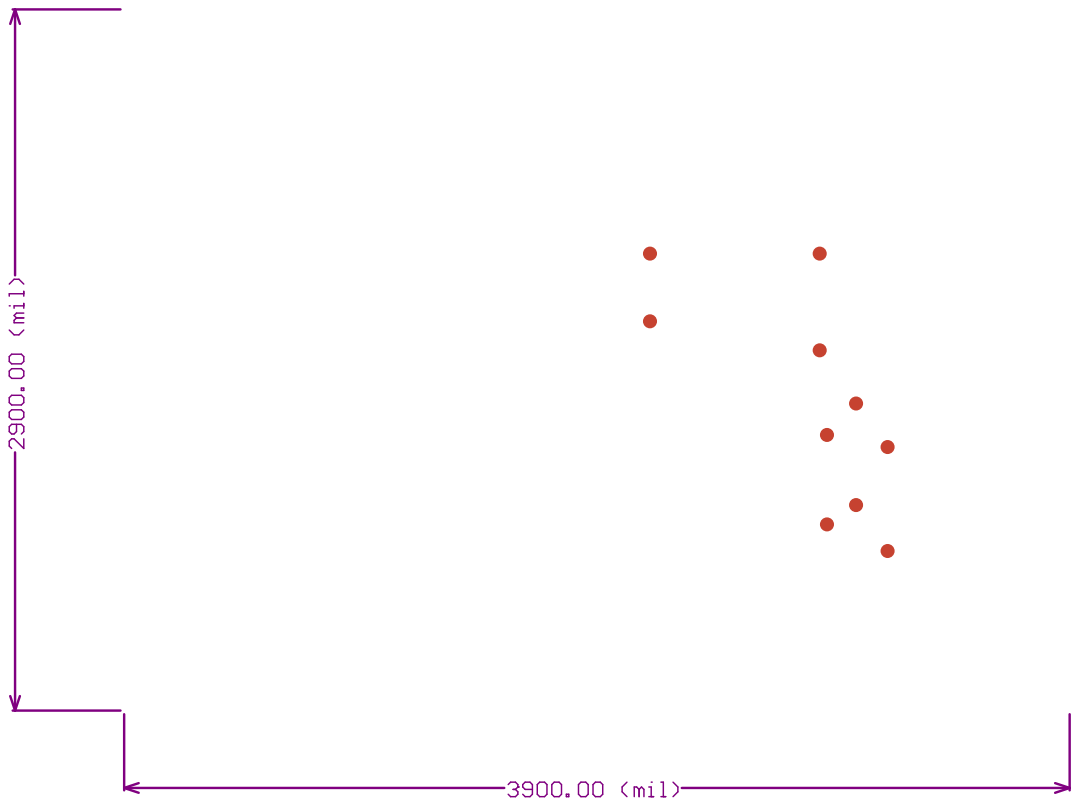
[picture p175: page 6]

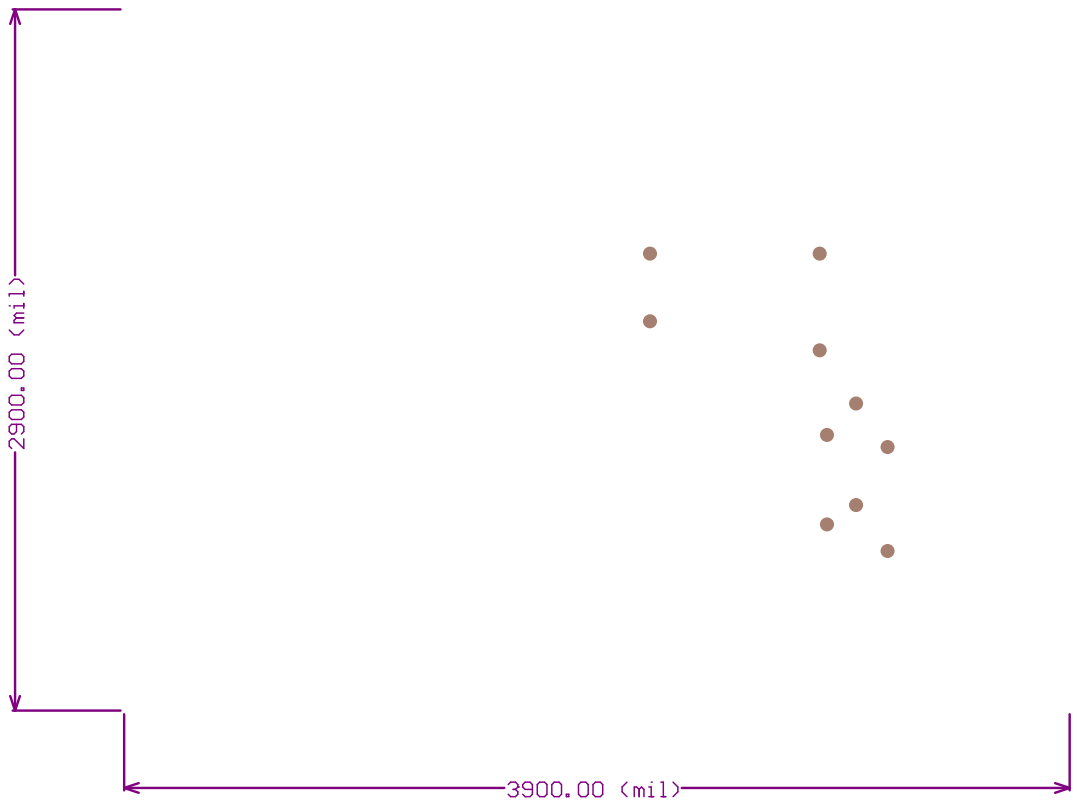
[picture p176: page 7]

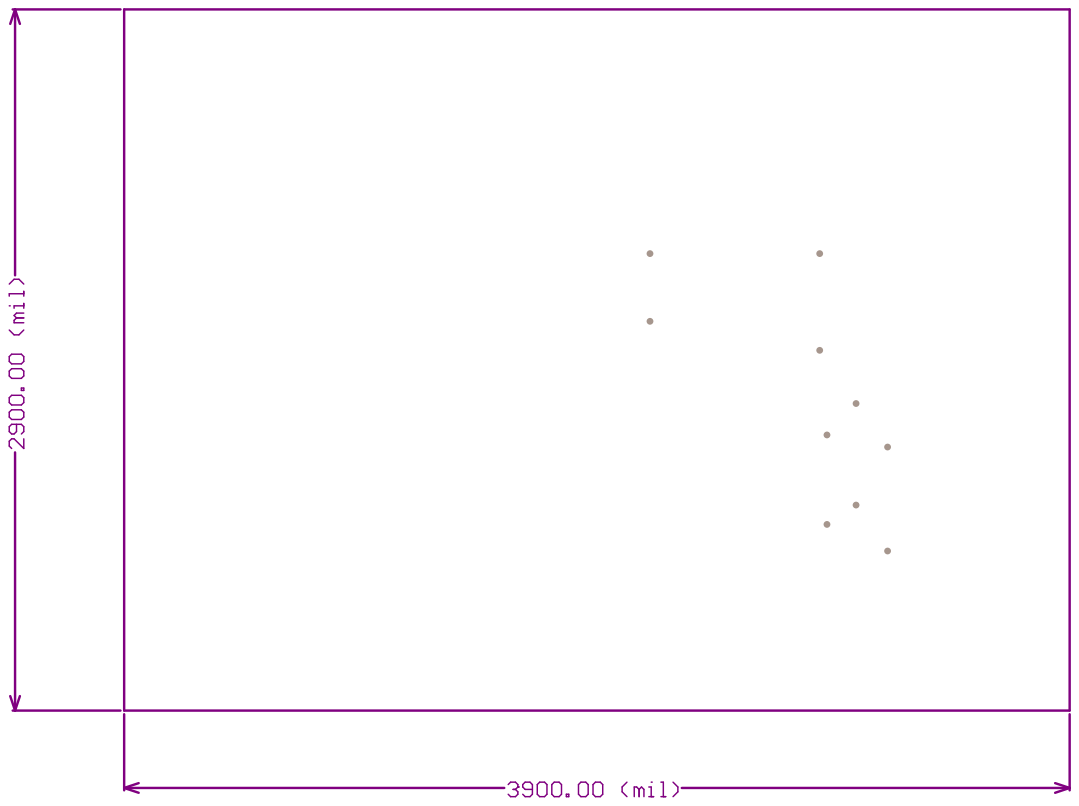
[picture p177: page 13]

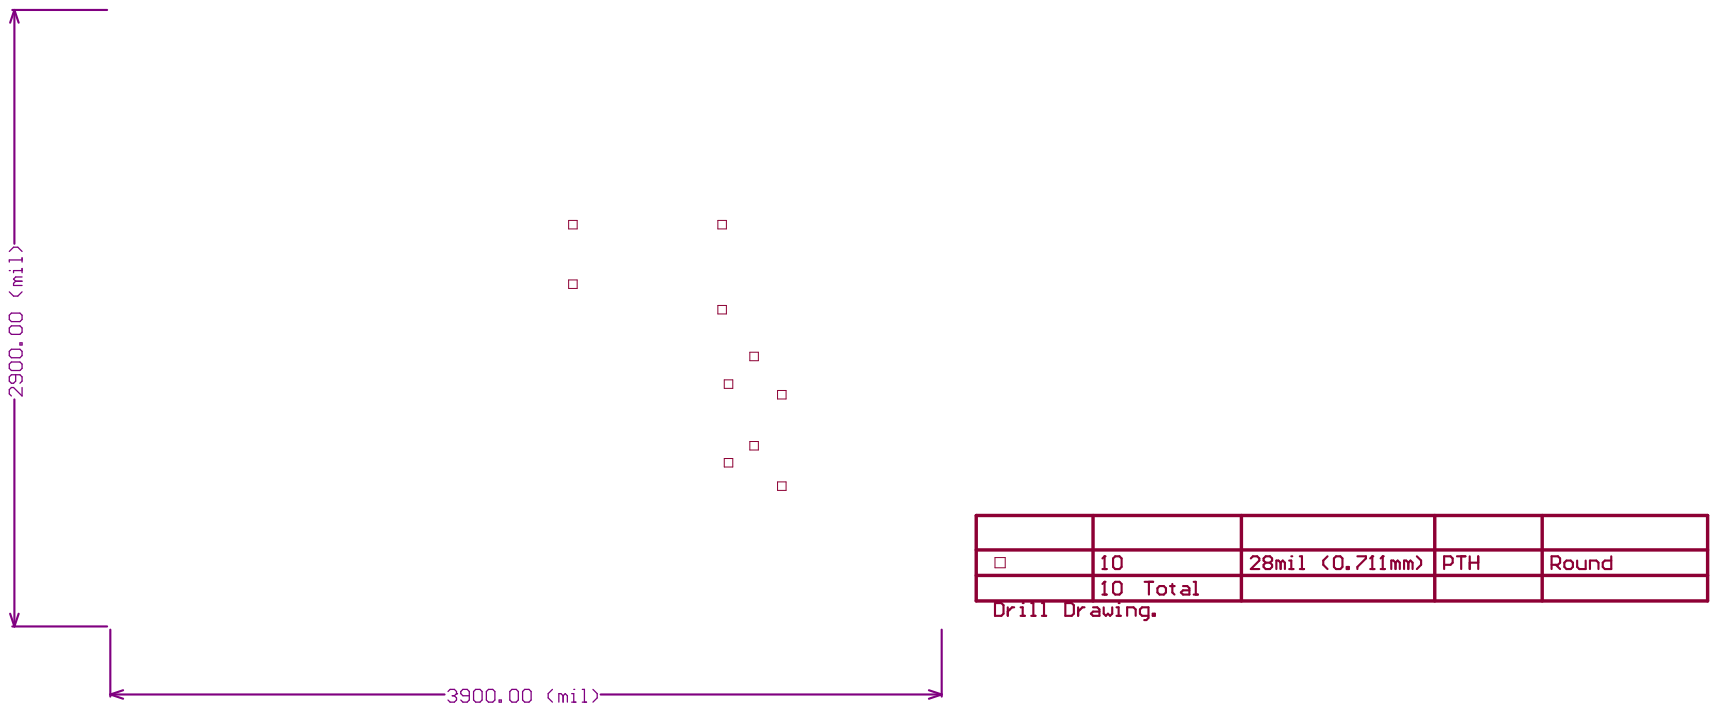
[picture p178: page 14]

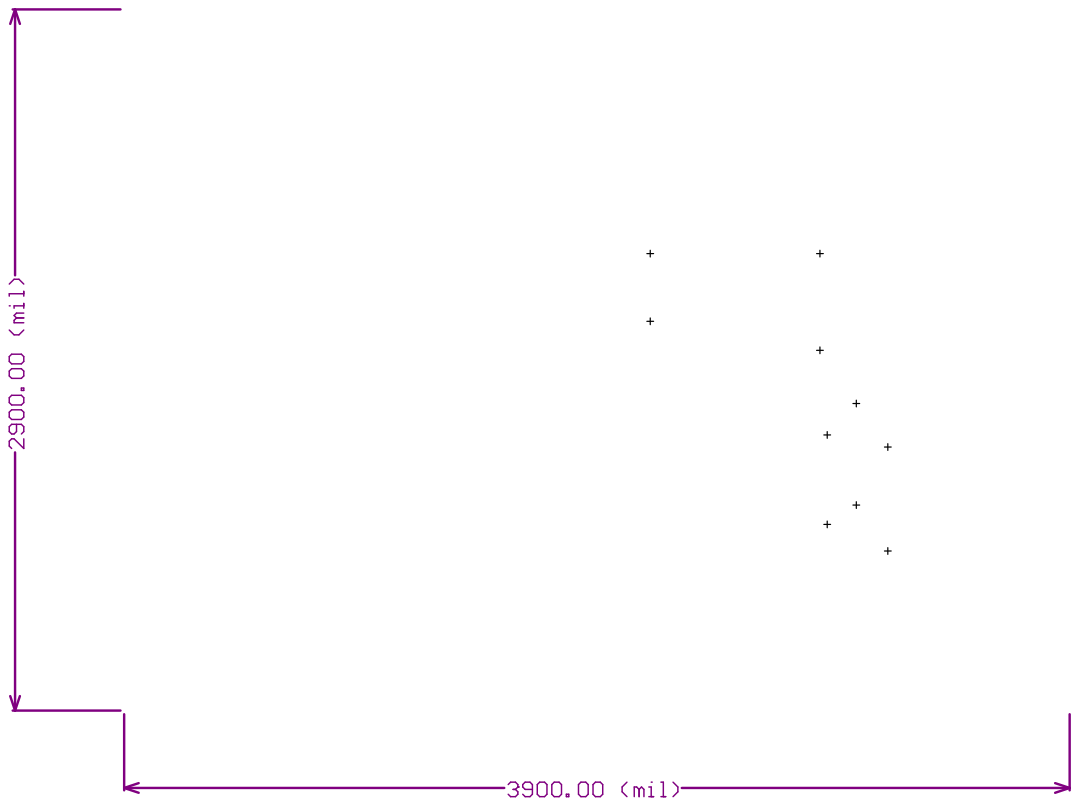
[picture p179: page 15]
