AshitakaLax/SmartHome/EpicCube/hardware/Epic Cube Design/OldControllerBoxInfo/MotorControllerProject.pdf

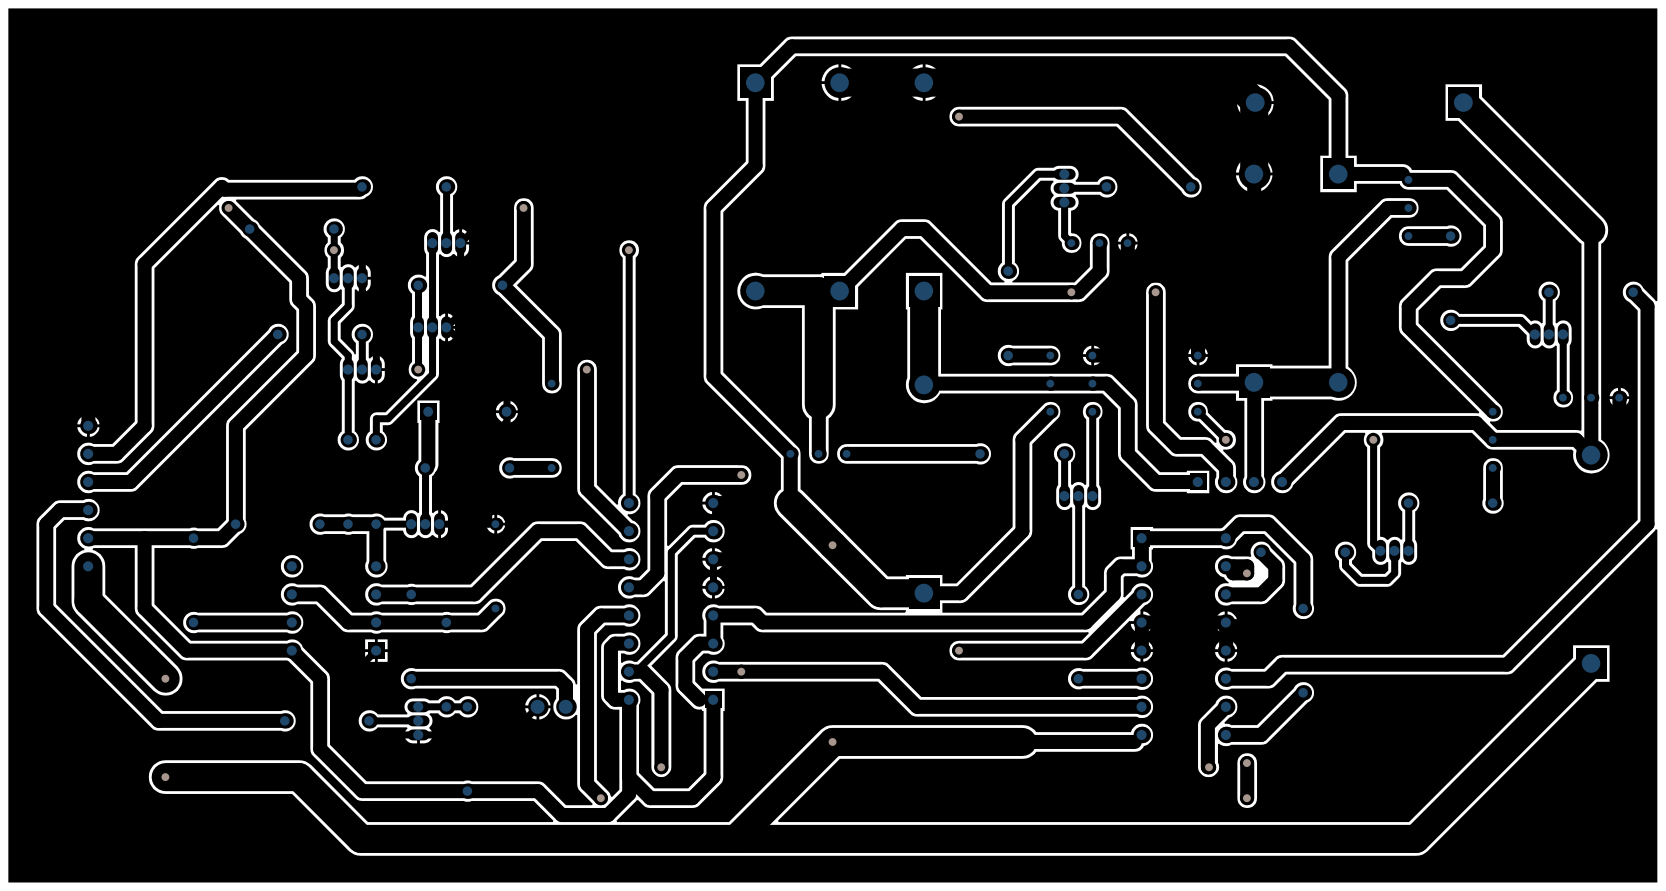
[picture p180: page 1]
