AshitakaLax/SmartHome/EpicCube/hardware/Epic Cube Design/OldControllerBoxInfo/Senior_PCB.pdf

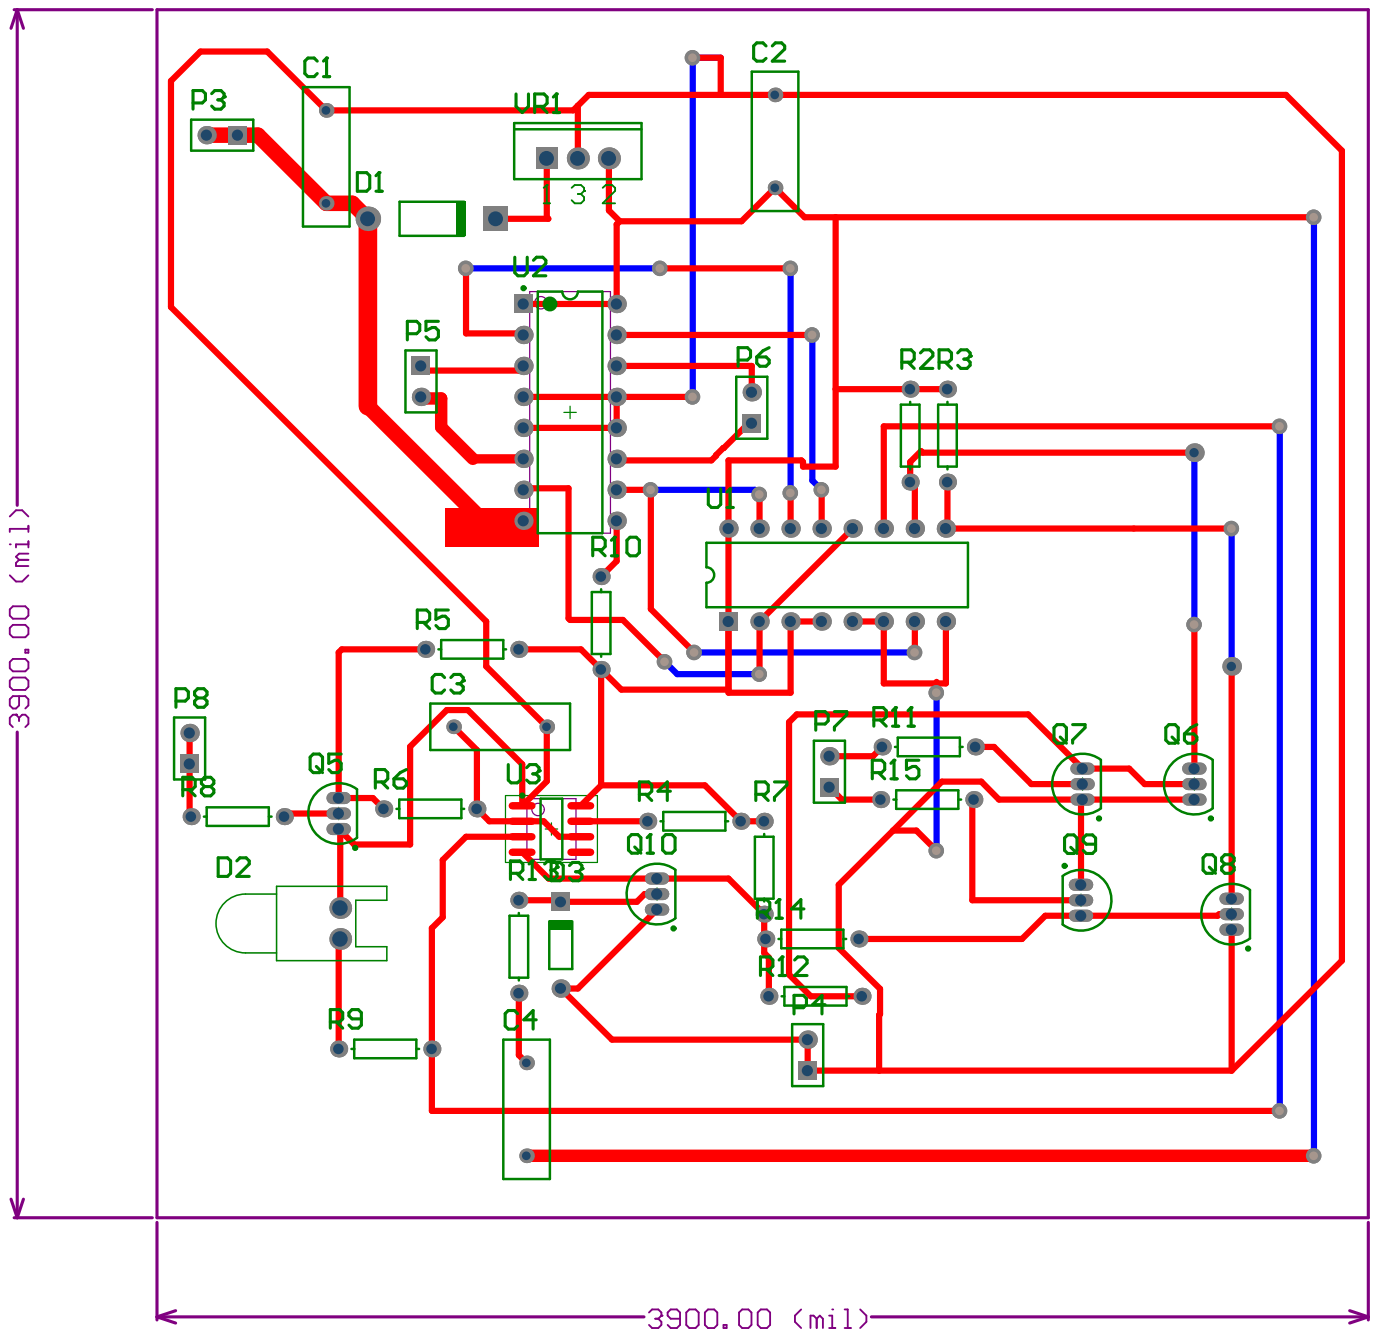
[picture p181: page 1]
