AshitakaLax/SmartHome/EpicCube/hardware/Epic Cube Design/OldControllerBoxInfo/TemperatureSensorBlockPCB1.pdf

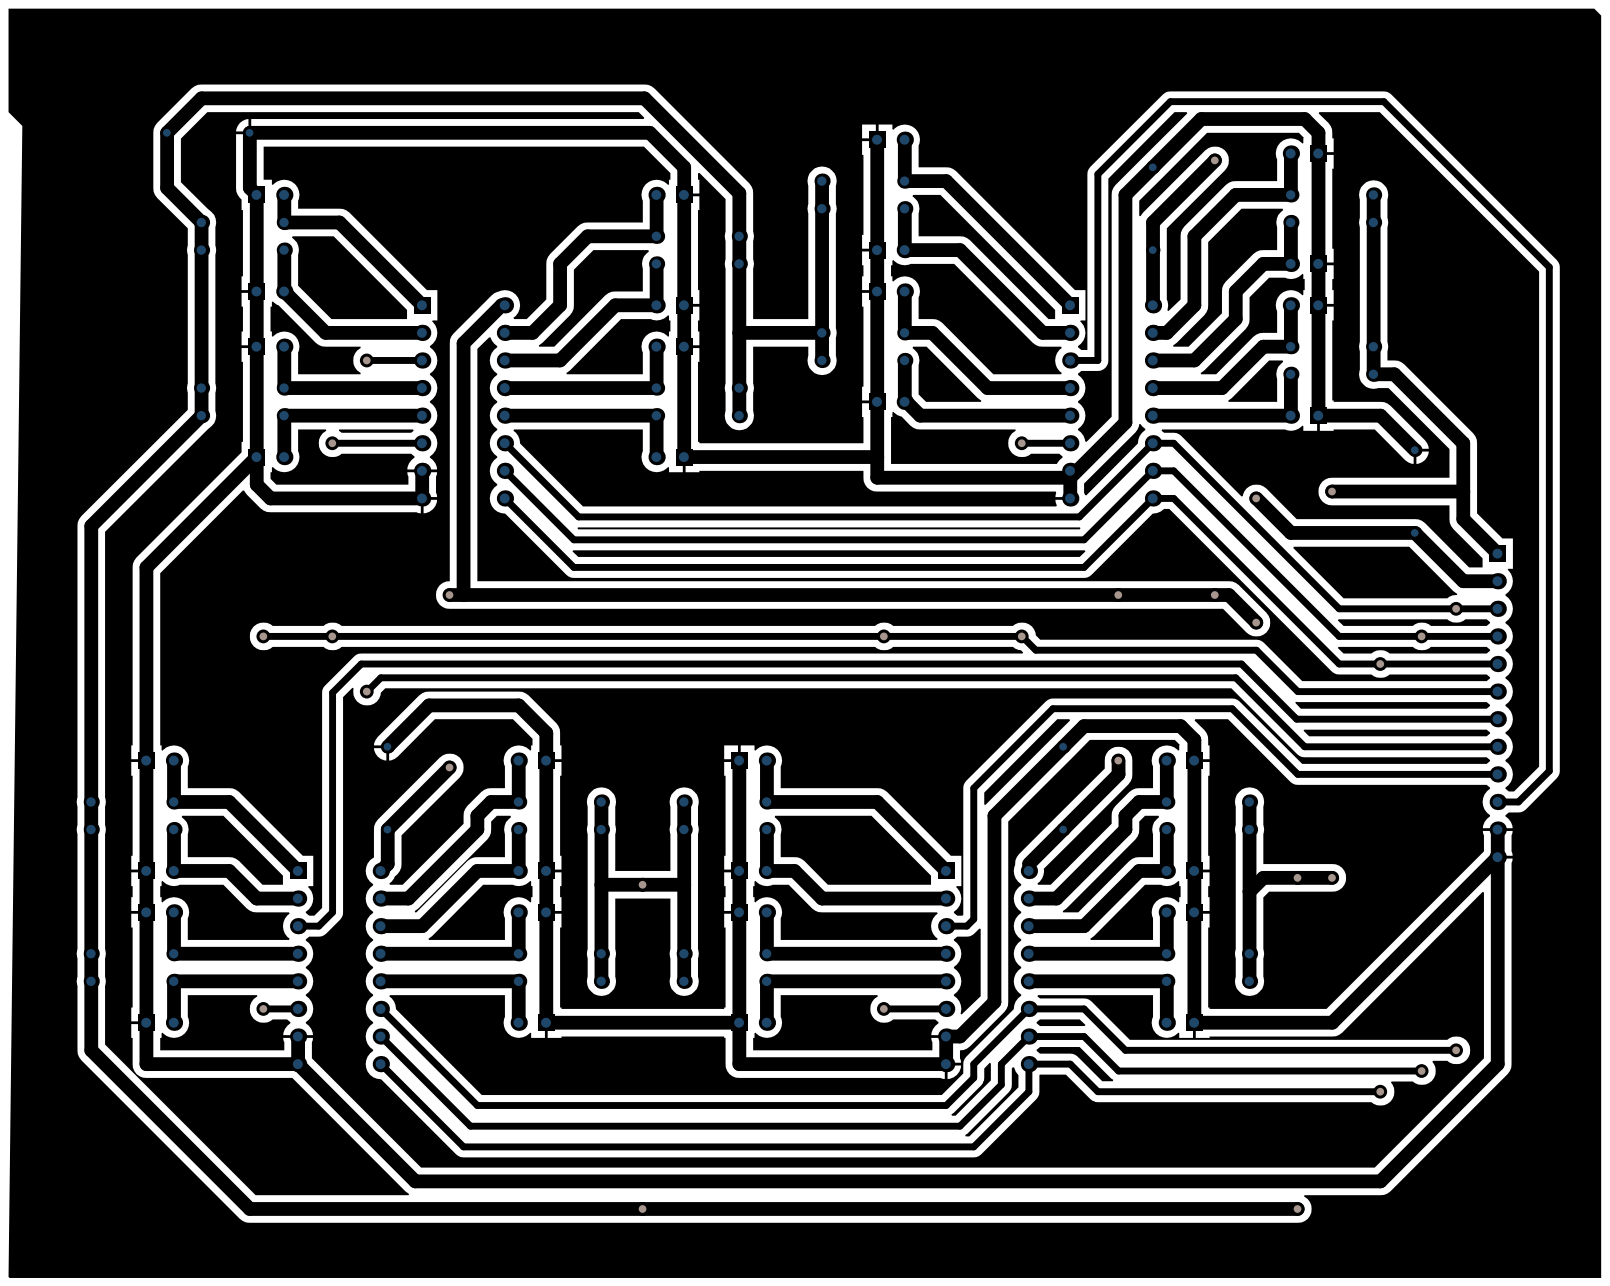
[picture p182: page 1]
