AshitakaLax/SmartHome/EpicCube/hardware/Epic Cube Design/OldControllerBoxInfo/TemperatureSensorBlockPCB1Holes&Parts.pdf

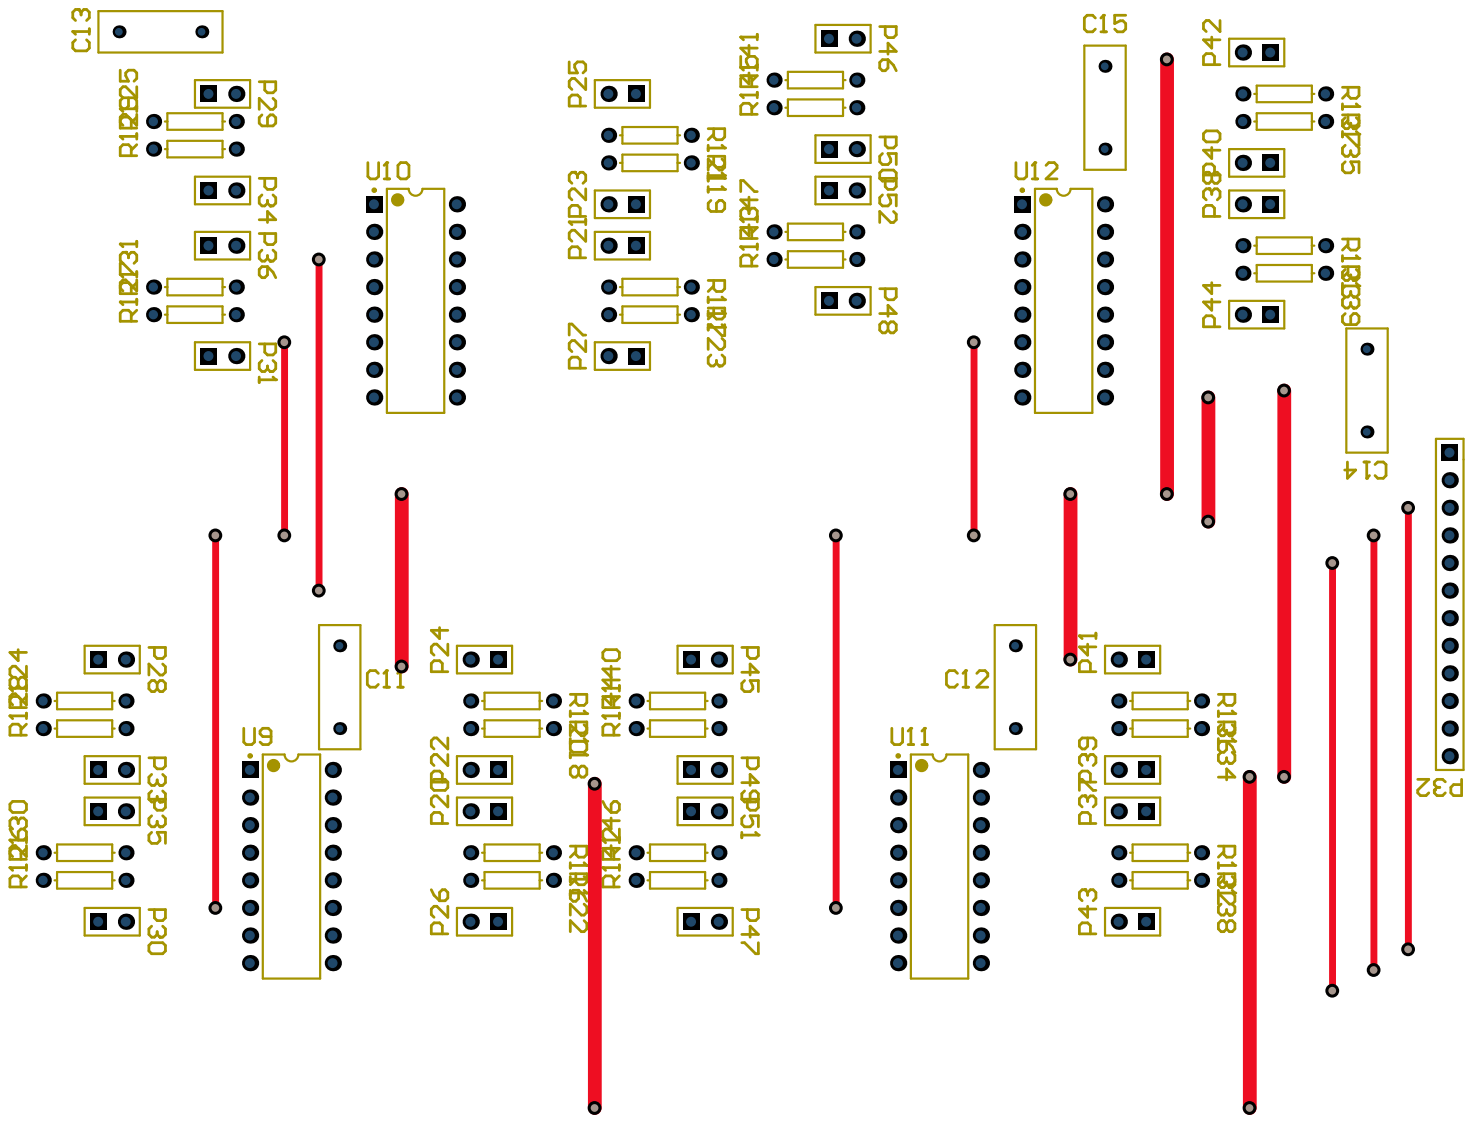
[picture p183: page 1]

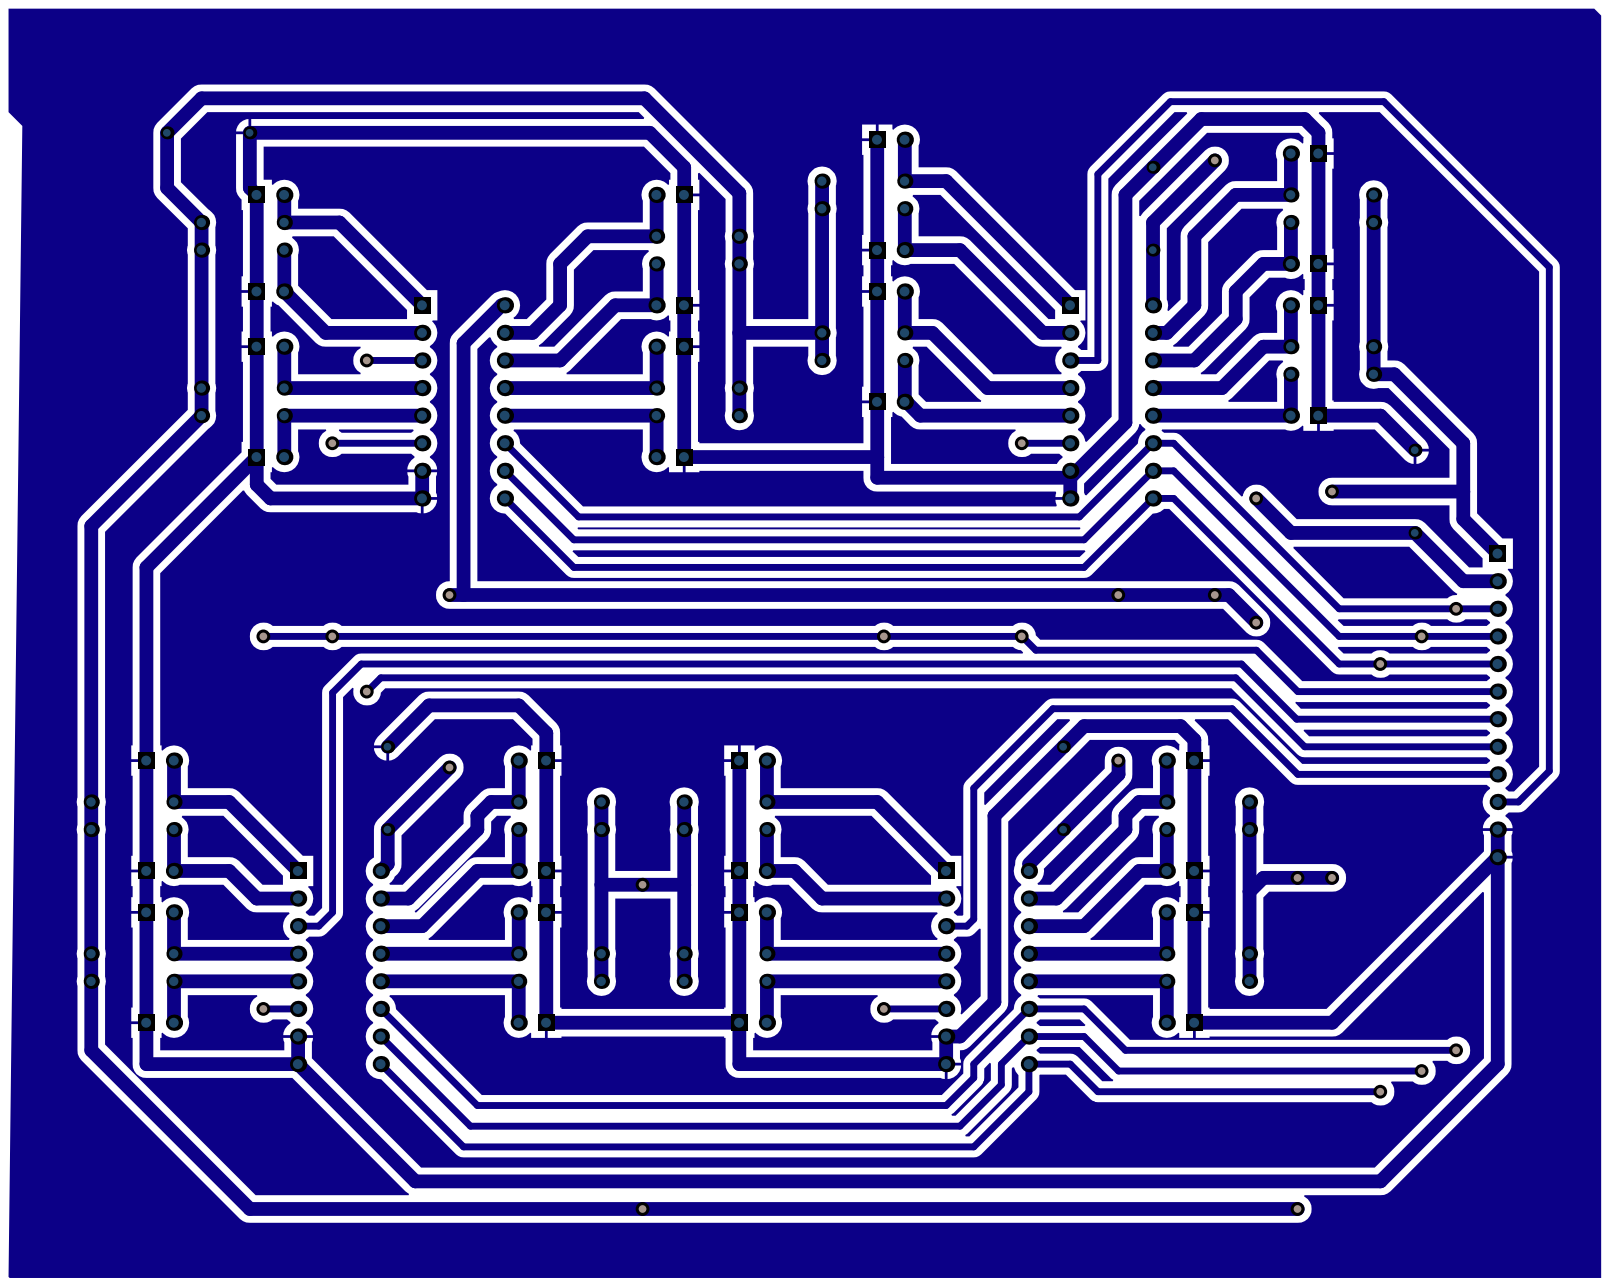
[picture p184: page 2]
