AshitakaLax/SmartHome/(list of files, drawings)

Other design files:
EpicCube/hardware/Epic Cube Design/OldControllerBoxInfo/ComputerServer.SchDoc
EpicCube/hardware/Epic Cube Design/OldControllerBoxInfo/DamperDividerBoard.PrjPCB
EpicCube/hardware/Epic Cube Design/OldControllerBoxInfo/DamperDividerBoard.SchDoc
EpicCube/hardware/Epic Cube Design/OldControllerBoxInfo/DamperSection.SchDoc
EpicCube/hardware/Epic Cube Design/OldControllerBoxInfo/DamperSectionPCB.PcbDoc
EpicCube/hardware/Epic Cube Design/OldControllerBoxInfo/DamperSectionProject.PrjPCB
EpicCube/hardware/Epic Cube Design/OldControllerBoxInfo/EpicCubeDiagram2.SchDoc
EpicCube/hardware/Epic Cube Design/OldControllerBoxInfo/EpicCubeDiagram.PrjPCB
EpicCube/hardware/Epic Cube Design/OldControllerBoxInfo/EpicCubeDiagram.SchDoc
EpicCube/hardware/Epic Cube Design/OldControllerBoxInfo/FanController.SchDoc
EpicCube/hardware/Epic Cube Design/OldControllerBoxInfo/HeatingAC_Garage.PcbDoc
EpicCube/hardware/Epic Cube Design/OldControllerBoxInfo/HeatingAC_Garage.SchDoc
EpicCube/hardware/Epic Cube Design/OldControllerBoxInfo/HeatingAC_GarageProject.PrjPCB
EpicCube/hardware/Epic Cube Design/OldControllerBoxInfo/HighPowerMotorController.PcbDoc
EpicCube/hardware/Epic Cube Design/OldControllerBoxInfo/InverterBoard.SchDoc
EpicCube/hardware/Epic Cube Design/OldControllerBoxInfo/MainController.SchDoc
EpicCube/hardware/Epic Cube Design/OldControllerBoxInfo/MainControllerProject.PrjPCB
EpicCube/hardware/Epic Cube Design/OldControllerBoxInfo/MotorController2.PcbDoc
EpicCube/hardware/Epic Cube Design/OldControllerBoxInfo/MotorController3.PcbDoc
EpicCube/hardware/Epic Cube Design/OldControllerBoxInfo/MotorController.SchDoc
EpicCube/hardware/Epic Cube Design/OldControllerBoxInfo/MotorControllerBox.SCHLIB
EpicCube/hardware/Epic Cube Design/OldControllerBoxInfo/MotorControllerProject.PrjPCB
EpicCube/hardware/Epic Cube Design/OldControllerBoxInfo/overallViewSchDoc.SchDoc
EpicCube/hardware/Epic Cube Design/OldControllerBoxInfo/PeopleCounter.SchDoc
EpicCube/hardware/Epic Cube Design/OldControllerBoxInfo/Senior_PCB.PrjPCB
EpicCube/hardware/Epic Cube Design/OldControllerBoxInfo/SeniorProjectLibrary.PcbLib
EpicCube/hardware/Epic Cube Design/OldControllerBoxInfo/SeniorProjectLibrary.SchLib
EpicCube/hardware/Epic Cube Design/OldControllerBoxInfo/SeniorProjectSchematic.SchDoc
EpicCube/hardware/Epic Cube Design/OldControllerBoxInfo/Sheet1.SchDoc
EpicCube/hardware/Epic Cube Design/OldControllerBoxInfo/SprinklerBoard.PrjPCB
EpicCube/hardware/Epic Cube Design/OldControllerBoxInfo/SprinklerBoard.SchDoc
EpicCube/hardware/Epic Cube Design/OldControllerBoxInfo/TemperatureSensorBlock.SchDoc
EpicCube/hardware/Epic Cube Design/OldControllerBoxInfo/TemperatureSensorBlockPCB1.PcbDoc
EpicCube/hardware/Epic Cube Design/OldControllerBoxInfo/TempSense.SchDoc
EpicCube/hardware/Epic Cube Design/Workspace/PCBs/Adapter.PcbDoc
EpicCube/hardware/Epic Cube Design/Workspace/PCBs/Black Board.PcbDoc
EpicCube/hardware/Epic Cube Design/Workspace/PCBs/DamperSectionPCB.PcbDoc
EpicCube/hardware/Epic Cube Design/Workspace/PCBs/HeatingAC_Garage.PcbDoc
EpicCube/hardware/Epic Cube Design/Workspace/PCBs/HighPowerBiPolarStepperMotorDriver.PcbDoc
EpicCube/hardware/Epic Cube Design/Workspace/PCBs/HighPowerMotorController.PcbDoc
EpicCube/hardware/Epic Cube Design/Workspace/PCBs/MainControllerPCB.PcbDoc
EpicCube/hardware/Epic Cube Design/Workspace/PCBs/MicMixerPCB.PcbDoc
EpicCube/hardware/Epic Cube Design/Workspace/PCBs/PowerBoard.PcbDoc
EpicCube/hardware/Epic Cube Design/Workspace/PCBs/SpeakerMixerBoard.PcbDoc
EpicCube/hardware/Epic Cube Design/Workspace/PCBs/SprinklerBoard.PcbDoc
EpicCube/hardware/Epic Cube Design/Workspace/PCBs/TemperatureSensorBlockPCB.PcbDoc
EpicCube/hardware/Epic Cube Design/Workspace/PCBs/WirelessCommunications.PcbDoc
EpicCube/hardware/Epic Cube Design/Workspace/Projects/DamperSectionProject.PrjPCB
EpicCube/hardware/Epic Cube Design/Workspace/Projects/EpicCubeDiagram.PrjPCB
EpicCube/hardware/Epic Cube Design/Workspace/Projects/HeatingAC_GarageProject.PrjPCB
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
