AshitakaLax/SmartHome/EpicCube/software/epicCubeSoftware/arduino/PWM/PWM.ino

/* RGB Analog Example, Teensyduino Tutorial #2
 http://www.pjrc.com/teensy/tutorial2.html
 
 This example code is in the public domain.
 for my example we are going to be using just
 pins 27 0 1 14, 15, 16, 26, 25, 24
 
 */

const int redPin =  27;
const int greenPin =  0;
const int bluePin =  1;

void setup()   {                
  pinMode(redPin, OUTPUT);
  pinMode(greenPin, OUTPUT);
  pinMode(bluePin, OUTPUT);
}

void loop()                     
{
  analogWrite(redPin, 30);
  delay(500);
  analogWrite(greenPin, 200);
  delay(500);
  analogWrite(bluePin, 40);
  delay(500);
  analogWrite(redPin, 150);
  delay(500);
  analogWrite(greenPin, 0);
  delay(500);
  analogWrite(bluePin, 250);
  delay(500);
}
