AshitakaLax/SmartHome/ArduinoCodeWifiServer/WebServer/WebServer.ino

/*
 * Web Server
 *
 * A simple web server example using the WiShield 1.0
 */

#include <WiShield.h>

#define WIRELESS_MODE_INFRA	1
#define WIRELESS_MODE_ADHOC	2

// Wireless configuration parameters ----------------------------------------
unsigned char local_ip[] = {192,168,1,10};	// IP address of WiShield
unsigned char gateway_ip[] = {192,168,1,1};	// router or gateway IP address
unsigned char subnet_mask[] = {255,255,255,0};	// subnet mask for the local network
const prog_char ssid[] PROGMEM = {"Kiza"};		// max 32 bytes

unsigned char security_type = 2;	// 0 - open; 1 - WEP; 2 - WPA; 3 - WPA2

// WPA/WPA2 passphrase
const prog_char security_passphrase[] PROGMEM = {"1234567890"};	// max 64 characters

// WEP 128-bit keys
// sample HEX keys
prog_uchar wep_keys[] PROGMEM = {	0x01, 0x02, 0x03, 0x04, 0x05, 0x06, 0x07, 0x08, 0x09, 0x0a, 0x0b, 0x0c, 0x0d,	// Key 0
									0x00, 0x00, 0x00, 0x00, 0x00, 0x00, 0x00, 0x00, 0x00, 0x00, 0x00, 0x00,	0x00,	// Key 1
									0x00, 0x00, 0x00, 0x00, 0x00, 0x00, 0x00, 0x00, 0x00, 0x00, 0x00, 0x00,	0x00,	// Key 2
									0x00, 0x00, 0x00, 0x00, 0x00, 0x00, 0x00, 0x00, 0x00, 0x00, 0x00, 0x00,	0x00	// Key 3
								};

// setup the wireless mode
// infrastructure - connect to AP
// adhoc - connect to another WiFi device
unsigned char wireless_mode = WIRELESS_MODE_INFRA;

unsigned char ssid_len;
unsigned char security_passphrase_len;
//---------------------------------------------------------------------------
int led = 13;
int led1= 4;
int led2 = 8;
int led3 = 3;
int led4 = 1;
void setup()
{
	WiFi.init();
        pinMode(led,OUTPUT);
}

// This is the webpage that is served up by the webserver
const prog_char webpage[] PROGMEM = {"HTTP/1.1 200 OK\r\nContent-Type: text/html\r\n\r\n<center><h1>Hello World!! I am WiShield</h1><form method=\"get\" action=\"0\">Toggle LED:<input type=\"submit\" name=\"0\" value=\"LED1\"></input></form></center>"};

void loop()
{
	WiFi.run();
  digitalWrite(led, HIGH);   // turn the LED on (HIGH is the voltage level)
  delay(500);
  digitalWrite(led,LOW);
  digitalWrite(led3,HIGH);
  delay(500);               // wait for a second
  digitalWrite(led1, LOW);    // turn the LED off by making the voltage LOW
  digitalWrite(led2, HIGH);
  delay(100); 
  digitalWrite(led2,LOW);
  digitalWrite(led3, HIGH);
  delay(100);
  digitalWrite(led3, LOW);
  delay(1000);
}
