AshitakaLax/SmartHome/(commit log)

2012-09-25 added Light Sensor Program folder stuff
    On branch master
    Changes to be committed:
    new file: Light Sensor Program/.dep/analog.o.d
    new file: Light Sensor Program/.dep/lightsensordriver.o.d
    new file: Light Sensor Program/.dep/print.o.d
    new file: Light Sensor Program/.dep/usb_debug_only.o.d
    new file: Light Sensor Program/Light Sensor Program.tmproj
    new file: Light Sensor Program/Makefile
    new file: Light Sensor Program/analog.c
    new file: Light Sensor Program/analog.h
    new file: Light Sensor Program/analog.lst
    new file: Light Sensor Program/analog.o
    new file: Light Sensor Program/hidlisten
    new file: Light Sensor Program/lightsensordriver.c
    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
2012-10-05 Here is my portion of the project.
    [Black Board.PcbDoc, ComputerServer.SchDoc, DamperDividerBoard.PrjPCB, DamperDividerBoard.SchDoc, DamperSection.SchDoc, DamperSectionPCB.PcbDoc, DamperSectionProject.PrjPCB, EpicCubeDiagram.PrjPCB]
2012-10-15 compiles for current run test.
2012-10-18 stub code for working with mutable objects
    new file: smarthome/device.py
    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
2012-10-19 made dozens of changes to design
    [Adapter.PcbDoc, Adapter.SchDoc, DamperSection.SchDoc, HeatingAC_Garage.SchDoc, MicMixer.SchDoc, MotorController.SchDoc, RelayAdapterBoard.PrjPCB]
2012-10-19 adding three files to test the server's sockets
    new file: serversockets.py
    new file: socketclient.py
    new file: sockethost.py
    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
2012-10-19 changed address to connect to from 127.0.0.1 to 155.98.69.177 (our server's address)
    modified: socketclient.py
    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
2012-10-23 tweaked to give better error messages as well as be cosmetically more optimal
    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
2012-10-24 tweak to socketclient.py
    modified: src/socket_test/socketclient.py
    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
2012-10-29 lots of major changes on device.py; it will be renamed to core.py in next commit; also .gitignore added to ignore .pyc and .pyo files
    new file: ../../.gitignore
    modified: device.py
    new file: test.py
    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
2012-10-29 Renamed device.py to core.py
    Your branch is ahead of 'origin/master' by 1 commit.
    renamed: device.py -> core.py
    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
2012-10-30 Added a lot of pcb stuff
    [HighPowerBiPolarStepperMotorDriver.PcbDoc, HighPowerBiPolarStepperMotorSchem.SchDoc, HighPowerBiPolarStepperProject.PrjPCB, MicMixer.SchDoc, MicMixerPCB.PcbDoc, WirelessCommunications.SchDoc]
2012-10-30 Commited the Arduino code
2012-10-31 Changed Temperature
2012-11-05 Added functionallity for the fourth outlet and also added funcitonallity for the current information to be stored back on webpage
2012-11-05 lots of changes. restructuring the core for easier access while working on adding events support
    new file: src/mirabilis/__main__.py
    modified: src/mirabilis/core.py
    new file: src/mirabilis/powerstrip.py
    new file: src/mirabilis/smarthomecore/__init__.py
    new file: src/mirabilis/smarthomecore/_area.py
    new file: src/mirabilis/smarthomecore/_container.py
    new file: src/mirabilis/smarthomecore/_events.py
    new file: src/mirabilis/smarthomecore/_interfaces.py
    new file: src/mirabilis/smarthomecore/_physicaldevice.py
    new file: src/mirabilis/smarthomecore/_smarthomeitem.py
    new file: src/mirabilis/smarthomecore/_state_entity.py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
2012-11-06 Updated BOM
2012-11-06 fixing up powerstrip.py and rename smarthomecore to core
    renamed: smarthomecore/__init__.py -> core/__init__.py
    renamed: smarthomecore/area.py -> core/area.py
    renamed: smarthomecore/container.py -> core/container.py
    renamed: smarthomecore/events.py -> core/events.py
    renamed: smarthomecore/interfaces.py -> core/interfaces.py
    renamed: smarthomecore/physicaldevice.py -> core/physicaldevice.py
    renamed: smarthomecore/smarthomeitem.py -> core/smarthomeitem.py
    renamed: smarthomecore/state_entity.py -> core/state_entity.py
    renamed: smarthomecore/universe.py -> core/universe.py
    modified: powerstrip.py
    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
2012-11-06 renamed powerstrip.py to pstripandsensors.py
    renamed: powerstrip.py -> pstripandsensors.py
    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
2012-11-06 added some damper control to work correctly.
    [damper_Control.c, damper_Control.h]
2012-11-08 Added support for sprinkler system
    [PartsOrder.xlsx]
2012-11-08 Fixed current information
2012-11-09 Added christophers side of the current progress and also added the Arduino code under WifiLTCSMTControl.ino to support chirstophers motion sensor and laser trip wire.
2012-11-10 I have added a ton of code for PWM signal generation.
    it is really cool. and it is a nice library.
2012-11-12 Added some of the PDF files for the current meeting schedule milestone.
2012-11-13 added schematic
    [powerstrip.sch]
2012-11-14 I've add a lot of Fan control software. I also have added a PWM signal library,
2012-11-14 added the current progress to of the final paper to the website
2012-11-14 added schem
    [powerstrip.sch]
2012-11-14 latest powerstrip code
2012-11-16 powerstrip folder!!
2012-11-17 adding back deleted stuff
    [PartsOrder.xlsx]
2012-11-17 added a lot of files, i didn't even know were required.
    [GlobalVar.h, HVACGarage.c, HVACGarage.h, PWMTeensyTwoPlusPlus.h, Sprinkler.c, Sprinkler.h, damper_Control.c, damper_Control.h]
2012-11-17 I fixed my code to what it was, and added a better help feature if you are having issues with running from the serial interface.
    [HVACGarage.c, PWM.ino, PWMTeensyTwoPlusPlus.c, PWMTeensyTwoPlusPlus.h, mainControl.c]
2012-11-24 I've updated a lot of the motor controls of the system. I still need to use a DMM and calibrate the stepper motor to not fry my motor or chip.
2012-11-26 cleaning up and simplifying device creation
    On branch container_in_item_constructor
    modified: core/_areagroup.py
    modified: core/_physicaldevice.py
    modified: core/_smarthomeitem.py
    modified: core/_state_entity.py
    modified: create.py
    modified: epic_cube.py
    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
2012-11-28 creating runtime structure including sockets
    new file: ../mirabilis/core/_lock.py
    modified: ../mirabilis/core/_physicaldevice.py
    new file: ../mirabilis/core/_run.py
    modified: ../mirabilis/core/_state_entity.py
    modified: ../mirabilis/core/_universe.py
    modified: ../mirabilis/epic_cube.py
    modified: serversockets.py
    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
2012-11-28 got pickle transmission to work
    modified: mirabilis/__main__.py
    modified: mirabilis/core/__init__.py
    modified: mirabilis/core/_container.py
    modified: mirabilis/core/_physicaldevice.py
    modified: mirabilis/core/_run.py
    modified: mirabilis/core/_smarthomeitem.py
    modified: mirabilis/core/_state_entity.py
    modified: mirabilis/core/_universe.py
    modified: mirabilis/epic_cube.py
    modified: socket_test/socketclient.py
    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
2012-11-29 Added the improved Arduino code
2012-11-29 got threads working
    modified: mirabilis/core/_lock.py
    new file: mirabilis/core/_print.py
    modified: mirabilis/pstripandsensors.py
    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
2012-11-29 I added some verbose features and changes.
    made teensy more compatiable with serial communication
    only have changed main and damper still have the rest to go,
    compiles well.
2012-12-01 Added the fixed errors on the Arduino code
    [FinishedCode.ino]
2012-12-01 renamed ligt sensor and such to "Prezense"
    renamed: ../mirabilis/pyserial-2.5.win32.exe -> ../dist/pyserial-2.5.win32.exe
    renamed: ../mirabilis/pyserial-2.6.tar.gz -> ../dist/pyserial-2.6.tar.gz
    renamed: ../Light Sensor Program/.dep/analog.o.d -> .dep/analog.o.d
    renamed: ../Light Sensor Program/.dep/lightsensordriver.o.d -> .dep/lightsensordriver.o.d
    renamed: ../Light Sensor Program/.dep/print.o.d -> .dep/print.o.d
    renamed: ../Light Sensor Program/.dep/usb_debug_only.o.d -> .dep/usb_debug_only.o.d
    renamed: ../Light Sensor Program/Light Sensor Program.tmproj -> Light Sensor Program.tmproj
    renamed: ../Light Sensor Program/Makefile -> Makefile
    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
2012-12-02 Added the fixed arduino code with the software serial working
    [FinishedCodeFixSerial.ino]
2012-12-02 added support for turning lights on and off from teensy
    new file: ../dist/pyserial-2.6/build/lib/serial/__init__.py
    new file: ../dist/pyserial-2.6/build/lib/serial/rfc2217.py
    new file: ../dist/pyserial-2.6/build/lib/serial/serialcli.py
    new file: ../dist/pyserial-2.6/build/lib/serial/serialjava.py
    new file: ../dist/pyserial-2.6/build/lib/serial/serialposix.py
    new file: ../dist/pyserial-2.6/build/lib/serial/serialutil.py
    new file: ../dist/pyserial-2.6/build/lib/serial/serialwin32.py
    new file: ../dist/pyserial-2.6/build/lib/serial/sermsdos.py
    new file: ../dist/pyserial-2.6/build/lib/serial/tools/__init__.py
    new file: ../d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
2012-12-04 added the fixed stuff for the arduino with both relays working
    [ArduinoFinishedCode.ino, FinishedCodeFixSerialtest.ino]
2012-12-05 fixed prezense to keep updating status lights for motion sensor and lazer trip wire while in counting mode
    modified: analog.lst
    modified: prezense.c
    modified: prezense.elf
    modified: prezense.hex
    modified: prezense.lss
    modified: prezense.lst
    modified: prezense.map
    modified: prezense.o
    modified: prezense.sym
    modified: print.lst
    modified: usb_debug_only.lst
    modified: usb_debug_only.o
    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
    [prezense.c]
2012-12-07 Added the logo files for the website and also some arduino changed code
2012-12-07 last stuff except Dario's temperature
    new file: src/doserial
    modified: src/ladybug/website/mako_templates/fancy_base.mako
    modified: src/ladybug/website/mako_templates/fancy_base/one_column/view_all.mako
    modified: src/ladybug/website/mako_templates/fancy_base/two_columns.mako
    modified: src/ladybug/website/mako_templates/fancy_base/two_columns/response.mako
    modified: src/ladybug/website/mako_templates/fancy_base/two_columns/view.mako
    modified: src/ladybug/website/urls.py
    modified: src/mirabilis/epic_cube.py
    modified: src/mirabilis/pstripandsensors.py
    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
2012-12-07 added temperature to web page
    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
